SpicyTenderloin/believer/AI-context/open-items.md

# Open Items / TBDs

Information gaps still to confirm with the user. Resolved items (Telem_1 protocol/baud, GPS_1 protocol/port, GX12 role, PDB model, RC channel/switch map) have been moved into `docs/engineering/ICD.md`, `docs/operations/manual.md`, and `docs/operations/backups/Pixhawk Parameter Backup/parameter-change-log.md`.

- [ ] GPS: RTK correction source for the ZED-F9P (base station? NTRIP?) still undecided. `SENS_GPS_MASK`'s exact bit semantics were not separately verified against the PX4 documentation before NAV-05 was closed (both receivers achieving lock was accepted as sufficient) - worth a closer look if GPS blending behaviour ever looks off in practice
- [ ] I2C airspeed sensor (MS4525DO): pull-up resistor configuration not confirmed (port - Pixhawk 6X I2C, JST-GH 4-pin - and address 0x28 are confirmed in `docs/engineering/ICD.md` INT-07)
- [ ] `BAT_LOW_THR` on the physical FC: temporarily lowered to 12% for bench testing on 2026-08-19; Julian confirmed it should be reset to 20% but had not yet done so on the physical flight controller at the time of this update (the archived backup and docs already reflect the intended 20% value) - verify the live FC matches before the next flight
- [ ] `MAV_1_MODE` changed from 3 (OSD) to 0 (Normal) (2026-07-06); the `BATTERY_STATUS` 10Hz override in `/fs/microsd/etc/extras.txt` was tuned against OSD mode's 0.5Hz default and has not been re-verified under Normal mode
- [ ] CH12 (SH switch, mixed in the GX12 radio): reserved for a future buzzer or payload function, but which one - and its eventual `RC_MAP_*` parameter - is not yet decided
- [ ] Camera mounting subsystem (IMX335): companion computer model, exact belly mounting location, observation angle, and environmental operating range not yet defined - see `docs/engineering/requirements/underslung-camera-mount-requirements.md`
- [ ] Recurring airworthiness verification checks (propeller nuts, hatch/nacelle/bolt torque, antenna security) in `docs/engineering/build-checklist.md` have no dated inspection record - establish a way to log a dated verification pass (e.g. a per-flight log or a new `docs/engineering/test-reports/` entry) and backfill "Last verified" / "Evidence"
- [ ] Custom power distribution board (`docs/engineering/requirements/power-distribution-board-requirements.md`): firm max size/weight envelope, decoupling capacitor sizing (now that the ESC model is known - T-Motor AIR 40A - but detailed switching/ripple specs are not yet captured), current-sense range, ESC input connector type, and environmental operating range are all open - see that document's Section 5
- [ ] Launch dolly (`docs/engineering/requirements/launch-dolly-requirements.md`, wing-saddle concept): wing incidence relative to the fuselage datum (sets lift-off speed and tail-support height), final tail-support height and pad shape (estimated 142 mm above the rail top at the rear axle station), belly profile at the tail support, target AoA during the tail rise (sets lift-off speed: about 12.4 m/s at 5 deg, 16 m/s at 2 deg), rail spacing and front outrigger geometry to confirm in Fusion, propeller clearance to the trays and ramps (about 44 mm on the drawing's prop position, 75 mm wanted), separation-path clearance, and the exact bump/unevenness spec for the grass-runway requirement are open - see that document's Section 6
- [ ] Custom airframe (`docs/engineering/requirements/custom-airframe-requirements.md`): construction material/method, fabrication path, gimbal axis count, FPV mount angle, camera pod size/mass range, payload mass budget, and catapult launch system type/hard-point/load rating/release mechanism are all open - see that document's Section 5 (RF/EMI separation was researched 2026-08-20 and resolved to a qualitative "maximum practical separation" requirement, no numeric target exists in PX4/ArduPilot documentation)
- [ ] DBR4 antenna orthogonal mounting and RTV securing - relocation is complete, but the antennas are not yet mounted orthogonally or secured with silicone RTV; not a maiden-flight blocker - see `docs/engineering/build-checklist.md` RF-05
- [ ] Servo rail load test under oscilloscope, to confirm the new UBEC holds voltage under full control-surface load; not a maiden-flight blocker - see `docs/engineering/build-checklist.md` PWR-03
- [ ] Purchase history AUD conversion for the SparkFun ZED-F9P and Holybro PM06 invoices (`docs/governance/purchase-history/purchase-history.md`, 2026-03-09/10): both were paid in USD, but the exact daily/card-charged AUD amount could not be confirmed via web research (search tools returned only month-range data for March 2026, ~1.42-1.46 AUD/USD). Converted at an approximate 1.44 AUD/USD - Julian could confirm the precise figure from the actual card statement if needed for the funding report
- [ ] Whether to use the Weishäupl et al. 2024 wind-tunnel-measured drag polar (CD0/K/CL0/CLα) directly for Believer performance estimation, instead of or alongside the MotoCalc/generic-E374 approach - see `AI-context/project-notes.md` and `docs/engineering/build-checklist.md` PROP-05
- [ ] Full-Manual stick-to-surface scaling formal verification (CTL-08, reopened 2026-09-02): informal bench comparison suggested early saturation is Acro-specific and does not occur in Manual mode, but the formal logged test (propellers off, roll/pitch/yaw tested separately, stick%/PWM/deflection recorded at several points per axis) has not yet been run - Julian to perform
- [ ] Whether aileron differential or a non-zero `FW_RLL_TO_YAW_FF` (roll-to-yaw feedforward) is needed remains open, pending flight-test evidence of adverse yaw - see CTL-07 (deferred until CTL-06/CTL-08 complete; evidence to be gathered during CTL-02 test flights)
- [ ] Bench full-throttle testing intermittently triggers a false PX4 landing-detection auto-disarm (2 of 5 runs, 2026-09-02) - root-caused, not a power fault (see `docs/engineering/test-reports/2026-09-02-bench-thrust-test-review.md`). `COM_DISARM_LAND` reported set to -1 (auto-disarm on landing disabled) for bench testing on 2026-09-26, previously 2.0s - **confirmed -1 via a direct QGroundControl parameter export, 2026-10-02**. **Decision 2026-09-26 (Julian): keep -1 for the maiden flight.** The bench cutouts happened with the aircraft held still at high throttle, which resembles the pre-throw phase of the assisted hand launch, so leaving auto-disarm enabled may cut the motors in the handler's hands or on release. The pre-flight checklist now checks the value (`docs/operations/manual.md` step 23) and new landing steps require a manual disarm with CH5 (steps 51-53). Revisit after the maiden flight
- [ ] Custom Li-ion battery (6S4P, 24 NCR20700A cells, no BMS, fitted 2026-09-26; `docs/engineering/test-reports/2026-09-26-custom-li-ion-battery.md`): capacity test not completed (attempted 2026-09-26 but the run ended at 4.2 Ah discharged when the left motor failed; repeat after PROP-11 - the charger cannot exceed 4.15V per cell, so expect a result below the datasheet's 12.4 Ah rated); pack mass not recorded (the cells alone weigh up to 1.44 kg by datasheet; the aircraft all-up weight is recorded, 3.8 kg on 2026-09-26); numeric CG not recorded; cell purchase details (cost, funder, date) not in `docs/governance/purchase-history/purchase-history.md`; status of the Turnigy 8000mAh LiPo (spare or retired) not confirmed; cell authenticity not verified
- [ ] Custom Li-ion battery, cell group 2 measures 4.6 mOhm against 2.9 to 3.6 mOhm for the others (about 40% above their mean, roughly what one non-contributing cell in a 4-cell group would read) - check the weld or strip and re-measure at rest; log per-group voltages through the capacity test
- [ ] Custom Li-ion battery has no BMS, so nothing protects it from over-discharge and PX4 sees only total pack voltage: the in-flight voltage limit and how it is checked before flight are undecided. The cell datasheet's discharge end voltage is 2.5V per cell (15.0V on the pack); a conservative landing limit of about 3.3V per cell under load (about 19.8V) was suggested, not adopted
- [ ] PX4 battery estimation for the Li-ion pack: `BAT1_CAPACITY` is -1 (unset), `BAT1_V_CHARGED` 4.05V/cell is also PX4's recommended Li-ion value, `BAT1_V_EMPTY` 3.6V/cell is a LiPo-style default (PX4's Li-ion suggestions are 3.0V conservative no-load and 2.7V under load), and the low/critical/emergency thresholds are derived from that voltage-based estimate. A Li-ion pack discharges over a different voltage range, so the reported remaining charge may trigger earlier than the real charge warrants - likely conservative, but unverified. `BAT1_R_INTERNAL` (-1, real-time estimate) is a per-cell value in PX4; the charger-measured mean is about 3.5 mOhm per series group (PX4 documents about 5 mOhm per cell as typical). `COM_ARM_BAT_MIN` is also -1 (no arm-time minimum charge check) - deliberately deferred as part of PWR-04's closure (2026-10-02) until the capacity test completes
- [ ] **Proposed parameter changes (2026-09-26) - status from the parameters recorded in the 2026-09-26 flight logs; a parameter export is still to be provided.** Applied: `WEIGHT_BASE` and `WEIGHT_GROSS` = 3.8; `BAT1_V_EMPTY` = 3.2 (about 3.3 was proposed); `COM_DISARM_LAND` = -1. **Superseded, 2026-10-02:** `PWM_MAIN_MAX4`/`MAX6` and `WEIGHT_BASE`/`WEIGHT_GROSS` have since moved again following the U5 KV400 motor swap (PROP-11) - now 2000 and 4.0 respectively, confirmed via the 2026-10-02 ground-test log (`docs/engineering/test-reports/2026-10-02-u5-first-ground-test.md`, PROP-08) - so the "3.8"/"1800" figures below are historical, not current. **Applied, 2026-10-02 (PWR-04):** `COM_LOW_BAT_ACT` = 3, confirmed via a direct QGroundControl parameter export. **Not applied:** `BAT1_CAPACITY` still -1 (set it from the measured capacity once a capacity test completes, not from the datasheet, as cell authenticity is unverified). Leave unchanged: `BAT1_V_CHARGED` (4.05, which PX4's docs recommend for Li-ion - an earlier 4.10 proposal was withdrawn 2026-09-26), `BAT1_R_INTERNAL` (-1, PX4's adaptive real-time estimate - revisit only if logs from the new pack show the remaining-charge estimate dipping at throttle-up or failing to settle, in which case the charger-measured mean is about 0.0035 ohm per cell), the 20%/10%/5% thresholds, `FW_AIRSPD_STALL`/`MIN`/`TRIM`/`MAX` (their basis is the Weishaupl paper, which does not state the mass of its stall test, so they are conservative for a 3.8 kg aircraft until stall is measured in flight), and `FW_THR_TRIM`
- [ ] Propeller: `docs/engineering/ICD.md` now correctly lists the 12x6E as fitted (corrected 2026-10-12, Rev 2.13 - it had still shown the 11x7" Hobbyrama). `AI-context/project-notes.md`'s equivalent mentions are historical/decision-log entries, correctly left as-is per the append-only convention. **Ground clearance is still unchecked**: the 2026-07-05 BNEMAC review recorded 150mm motor-shaft-to-ground clearance with an 11" prop "barely clearing" - a 12" prop has a 152.4mm radius, more than that, on a belly-landing airframe. This is a real physical check, not a documentation issue, and remains unresolved
- [ ] Thrust-stand test details not recorded: the ESC used on the stand and whether the supply was a battery or a bench supply (`docs/engineering/test-reports/2026-09-15-mn3110-thrust-stand-characterisation.md` lists both as TBD)
- [ ] Left motor failed during a bench simulated flight on 2026-09-26 (`docs/engineering/test-reports/2026-09-26-bench-simulated-flight-motor-failure.md`): cause undetermined - the flight controller logs show no sustained overcurrent (about 6 s above 21 A per motor if the two shared equally) but a fault signature (current rising at a fixed command, a 102.9 A sample, then 2 to 6 times the expected current when driven). The drive should not be powered again until the left motor, the left ESC (the spike exceeds its 60 A 10 s rating), the right motor and ESC, the power distribution board, and the wiring are inspected. The left motor also melted its 3D-printed PETG mount (per Julian; PETG typically softens at roughly 70 to 80 degrees C), and the ESCs are enclosed in the wing with no airflow (timing setting unknown), so an ESC failure is as plausible as a motor fault and ESC cooling is open as well (Julian regards the melted PETG mount as a consequence of the failure, not a cause); the right-hand side appears fine. Replacement motor choice (like-for-like MN3110 KV700 or a different motor) is open - tracked as PROP-11
- [ ] Whether the T-Motor MN3510 KV700 can be run on this 6S pack with the 12x6" propeller: T-Motor's store page and datasheet list it for 3-4S only (the KV360 is the only MN3510 variant listed 3-6S, rated 15 A / 330 W), recommend low-pitch propellers (11x3.7, 12x4, 13x4.4 CF) and an AIR 20A 3-4S ESC, and state no maximum voltage. No user reports of 6S use were found. Julian to confirm with T-Motor before choosing it (PROP-11); the installed MN3110 KV700 is listed 3-6S
- [ ] Motor and ESC install dates: Julian gave the motor install date as roughly 2026-07-24 (2026-09-27), and the flight logs bracket it between 2026-07-10 and 2026-07-26. The ESC install date is not separately confirmed - the notes, ICD and build checklist give 2026-08-19, which was the date the change was reported
- [ ] The "2026-08-31 brief full-throttle test" (60 to 65 A total; PROP-02 and PROP-08 background, battery report): the SD card logs show 65.0 A on 2026-08-18 and 65.9 A on 2026-09-02 but nothing above 0.5 A on 2026-08-31. Julian to confirm which test was meant and correct the date if it was 2026-08-18
- [ ] Which motor (left or right) was on the RCbenchmark stand for the 2026-09-06 to 2026-09-15 tests: the 31.7 s above 21 A on the stand counts against that motor only (lifetime tally in the failure report)
- [ ] Thrust stand returned (Julian, 2026-09-27): the 180 s ceiling test with motor temperature (PROP-11) and any thrust measurement of a replacement or alternative motor (MN3110, U5 KV400, KDE3510XF-475) now needs a restrained in-aircraft test (logged pack current, spring scale for total thrust, thermocouple or IR temperature) or another stand. The stand data for the MN3110 with the 11x7" and 12x6" is in `docs/engineering/test-reports/2026-09-15-mn3110-thrust-stand-characterisation.md`. Update 2026-09-28: Julian has arranged to borrow the stand again to bench test the U5 KV400 with the 12x6". **Done, 2026-09-30**: two sweeps recorded, thrust 1.84 to 1.94 kgf at 14.0 to 14.7 A at full throttle, no cutout (actual full-throttle power was about 325 to 350 W, well under the roughly 500 W that had cut out the MN3110). The RPM channel was usable above about 1560 us, as with the MN3110. Not recorded: motor/ESC temperature (informal hand-touch check only - room temperature after full throttle), sustained duration at one throttle level (a fourth, extended slow-ramp run confirms the calibration with more data but is still not a fixed-throttle hold), exact propeller brand. ESC used was the right-hand MN3110's (not the suspect left ESC) - Julian plans to test that ESC directly next. Still wanted: a sustained run at the chosen ceiling for at least 180 s with temperature logged
- [ ] Weigh the planned payload (Raspberry Pi 4 with heatsink and fan, IMX335 USB camera, DJI O3 Air Unit, 5 V regulator, wiring, mounts) to replace the rough 190 g estimate; design mass is then 3.8 kg plus the payload plus about 200 g headroom (about 4.2 kg on the estimate). The payload is to be added after the maiden flight; the motor decision should account for the design mass, not only the 3.8 kg maiden mass (`AI-context/project-notes.md`, 2026-09-27)
- [ ] T-Motor U5 KV400 motors (with the AIR 40A ESCs) are installed in the aircraft in place of the MN3110s (PROP-11, closed 2026-09-30) and confirmed working in a ground test, 2026-10-02 (`docs/engineering/test-reports/2026-10-02-u5-first-ground-test.md`): full throttle 29.4 to 30.9A total, well under rating, no fault. `WEIGHT_BASE`/`WEIGHT_GROSS` updated to 4.0 and confirmed from that log (matches the calculated +190g estimate rounded to the nearest 0.1kg; whether Julian used that figure or weighed the installed pair is not confirmed). Still open: Julian decided not to formally pursue the instrumented temperature log or the electrical condition checks (insulation to the case, winding-resistance balance) beyond the stand testing already done; the right motor and its ESC were not stand tested; and there is no sustained in-aircraft or flight measurement yet
- [ ] Winding resistance and insulation testing needs proper equipment: a multimeter read 24 to 25 ohms phase-to-phase on both motors (2026-09-27), about 260x the 92 mOhm datasheet figure and not a valid measurement (see the failure report). A four-wire milliohm meter and an insulation resistance tester (megohmmeter, phase to case) are needed to actually check the motors. Julian has no access to either. Near-term alternatives: a phase-to-case check with the multimeter on its highest resistance range (catches a gross breakdown), and a no-load current comparison per motor and ESC (propeller off, motor secured, low fixed throttle steps, aircraft current sensor, inline blade fuse), or borrowing the instruments from a QUT electrical or mechatronics workshop
- [ ] Validate the powertrain performance model against a restrained in-aircraft test (thrust by scale, logged pack current, temperature) and later flight logs: it is calibrated on static stand data only and to about 33 A winding current (`docs/engineering/analysis/powertrain-performance-model.md`)
- [ ] Confirm the brand of the 12x6E stand propeller (marking on the hub or blade): the 2026-09-06 invoice lists a Gemfan nylon "APC" propeller, which may be a copy of the APC pattern, so APC's tables used in the powertrain model may not describe it exactly (`docs/engineering/analysis/powertrain-performance-model.md`)
- [ ] Maiden flight (2026-10-11): `airspeed_validated` was invalid for almost the entire flight (only 2.9% of samples physically plausible). **Not a hardware fault** - the raw differential-pressure sensor itself read physically sane airspeeds (13-24 m/s, no negative/zero/stuck readings) for the whole flight when checked directly; PX4's validator tripped once at t=49.0s (likely the `check_load_factor()` check, during the high-G pull-up recovering from the launch sag) and then never re-validated it because `ASPD_FS_T_START` was at PX4's -1 (disabled) default. Fixed by setting `ASPD_FS_T_START` = 2s (see `docs/operations/backups/Pixhawk Parameter Backup/parameter-change-log.md`) - **decided, not yet applied to the physical FC**, apply before the next flight. See `docs/engineering/test-reports/2026-10-11-maiden-flight.md`
- [ ] `FW_AIRSPD_STALL` (configured 11 m/s) vs. the maiden flight's measured stall speed (8.15-9.95 m/s across three trials, Phase G): decided not to update yet, per Julian - three trials at 1Hz sampling is thin data to retune a parameter that other logic (loiter radius, bank-angle margins) is already built around. Worth noting this isn't simply "more margin is safer" either way: the parameter also feeds the airspeed validator's `check_load_factor()` plausibility check, the same check implicated in the t=49s validator trip above - an inflated stall figure may make that check more trigger-happy, not less, since it believes less margin exists than actually does. Revisit once more flights give a larger sample
- [ ] Maiden flight (2026-10-11): Phase J (Return to Home, CH10) was not deliberately exercised - no `AUTO_RTL` transition appears anywhere in the flight log. Test on a future flight. See `docs/engineering/test-reports/2026-10-11-maiden-flight.md`
- [ ] Maiden flight (2026-10-11): the RFD900x GCS telemetry link dropped out 18 times over the 24.8-minute flight (about 10% of the flight), three exceeding the 10s data-link-loss timeout (39.8s, 27.9s, 17.0s) - investigated from the flight log and, now, the recovered GCS `.tlog` (`docs/engineering/test-reports/2026-10-11-maiden-flight.md`): not range, antenna aspect or bank angle, and RSSI at the aircraft stayed strong. The `.tlog` showed the 39.8s and 27.9s outages were uplink-only (downlink unaffected) while the 17.0s outage was symmetric (both directions down) - so probably not one single cause - but the root cause itself is still not identified, and the `.tlog` carried no `RADIO_STATUS` data to check the ground modem's own RSSI/noise. Still needed: an `ATI5` dump of the air-side RFD900x (only the ground modem is backed up), and a stationary bench test with the ELRS receiver on and off. This is why `NAV_DLL_ACT` was reverted to 0/Disabled (see `docs/operations/backups/Pixhawk Parameter Backup/parameter-change-log.md`); the underlying link reliability issue itself is still open
- [ ] Maiden flight (2026-10-11): a brief `failsafe_flags.fd_critical_failure` flag (2 samples, first at t=574.1s) and a one-off GPS spoofing warning (t=748.8s) were logged with no apparent consequence - neither root-caused. Revisit if either recurs. See `docs/engineering/test-reports/2026-10-11-maiden-flight.md`
- [ ] Maiden flight (2026-10-11): the hand-launch from a hill was marginal - needed all the available elevation to gain flying speed, "very touch and go." **Decision (Julian): switch to a launch dolly for future flights, not hand launches.** See `docs/engineering/requirements/launch-dolly-requirements.md` and `docs/engineering/test-reports/2026-10-11-maiden-flight.md`
- [ ] Maiden flight (2026-10-11): confirmed roll-authority asymmetry (right-roll achieved less than half the rate per unit stick vs. left-roll in Manual/Acro, worse at higher throttle per the pilot) - consistent with both propellers turning the same direction (not contra-rotating), since PX4 is confirmed not using any differential thrust on this airframe. **Decision (Julian): contra-rotating propellers are needed before the next flight.** See `docs/engineering/test-reports/2026-10-11-maiden-flight.md`
- [ ] Per-motor thrust balance cannot be verified in flight - no per-motor current or RPM instrumentation exists; both motors receive identical commands from PX4, but actual output could still differ (now more plausible given the right motor's bearing fault, below). A side-by-side thrust-stand comparison or in-airframe instrumentation would resolve this
- [ ] Right motor has a bad bearing, found during post-flight inspection (2026-10-11) - needs replacing/rectifying before the next flight. Unknown how long it had been degraded or whether it affected the maiden flight's thrust balance
- [ ] Maiden flight (2026-10-11): Stabilized mode felt "less punchy" on throttle to the pilot than Manual/Acro. Confirmed from the log that the throttle signal path itself is identical across all three modes (same linear stick-to-motor-command mapping) - the likely explanation is the attitude controller damping out thrust-coupling disturbance rather than anything throttle-specific, but this is inference, not a separately measured confirmation. See `docs/engineering/test-reports/2026-10-11-maiden-flight.md`
- [ ] The mission was replanned at the field on 2026-10-11 and `docs/operations/backups/Pixhawk Mission Backup/maiden-mission.plan` (and the test plan's Section 5 description - 32 items, 40m altitude, no landing item) are now confirmed stale: the real onboard mission (recovered and validated from the Pixhawk's `dataman` file, see `docs/engineering/test-reports/2026-10-11-maiden-flight.md`) has 28 items, 50m relative altitude, and an actual landing sequence (DO_LAND_START, Loiter-to-Alt, Land). Need a decision on regenerating `maiden-mission.plan` (and the geofence backup, same dataman method) from this validated data and propagating the correction through the test plan and parameter-change-log
- [ ] Maiden flight (2026-10-11): the PX4 EKF wind estimate (2.96 m/s from 066°T, in-flight vector average - see `docs/engineering/test-reports/2026-10-11-maiden-flight.md`) has no site ground-truth to check against. Compared it to Open-Meteo's historical reanalysis for the field's coordinates (1.30 m/s from 016°T at 09:00, gusting 5.20 m/s) - a real discrepancy in both speed and direction, only partly explained (grid point ~5.2km from the field, 10m reference height vs. flight altitude, hourly resolution). This is a regional model estimate, not a measurement, so it doesn't settle the question either way. Still worth a real ground-truth reading: bring a handheld anemometer to the next flight, or check whether BNEMAC/any club member logs site conditions
