SpicyTenderloin/believer/AI-context/project-notes.md

# Believer Project Notes

Facts established so far, sourced from `Believer Checklist.docx`, `Believer Project Proposal.docx`, `QUTAS Fixed Wing Drone Funding Application SIGNED.docx`, `Shopping List 27_02_26.xlsx`, and `believer_PX4_Parameter_Change_Log.xlsx`.

## Project Background
- **Believer Long Range Observation Fixed Wing Drone** - QUT Aerospace Society (QUTAS) project.
- Purpose: BVLOS observation platform for remote sensing applications; a specific mission has not yet been selected. Onboard object detection planned.
- Team: Julian Williams (UAS Systems Lead / Program Manager), Charlotte Kelly (Vice-President / President). Contact: qutaerospacesociety@qut.edu.au.
- External contacts established: QUT Chief Remote Pilot, Brisbane North Model Aero Club (BNEMAC), CSIRO.
- Funding: EER School club activity funding, $689.50 requested (50% of $1,379 total), matched by QUTAS account funds. Signed 2026-05-20/21.
- **Build history**: The airframe was built prior to 2020 (original builder unknown) with motors, servos, and ESCs installed. The project was inherited by Julian Williams and revived in December 2025. All avionics and the current flight controller (Pixhawk 6X / PX4) were installed as part of the revived project.

## Airframe
- Believer fixed-wing UAV: V-tail, twin motor (left/right), 2 ailerons.
- Centre of Gravity: 15mm aft of the centerline of the carbon rod front wing spar, ~25% MAC.
- Belly has two landing pads either side of the centreline; the airframe manufacturer's documentation designates the centreline location between them as the intended camera mount position (per Julian, 2026-07-06). See `docs/engineering/requirements/underslung-camera-mount-requirements.md` REQ-CAM-10.
- Manufacturer specs (en.makeflyeasy.com, retrieved 2026-07-06 - no PDF datasheet available for this airframe): wingspan 1960mm, fuselage length 1070mm, fuselage height 185mm, wing area 51dm², max take-off weight 5.5kg, payload capacity ~670g (manufacturer demonstrates compatibility with a Sony A7RM2 camera), load compartment 120x150x119mm, battery compartment 260x140x105mm (separate from load compartment). Recommended flight speed 20m/s, range ~90km under specified conditions. The manufacturer page did not mention landing gear/pad details or an explicit camera mount position in the text extracted; the "load compartment" has since been confirmed (Julian, 2026-07-06) to be the same bay as the landing-pad-flanked centreline location above.
- The 3mm belly recess depth for the camera mount (REQ-CAM-13) has been confirmed sufficient for the grass/dirt landing surface (Julian, 2026-07-06).

## Flight Controller - history
- **Original build** (per Jan 2026 proposal): ArduPlane on a Matek F405-Wing FC, u-blox NEO-7 GPS, RFD900 telemetry pair, RC control via QGroundControl joystick passthrough (no dedicated RC link at that time).
- **Current build**: upgraded to a **Holybro Pixhawk 6X running PX4** (confirmed by user 2026-06-21; firmware also indicated by the QGroundControl "Actuators Config" UI - PWM MAIN/AUX/UAVCAN tabs are PX4-specific - and by the filename `believer_PX4_Parameter_Change_Log.xlsx`). No PDF datasheet exists in `Component datasheets/` - Holybro documents the 6X entirely as a web-based site (docs.holybro.com), not a downloadable PDF (checked 2026-07-17, confirmed with the user).
- Servo rail is electrically isolated from the main Pixhawk power supply; requires an independent 5V feed from the power distribution board.
- `SENS_BOARD_ROT` = Yaw 180° (corrects FC orientation relative to airframe).

## Actuator / PWM Mapping (confirmed, cross-checked against QGC screenshot)
| Control Input | I/O PWM OUT | Min | Max | Disarmed | Trim | Reversed |
|---|---|---|---|---|---|---|
| V-Tail Left | MAIN 1 | 1100 | 1900 | 1500 | 1500 | Yes |
| V-Tail Right | MAIN 2 | 1100 | 1900 | 1500 | 1500 | No |
| Left Aileron | MAIN 3 | 1100 | 1900 | 1500 | 1500 | Yes |
| Left Motor | MAIN 4 | 1000 | 2000 | 1000 | 1000 | No |
| Right Aileron | MAIN 5 | 1100 | 1900 | 1500 | 1500 | No |
| Right Motor | MAIN 6 | 1000 | 2000 | 1000 | 1000 | No |

## Motors and Servos - confirmed 2026-07-02

- **Motors**: installed approximately 2026-07-24 (Julian, 2026-09-27; the 2026-08-19 date first recorded here was when the change was reported - see the 2026-09-27 section below): 2x T-Motor MN3110 KV700 (MAIN 4 = left, MAIN 6 = right), replacing the T-Motor U5 v2.0 KV400 units. Purchased 2026-07-06 (Julian personal funds, $169.87 AUD, T-MOTOR Official Store via Alibaba.com). Datasheet: `Component datasheets/tmotor-mn3110-kv700-motor-datasheet.pdf` (covers the KV470/700/780 family). The former U5 v2.0 KV400 motors have been removed; their load-test report remains at `Component datasheets/tmotor-u5-kv400-motor-test-report.pdf` for historical reference.
- **ESCs**: reported installed 2026-08-19 (the physical install date is not separately confirmed - see the 2026-09-27 section below): 2x T-Motor AIR 40A (one per motor), replacing the previously-fitted, unidentified-model ESCs. Sourced from existing QUTAS-owned component stock (2026-07-17, not purchased for this project) - 40A continuous / 60A (10s) peak, 2-6S, 26g, 68 x 25 x 8.7mm, no BEC, analog PWM/OneShot-style signal up to 621Hz (DShot support not confirmed). Calibrated so both motors start simultaneously on throttle-up, resolving the previously-observed motor start desynchronisation. Manual: `Component datasheets/tmotor-air-40a-esc-manual.pdf`.
- **Full-throttle current draw**: a brief (<20s) full-throttle bench test (2026-08-31, Julian) had the PDB reporting 60-65A total current draw - approximately 30-32.5A per motor assuming an even split. This exceeds the MN3110 KV700's own rated max continuous current (21A, a 180s rating) by roughly 45-55%, though it is comfortably within the AIR 40A ESC's 40A continuous rating and the battery's capability. A brief burst at this level is not itself a concern, but sustained full-throttle thermal behaviour has not been verified - added as an explicit acceptance criterion to PROP-02 (`docs/project/build-checklist.md`) rather than assuming the brief test is conclusive.
- **Propellers**: the existing 2x Hobbyrama 11x7" Electric Propeller (LP11X7E, purchased 2026-07-04) were carried over to the MN3110 install rather than fitting the 9x6" Gemfan standard/pusher pair purchased 2026-07-14 (which was sized via MotoCalc specifically for contra-rotation on the new motors, but is not installed). Both Hobbyrama props are the same handedness and both motors were confirmed 2026-08-19 to rotate clockwise (viewed from the body reference plane) - not contra-rotating. Confirmed by Julian this is not a problem and contra-rotation is not required for the maiden flight; the previously-open reverse-pitch propeller item is resolved on this basis (superseding the earlier "interim measure, to be reversed" framing from the 2026-07-05 BNEMAC follow-up).
- **Aileron servos**: Hitec HS-5125MG, one per wing (MAIN 3 = left, MAIN 5 = right). Digital, metal gear, 10mm slim wing profile, 24g, 4.8-6.0V, 3.0-3.5 kg.cm torque, 0.17-0.13 sec/60°. An official Hitec-hosted PDF datasheet exists (hiteccs.hitecrcd.com) but could not be downloaded (2026-07-17 - TLS handshake failure against that host); specs remain sourced from the Hitec RCD product page only.
- **V-tail servos**: Emax ES3054, one per V-tail surface (MAIN 1 = left, MAIN 2 = right). Digital, metal gear, 17g, 4.8-6.0V, 3.0-3.5 kg.cm torque, 0.15-0.13 sec/60°, 23T spline. No official PDF datasheet found (checked 2026-07-17) - specs from Emax product page only.

## Serial / Sensor Interfaces (updated with parameter log)
- **Telem_1** (`RC_PORT_CONFIG = TELEM1`): Radiomaster DBR4 dual-band (2.4GHz/900MHz) Gemini Xrossband ExpressLRS receiver. Baud `SER_TEL1_BAUD = 460800 8N1`. Paired transmitter: Radiomaster GX12 **Crush** (Gemini-X dual-band ExpressLRS), Iron Grey colorway - confirmed by user 2026-06-22, correcting the earlier (2026-06-21) note that it was not the Crush variant.
- **Telem_2** (`MAV_0_CONFIG = TELEM2`): RFD900(x) long-range telemetry radio. Baud `SER_TEL2_BAUD = 57600 8N1`. MAVLink rate `MAV_0_RATE = 3000 B/s`, flow control disabled. Pinout: Black=GND, Brown=Vcc(5V), Yellow=Rx→FC TX1, Red=Tx→FC RX1.
- **GPS_1** (`GPS_1_CONFIG = GPS 1`, `GPS_1_PROTOCOL = u-blox`): M8N GPS - **primary GPS at this stage**, connected to the Pixhawk's GPS 1 UART port. `GPS_1_GNSS = 0` (Default constellation mask - corrected 2026-08-28; previously documented as 21, which never matched the live exported parameters). `GPS_UBX_DYNMODEL = Airborne <4g`.
- **GPS_2** (`GPS_2_GNSS = 29`): SparkFun GPS-RTK-SMA Breakout - ZED-F9P, connected to the Pixhawk's GPS 2 UART port. External mount and antenna installed 2026-08-28 (`docs/project/build-checklist.md` NAV-03/NAV-04). RTK correction source still TBD; `GPS_2_CONFIG` remains disabled pending protocol/GNSS configuration and GPS lock confirmation (NAV-05). Decided 2026-08-28: GPS 1 (M8N) and GPS 2 (ZED-F9P) will be blended (weighted by reported accuracy, via `SENS_GPS_MASK`) rather than one being designated a fixed "primary" - PX4 doesn't have a simple primary-GPS toggle in this version. The ZED-F9P is expected to dominate the blend once enabled, more so with RTK corrections, while the M8N remains an automatic fallback.
- **I2C**: MS4525DO airspeed sensor - connected to the Pixhawk 6X I2C port (JST-GH 4-pin: VCC, SCL, SDA, GND). I2C address 0x28 (default). Driver enabled (`SENS_EN_MS4525DO`), external I2C probing enabled (`SENS_EXT_I2C_PRB = 1`).
- **Power**: `SENS_EN_INA228` enabled - power monitor reading on the Holybro PM03D power module (see Power below). `BAT1_N_CELLS` = 6S.
- **RC switches** (updated 2026-06-21 - see `docs/operations/Pixhawk Parameter Backup/parameter-change-log.md` for the remap history): `RC_MAP_ARM_SW` = Channel 5, `RC_MAP_KILL_SW` = Channel 7. GR1 (6-position flight-mode switch) on Channel 6. Full channel map and GR1→PX4 mode mapping documented in `docs/engineering/ICD.md` (INT-03) and `docs/operations/manual.md`.
- **Radio Master GX12**: RC transmitter (not a module/receiver) - Gemini-X dual-band (2.4GHz + 900MHz) ExpressLRS, pairs with the DBR4 receiver above. Configured in ELRS Hybrid switch mode with MAVLink enabled.
- **GX12 EdgeTX backup added** (2026-06-22, `docs/operations/GX12 Radio Backup/`): full SD card image, model named "Believer". Cross-checked `docs/operations/GX12 Radio Backup/MODELS/model00.yml` mixer data against the documented RC channel map - confirms CH5=SD(arm), CH6=GR1, CH7=SF(kill, inverted), CH8=SA(loiter), CH9=SB(flaperon, inverted), CH10=SC(return, inverted), CH11=SE(offboard, inverted). CH12 carries the SH toggle switch via the radio mixer, but a QGroundControl Flight Modes Config screenshot (`docs/assets/flight-modes-config.png`) and `docs/operations/Pixhawk Parameter Backup/believer-parameters.params` (full PX4 parameter backup, also added 2026-06-22) both confirm no `RC_MAP_*_SW` parameter currently reads channel 12 - consistent with the existing "future buzzer or payload" placeholder in `docs/operations/Pixhawk Parameter Backup/parameter-change-log.md`.

## Power - confirmed
- Power module fitted: **Holybro PM03D** (invoice 2026-05-11, purchased with Julian's personal funds, not club funds). Installed and providing battery voltage/current telemetry (INA228 - datasheet `Component datasheets/ina228-datasheet.pdf`) and 5V power to the servo rail.
- Servo rail (and all other BEC-derived outputs on the PM03D) confirmed limited to 3A by the manufacturer datasheet (`Component datasheets/holybro-pm03d-manual.pdf`) - independently corroborated by Peter Spink (TMAC) as insufficient for the servo load. A separate ZTW UBEC 10A was installed 2026-08-19 (Julian personal funds, $43.49 AUD, Amazon.com.au) to feed the servo rail; the PM03D no longer supplies it. Confirmed functional; a servo-load test under an oscilloscope is a separate, non-blocking follow-up (`docs/project/build-checklist.md` PWR-03).
- Two other power modules were purchased/shortlisted but are **not** the unit in use:
  - MATEKSYS PDB FCHUB-12S V2 (invoice confirmed, 2026-05-10, per the original funding application budget) - not used.
  - Holybro PM06 V2 (per shopping list) - not used because its power telemetry format is not accepted by the Pixhawk.

## Battery - confirmed
Fitted pack: **Turnigy Graphene Professional 8000mAh 6S 15C LiPo Pack** (~$93.23, per shopping list). The 2200mAh 6S 60C LiPo in the funding application budget was an earlier estimate and was not purchased. **Superseded 2026-09-26**: the flight battery is now a custom 6S4P Li-ion pack - see "Airframe Closures, Custom Li-ion Battery, and Thrust Stand Characterisation - 2026-09-26" below.

## Future / Planned Capability (not yet wired into FC)
- IMX335 5MP USB camera - for onboard decision-making / pilot video feed (companion computer phase). Specs (Waveshare IMX335 5MP USB Camera (B), the specific unit purchased): 5MP, 2592x1944, 175° FOV, f/2.0, 3.65mm EFL, <-36% distortion, fixed-focus, 25.00x24.00mm board, 23.50x19.50x36.94mm lens, USB 2.0, 5V +/-5%. Operating temperature conflicts between sources: user-supplied figure from the Waveshare wiki page reads 10°C to 60°C; an independent web search of the same product returned -10°C to 60°C. Not reconciled - the wiki page itself returned HTTP 403 to automated fetch. See `docs/engineering/requirements/underslung-camera-mount-requirements.md` Section 3a.
- Companion computer for autonomy - longer-term roadmap item.
- Secondary control link via ExpressLRS already implemented (DBR4/GX12) - this was the proposal's near-term roadmap item, now done.

## BNEMAC Review - 2026-07-05

Julian met with the Brisbane Northside Electric Model Aero Club (BNEMAC); feedback from Ross:
- Current T-Motor U5 v2.0 KV400 motors do not produce adequate thrust - recommended replacement with a higher-KV motor (Julian, 2026-09-27: at this visit the ESCs were not configured properly and one propeller was mounted backwards, so this finding is unreliable as evidence about the U5s - see the 2026-09-27 section on BNEMAC visit conditions). Propeller diameter is constrained to 11" by 150mm motor-shaft-to-ground clearance (no landing gear fitted) - an 11" prop barely clears. A folding propeller was confirmed not required.
- Ruddervator (V-tail) direction found to be inverted.
- Recommended calibrating the aileron and V-tail servos via PWM tuning to obtain maximum available travel.
- One motor observed starting before the other on throttle-up - cause not yet isolated (ESC configuration vs. PX4 PWM min/max range); may resolve once the motors/ESCs are replaced.
- Stabilize flight mode behaved differently than expected during ground testing.

All items above are tracked as tasks in `docs/project/build-checklist.md`.

## Telemetry Rate Tuning - 2026-07-05

Investigated slow-updating telemetry (battery current/capacity, in particular) on both the DBR4/ELRS link (TELEM1) and the RFD900x link (TELEM2):
- ELRS packet rate set to 100Hz Full on the GX12/DBR4 pair.
- `mavlink status`/`mavlink status streams` (via QGC MAVLink Console) identified the two MAVLink instances: MAV_0 (TELEM2/RFD900x, device `/dev/ttyS4`, mode Normal) and MAV_1 (TELEM1/DBR4, device `/dev/ttyS6`, mode OSD).
- MAV_0 was bandwidth-starved (`MAV_0_RATE` found live at 1200 B/s, throttling every message to ~39% of its configured rate) despite `docs/engineering/ICD.md` already documenting 3000 B/s - the live parameter had reverted or been changed without the docs being updated. Reset to 3000 B/s to match.
- MAV_1 was not bandwidth-starved (only ~12% of its 9600 B/s budget in use) but `BATTERY_STATUS` was hard-set to 0.5Hz by the OSD mode default; raised `MAV_1_RATE` to 19200 B/s for headroom and overrode `BATTERY_STATUS` specifically.
- Per-message rate overrides added via `mavlink stream -d <device> -s BATTERY_STATUS -r <hz>`: 5Hz on MAV_0 (`/dev/ttyS4`), 10Hz on MAV_1 (`/dev/ttyS6`).
- To persist across reboots, these commands must go in `/fs/microsd/etc/extras.txt` (not the SD card root - PX4 does not source a root-level `extras.txt`). This FC's NuttX shell (console) cannot create new files via `echo >`/`echo >>` redirection - `mkdir` and `mv` work, and appending to an already-existing file with `>>` works, but creating a new file this way does not. The file had to be created on a PC after physically removing the SD card. Watch for missing newlines between appended lines when using `>>` from the console - it does not insert a separator, so lines run together and break parsing at boot.
- `SER_TEL1_BAUD` (DBR4 UART) was left at 460800 - not changed.

## Post-BNEMAC Follow-up - 2026-07-05

- Ruddervator direction reversed and confirmed correct.
- Radio recalibration (see Telemetry Rate Tuning above) may have already increased effective motor RPM - whether the motors are actually thrust-inadequate is no longer settled; a basic thrust-to-weight ground test is planned before deciding on motor/ESC replacement.
- Motors have been temporarily reconfigured to spin the same direction, as an interim measure so that both currently-fitted propellers (same handedness) produce forward thrust. Previously, with the motors outward contra-rotating and both propellers the same handedness, one propeller was running against its designed pitch - plausibly a contributing factor to the original insufficient-thrust observation, independent of motor KV. This will need reversing back on one side once the reverse-pitch propeller is sourced and fitted.

## TMAC Review - Peter Spink - 2026-07-10

Julian met with Peter Spink at the Tingalpa Model Aero Club (TMAC) for a system review and RC tuning session. Full findings and actions in `docs/engineering/test-reports/2026-07-10-tmac-review-peter-spink.md`; summary of what changed:
- PM03D servo rail confirmed limited to 3A (see Power section above) - a separate 5V UBEC is planned.
- Peter introduced MotoCalc for motor/prop performance modelling. Used it to select 9x6" propellers (2 standard, 2 pusher) for the T-MOTOR MN3110 KV700 motors purchased 2026-07-06 - since ordered (2026-07-14, $19.07 AUD combined, Julian personal funds). Julian has reserved trust on Peter's airfoil modelling method, since it's unclear how the aerofoil was characterised. The 9x6" pair supersedes the 11x7" Hobbyrama props for the new motors; how the new motor/prop/ESC combination will actually perform is not yet known.
- CG confirmed out of balance - approximately 350g of ballast needed in the nose. This contradicts the earlier "CG location verified" note against the 2026-07-03 battery installation (`docs/project/build-checklist.md` "Battery installation" row updated to remove that claim).
- No yaw authority found in Stabilized mode.
- Motor start desynchronisation (motors not starting together) attributed to ESC calibration, correctable via QGroundControl - to be done alongside the new motor installation.
- Aileron differential (20mm up / 1.5mm down) and V-tail rudder mix adjusted live during the session; throttle expo removed (was 20%, now 0%). New trim values from this session are still to be provided by Julian - tracked in `context/open-items.md`.

## Propulsion Install, Servo UBEC, Flight Mode Restructure - 2026-08-19

Julian provided a batch of updates via a fresh FC parameter export (`parameters_19_08_2026.params`), a QGroundControl Actuators Config screenshot, and a UBEC invoice, cross-checked against the previous parameter backup by diff:

- **Prearm actuation**: `COM_PREARM_MODE` set to 2 (Always), allowing flight control surfaces to be actuated while disarmed (e.g. from the Actuators page).
- **Flight mode restructure (resolves CTL-01)**: Acro mode added to the GR1 group, replacing the redundant Hold position (Hold and CH8's Loiter override already commanded the same PX4 mode). New GR1 mapping: SW1 Manual, SW2 Acro, SW3 Stabilized, SW4 Altitude, SW5 Position, SW6 Mission. Hold remains reachable via CH8. Julian's reasoning: the direct, high-rate yaw/roll/pitch stick response the team originally expected from Stabilized mode (and found missing during the 2026-07-10 TMAC session) is properly Acro's behaviour, not Stabilized's - Acro was added to provide it, rather than treating the missing yaw authority as a Stabilized-mode bug. Since GR1 physically defaults to SW2 at startup, the default flight mode is now Acro rather than Stabilized - `docs/operations/manual.md` was updated accordingly (Pre-Flight Safety State target and the hand-launch procedure now specify SW3 for Stabilized).
- **MN3110/AIR 40A propulsion install (resolves PROP-01, PROP-03, PROP-04)**: motors and ESCs installed and confirmed working; ESCs calibrated so both motors start simultaneously. Motor PWM min/max set to 1000-2000us on both. A basic bench thrust test showed decent thrust but it's not yet clear whether it's sufficient - kept open as PROP-02, with throttle curve/mapping split out as a separate new task, PROP-06, per Julian's request to track them independently (a throttle curve remap may be needed).
- **Propeller rotation**: both motors confirmed spinning clockwise (viewed from the body reference plane) - the same handedness, not contra-rotating. Julian confirmed this is not a problem and contra-rotation is not required for the maiden flight, resolving the previously-open reverse-pitch propeller item without needing the 9x6" Gemfan pair purchased 2026-07-14 (not installed).
- **Servo rail UBEC (resolves PWR-01)**: ZTW UBEC 10A installed, replacing the PM03D as the servo rail supply. Confirmed functional. Julian requested a follow-up task (non-blocking) to verify servo rail voltage under an oscilloscope while the control surface servos are under load - added as PWR-03.
- **Control surface trim/mixing (resolves CTL-03)**: the previously-missing aileron trim values from the 2026-07-10 TMAC session were entered via the Actuators Config screenshot and confirmed against the parameter export - left aileron mixer trim -0.08, right aileron -0.03. The V-tail yaw mixing gain (`CA_SV_CS2_TRQ_Y`/`CA_SV_CS3_TRQ_Y`) was also raised from 0.50 to 0.85 as part of the same session's rudder mix finalisation.
- **Actuator PWM ranges**: V-tail L/R min raised to 1100us (from 800); left aileron min/max/disarmed set to 1200/1760/1520; right aileron min/disarmed set to 1230/1550 (max unchanged at 1900); both motors set to 1000/2000. All cross-checked against the QGroundControl Actuators Config screenshot.
- **DBR4 relocation (resolves RF-01)**: receiver moved to the rear of the aircraft, away from the main avionics bay. Split from antenna orthogonal mounting, which is not yet done - tracked separately as RF-05 (Urgent, does not block maiden flight; the receiver has plenty of range without it).
- **Clean-install procedure (CTL-05)**: closed per Julian's confirmation - addressed as an ongoing practice (parameter change log, CHANGELOG, and dated parameter/radio backups) rather than a discrete task.
- **BAT_LOW_THR discrepancy**: the supplied parameter export showed `BAT_LOW_THR` at 12% rather than the documented 20%. Julian confirmed this was a deliberate but temporary bench-testing change (to stop low-battery warnings while testing on a partially depleted pack) and asked for it to be corrected back to 20% both on the physical FC and in the archived backup. The backup saved to this repo has been corrected to 20%; the physical FC still needs the same correction applied - tracked in `context/open-items.md`.
- **Routine recalibration**: accelerometer, gyroscope (IMU2 only), barometer, and magnetometer offsets refreshed as part of this export (values in `docs/operations/Pixhawk Parameter Backup/parameter-change-log.md`).

## Airframe Aerodynamic Characterisation - Weishäupl et al. 2024 - 2026-08-31

Julian provided an academic paper - Weishäupl, McLay & Sóbester, "Experimental evaluation of the drag curves of small fixed wing UAVs," *The Aeronautical Journal* 128 (2024), pp. 655-684 - now archived at `docs/engineering/references/weishaupl-et-al-2024-drag-curves-small-fixed-wing-uavs.pdf`. The paper's "FliTePlat" test platform is explicitly built on the MakeFlyEasy airframe (their reference [12], the same manufacturer as the Believer), and its Table 1 geometry matches the Believer's manufacturer specs closely: wingspan 1.96m (exact), length 1.07m (exact), fuselage height 0.18m (close), MTOW 5.5kg (exact), manufacturer cruise speed 20m/s (exact). Reference area is quoted as 0.488m² vs the Believer's documented 51dm² (0.51m²) - close but not identical, a ~4% difference not fully reconciled. This is very likely the same commercial airframe, or an extremely close sibling model.

**The paper does not name the motor manufacturer, model, or KV rating anywhere** - propulsion is only described generically as "two wing-mounted electric motors." Propeller used in their testing: 12" diameter, 6" pitch, 2 blades - differs from the Believer's current 11x7 Hobbyrama prop, so not directly transferable for prop-specific modelling (the drag polar coefficients below are airframe-level and prop-independent, however).

**Wind-tunnel-measured drag polar (their most reliable "clean" reference, Table 2):**

| Coefficient | Value |
|---|---|
| CD0 (zero-lift drag) | 0.0503 |
| K (induced drag constant) | 0.0764 |
| CL0 (zero-AoA lift coefficient) | 0.2570 |
| CLα (lift curve slope) | 0.1122 /deg |

Derived performance (their Table 3, wind tunnel reference): L/Dmax = 8.07, max range 114km, max endurance 157min.

**Other extracted facts:**
- Measured 1g stall airspeed: 11 m/s, well above the Believer's previous `FW_AIRSPD_STALL` = 7 m/s (an untuned PX4 generic default) - `FW_AIRSPD_STALL` set to this value and `FW_AIRSPD_MIN` raised accordingly under CTL-10, `docs/project/build-checklist.md`.
- Max dive airspeed (VNE, flutter-limited): 37 m/s.
- Load factor limits: 0.2 to 3.8g, mostly wing-deformation limited rather than structural failure.
- Confirms the same operational profile as the Believer: no conventional undercarriage, hand-launch or trolley-launch departure, belly-landing recovery, V-tail with ailerons and ruddervators.

**Open strategic question**: this is a real, wind-tunnel-measured whole-airframe drag polar, which is a stronger basis for performance estimation than modelling the wing alone against the generic Eppler 374 stand-in currently used for PROP-05 (`docs/project/build-checklist.md`). Not yet decided whether to use these coefficients directly (e.g. via the Brequet range/endurance equations the paper itself uses) instead of, or alongside, the MotoCalc/E374 approach.

## Control Allocation and Control-Surface Configuration Review - 2026-08-31

Julian conducted a flight-control configuration review in a separate session and supplied a detailed summary brief for this repository to be updated from. This entry supersedes the *interpretation* of the 2026-07-10 TMAC and 2026-08-19 settings recorded above as still-current baseline decisions - those entries remain accurate historical records of what was done and why at the time, and are not rewritten.

**Core finding**: the PX4 Actuators page's Roll/Pitch/Yaw Torque fields (`CA_SV_CSx_TRQ_*`) are actuator-effectiveness coefficients used by the control allocator - normalized estimates of how effective an actuator is about a given axis, inserted into an allocation matrix and inverted to calculate actuator commands. They are **not** conventional transmitter mixer percentages and are not a direct command for a percentage of servo travel; increasing a coefficient can *reduce* the requested deflection for a given demanded moment, because PX4 is being told the actuator is more effective. This reframes several decisions made on 2026-08-19 under that mistaken assumption:

- The V-tail yaw-effectiveness values set to ±0.85 on 2026-08-19 were understood then as "raising the rudder mixing gain"/an "85% rudder mix." They are now understood to instead tell PX4 each V-tail surface is 1.7x as effective in yaw as in pitch (pitch coefficient stayed at 0.50) - a ratio with no aerodynamic derivation or flight-test evidence behind it. **Target: restore to the PX4 type-default ±0.50** (full baseline: Left Aileron Roll -0.50/Pitch 0/Yaw 0; Right Aileron Roll +0.50/Pitch 0/Yaw 0; Left V-Tail Roll 0/Pitch +0.50/Yaw +0.50; Right V-Tail Roll 0/Pitch +0.50/Yaw -0.50) - tracked as `docs/project/build-checklist.md` CTL-06. The aileron mixer trims (-0.08/-0.03) are unaffected and are to be retained through this reset - Julian has confirmed they are correctly established.
- **Endpoint-based aileron differential is no longer accepted as the project's validated baseline.** The asymmetric PWM ranges set 2026-08-19 (informed by the QGroundControl Actuators Config screenshot) may produce some asymmetric physical travel, but this was never a deliberate, reversible, quantified differential law - it conflated actuator safety endpoints (which legitimately vary per-servo due to installation differences) with aerodynamic mixing. The installed PX4 1.16.1 control-allocation interface exposes one linear coefficient per surface and no conventional aileron-differential parameter - a finding specific to this PX4 version, not a permanent limitation of all future releases. **Decision: no software aileron differential in the baseline configuration**; only reconsider if flight testing shows significant adverse yaw or another handling problem it would help. PWM endpoints are to be independently remeasured as genuine safe mechanical limits per servo (CTL-06) - the final values are presently TBD and must not be assumed symmetric.
- **No aileron-to-rudder mix is being added.** `FW_RLL_TO_YAW_FF` (roll-to-yaw feedforward, currently 0.0) remains 0.0 in the baseline; it is a controller feedforward term, not a percentage-mixer equivalent, and PX4 Stabilized mode already performs a coordinated turn on a non-zero roll stick. Additional feedforward will only be tuned upward, in small documented increments, if flight testing demonstrates meaningful adverse yaw - tracked as `docs/project/build-checklist.md` CTL-07 (deferred until CTL-06/CTL-08 complete).
- **The three `FW_MAN_*_SC` parameters remain unchanged at 1.0.** The observed bench behaviour (ailerons reaching max deflection at ~±50% stick, while the QGroundControl Radio page correctly reports the full ~-100%/+100% gimbal range) narrows away a gross RC-calibration error but does not confirm `FW_MAN_R_SC` is the cause - `FW_MAN_*_SC` only scale commands in full Manual mode, whereas Acro (rate) and Stabilized (attitude) modes can legitimately saturate a surface on a stationary bench well before full stick, since the aircraft can't respond to the commanded rate/attitude. A value near 0.5 for `FW_MAN_R_SC` is a provisional test hypothesis only, not an approved setting - it must be reproduced and confirmed in full Manual mode, after CTL-06 establishes a correct actuator baseline, before being written in as a new setting. Tracked as `docs/project/build-checklist.md` CTL-08.
- **V-tail bench saturation under full combined pitch+yaw is expected, not necessarily a mixing fault.** With the default matrix, ruddervator commands are roughly proportional to P+Y and P-Y; a surface already at its pitch limit will appear to stop as yaw is added while the other surface moves back toward neutral. Acceptance testing (CTL-06) should check correct direction, distinct response at moderate combined inputs, no binding, and safe endpoints - not that both surfaces keep moving independently at the extreme corner of the command envelope.

**Task dependency architecture established**: CTL-06 (actuator effectiveness + PWM endpoint baseline) → CTL-08 (Manual-mode scaling, depends on CTL-06) → CTL-02 (closed-loop gain tuning, depends on CTL-06 and CTL-08) and CTL-04 (transmitter rates, depends on CTL-08) → CTL-07 (evidence-based adverse-yaw feedforward, depends on CTL-06 and CTL-08, evidence gathered during CTL-02 flights). PWR-03 (servo rail load test) now also depends on CTL-06, since load test results against superseded endpoints wouldn't represent the final configuration. None of CTL-06/07/08 were promoted or demoted in priority by this review (CTL-06/08 remain Urgent, CTL-07 remains Non-critical) - this review did not make a governance decision to change task priority classification, only to correct their scope and dependencies.

**Files deliberately not yet updated**: `docs/engineering/ICD.md`, `docs/operations/Pixhawk Parameter Backup/parameter-change-log.md`, and the `.params` backup still describe the as-found state (±0.85, current endpoints, all three `FW_MAN_*_SC` at 1.0) and must not be replaced with target values until the physical configuration has actually been changed, tested, and re-exported from the live flight controller. `docs/operations/manual.md`'s Manual-mode pre-flight check wording is to be refined after CTL-08 concludes, not now. A new dated test report under `docs/engineering/test-reports/` will be created once the live work is carried out, to serve as the evidence CTL-06 and CTL-08 reference.

## CTL-08 Follow-up, Brief Closure, and Reopening - 2026-09-01/02

Julian reported a bench finding: the early control-surface saturation investigated under CTL-08 occurs specifically in Acro mode - in Manual mode, stick position and surface deflection "seem to agree better." This is consistent with the flight-control configuration review's hypothesis (above) that Acro's rate controller, unable to null a commanded rate against a stationary airframe, can saturate its output well before full stick (integral windup against a persistent, unclosing rate error), whereas Manual's direct, open-loop stick-to-actuator path has no such closed-loop artefact.

Julian initially confirmed this closed CTL-08 (2026-09-01): `FW_MAN_R_SC`, `FW_MAN_P_SC`, and `FW_MAN_Y_SC` all remain at the PX4 default 1.0, unchanged. This satisfied CTL-08's own documented closing condition ("if the apparent early saturation occurs only in Acro or Stabilized but not in Manual, conclude the bench observation was normal closed-loop controller behaviour and make no `FW_MAN_*_SC` adjustment on that basis") - accepted on the basis of this bench comparison rather than the fully itemised stick%/PWM/deflection sweep originally envisaged, a lighter evidence bar than the task's acceptance criteria first specified.

**Reopened 2026-09-02**, per Julian: on reflection, he wants the full formal test run rather than relying on the qualitative bench comparison - propellers off, PX4 explicitly in Manual mode, roll/pitch/yaw tested separately, stick%/PWM/deflection logged at several points (e.g. 25/50/75/100%) per axis. A quick comparison can't confirm the relationship is monotonic across the whole range, or that all three axes behave the same way (roll could look fine while pitch or yaw has a milder version of the same tendency, not obvious without measuring). Julian will run this test himself. `docs/operations/manual.md`'s pre-flight checklist (steps 22-23) update - requiring the Manual-mode proportionality check specifically, and noting Acro/Stabilized bench behaviour shouldn't be interpreted the same way - remains good general operating guidance regardless of CTL-08's status and was not reverted.

## CTL-06/CTL-10/NAV-05 Physical Configuration and GPS Instance Swap - 2026-09-02

Julian provided a fresh FC parameter export (`updated_params.params`, dropped in the repo root), replacing the archived backup. Cross-checked by diff against the previous export:

- **CTL-06 completed on the aircraft.** V-tail yaw effectiveness (`CA_SV_CS2_TRQ_Y`/`CA_SV_CS3_TRQ_Y`) restored from ±0.85 to the PX4 type-default ±0.50, resolving the finding from the 2026-08-31 flight-control configuration review. PWM min/max endpoints for MAIN 1, MAIN 2, MAIN 3, and MAIN 5 independently remeasured as actual safe mechanical limits (confirmed by Julian, not a provisional/interim reset) - superseding the previous asymmetric values that had conflated PWM endpoint selection with an attempt at aerodynamic aileron differential. Disarmed/trim PWM values reset to plain 1500 across all four surfaces now that endpoints aren't being used to fake differential. Aileron mixer trims rechecked post-recalibration and updated (`CA_SV_CS0_TRIM` -0.08→0.05, `CA_SV_CS1_TRIM` -0.03→-0.05) - per the review's own guidance that trims should be rechecked (not blindly preserved) after endpoint recalibration. No software aileron differential in the baseline, consistent with the review's decision.
- **CTL-10 completed.** Airspeed envelope updated per Weishäupl et al. 2024: `FW_AIRSPD_STALL` 7→11 m/s (paper's measured 1g stall speed), `FW_AIRSPD_MIN` 10→15 m/s, `FW_AIRSPD_TRIM` 15→20 m/s (matching both the manufacturer's recommended cruise and the paper's figure), `FW_AIRSPD_MAX` 20→28 m/s (close to the ~25 m/s this session recommended from VNE margin reasoning; 28 m/s is ~76% of the paper's measured VNE of 37 m/s, within the typical 65-80% margin convention). `FW_AIRSPD_MAX` was originally flagged as outside CTL-10's stated scope (a "separate, larger exercise") but was updated in the same session anyway - documented as such, not silently absorbed as if always in scope.
- **GPS driver instance/port swap - deliberate, confirmed by Julian, rationale now on record.** `GPS_1_CONFIG` changed from 201 to 202, and `GPS_2_CONFIG` from 0 (Disabled) to 201 - initially flagged as a likely mix-up (asked and confirmed intentional). The result: PX4 GPS driver **instance 1** now reads the **physical GPS2 UART port**, where the ZED-F9P is wired, making the RTK-capable receiver the primary-numbered instance; **instance 2** reads the **physical GPS1 UART port**, where the M8N is wired. Physical wiring is completely unchanged - only the logical instance numbering moved. `GPS_1_GNSS` also changed (0/Default → 31), now configuring the ZED-F9P's constellation mask (previously this parameter configured the M8N, when M8N was instance 1); `GPS_2_GNSS` (29) is unchanged in value but now applies to the M8N rather than the ZED-F9P. This decoupling of instance number from physical port is a genuine source of confusion for anyone reading the parameter names literally - `docs/engineering/ICD.md` INT-05/INT-06 now carries an explicit instance-vs-port cross-reference, and this should be kept in mind whenever discussing "GPS 1" vs "GPS 2" going forward: it now means logical instance, not physical port, and no longer maps to "M8N" vs "ZED-F9P" the way it used to. **Reason for the swap** (Julian): QGroundControl's primary GPS status indicator in the flight view reads the `GPS_RAW_INT` MAVLink message, which PX4 populates from GPS driver instance 1 - with the ZED-F9P on instance 2, QGC's main display would have shown the M8N's lesser fix status rather than the actual best-available GPS quality, under-reporting to the pilot. **NAV-05 closed 2026-09-02**: both receivers confirmed achieving a lock under the new configuration.

## CTL-04 Tri-Rate Implementation, CH9/CH11 Dual-Purpose Correction, and Radio Backup Update - 2026-09-02

Julian implemented CTL-04 (originally scoped as a simple dual-rate, aileron-only plan): 30% expo confirmed on all flight surfaces; tri-rate (100%/70%/50%) configured on both aileron and elevator channels, each on its own dedicated switch - aileron rate on CH9 (SB), elevator rate on CH11 (SE). This proceeded before CTL-08 (its original dependency) formally concluded - low risk given CTL-08's informal finding that `FW_MAN_R_SC` will likely stay at 1.0, but not yet formally confirmed, so flagged rather than silently treated as compliant with the original task ordering.

Julian described this verbally as removing Offboard from SE, which now serves as the elevator rate switch instead. That was documented at first as a straightforward CH9/CH11 reassignment (Offboard no longer reachable via any switch). Julian then supplied the actual new radio backup and asked for it to be verified before replacing the archived copy. Diffing `model00.yml` (new) against the previous archived version showed the verbal description was inaccurate: the `mixData` entries for CH9 (destCh 8, srcRaw SB, weight -100) and CH11 (destCh 10, srcRaw SE, weight -100) are byte-for-byte unchanged. What actually changed is a new, separate `expoData` table using SB0/SB1/SB2 and SE0/SE1/SE2 switch positions to select rate curves on the Ail/Ele stick inputs.

**Corrected understanding**: SB and SE are now dual-purpose, not reassigned - they still drive CH9 (Flaperon control/spare) and CH11 (Offboard) exactly as before, and separately also select the aileron/elevator rate curve locally in EdgeTX. This is a more concerning finding than the original "Offboard is gone" framing: `RC_MAP_OFFB_SW` is still live on channel 11, so flipping elevator rate in flight also moves CH11, which could unintentionally cross whatever threshold PX4 triggers Offboard on, engaging the offboard-loss failsafe since no companion computer is actually streaming setpoints. Similarly `RC_MAP_FLAPS` is still live on channel 9, though flaperons are inactive for the maiden flight so the practical risk is low. All manual.md/ICD.md/flight-modes.md/build-checklist.md documentation written under the initial verbal description was corrected before commit. Both channels' overlap tracked in `context/open-items.md` and `docs/project/build-checklist.md` CTL-04.

The radio backup also added a new Timer 0 ("Arm", starts on SD2), a new custom-function set (mode-announcement sounds per GR1 position, timer reset on SD0), and a substantially expanded telemetry sensor/screen list - none of this is core to CTL-04 and it is not documented further here.

The verified radio backup was moved into place, replacing the previous archived copy at `docs/operations/GX12 Radio Backup/`. Next stage of CTL-04, per Julian: review maximum deflection, rates, and expo with Ross Dennington (BNEMAC) before treating the values as final.

The switch diagrams (`docs/assets/gx12-front-switches.png`/`gx12-top-switches.png`) do not need re-annotating for a reassignment that didn't happen - CH9/CH11's core switch functions (Flaperon/Offboard) are unchanged - but would benefit from a supplementary annotation noting the new local rate-curve behaviour on SB/SE. Claude has no image-editing capability, so this needs to be done manually.

**Lesson**: verify configuration claims with safety implications (channel reassignment, failsafe interactions) against the source-of-truth artifact - here, the actual radio backup - rather than relying on a verbal description alone, even when the description is confident and detailed.

- **Routine recalibration**: barometer and gyroscope (instance 2/IMU2) offsets refreshed in the 2026-09-02 parameter export; accelerometer and magnetometer unchanged from the 2026-08-19 calibration run.

## SB/SE RC_MAP Cleanup and New Critical Blockers (AF-06, PROP-08) - 2026-09-02

Julian has begun clearing the SB/SE dual-purpose overlap flagged above: `RC_MAP_OFFB_SW` cleared on the physical FC since the last parameter export was taken, with `RC_MAP_FLAPS` still to be cleared. Not yet reflected in `docs/engineering/ICD.md`/`docs/operations/Pixhawk Parameter Backup/parameter-change-log.md` pending a fresh parameter export to verify both values directly, per the verification lesson above - Julian will provide one next time the plane is connected.

Two checklist changes:
- **AF-06 (control surface hinges) elevated from Non-critical to Critical/flight-clearance-blocking**, per Julian.
- **New PROP-08 added (Critical/ground-test-readiness-blocking)**: the 2026-08-31 brief full-throttle overcurrent finding (PROP-02 background - ~30-32.5A/motor against the MN3110 KV700's 21A continuous rating) needs an actual configuration fix, not just further measurement - PROP-02 covers testing/recording; PROP-08 is the corresponding action item (current limit, throttle ceiling, or propeller change) to bring sustained draw within the rated limit.

## Thrust Test Motor Cutout Investigation (Ross Dennington) - 2026-09-02

Julian and Ross Dennington (BNEMAC) ran a bench thrust-test session; the motor cut out unexplainedly at full throttle on two of the runs. Julian suspected the flight controller may have browned out, based on finding QGroundControl disconnected when checking why one of the runs had disarmed.

Investigated by pulling the SD card's `.ulg` logs directly (`E:\log\2026-09-02\`, six sessions, one idle) and analysing them with `pyulog` (installed for this purpose - `python -m pip install pyulog`). Five of the six sessions were genuine thrust-test runs (peak current 29.8-65.9A); the third-to-last and second-to-last of those (`07_37_15.ulg`, `07_46_13.ulg`) each ended in a motor cutout while the aircraft was still commanded above 0.85 (near-full) throttle - confirmed by Julian as both being full-throttle cutouts.

**Root cause identified, not power-related:** in both cases, `vehicle_land_detected.landed` flips true (`Landing detected`), and exactly 2.00s later - matching `COM_DISARM_LAND` = 2.0 precisely - `Disarmed by landing` fires and both motor PWM outputs drop to 1000us (PX4's idle/disarmed value). PX4's fixed-wing landing detector uses velocity/airspeed-based criteria (`LNDFW_VEL_XY_MAX`/`LNDFW_VEL_Z_MAX`/`LNDFW_AIRSPD_MAX`/`LNDFW_XYACC_MAX`/`LNDFW_ROT_MAX`, sustained 2s via `LNDFW_TRIG_TIME`) that a bench-restrained aircraft trivially satisfies regardless of throttle - it isn't moving. These are as-exported PX4 defaults, never reviewed for this airframe. It didn't trigger on every full-throttle run that day (2 of 5), suggesting a marginal signal (airspeed blip, vibration) tips the detector over threshold rather than throttle alone. Battery voltage and the 5V system rail were nominal throughout both cutout events, and the flight controller's boot-relative clock ran continuously across both - ruling out a brownout or reboot as the cause of either.

**Separately, one genuine reboot was found** in the gap between the day's 07:28:44 and 07:37:15 sessions (boot-relative clock resets between them) - but 07:28:44's own log ends with no anomaly (clean, deliberate throttle-down and RC-switch disarm, voltage/5V rail nominal throughout), so this reboot isn't correlated with a full-throttle event; likely a manual power-cycle or connector event while the aircraft was handled between runs. Cause not otherwise determinable, since no log spans the reboot itself. This is what most plausibly explains a "lost connection" observation, if it was noticed in the pause between test runs rather than during an active cutout.

Rather than a dedicated checklist task, Julian opted to flag this as a lighter open item: for future bench tests, raise or disable `COM_DISARM_LAND` for the duration of testing, then confirm it's restored to its flight-intended value before flight clearance - see `context/open-items.md`. Full findings: `docs/engineering/test-reports/2026-09-02-bench-thrust-test-review.md`.

**PWM-vs-current follow-up:** while the logs were open, also correlated `actuator_outputs` against `battery_status.current_a` directly to answer Julian's question of what PWM value corresponds to ~42A total current draw (~21A/motor - the MN3110 KV700's rated continuous current). Found consistently ~1800-1809us across the two sessions that reached that current level (`07_23_00.ulg`, `07_28_44.ulg`), matching Julian's own ~1800 estimate. Logged as a candidate PROP-08 throttle-ceiling starting point, not yet a confirmed value - it's from incidental brief-burst data, not a dedicated sustained-run test.

## RC_MAP Cleanup Confirmed and PROP-08 PWM Ceiling Applied - 2026-09-02

Julian provided a fresh parameter export (`params_update.params`, dropped in the repo root), verified by diffing against the previous archived export. Two changes, both confirmed rather than accepted verbally:

- **`RC_MAP_FLAPS` and `RC_MAP_OFFB_SW` both cleared to 0 (unassigned)** (previously 9 and 11) - resolves the SB/SE dual-purpose overlap flagged in the CTL-04 investigation above. PX4 no longer acts on CH9/CH11 for Flaperon control or Offboard mode at all; SB/SE's underlying `mixData` radio output is unchanged, only PX4's interpretation of those channels changed. Offboard is now genuinely unreachable via any switch (previously this was documented, then corrected to "still reachable" after the radio-backup diff, and is now correctly "not reachable" again via a different, verified mechanism). Updated `docs/engineering/ICD.md` (Rev 2.5), `docs/engineering/flight-modes.md` (Rev 1.7), `docs/operations/manual.md`, `docs/operations/Pixhawk Parameter Backup/parameter-change-log.md`, and closed the corresponding CTL-04 acceptance criterion.
- **`PWM_MAIN_MAX4`/`MAX6` (motor PWM ceiling) lowered from 2000 to 1800** - applying the PWM-vs-current data point from the same day's investigation as a throttle ceiling for PROP-08. Not yet confirmed via a dedicated sustained-run test (still blocked on the `COM_DISARM_LAND` bench-testing workaround), so PROP-08 moved to **For review** rather than Complete.

Other diffed changes were routine (accelerometer/barometer calibration drift, flight UUID counter, internal flight-time tracker) and not otherwise documented. The fresh export replaced the archived copy at `docs/operations/Pixhawk Parameter Backup/believer-parameters.params`.

## PROP-02/PROP-06 Closed, PROP-10 Split Out - 2026-09-02

Julian met with Ross Dennington (BNEMAC) during the day's bench thrust-test session. Ross reviewed throttle response and was satisfied with the throttle curve/mapping (no remapping applied) - **PROP-06 closed** on that basis. Ross also assessed static thrust qualitatively ("felt the thrust") and judged it acceptable - **PROP-02 closed** on that basis too, per Julian's explicit instruction to reduce its acceptance criteria.

Recorded precisely, per the CTL-08 lesson on evidence bars: PROP-02's original acceptance criteria (measured thrust-to-weight ratio, sustained-run current/temperature check) were **not** met - the task was closed on Ross's qualitative assessment alone, at Julian's explicit direction to reduce the bar. No thrust-to-weight figure exists. The sustained-run current/temperature check remains separately open under PROP-08. The dropped quantitative motor-rig measurement (e.g. a load-cell thrust stand) wasn't discarded - split out as a new task, **PROP-10** (Non-critical), so it stays tracked without blocking flight clearance.

Findings written up in `docs/engineering/test-reports/2026-09-02-bench-thrust-test-review.md`. Both tasks moved to Completed Work in `docs/project/build-checklist.md`.

**CTL-04 not closed**, despite Julian raising it as a candidate: the Ross meeting covered throttle mapping and thrust, not specifically "maximum deflection, rates, and expo" (CTL-04's own Ross-review acceptance criterion), and two other criteria remain open regardless - revalidation against `FW_MAN_R_SC` pending CTL-08's formal conclusion (CTL-08 is For review, not Complete), and the switch-diagram relabelling. Flagged to Julian rather than closed, consistent with the CTL-08 precedent of not silently accepting a lighter bar.

## Further Ross Dennington Review Notes - 2026-09-02

Additional notes from the same 2026-09-02 review with Ross Dennington (BNEMAC), covering the current configuration, mounting, control rates, and launch method:

- **CG/weight concern.** Julian showed Ross the current configuration and noted the CG is still well out of balance (AF-01, unresolved since the 2026-07-10 TMAC finding of ~350g nose ballast needed). Ross raised a concern about all-up weight: the airframe's manufacturer-rated MTOW is 5.5kg, and thrust margin is already less than ideal (PROP-02/PROP-10, closed on a qualitative assessment rather than a measured thrust-to-weight ratio). Flagged against AF-01: adding ~350g of dead-weight ballast to fix CG moves AUW in the wrong direction given that thrust concern - worth considering a mass-relocation approach (e.g. the battery, if repositionable) instead of ballast, before committing. Not decided; recorded as a consideration in AF-01's background, not a decision.
- **Motor mount wobble (AF-08).** Julian showed Ross the play in the motor mounting plates (already tracked as AF-08, not yet glued). Ross wasn't overly concerned, provided the mounts aren't at risk of pulling out - which they aren't - and noted that once loaded in flight (thrust pulling the airframe forward, rather than sitting static), the wobble should reduce significantly. Reassuring second opinion; doesn't change AF-08's scope or status, still to be glued as planned.
- **Tri-rates and expo (CTL-04).** Ross reviewed the tri-rate/expo configuration and was satisfied - closes that specific CTL-04 acceptance criterion. However, a new problem surfaced during the review: the tri-rate switch doesn't appear to work correctly in Acro mode - only two distinct rate levels were observed rather than three, more like dual-rate behaviour. Julian checked Manual mode and confirmed tri-rate works correctly there, which supports the bench-testing-artefact hypothesis (CTL-08's closed-loop Acro saturation) over a genuine configuration fault - the rate curve itself is fine. Not confirmed in real flight (Acro behaves differently once the aircraft can actually achieve a commanded rate), but no further bench investigation needed.
- **Launch mechanism.** Discussed options: a hill launch (using elevation to gain airspeed/lift before full climb) or a catapult were both raised as possibilities. For the maiden flight specifically, the plan remains an assisted hand launch, as already documented in `docs/operations/manual.md`. No document changes needed - the hand-launch plan is unchanged; the hill/catapult discussion is recorded here as provenance in case either becomes a live option for later flights.

## 2026-09-02 Reboot Closed, COM_DISARM_LAND Set to -1 - 2026-09-26

Julian judged the unexplained 2026-09-02 flight-controller reboot (see "Thrust Test Motor Cutout Investigation" above) to be a non-recurring one-off rather than a fault, and asked for it to be treated as closed. Recorded precisely, since the logs don't support the reading that the reboot *was* the landing disarm: the two are distinct events. The landing disarms (`07_37_15.ulg`, `07_46_13.ulg`) occurred with the flight controller's boot clock running continuously through them, while the reboot is a boot-clock reset in the gap between `07_28_44.ulg` and `07_37_15.ulg`, after a clean RC-switch disarm. The reboot's cause remains undetermined from the logs - it was closed on Julian's judgment that it isn't recurring, not because a cause was found. The open item was removed accordingly.

Julian also reports having set `COM_DISARM_LAND` to -1 (auto-disarm on landing disabled) for bench testing, previously 2.0s. Not yet verified - a fresh parameter export is to follow, per the practice of confirming parameter changes against an export rather than a verbal description. The requirement to restore the flight-intended value before flight clearance is unchanged and stays in `context/open-items.md`. Claude could not confirm the semantics of -1 locally (no PX4 parameter metadata found in the QGroundControl install or cache) - QGroundControl's parameter tooltip is the authority.

## Airframe Closures, Custom Li-ion Battery, and Thrust Stand Characterisation - 2026-09-26

Julian reported a batch of updates, recorded here with the evidence each closure actually rests on (per the CTL-08 lesson).

**Tasks closed (AF-01, AF-02, AF-06, AF-08), all per Julian:**
- **AF-08 (motor mounts):** the 3D-printed boards the motors are fixed to were adjusted so there is now no slop, and the motors are fixed to them with blue Loctite. The polyurethane glue the task originally scoped was therefore not needed - closed by a different method than scoped, against the "no play or looseness" acceptance criterion. Removal of the motor covers and wing was not separately confirmed.
- **AF-01 and AF-02 (CG and battery retention):** Julian built a custom Li-ion battery, a 6S4P pack of NCR20700A cells (24 cells), and tested it in the aircraft: it puts the CG in the right place, so no nose ballast was needed. This resolves the concern Ross Dennington raised on 2026-09-02 that ballast would add weight against an already-marginal thrust margin. The pack is retained by a single strap plus velcro on its underside. Evidence bar: Julian's in-aircraft test; no numeric CG measurement, pack mass, or all-up weight was recorded. The pack's **capacity test has not yet been done** (Julian's next step; the pack was being charged).
- **AF-06 (hinges):** all flight-surface hinges were reinforced with cloth tape. The task was scoped as *replacing* the foam-skin hinges with proper hinges, so this is a reinforcement, not the originally recommended fix - closed at Julian's direction on that basis, and the completed-work note says so.

**Battery change knock-ons** (recorded as open items, nothing changed yet): the PX4 battery estimation parameters (`BAT1_CAPACITY` -1, `BAT1_V_CHARGED` 4.05, `BAT1_V_EMPTY` 3.6) are LiPo-style defaults and the low/critical/emergency thresholds are derived from them; the all-up weight has changed and is unrecorded (needed for `WEIGHT_BASE`, CTL-09, and for the thrust-to-weight ratio); ICD, parameter log, project overview, and manual step 11 were updated for the new pack.

**Thrust stand characterisation.** Julian ran the MN3110 KV700 on an RCbenchmark Series 1520 thrust stand with APC 11x7" (2026-09-06 and 2026-09-10) and APC 12x6" (2026-09-15) propellers, and supplied four comparison graphs (moved to `docs/assets/mn3110-*.png`) and the raw CSV logs, which stay in his MATLAB/QUTAS folder outside the repo. Claude recomputed the numbers from the raw CSVs rather than relying on the plots alone. Julian's conclusions held up: limiting the ESC command to about 1700us keeps the 12x6" at about 19A per motor (inside the 21A rating) with about 1.7 kgf of static thrust per motor. Two cross-checks: the 11x7" reaches 21.3A per motor at 1780us on the stand, matching the flight-controller-log correlation from 2026-09-02 (about 42A total at 1800-1809us) to within about 25us; and 12x6" data above about 1720us is transient (the stand cut out near 500W), so the 21A crossing point for the 12x6" (roughly 1715-1730us) is a fit, not a measurement. The two propellers were tested at different supply voltages (12x6" higher), so the propeller comparison is indicative only. Full write-up: `docs/engineering/test-reports/2026-09-15-mn3110-thrust-stand-characterisation.md`. **Julian is sticking with the 12x6".** PROP-10 (quantitative thrust measurement) moved to For review - measurement done, but the thrust-to-weight ratio needs the all-up weight and a defined target; PROP-08 was updated with the revised ~1700us ceiling (applies only once `PWM_MAIN_MAX4`/`MAX6` is changed from 1800 and exported).

**Flagged for Julian, not decided:** a 12" propeller has a 152.4mm radius, but the 2026-07-05 BNEMAC review recorded 150mm motor-shaft-to-ground clearance with an 11" propeller "barely clearing" - ground clearance for the 12x6" needs checking on this belly-landing airframe. The stand tests used APC propellers while the docs list Hobbyrama LP11X7E as fitted; propeller documentation was left unchanged until the 12x6"'s purchase and installation are confirmed.

**Housekeeping found while updating:** the revision headers of `docs/engineering/ICD.md` (2.4) and `docs/engineering/flight-modes.md` (1.6) had not been bumped when Revs 2.5 and 1.7 were added to their history tables on 2026-09-02; corrected to the current revisions. `flight-modes.md`'s open-items section still listed the CG item and the (already closed) static-thrust/throttle-mapping item, and `parameter-change-log.md` still called NAV-05 GPS lock outstanding - all corrected. `context/project-overview.md`'s open-items summary was rewritten, since it had gone stale.

## Custom Li-ion Battery Details - 2026-09-26 (later)

Julian confirmed the custom battery has **no BMS**, and supplied per-series-group internal resistances read off his HOTA F6 Ultra charger (photo saved as `docs/assets/custom-li-ion-charger-cell-resistance.png`, matching his figures): 3.4, 4.6, 2.9, 3.2, 3.3, and 3.6 mOhm for groups 1 to 6, 21.0 mOhm total. The photo also shows the charger profile is "LiIon-6S (4.10V)", so the pack is deliberately charged to 4.10 V per cell rather than the cell's 4.20V standard - the capacity test will therefore read below the datasheet figure even for healthy cells. It showed 99% and 5.47 Ah charged at 51 minutes in; Claude did not treat that as a capacity figure since the starting state of charge is unknown.

Claude answered Julian's question on the cell's safe minimum voltage from the Panasonic NCR20700A datasheet (fetched from a distributor copy, now saved as `Component datasheets/panasonic-ncr20700a-cell-datasheet.pdf`): 2.5 V per cell is the discharge end voltage used on its curves, a floor rather than a target. The cell is rated 3100 mAh (3150 minimum, 3300 typical). A landing limit of about 3.3 V per cell under load was suggested as a judgement, not from the datasheet, and not adopted. Reseller listings quote a 30 A continuous rating, but the datasheet has no such table entry (its 30 A curve shows the cell heating to about 77 C against a 60 C discharge limit); at the roughly 10 A per cell this pack sees at the 1700 us throttle ceiling that is not a concern.

Analysis recorded in `docs/engineering/test-reports/2026-09-26-custom-li-ion-battery.md`: 21.0 mOhm gives about 0.8 V of sag at 38 A, so the pack should sit near 23.8 V loaded at the ceiling, close to the thrust stand's 24.0 V at 1700 us - the stand's ~19 A per motor should carry over to first order. Group 2 (4.6 mOhm) is about 40% above the mean of the others, roughly what one non-contributing cell in a four-cell parallel group would read (a poor weld is one possibility) - flagged for checking, not concluded. PX4's `BAT1_R_INTERNAL` is a per-cell figure (typical about 5 mOhm), so the measured mean of about 3.5 mOhm per series group is the comparable value; nothing was changed on the flight controller. The cells alone weigh up to 1.44 kg (24 x 60 g maximum), which bears directly on the all-up-weight concern Ross Dennington raised - the pack has not yet been weighed.

## All-Up Weight, Charger Limit, and Proposed Parameter Changes - 2026-09-26 (later)

Julian weighed the aircraft: **3.8 kg all-up** with the custom Li-ion battery, about 69% of the 5.5 kg manufacturer MTOW. With about 3.4 kgf of static thrust at the 1700us ceiling (thrust-stand report) that is a static thrust-to-weight ratio of about 0.89, against about 0.62 at MTOW - which largely answers the weight-versus-thrust concern Ross Dennington raised on 2026-09-02. Julian also noted his HOTA F6 Ultra charger tops out at 4.15 V per cell on its Li-ion profile, so the pack cannot be charged to the cell's 4.20V standard; Claude's earlier suggestion to charge to 4.20V for the capacity test was therefore moot.

Asked to recommend parameter changes, Claude checked the live export and PX4 documentation and recorded the result as **proposals only, none applied** (open-items.md):
- **`COM_LOW_BAT_ACT` is 0 (Warning).** The battery low/critical/emergency thresholds therefore only warn and take no automatic action, although the checklist and parameter log had described a configured battery failsafe. Corrected those documents (parameter log row, flight-modes Section 5 row at Rev 1.9, and a note on the failsafe Completed Work entry) and proposed option 3 (Return at critical, Land at emergency), which PX4 documents as recommended. This matters more for a Li-ion pack with no BMS.
- **`WEIGHT_BASE`/`WEIGHT_GROSS` (CTL-09):** confirmed against the PX4 docs that when both are above zero the minimum, stall, and trim airspeeds scale with the square root of the weight ratio, with no effect while they are equal. Proposed both = 3.8. Deliberately not proposed: setting `WEIGHT_BASE` to the paper's mass, because the Weishaupl paper does not state the mass at which its 11 m/s stall speed was measured (only a 5.5 kg maximum take-off mass), so the current airspeed limits are left as conservative until stall is measured in flight.
- **Battery estimation:** `BAT1_V_CHARGED` 4.10 (charging to 4.15V), `BAT1_V_EMPTY` about 3.3 as a provisional rest-equivalent floor, `BAT1_CAPACITY` set from the measured capacity after the capacity test, `BAT1_R_INTERNAL` left at -1.
- **`COM_DISARM_LAND`:** reopened as a decision rather than a simple restore-before-flight. The bench cutouts occurred with the aircraft held still at high throttle, which resembles the pre-throw phase of the assisted hand launch; Claude suggested keeping -1 for the maiden flight with a manual disarm after landing, as an untested judgement.
- `PWM_MAIN_MAX4`/`MAX6` -> about 1700 was already tracked under PROP-08.

`docs/engineering/ICD.md` battery charge target updated to 4.10 to 4.15 V per cell. PROP-10's thrust-to-weight criterion is now met (0.89); only a defined target ratio remains open, so it stays For review.

## COM_DISARM_LAND Decision, BAT1_V_CHARGED and BAT1_R_INTERNAL - 2026-09-26 (later)

**`COM_DISARM_LAND`: Julian decided to keep -1 for the maiden flight.** `docs/operations/manual.md` was updated: pre-flight step 16 now checks the value reads -1, and a new "Landing and shutdown" section (steps 40-42) requires a manual disarm with CH5 after landing, keeps everyone clear until disarm is confirmed, and points to the kill switch (CH7) if a propeller turns unexpectedly. Recorded as a decision to revisit after the maiden flight; the live value is still to be confirmed by a parameter export.

**`BAT1_V_CHARGED` proposal withdrawn.** Julian questioned Claude's proposal to raise it from 4.05 to 4.10, recalling that it had been set slightly low so the flight computer would not read voltage sag as real charge loss. Checked against the PX4 battery documentation: 4.05V is the PX4 default and is the docs' recommended value for Li-ion, nobody in this project changed it, and the docs' stated rationale is "slightly lower than the nominal maximum cell voltage, but not so low that the estimated capacity is still 100% after a few minutes of flight" - not sag. Sag is handled by load compensation using the battery's internal resistance, not by `BAT1_V_CHARGED`, though a lower value does leave some headroom before the estimate drops from 100%. The 4.10 proposal had no documented basis and was withdrawn; 4.05 stays.

**`BAT1_R_INTERNAL`: leave at -1.** PX4 estimates internal resistance in real time by default and uses it for current-based load compensation; a fixed value cannot follow the resistance rising as the pack discharges or cools, and the charger's figure was taken at low current near the end of charging rather than under flight load. If it needs fixing later, the value is per cell: about 0.0035 ohm from the charger-measured 21.0 mOhm total across 6 series groups (PX4 lists about 5 mOhm per cell as typical for LiPo). Claude could not check how the flight computer's live estimate behaved on the old LiPo pack because the SD card was no longer available; the check to make is the `internal_resistance_estimate` and `remaining` traces in the first log from the new pack (does the remaining-charge estimate dip at throttle-up, and does the resistance estimate settle).

`BAT1_V_EMPTY` remains a provisional proposal of about 3.3V; PX4's docs list 3.0V (conservative, no load) and 2.7V (under load) as generic Li-ion values, and 3.3 is deliberately higher given the pack has no BMS and cell group 2 is a resistance outlier.

## Bench Simulated Flight and Left Motor Failure - 2026-09-26 (later)

Julian ran a bench simulated flight on the custom Li-ion battery to test capacity and confirm the motors could sustain a flight-like load; the left motor burned out. Claude read the flight controller SD card (now the G: drive; the day's 25 logs are in `log/2026-09-26`) and stitched the relevant logs on the flight controller's boot clock: the last power-up (about 05:48 UTC) is one continuous boot, so `06_07_39` (543 s, main run), `06_16_46` (49 s, 4.3 s after the first ended) and `06_17_37` stitch directly. Julian expected the run to be split by a mid-run disarm because his dog came too close; the only throttle-to-idle interruption inside the main log is at about 226 to 234 s (still armed), and the log split is the disarm after the failure.

Julian's question was whether more than 21 A was supplied continuously. Answer from the data: no. Only total current is measured, so assuming an even split the motors saw a mean of 11.2 A each, a worst rolling 180 s RMS of 13.9 A (44% of the 21 A for 180 s budget), and only about 6 s above 21 A per motor, all at the 1800us command. The failure signature is an electrical fault instead: current rose from 42.7 to 46.4 A at a fixed 1800us with steady voltage, then one 102.9 A sample as the throttle was pulled back, and afterwards the drive draws 2 to 6 times the expected current when driven (idle current normal). Root cause is not determinable from the logs (no ESC or motor telemetry; total current only). Contributing factors considered: earlier overcurrent exposure (about 30 to 33 A per motor bursts on 2026-08-31 and 2026-09-02; about 40 s above 42 A total across today's logs) and static-bench heating in the 3D-printed mounts; neither is provable from the logs. Claude flagged that the 102.9 A exceeds the AIR 40A's 60 A 10 s rating, so the left ESC (and the right side and power distribution board) should be inspected before any new motor is fitted, so a replacement is not destroyed by the same fault.

The parameters recorded in the log headers also showed which of Claude's proposals had been applied: `WEIGHT_BASE`/`WEIGHT_GROSS` 3.8, `BAT1_V_EMPTY` 3.2 (proposed about 3.3), and `COM_DISARM_LAND` -1 were live; `PWM_MAIN_MAX4`/`MAX6` were still 1800 (the recommended ~1700 not applied) and `COM_LOW_BAT_ACT` still 0. Earlier logs that day (with `BAT1_V_EMPTY` 3.6) show the "Low battery"/"Critical battery" failsafe warnings firing early, consistent with the LiPo-style value flagged earlier. The capacity test was not completed (4.2 Ah discharged).

The choice of replacement motor (like-for-like MN3110 KV700 or a different motor) was deliberately left open at this point and is tracked as PROP-11. Full write-up: `docs/engineering/test-reports/2026-09-26-bench-simulated-flight-motor-failure.md`.

## Motor Failure: Mount Material and Cooling - 2026-09-26 (later)

Asked how the motors and ESCs are housed, Julian said the motors get airflow over them in flight (in theory) but the ESCs largely do not, the motors are mounted on 3D-printed PETG, and the failed left motor melted its PETG mount. Claude's reading: visibly melting PETG (which typically softens at roughly 70 to 80 degrees C) needs the mount to have been far hotter than a healthy motor at 21 A would make it, so a serious winding fault in the motor is more likely the source of the heat than the ESC, though the logs cannot say whether heat caused the fault or came from it. The second log (`06_16_46`) shows the failed drive was powered again about 30 s after the failure and drew 12 to 14 A at low-to-mid throttle for a few seconds, so some of the heating may have come after the failure. The PETG mount is also a thermal limit on any replacement motor, and the uncooled ESCs make ESC temperature a second open question; both were added to PROP-11 as acceptance criteria. A replacement-motor recommendation was not yet given.

## Motor Failure: ESC Enclosure, Re-Test and Right-Hand Side - 2026-09-26 (later)

Julian clarified that `06_16_46` was him checking the motors after the left one clearly smoked and failed, that the right-hand side seems fine, that the ESCs are enclosed in the wing with no airflow, and that he does not know the ESC timing setting. Effects on the analysis: Claude's earlier lean towards the motor (from the melted PETG mount) was weakened - with the AIR 40A (26 g, no heatsink, ratings that presumably assume multirotor-arm airflow) sealed in the wing, an ESC power-stage failure that forced current through the motor windings fits the smoke and melted mount as well as a winding short does, so the ESC is treated as a live candidate and the two are recorded as not separable from the logs. The re-test in `06_16_46` put abnormal current through the left ESC as well as the motor. The ESC timing can be set but not read back per the manual, so the practical fix is to set Intermediate explicitly at the next recalibration. Added to PROP-11 (ESC choice and cooling as part of the task) and to the ICD (Rev 2.8: motor and ESC characteristics, and replacement of a stale ESC paragraph that still described PROP-02/PROP-06 as open). Claude also suggested an inline fuse or breaker (bench only) or a current-limited supply for bench runs, since the pack has no BMS; not adopted or rejected yet.

## Replacement Motor Research (12x6 Propeller, 6S) - 2026-09-26 (later)

Julian asked what a better motor would be, sticking with the 12x6" propeller, with about 200 g of total mass headroom he would rather not use. Specifications below are from manufacturer datasheets and reseller listings found by web search on 2026-09-26; they have not been verified, and prices and availability were not checked.

| Motor | Mass (bare) | Max continuous (180 s) | Resistance | Cells listed | Notes |
|---|---|---|---|---|---|
| T-Motor MN3110 KV700 (installed) | 80 g | 21 A / 466 W | 92 mOhm | 3-6S | Datasheet in `Component datasheets/` |
| T-Motor MN3510 KV700 | 97 g (118 g with leads) | 25 A / 555 W | 50 mOhm | 3-4S | Same 10 mm stator height, 35 mm stator diameter; 4x M3 on a 25 mm circle; datasheet test data is 4S/3S only |
| T-Motor MN3510 KV630 | 97 g | 22 A / 495 W | 65 mOhm | 3-4S | Lower rating than the KV700 |
| T-Motor MN3508 KV580 | 82 g | about 310 W | 110 mOhm | 3-4S | Lower rating than the installed motor |
| KDE3510XF-475 | 120 g (175 g with leads) | 30 A / 665 W | 105 mOhm phase to phase | 4S to 6S LiHV (26.1 V) | About $135 US each; needs about 5 mph of airflow across the windings for its ratings; 200 C windings; recommends propellers up to 15.5"; mounts M4 on 25 mm or M3 on 32 mm circles |
| T-Motor AT3520 / SunnySky X3520 | about 220 g | large (X3520: 2000 W claimed) | - | up to 6S | Ruled out: about +280 g for two, above the 200 g headroom |

Reasoning recorded: at a fixed propeller the current is set mainly by the propeller, not the motor (the 12x6" needs about 19 A per motor for 1.7 kgf whichever motor turns it), so a different motor buys thermal and power margin, not lower current. Against the stand data (14.1 A at 1600us, 19.3 A at 1700us): the MN3110 sits at 67% / 92% of its 21 A rating; the MN3510 KV700 would sit at 56% / 77% of 25 A, and with about half the winding resistance (50 against 92 mOhm) would dissipate roughly half the copper heat at the same current (about 19 W against 34 W at 19.3 A, using the datasheet resistances, which may not be measured identically); the KDE at 47% / 64% of 30 A (all of these compare battery current with the rating and are superseded by the winding-current comparison in the 2026-09-27 section below, which puts the KDE's copper heat at the same thrust at about half the MN3110's), and it is designed for larger propellers. Keeping the MN3110 at a 1600us ceiling costs no mass and gives about 1.5 kgf per motor (about 3.0 kgf total, static thrust-to-weight about 0.79 at 3.8 kg) at 67% of its current rating (battery current; on winding current about 125% - see the 2026-09-27 section).

Caveats recorded: the MN3510 KV700 is listed for 3-4S while the aircraft runs 6S (the MN3110 KV700 is listed 3-6S), so its suitability should be confirmed with T-Motor before committing; changing motor type means replacing both motors as a matched pair and designing new mounts (the PETG mounts are being replaced anyway); the failure may have originated in the ESC, so a motor change alone is not a fix (Julian later stated the PETG mount was not the cause - see the next section). Julian has an RCbenchmark thrust stand and could characterise a candidate with the 12x6" exactly as was done for the MN3110 before committing. Sources: T-Motor MN3510 datasheet (`cdn.robotshop.com/media/T/Tmo/RB-Tmo-200/pdf/ligpower_mn3510_kv630_high_performance_uav_motor_f_datasheet.pdf`), KDE Direct (`kdedirect.com/products/kde3510xf-475`), T-Motor store AT3520 and MN3508 pages, SunnySky USA X3520 page. No recommendation was adopted; the choice is Julian's.

## PETG Not the Cause; MN3510 KV700 on 6S Unconfirmed - 2026-09-26 (later)

Julian stated the PETG mount was not the fault (the melting followed the failure) and that he needs to confirm the MN3510 KV700 can handle 6S before going with it. Claude withdrew its earlier suggestion that the mount might have caused the failure, and softened the mount criteria in PROP-11 and the failure report to a measurement (record mount temperature on the next bench run) instead of a required material change. On 6S, T-Motor's store page (`store.tmotor.com/product/mn3510-motor-navigator-type.html`) and datasheet list the MN3510 KV700 and KV630 for 3-4S only and the KV360 for 3-6S (rated 15 A / 330 W, too low for the 12x6"), recommend low-pitch propellers (KV700: 11x3.7, 12x4, 13x4.4 CF) and an AIR 20A 3-4S ESC, and give no maximum voltage; a web search found no reports of 6S use. The datasheet's test data for the KV700 is at 11.1 V and 14.8 V only. Claude's inference (not stated by T-Motor) is that the 3-4S listing reflects the power and current a KV700 reaches at full throttle on more cells with those propellers, not a winding insulation limit, but only T-Motor can confirm it. Julian is to ask T-Motor; the fallbacks are the KDE3510XF-475 (explicitly listed 4S to 6S LiHV, +40 g each) or keeping the MN3110 KV700 (listed 3-6S) on a lower ceiling. Added an open item and a conditional PROP-11 acceptance criterion.

## Motor Install Date, Lifetime Overcurrent Tally and Winding-Current Correction - 2026-09-27

**Install date.** Julian confirmed the MN3110 KV700 motors were installed at roughly 2026-07-24 and that the flight computer used to be on a multicopter (so the 2023-2024 SD card logs are not this aircraft). The notes' earlier 2026-08-19 date was when Julian reported a batch of changes with a parameter export. The logs bracket the true date: the last log with the previous motor configuration (motor PWM 1100-1900 us, peak 19.8 A total) is 2026-07-06; the 2026-07-10 logs still show it with the motors barely spun; the motor range changed to 1000-2000 us at 06:33-06:35 UTC on 2026-07-26 and the first high-current run was 06:46 UTC that day. The ESC install date is not separately confirmed (the notes and ICD say 2026-08-19, which is likely also a report date). Other 2026-08-19 parameter values were also in place earlier: the V-tail minimum of 1100 us already appears in the 2026-07-10 logs. The logs (`G:\log`, all 322 SD card logs) were dated from their date folders and scanned with pyulog.

**Lifetime tally.** Time above 21 A per motor (pack current above 42 A, equal split assumed) since installation: 64.8 s in the aircraft (2026-07-26 1.6 s, 2026-08-18 9.4 s, 2026-09-02 14.1 s, 2026-09-26 39.7 s) plus 31.7 s on the RCbenchmark stand (29.1 s on 2026-09-15 with the 12x6", 2.6 s on 2026-09-10 with the 11x7"; Julian: those runs used the motors installed in the aircraft) is about 96.5 s. Peaks were 65.9 A total (about 33 A per motor) in the aircraft on 2026-09-02 and 40.0 A on the stand. Full table and limits in the failure report (`docs/engineering/test-reports/2026-09-26-bench-simulated-flight-motor-failure.md`). Which motor was on the stand is not recorded.

**Date discrepancy to resolve.** The notes and build checklist describe a "2026-08-31 brief full-throttle test" with 60 to 65 A total. The logs show 65.0 A on 2026-08-18 and 65.9 A on 2026-09-02 and nothing above 0.5 A on 2026-08-31 (two short logs). Julian to confirm which test was meant. The older text was left unchanged pending that confirmation.

**Correction: winding current, not battery current.** The replacement-motor comparison above (and PROP-11) compared battery current with each motor's rating. The rating is a winding current at full throttle, where it equals battery current; at part throttle the ESC steps the voltage down and winding current is higher than battery current, so that comparison flatters every motor and understates the overload. The stand file has no torque data and its optical RPM column is zero (correction, 2026-09-28: the electrical-speed column is usable rotor speed above about 1520 us - see the 2026-09-28 stand RPM section - so the statement that it does not fit a 14-pole motor was wrong), so the winding current was estimated from the stand's battery power with an assumed rotor speed of about 7300 rpm at 1700 us (not measured; from typical APC static coefficients): solve R x I^2 + (rpm / KV) x I = 0.95 x P for the winding current I, then scale to other motors at the same torque (I = torque x KV / 9.549). Results with the 12x6" at about 1.7 kgf (1700 us):

| Motor | Est. winding current | Against its rating | Copper heat at the same thrust, vs MN3110 KV700 |
|---|---|---|---|
| MN3110 KV700 (installed) | about 33 A | about 156% of 21 A | 1.0x |
| MN3110 KV780 | about 36 A | about 140% of 26 A (rated at about 18.5 V) | 0.96x |
| MN3510 KV700 | about 33 A | about 131% of 25 A | 0.54x |
| SunnySky X2814 KV900 | about 42 A | about 84% of 50 A (a 30 s rating) | 0.60x |
| KDE3510XF-475 | about 22 A | about 74% of 30 A | 0.53x |

The installed MN3110 at 1600 us is estimated at about 27 A (about 127% of 21 A). Sensitivity: +/-10% on the rotor speed gives 31 to 35 A for the MN3110 at 1700 us; taking the datasheet resistance as phase-to-phase gives about 30 A. The comparison between motors (copper heat at the same thrust, which depends only on the published KV and resistance) is more reliable than the absolute percentages, and manufacturers' resistance conventions and rating bases differ (180 s, 30 s, unstated). The bench is static with no airflow, the harshest case; in flight the propeller unloads and the motor is cooled. Effect on the earlier reasoning: same-motor-at-a-lower-ceiling is weaker than stated (the installed motor may still be above its rating at 1600 us on the bench), the MN3510 KV700 is less attractive (same winding current as the MN3110, but half the heat), and the KDE is better placed than recorded (its lower KV needs far less winding current for the same thrust, which also relieves the enclosed ESC). The choice is still Julian's and open (PROP-11); the measurement that settles it is the 180 s stand run at the ceiling with motor temperature logged.

**Other candidates.** T-Motor makes no MN3110 KV900 (the datasheet lists KV470, KV700 and KV780, all 3-6S and 80 g). The KV780 has 71 mOhm and 26 A / 481 W, but 481 W / 26 A works out to 18.5 V against 466 W / 21 A (22.2 V) for the KV700, so its power rating is only about 3% higher, its copper heat at the same thrust is about the same, and the ESC sees about 11% more winding current. The ArduPilot Believer airframe page (`ardupilot.org/plane/docs/airframe-believer.html`, the kit's recommended-parts list) gives 2x SunnySky 2814 KV900, 2x Hobbywing 40A ESC, APC 1260 for 6S (APC 1170 for 4S) and a 16,000 mAh 6S or 20,000 mAh 4S battery, with no current or thrust data or rationale. Reseller listings for the SunnySky X2814 KV900 (unverified): 108 g, 50 A for 30 s, 680 W, 33.6 mOhm, maximum 3-4S - so the kit page and the maker's listing disagree on 6S. The KDE3510XF-475 weighs 120 g bare and 175 g with leads as supplied, against 80 g and 99 g for the MN3110: about +76 g each (+152 g for the pair) with the supplied leads, or about +80 g for the pair if the leads are trimmed (the earlier "+40 g each" was the bare motor).

## Thrust Stand Returned; Thrust Data for Candidate Motors - 2026-09-27

Julian has returned the RCbenchmark thrust stand and no longer has access to it. The CSV logs and graphs from 2026-09-06 to 2026-09-15 (MN3110 KV700 with APC 11x7" and 12x6") are the only stand data. Any further thrust, current or temperature characterisation (a replacement MN3110 at the chosen ceiling, a U5 KV400, KDE3510XF-475 or MN3510) needs another method: a restrained in-aircraft test using the flight controller's logged pack current, a spring or luggage scale for total thrust and a thermocouple or IR reading for motor and ESC temperature, or borrowing another stand.

Julian asked for data on the thrust these motors give with the 12x6" on 6S. None found: T-Motor's U5 KV400 load-test report (`Component datasheets/tmotor-u5-kv400-motor-test-report.pdf`, 22.2 V, full throttle, T-Motor CF propellers) covers 14x4.8 (2.03 kgf, 13.7 A, 304 W, 6950 rpm, 45 C), 15x5 (2.48 kgf, 17.2 A, 6500 rpm, 50 C) and 16x5.4 (2.85 kgf, 20 A, 6250 rpm, 59 C), surface temperature after 10 minutes at 100% throttle; Tyto Robotics' database lists U5 tests with a 15x5 and an 18x6.1 (titles only seen) and one KDE3510XF-475 test with a KDE 15.5x5.3; KDE publishes performance data sheets for its own propellers. APC's static data for its 12x6E (fetched through a summarising tool, `apcprop.com/files/PER3_12x6E.dat`) gives thrust, shaft power and torque against rotor speed: 7,000 rpm 1.37 kgf / 163 W / 0.22 Nm; 8,000 rpm 1.79 kgf / 242 W / 0.29 Nm; 9,000 rpm 2.28 kgf / 344 W / 0.37 Nm; 10,000 rpm 2.83 kgf / 472 W / 0.45 Nm.

That APC data does not match the stand: APC gives 1.7 kgf at about 7,800 rpm and about 225 W at the shaft, while the stand drew 463 W into the ESC for 1.7 kgf. Either the stand's propeller is not a 12x6E, or APC's static data is optimistic, or the losses were unusually large; power conservation on the measured 463 W argues for a high winding current, so the MN3110's estimated winding current at 1700 us is now given as about 26 to 33 A (previously 31 to 35 A). Open: which exact APC 12x6 model it is, and whether the stand's optical RPM sensor was fitted (the optical RPM column is zero in every file).

Estimate for the U5 KV400 with the 12x6" on 6S (unverified; listing specifications 156 g, 42.5 x 37.5 mm, 116 mOhm, 30 A / 850 W for 180 s, 3-8S): it is speed-limited at about 7,500 to 8,300 rpm under load, so about 1.6 to 1.9 kgf at full throttle with no throttle ceiling needed, at an estimated 13 to 22 A of winding current (43 to 72% of its rating), about +76 g per motor over the MN3110 (about +152 g for the pair) and a mount rework (it is 9 mm longer and larger in diameter than the MN3110; Julian, 2026-09-28: the mounts for the U5s are now fixed). The U5 motors are already owned, having been removed on the MN3110 install; their condition and age are unknown. No choice adopted.

## BNEMAC Visit Conditions and 0.8 Thrust-to-Weight Target - 2026-09-27

Julian stated that at the 2026-07-05 BNEMAC visit the ESCs were not configured properly (the motor start desynchronisation was attributed to ESC calibration on 2026-07-10) and one propeller was mounted backwards, so the finding that the U5 v2.0 KV400 motors gave inadequate thrust is unreliable as evidence about the U5s. The 2026-07-05 flight logs (peak 20.9 A total; about 19 A total at 1800 us with the 11x7") were made under those conditions and should not be read as the U5's real capability. Claude had cited them as evidence that the U5 is speed-limited on 6S; that argument is withdrawn, and there is now no aircraft evidence either way for the U5 with a correctly configured drive.

Julian also stated that a static thrust-to-weight of about 0.8 would be acceptable. This is a working target for PROP-10 (whose pass/fail number was never set), not yet adopted formally and PROP-10's status is unchanged. At 3.8 kg all-up, 0.8 is 3.04 kgf total or 1.52 kgf per motor; with U5 motors (+152 g, 3.95 kg) it is 3.16 kgf total or 1.58 kgf per motor. Estimates against it, all unverified: the MN3110 KV700 gives 1.50 kgf at 1600 us (0.79 at 3.8 kg) and about 1.7 kgf at 1700 us (0.89), so about 1620 us or more is needed, at an estimated 27 to 29 A of winding current (over its 21 A rating on the static bench); the U5 KV400 is estimated at 1.6 to 1.9 kgf at full throttle (marginal at the low end); the KDE3510XF-475 at about 1.5 kgf at an estimated 20 A of winding current (about 67% of its 30 A rating), about +80 g if its leads are trimmed.

## Planned Payload, Design Mass and Cruise Speed - 2026-09-27

Julian: the payload to be added after the maiden flight is a Raspberry Pi 4 (with heatsink and fan), the Waveshare IMX335 USB camera and a DJI O3 Air Unit, with about 200 g of headroom held on top of that (Julian, later 2026-09-27: the 200 g headroom is a comfort margin, not a hard requirement, which keeps the U5 KV400 motors, about +150 g for the pair, in play as a candidate). The aircraft stays at 3.8 kg for the maiden unless the motors or ESCs change. Claude's rough payload estimate from typical published masses (not weighed; to be replaced by measured masses): Pi 4B about 46 g, heatsink and fan about 20 g, IMX335 camera about 20 g, O3 Air Unit about 36 g plus antennas, a 5 V regulator for the Pi, wiring, connectors and mounts about 70 g, so about 190 g (plus or minus 40 g). Design mass is then about 3.8 + 0.19 + 0.2 = 4.2 kg, 76% of the 5.5 kg MTOW. For context, REQ-AF-02 (a requirement for the new airframe, not the Believer) caps ready-to-fly mass at 4 kg including battery and camera payload.

Static thrust-to-weight with the MN3110 KV700 and the 12x6" (stand thrust per motor 1.50 kgf at 1600 us, about 1.61 at 1650 us, 1.70 at 1700 us): at 3.8 kg 0.79, 0.85 and 0.89; at 4.2 kg 0.71, 0.77 and 0.81. The maiden at 3.8 kg therefore meets Julian's working target of about 0.8 at a 1600 us ceiling, while the eventual 4.2 kg needs about 1700 us (an estimated 32 A of winding current, about 150% of the rating on the static bench) or a different motor. Claude suggested taking the motor decision as part of the payload integration; not decided.

Cruise speed: the 20 m/s Julian recalled from the Weishaeupl et al. paper is the manufacturer's recommended cruise speed (Table 1), not a calculated optimum; the paper's polar (CD0 0.0503, K 0.0764, S 0.488 m2, L/D max 8.07) gives best range at about 12.7 m/s at 4 kg, and 20 m/s costs about 44% more drag (7.0 N against 4.9 N) and about 2.3 times the aerodynamic power. Julian wants efficiency with a safety margin and says climb rate is not important. APC's 12x6E data puts zero thrust at about 29 m/s at 9,000 rpm (Ct reaches zero at J of about 0.644), so at 20 m/s the propeller runs at about 7,500 rpm near its efficient region at roughly 100 to 150 W and 6 to 11 A per motor: cruise is easy on the motors and the stress is at launch and on static ground tests. An earlier statement that a 12x6" stops producing thrust at about 19 m/s was wrong (that was the geometric pitch speed). Correction, 2026-09-28: the statement that cruise is easy on the motors holds for the MN3110 (which reaches roughly 10,000 rpm in flight) but not without qualification for the U5 KV400, which is speed-limited to about 7,500 to 8,300 rpm under load. A rough interpolation between APC's static and zero-thrust points (the full advance-ratio table could not be retrieved; interpolated linearly and quadratically, so unverified) gives thrust per motor at 4.0 kg of about 0.6 to 1.5 kgf at 13 to 15 m/s (about 2.3 to 6 times the 0.25 to 0.26 kgf per motor needed) but only about 0.3 to 0.9 kgf at 20 m/s against 0.36 kgf needed (about 0.8 to 2.5 times). Level flight at 15 m/s or below is comfortable for the U5, while 20 m/s is marginal and depends on it reaching about 8,300 rpm. No flight has yet been made with any motor, so none of this is verified. Superseded the same day: the powertrain performance model (section below) puts the U5's total thrust at 3.1 times the drag at 20 m/s (1.8 times in the worst case), so 20 m/s is not marginal.

## Powertrain Performance Model - 2026-09-28 (later)

Julian asked whether a MotoCalc-equivalent dataset could be built from the drag polar, motor characteristics, battery and propeller. Claude built a steady-state model (propeller, motor, ESC, battery and airframe) documented in `docs/engineering/analysis/powertrain-performance-model.md`, with scripts, CSV results and a figure alongside. The propeller data are APC's PER3 tables for the 12x6 variants and 11x7 variants; APC's site blocks scripted downloads, so they were taken from the `JARC99/apc-prop-analyzer` GitHub mirror and are not stored in the repo. The model was calibrated on the RCbenchmark stand data for the MN3110 (12x6" and 11x7").

Findings, all estimates and unverified in flight (superseded by the next section, which recalibrates the model for the confirmed 12x6E propeller):
- **Stand propeller:** the stand data fit the standard APC 12x6 (sport) within about 2 to 4% and the 12x6SF within about 2%, while the 12x6E over-predicts thrust by about 14%, so the propeller on the stand is very probably not the thin-electric variant. This resolves the earlier mismatch with APC's 12x6E data (about 225 W at the shaft for 1.7 kgf against 463 W measured). Julian to confirm which model he uses.
- **MN3110 winding current:** at the stand points the model gives 25.0 A (119% of 21 A) at 1.5 kgf (1600 us) and 29.9 A (143%) at 1.7 kgf (1700 us), and the 21 A rating is reached at about 1.33 kgf (about 1535 us; static thrust-to-weight 0.70 at 3.8 kg). These refine and supersede the earlier estimates of about 27 A and 33 A.
- **U5 KV400:** static thrust about 1.90 kgf per motor at full throttle at 20 A (67% of its 30 A rating), thrust-to-weight 0.96 at 3.95 kg and 0.92 at 4.14 kg; in the worst case (pack at 22.2 V and effective KV 10% low) 1.51 kgf and 0.76 / 0.73. In flight its total thrust is 5.5 times the drag at 15 m/s and 3.1 times at 20 m/s (1.8 times at 20 m/s in the worst case). KDE3510XF-475: about 2.2 kgf at 30 A.
- **Cruise:** about 130 W from the pack at 15 m/s and 213 to 225 W at 20 m/s for all the motors (within 6% of each other), so motor choice does not change cruise efficiency materially; the earlier 280 to 300 W estimate at 20 m/s was too high. Best range is at 13.5 m/s (about 89 to 92 km on 215 Wh usable, an assumed capacity); 20 m/s costs about 65 to 70% more power and 19 to 22% of the range.
- **Limits:** calibrated on static data only and to about 33 A winding current; motor specifications for the U5, KDE, MN3510 and X2814 are listing values; thermal state and payload power are not modelled. No motor choice adopted.

## Stand RPM Channel - 2026-09-28 (later)

Julian said he doubts he can provide RPM from the next stand test. Checking the existing MN3110 stand files showed that the `Motor Electrical Speed (RPM)` column is in fact usable rotor speed above about 1520 us: it matches the speed implied by the measured thrust and APC's static thrust coefficient to within about 2% for the APC 11x7" and 6 to 9% for the 12x6", while below about 1500 us it reads spurious values of 12,000 to 17,000. The optical column is zero in every file. Claude had earlier stated, wrongly, that this column did not fit a 14-pole motor (that came from those spurious low-throttle values, which include the file maxima of about 23,000); the statement is corrected in the section it appeared in. Consequences: the U5 test should record the same channel again (same phase-wire sensing and pole setting), and without any RPM the speed can be inferred from thrust (thrust is proportional to the square of rotor speed) to within roughly 5 to 10%. Against the stand's rotor speed the powertrain model predicts speed 4% low (11x7") and 8% low (12x6") for the sport propellers (`docs/engineering/analysis/powertrain-performance-model.md`, section 4; superseded by the next section).

## Stand Propeller Confirmed as 12x6E; Model Recalibrated - 2026-09-28 (later)

Julian sent a photo of the stand propeller, marked "12X6E", and confirmed the stand tests used the APC 12x6E (thin electric). The earlier model runs had assumed the sport 12x6 because, at the measured electrical power, the thin-electric tables over-predicted thrust by about 14%; that reading was wrong. The discrepancy is a real propeller that takes more power than its published table.

The model was recalibrated with the stand's rotor-speed channel (valid above about 1520 us). At the measured speed the measured thrust is 0.99 times the table's static thrust, and the measured bus current is reproduced to 1.4% rms with the power coefficient scaled by 1.22 (1.14 to 1.32 across the assumed KV factor and extra resistance). This supersedes the earlier model findings. Corrected figures, all estimates and unverified in flight:
- **MN3110:** winding current 24.0 A (114% of 21 A) at 1.5 kgf (1600 us) and 28.6 A (136%) at 1.7 kgf (1700 us); the rating is reached at 1.35 kgf (about 1545 us; static thrust-to-weight 0.71 at 3.8 kg).
- **U5 KV400:** static thrust 1.80 kgf per motor at full throttle at 17.8 A (59% of its rating); thrust-to-weight 0.91 at 3.95 kg and 0.87 at 4.14 kg; total thrust 2.89 kgf at 10 m/s (thrust-to-weight 0.73), 2.36 kgf at 15 m/s (4.6 times the drag) and 1.75 kgf at 20 m/s (2.5 times). In the worst case (pack at 22.2 V and effective KV 10% low): 1.39 kgf static (0.70 and 0.67), 2.07 kgf at 10 m/s (0.53) and 0.97 kgf at 20 m/s (1.4 times). KDE3510XF-475: 2.12 kgf at 26.7 A.
- **Hand launch:** the earlier statement that the U5's worst case at 10 m/s is 0.62 is superseded: it is 0.53, against 0.73 in the base case and 0.62 with either the low pack voltage or the low KV alone. The 0.5 to 0.6 rule of thumb is cleared in every case except the stacked worst case at 10 m/s, and the static worst case (0.70) still clears it.
- **Cruise:** 159 to 165 W from the pack at 15 m/s and 266 to 286 W at 20 m/s with the stand's power factor applied at all airspeeds, or 131 to 134 W and 218 to 229 W with the published tables unscaled; the true value is probably between. The calibrated figure at 20 m/s is close to the earlier hand estimate of 280 to 300 W. Best range is at 13.0 to 13.5 m/s (72 to 74 km calibrated, 87 to 92 km unscaled, on the assumed 215 Wh) and the motors differ by less than 8%.

The write-up, figure, scripts and CSV results in `docs/engineering/analysis/` were regenerated, and the stand report now records the propeller as the 12x6E. No motor choice adopted.

Julian then filed the invoice for the 12x6 propellers (`docs/project/purchase-history/invoices/gemfan-apc-nylon-12x6-propellers-2026-09-06.pdf`): Alibaba notice B1020260906048362 of 2026-09-06 from Dong Mu High Quality Store, a 2-piece "Gemfan Apc Nylon Propeller" pack, 51.96 CNY including delivery and GST, $10.56 AUD as charged (Julian, personal funds). Gemfan sells APC-pattern propellers, so the stand propeller may be a copy of the APC 12x6E rather than a genuine APC part; the photo shows only the "12X6E" marking. That would fit the finding that it takes about 22% more power than APC's table and adds uncertainty to the in-flight predictions, which use APC's tables. The purchase history was updated (Julian's personal total is now $262.89 AUD).

## U5 KV400 Bench Test - 2026-09-30

Julian re-borrowed the thrust stand and ran the U5 KV400 with the 12x6E through two sweeps (report: `docs/engineering/test-reports/2026-09-30-u5-kv400-thrust-stand-characterisation.md`). Full-throttle static thrust was 1.84 to 1.94 kgf at 14.0 to 14.7 A (47 to 49% of the 30 A rating), well under the roughly 500 W level that had cut out the earlier MN3110 12x6E runs. The rotor-speed channel cross-checked against thrust to within about 1 to 4%, as it had for the MN3110.

Calibrating the powertrain model on this data (thrust factor 0.98, power factor 1.01, bus current within 2.8% rms - `docs/engineering/analysis/powertrain-model/calibrate_u5.py`) gives, at 24.0 V: static thrust-to-weight 0.95 at 3.95 kg (0.90 at the 4.14 kg design mass); total in-flight thrust 4.8 to 5.0 times the drag at 15 m/s and 2.6 to 2.7 times at 20 m/s; cruise power about 132 W at 15 m/s and 222 W at 20 m/s, at 14 to 19% of the rated current. This supersedes the earlier unmeasured U5 estimates in `docs/engineering/analysis/powertrain-performance-model.md` and the sensitivity figures quoted to Julian in conversation (for example the "worst case, 0.53 at 10 m/s" figure, which used an assumed 10%-low effective KV that the measured data does not support for this motor).

A notable finding: the power factor fitted for the U5 (1.01) differs sharply from the MN3110's own 12x6E run (1.22), even though both are nominally the same propeller model. This is most likely unit-to-unit variation in what appears to be a copied propeller (see the 2026-09-28 invoice section above), not a property of the 12x6E pattern; it could also be error in the assumed motor parameters for one or both motors, which cannot be separated from static data. Consequence: the U5's usable thrust in flight is capped by its speed limit, not its current rating - it never approaches 30 A even at full throttle - while the MN3110 is current-limited throughout. At every current level measured, the U5 gives more thrust than the MN3110 on the same propeller, consistent with its lower KV giving more torque per amp.

This was an initial sweep, not the sustained-duration, temperature-logged run PROP-11 asks for, and the U5 units' condition has not been checked. Figures added: `docs/assets/u5-thrust-vs-esc-signal.png`, `u5-current-vs-esc-signal.png`, `u5-vs-mn3110-thrust-vs-current.png`. The main powertrain-model figure and PROP-11's background were updated to use this calibration for the U5 while keeping the MN3110-derived calibration for the other, unmeasured candidates.

## U5 Sustained Run and Motor Decision - 2026-09-30 (later)

Julian ran the U5 KV400 with the 12x6E at full throttle for 483 s on the ESC removed from the failed left drive (the "suspect ESC"), to check that ESC's own condition. Full throttle was held for 393 s cumulative (up to 105 s per stretch), across four throttle-down/restart cycles for hand-touch temperature checks; current stayed flat at 15.8 to 16.9 A (mean 16.2 A, about 54% of the 30 A rating) with no fault, dropout, or cutout at any point, including through the restarts. Julian reports the motor was only slightly warm by hand at each check. Figure: `docs/assets/u5-esc-sustained-full-throttle.png`.

**Julian's decision:** satisfied the suspect ESC is not damaged, and will install the U5 KV400 motors together with the AIR 40A ESCs (including this one) in the aircraft, resolving PROP-11's motor and ESC choice. This is a decision on the evidence gathered so far, not a claim every PROP-11 acceptance criterion is met: temperature has only been checked by hand, not logged with an instrument (Julian still plans a thermal-camera run), the electrical condition checks (insulation, winding-resistance balance) have not been done, the right motor and its ESC have not been stand tested, and no in-aircraft or flight measurement exists yet. `docs/project/build-checklist.md` PROP-11 updated to In progress with the decision recorded and the satisfied/open parts of each acceptance criterion noted; `context/open-items.md` updated to reflect what remains.

## PROP-11 Closed on Julian's Judgement - 2026-09-30 (later)

Julian: "I think that is about as formal as I want to make it to be honest, I dont think there is any reason to suspect the u5 are damaged or are at risk of overheating. I am happy to close this one." PROP-11 is closed on this basis - the thrust-stand characterisation and the 483 s sustained full-throttle run on the suspect ESC, both 2026-09-30 - rather than on the task's originally-scoped instrumented temperature log and formal electrical condition checks (insulation to the case, winding-resistance balance), which Julian has decided not to pursue. `docs/project/build-checklist.md` updated: the dashboard row and the PROP-11 section removed, and a closed summary added under Completed Work (Propulsion). `context/open-items.md` and `context/project-overview.md` updated to match - the remaining open item is the physical installation of the U5 motors and AIR 40A ESCs in the aircraft, not further testing.

## PROP-08 Revisited After the Motor Swap - 2026-10-02

The U5 KV400 physical swap is done (per Julian). He proposed raising `PWM_MAIN_MAX4`/`MAX6` back to 2000us and closing PROP-08 on that basis, since the U5 has large current margin on the 12x6" propeller (2026-09-30 stand data: 15.8 to 16.9 A at full throttle, about 54 to 56% of its 30A rating) - unlike the MN3110, which this task's ceiling was originally there to protect. Claude flagged that this reasoning only holds once the U5s are actually installed (raising the ceiling while the MN3110s were still fitted would recreate the 2026-09-26 overcurrent failure) and asked about in-aircraft verification.

Julian confirmed the swap is physically done, that `PWM_MAIN_MAX4`/`MAX6` has not yet been set to 2000 (he will do so shortly, pending a parameter export to confirm), and that he plans only a quick bench spin-up check with the U5s installed, not a full sustained in-aircraft current/temperature run. `docs/project/build-checklist.md` PROP-08 updated to reflect this: status to In progress, the ceiling change recorded as planned but not yet applied, and the acceptance criteria text revised to say the sustained-current criterion rests on the 2026-09-30 stand test (on the stand's own ESC, not the aircraft's) plus the planned quick check, not a fresh sustained in-aircraft test - following the same pattern as PROP-11's closure, naming the evidence gap rather than hiding it. Not yet closed - awaiting the parameter export and the bench spin-up.

## PROP-08 Parameters Confirmed; Ground Test Clean - 2026-10-02 (later)

Julian pointed to the latest SD card log (`G:\log\2026-10-02`), describing it as a quick ground test of the two motors. Claude pulled it: one boot (~02:21 UTC) with two brief arms (no throttle) followed by a 41 s run with two throttle ramps to full stick. The log's embedded parameters confirm `PWM_MAIN_MAX4`/`MAX6` = 2000 and `WEIGHT_BASE`/`WEIGHT_GROSS` = 4.0 (both now applied, taking the log itself as the verifying artifact in place of a separate export - 4.0 matches the calculated +190g estimate rounded to the nearest 0.1 kg; whether Julian used that figure directly or weighed the installed pair is not confirmed). Full-throttle current was 29.4 to 30.9 A total (about 15.5 A per motor if shared equally), close to the thrust-stand figures and well under the U5's 30 A rating; `MAIN4`/`MAIN6` commands were identical throughout; the 5 V rail, power-rail valid flags, IMU vibration metrics, and PX4's `failure_detector_status` all read clean for the whole log. Report: `docs/engineering/test-reports/2026-10-02-u5-first-ground-test.md`, figure `docs/assets/u5-first-ground-test-2026-10-02.png`.

This is the quick spin-up check Julian had planned, so PROP-08's acceptance criteria are now met on the basis already agreed (the 2026-09-30 stand's sustained run plus this quick in-aircraft check, not a fresh sustained in-aircraft test). `docs/project/build-checklist.md` PROP-08 updated with the confirmed result; `context/open-items.md` updated to remove the now-resolved PWM and WEIGHT_BASE items and to flag the 2026-09-26 proposed-parameters snapshot as superseded on those two parameters. Not formally closed by Claude - as with PROP-11, that is Julian's call to make.

## Parameter Backup Refreshed; Secondary GPS Never Logged - 2026-10-02 (later)

Julian: the planned mass estimate (+190g) is good enough without weighing the installed pair ("the motors will be close to the weight on the tin"), and asked for the parameter backup to be updated from the SD card, and whether a lack of GPS data from "the M10" matches the logs.

**Parameter backup.** Regenerated `believer-parameters.params` from the embedded parameter set in the 2026-10-02 ground-test log (`02_23_32.ulg`) rather than a fresh QGroundControl export - the same 1214 parameters as the last export (2026-09-02), no additions or removals. Meaningful changes beyond routine sensor-bias drift: `PWM_MAIN_MAX4`/`MAX6` 1800 to 2000, `WEIGHT_BASE`/`WEIGHT_GROSS` -1 to 4.0 (jumping over the intermediate 3.8 value, since no export was taken at that point), `BAT1_V_EMPTY` 3.6 to 3.2, `COM_DISARM_LAND` 2 to -1 - the last two were decided on 2026-09-26 but never previously captured in the backup artifact. Updated `docs/operations/Pixhawk Parameter Backup/parameter-change-log.md` to match, adding rows for `WEIGHT_BASE`/`WEIGHT_GROSS` and `COM_DISARM_LAND` that had never been added, and correcting the stale `BAT1_N_CELLS` note that still described `BAT1_V_EMPTY` as an unreviewed LiPo default. Also noted: the magnetometer soft-iron calibration terms (scale and off-diagonal) differ enough from the 2026-09-02 export to suggest a recalibration happened since then - not confirmed with Julian, possibly prompted by the motor swap changing the magnetic environment near the compass.

**Secondary GPS.** Checked every flight log from the 2026-08-19 GPS install through 2026-10-02 (including every log from 2026-09-02 itself): GPS driver instance 1 (the ZED-F9P, device ID 11141181) has a good 3D fix with up to 29 satellites in every one. GPS driver instance 2 (the M8N, per `GPS_2_CONFIG` = 201/physical GPS1 port) has never logged a single `sensor_gps` sample in any of them. This directly contradicts NAV-05's 2026-09-02 closure note, "both receivers confirmed achieving a lock" - there is no log evidence that claim was ever true. Corrected the Completed Work bullets for NAV-05 and the M8N configuration in `docs/project/build-checklist.md`, and opened NAV-06 to diagnose the fault (wiring, power, baud, or a swap test to see whether the fault follows the port or the module). GPS parameter values themselves are unchanged between the 2026-09-02 and 2026-10-02 exports, so this looks like a wiring or hardware issue rather than a configuration regression - and, since it was never seen working in any log, possibly present from the original 2026-08-19 install rather than a new fault.

Julian referred to the affected receiver as "the M10"; the project's records are for a NEO-M8N, and this has not been reconciled - flagged as an open question in NAV-06 and `context/open-items.md` rather than assumed either way.

## Compass Recalibration Confirmed; M8N Parameter Review - 2026-10-02 (later)

Julian confirmed he recalibrated the compass and some other sensors between the 2026-09-02 and 2026-10-02 exports (exact date and full scope beyond the magnetometer not given) - this is the source of the magnetometer soft-iron shift noted above, not an unexplained drift as first flagged. `docs/operations/Pixhawk Parameter Backup/parameter-change-log.md`'s calibration section updated to state this as confirmed rather than inferred. He also confirmed the GPS in question is the M8N, not a different M10 module.

Julian then asked whether the M8N's parameters could be wrong. Checked every GPS parameter relevant to it against PX4's documentation: `GPS_2_CONFIG` (201, physical GPS1 port) and `GPS_2_PROTOCOL` (1, u-blox) match the documented 2026-09-02 port/protocol assignment and are unchanged; `SER_GPS1_BAUD` = 0 is auto-detect, the normal default, not a fixed/mismatched rate; `GPS_UBX_BAUD2` = 230400 (PX4's own default) only configures the ZED-F9P's second UART for RTCM relay and does not apply to the M8N at all - this was Claude's leading hypothesis before checking PX4's docs, and it does not hold up; `GPS_2_GNSS` = 29 against `GPS_1_GNSS` = 31 for the ZED-F9P reads as a deliberate, sensible reduction for the M8N's lower concurrent-GNSS capability rather than a mistake. All of these are unchanged since the 2026-09-02 export. Nothing found suggests a parameter-level misconfiguration; combined with the symptom being total silence rather than a degraded fix, this points toward a physical, wiring, or power problem rather than a software one. Recorded in NAV-06 (`docs/project/build-checklist.md`) with a recommended first diagnostic step: connect the M8N directly to a computer via u-blox u-center, bypassing the Pixhawk, to test the module and its wiring in isolation.

## GPS Timeline Corrected - Julian Was Right - 2026-10-02 (later)

Julian pushed back on the NAV-06 finding: "I swear it has worked in the past, I have definitely seen dual gps mavlink messages." Claude's first pass had only scanned logs from 2026-08-19 onward and wrongly implied the M8N might never have worked. A full scan of all 326 logs on the SD card (not just the 2026-08-19-onward window) found Julian was right, and the real picture is more specific and more useful than "it's never worked":

- **2026-06-02 to 2026-07-03:** both GPS instances logging. Instance 1 (device ID 11010053) is the M8N, getting real fixes up to 13 satellites. Instance 2 (device ID 11141181) is the ZED-F9P, present but fixless (0 satellites, no antenna yet).
- **2026-07-04:** `GPS_2_CONFIG` deliberately set to 0 (Disabled), per the project's own changelog from that date - "ZED-F9P port disabled until antenna and mount are installed." Not a fault; explains the apparent loss of the second stream from this date. The M8N continues alone as instance 1.
- **2026-08-19:** M8N (instance 1) still alive and logging (no fix in these particular logs, consistent with bench testing indoors).
- **2026-08-31 (not 2026-09-02 as the parameter backup's narrative has it - the earliest post-swap log found is timestamped 2026-08-31 09:40 UTC):** the GPS instance swap was made, following the ZED-F9P's mount and antenna installation (NAV-03/04, 2026-08-28). From this log onward the ZED-F9P (now instance 1) works perfectly, and the M8N (now instance 2) has never logged a single sample - not in this first log, not in any log since, through 2026-10-02.

So the fault is real, but it dates specifically to the instance-swap change (or physical work around the same session), not to the original install, and the M8N is confirmed to have worked correctly before that point - exactly matching what Julian remembered. `docs/project/build-checklist.md` NAV-06 and the two Completed Work GPS bullets rewritten with this corrected timeline; `context/open-items.md` updated to match. The parameter-level review from earlier today still stands (nothing found wrong in the current, post-swap configuration), so the leading hypotheses are a physical disturbance during that session, or a PX4 driver quirk specific to assigning this module to instance 2 rather than instance 1 - both still to be tested.

## GPS_2_GNSS Likely Cause Found - 2026-10-02 (later)

Julian reported the M8N's LED and buzzer are active - it has power and is running internally, which rules out a dead or unpowered module and points toward the data link to the Pixhawk (the UART wiring/connector) rather than the module itself.

Julian then asked for the M8N's parameters from when it last worked as GPS1, meaning to try reverting them while keeping it on the GPS2 slot. Comparing its values from 2026-07-03 (as `GPS_1_*`, confirmed working) against now (as `GPS_2_*`): `GPS_1_CONFIG` 201 then / `GPS_2_CONFIG` 201 now (same); `GPS_1_PROTOCOL` 1 then / `GPS_2_PROTOCOL` 1 now (same); `GPS_1_GNSS` **0** then / `GPS_2_GNSS` **29** now - the one difference. 29 is not a value ever tested against the M8N - it is exactly the ZED-F9P's own old `GPS_2_GNSS` value from before the 2026-08-31 swap, which appears to have carried over by slot position rather than being chosen for whichever module ended up there. The M8N ran with GNSS requests effectively off (0) for its entire confirmed-working history and has never been tested with an active constellation request. If 29 asks for a combination this module's firmware cannot satisfy, that would fit a module that still runs its own receiver and LED but never completes the handshake PX4 needs to start publishing `sensor_gps`.

Recorded as the leading, testable hypothesis in NAV-06 (`docs/project/build-checklist.md`) and the `GPS_2_GNSS` row in `parameter-change-log.md`: Julian is reverting `GPS_2_GNSS` to 0 while keeping the module on the GPS2 slot, as he prefers. Not yet confirmed either way.

## NAV-06 Confirmed Fixed - 2026-10-02 (later)

Julian set `GPS_2_GNSS` to 0 (deselecting every constellation checkbox in QGroundControl) and confirmed it fixed the M8N. Checked the next logs on the SD card (`G:\log\2026-10-02`, boot after 04:00 UTC): `04_02_14.ulg` still shows the old `GPS_2_GNSS` = 29 with only the ZED-F9P logging; from `04_09_00.ulg` onward `GPS_2_GNSS` = 0 and the M8N (instance 2, device ID 11010053) logs a solid 3D fix with up to 15 satellites - its best recorded fix count ever, better than the up-to-13 it achieved before the 2026-08-31 swap. NAV-06 closed in `docs/project/build-checklist.md` (moved to Completed Work with the full diagnosis); the matching open item removed from `context/open-items.md`.

While closing it out, found and fixed a pre-existing formatting bug in `docs/project/build-checklist.md`: an orphaned extra `</details>` tag just after NAV-06's own background section, left over from an earlier edit this session, with no matching `<details>` - removed along with the rest of the now-closed NAV-06 block.

Regenerated `believer-parameters.params` from the confirmed-fixed log (`04_09_42.ulg`) and updated `parameter-change-log.md`'s `GPS_2_GNSS` row and the calibration tables (routine accelerometer/gyroscope/barometer/magnetometer drift, `COM_FLIGHT_UUID` incremented - nothing else of note changed).

## Pre-Maiden Parameter Review - 2026-10-02

Julian asked for the latest logs to be checked (NAV-06 confirmation, above), the parameter backup refreshed, and then for all current parameters to be inspected and flagged for anything worth changing before the maiden flight. Reviewed all 1214 parameters from the refreshed backup (`04_09_42.ulg`) by safety-relevant category: battery/low-power failsafes, RC/data-link loss failsafes, geofence, EKF estimator requirements, arming checks, flight-termination circuit breakers, and airspeed envelope.

Two findings worth changing before the maiden, both now tracked as checklist tasks: `COM_LOW_BAT_ACT` = 0 (Warning only, no automatic action on low charge - PWR-04) and `GF_MAX_HOR_DIST` = 0.0 (no horizontal geofence boundary, vertical-only protection - NAV-07). `COM_ARM_BAT_MIN` = -1 (no arm-time minimum charge check) is a related new finding, folded into PWR-04 pending the still-incomplete capacity test.

One finding flagged for explicit confirmation rather than a clear recommendation: `NAV_DLL_ACT` = 0 (data-link-loss failsafe disabled). This aircraft's RC architecture is unusual - RC commands arrive via the Radiomaster DBR4 (ELRS) as MAVLink `RC_CHANNELS_OVERRIDE` on TELEM1, a separate link from GCS telemetry via the RFD900x on TELEM2 - so losing the GCS link would not necessarily mean losing RC control, unlike a conventional single-link setup. Plausibly fine, but not asserted as correct without Julian's confirmation it's intentional.

Several parameters that looked suspicious on inspection were checked against PX4's documentation and confirmed to be its own stock defaults, not project misconfigurations: `CBRK_FLIGHTTERM` = 121212, `CBRK_IO_SAFETY` = 22027, and `CBRK_USB_CHK` = 197848 (all documented "magic number" circuit-breaker values). Already-tracked items were reaffirmed rather than re-flagged as new: `BAT1_CAPACITY` = -1 (pending the capacity test), `FW_AIRSPD_STALL`/`MIN`/`TRIM`/`MAX` (conservative, pending in-flight stall verification), `COM_DISARM_LAND` = -1 (deliberate maiden-specific decision), and `BAT1_R_INTERNAL` = -1 (PX4's real-time estimate, fine as is).

## RC and Data-Link Loss Failsafe Decision - 2026-10-02

Following the pre-maiden parameter review (above), Julian decided: a loss of RC or a loss of the data link should both cause the aircraft to return to the home position and hold there (not land automatically).

Checked PX4's Return Mode documentation to confirm the existing configuration already does this for RC loss and would do the same for data-link loss once changed: `NAV_RCL_ACT` and `NAV_DLL_ACT` share the same action enum (0 Disabled, 1 Hold, 2 Return, 3 Land, ...; "Return" engages Return mode in both cases). `RTL_LAND_DELAY` = -1 makes Return mode loiter indefinitely at `RTL_DESCEND_ALT` rather than landing automatically after arrival - this is the "hold position" behaviour, and auto-land is deliberately not configured yet (`docs/project/project-roadmap.md`). `RTL_TYPE` = 1 prioritises a mission landing pattern or rally point over home, but falls back to home when neither is defined - confirmed against `docs/engineering/flight-modes.md` that neither is currently defined on this aircraft, so Return does resolve to the home position as intended.

`NAV_RCL_ACT` is already 2 (Return) - no change needed for RC loss. `NAV_DLL_ACT` is 0 (Disabled) - needs to change to 2 (Return) to match. Added as RF-06 in `docs/project/build-checklist.md` (Critical, flight clearance). Flagged in `docs/engineering/flight-modes.md` Section 5 as pending, not yet applied to the live parameter - will be confirmed via a parameter export once Julian makes the change, per this project's standing rule to verify configuration claims against exports rather than accept them as applied on description alone.

## Maiden Flight Test Plan - Initial Draft, 2026-10-02

Julian described the flight test campaign structure: every flight is an assisted hand launch; Flight 1 is airworthiness-only, launching and landing in Acro mode with a brief in-flight Manual-mode check at a safe altitude (no stall, Stabilized, Position Hold, or Return testing that flight); later flights cover stall speed/behaviour, climb performance and thrust sufficiency, glide performance, Acro, Stabilized, Position Hold, and Return to Home.

Drafted `docs/operations/maiden-flight-test-plan.md` (FTP-BELIEVER-001, Rev 0.1) to capture this. Flight 1's launch mode (Acro) differs from `docs/engineering/flight-modes.md` Section 3's general guidance that Stabilized is "Hand-launch mode" - rather than hardcode one or the other, reworded `docs/operations/manual.md`'s launch-mode steps (41, 46) to defer to "the launch mode specified in the current flight test plan," since the campaign deliberately uses different modes across flights.

Answered Julian's question on position-hold radius: `NAV_LOITER_RAD` = 80 m governs Hold/Position-Hold mode's loiter circle; `RTL_LOITER_RAD` = 80 m is the separate parameter for the loiter circle at the Return (home) destination - currently the same value but independently configurable. `NAV_MIN_LTR_ALT` = -1 is PX4's own default (disabled), confirmed via PX4's documentation, not a project misconfiguration.

Several open items flagged in the new plan's Section 6 (wind limits, abort criteria, safe altitudes per test, flight grouping/order, test site layout) - none of these existed anywhere in the project before this draft. Cross-referenced the plan from CTL-02 (`docs/project/build-checklist.md`), whose "initial test flights" language now points to this document's flight sequencing.

## Loiter Radius and Minimum Loiter Altitude - NAV-08, 2026-10-02

Julian asked whether `NAV_LOITER_RAD`/`RTL_LOITER_RAD` (both 80 m) should be tightened (proposed 50 m) and whether `NAV_MIN_LTR_ALT` is measured above ground or AMSL, proposing 40 m provisionally with a pre-flight site-survey step to confirm nothing in the flight test area exceeds it. He also confirmed the maiden flight test site: BNEMAC field, Fitzgibbon, approximately 300 m radius.

Checked `NAV_MIN_LTR_ALT`'s altitude reference against PX4's own source parameter description (`navigator_params.yaml`, both the current and a prior wording), not just the user-guide prose, which does not state the datum: "Altitude above Home used when Hold mode is entered without an altitude." So it is relative to the home/launch point's recorded altitude, not raw AMSL and not strictly terrain-following AGL - for a flat field like BNEMAC this is not expected to matter, but would on sloped terrain.

Checked 50 m for bank-angle and stall-margin safety before agreeing it was a reasonable tightening: PX4 flies the Hold/Return loiter at `FW_AIRSPD_TRIM` (20 m/s); a 50 m radius at that speed needs about 39 degrees of bank (R = V^2/(g*tan(bank))), comfortably under the configured `FW_R_LIM` ceiling of 50 degrees, and the resulting in-turn stall speed (load factor 1/cos(39 deg) = 1.29, so about 12.5 m/s) stays well under `FW_AIRSPD_MIN` (15 m/s). The current 80 m radius needs about 27 degrees for comparison. Both radii sit comfortably inside the BNEMAC field's 300 m radius either way - the tightening is for a smaller, easier-to-observe circle, not containment (that remains `GF_MAX_HOR_DIST`, NAV-07).

Added NAV-08 (`docs/project/build-checklist.md`) to track applying all three parameters plus the new site-survey checklist step. Updated `docs/engineering/flight-modes.md` (Rev 1.13-1.14) and `docs/operations/maiden-flight-test-plan.md` (Rev 0.2, also recording the confirmed test site) to flag the pending values. Not yet applied to the physical FC.

## Parameter Export Confirms RF-06/PWR-04/NAV-08; Maiden Mission Uploaded - 2026-10-02

Julian confirmed option 1 for NAV-07 (rely on a polygon geofence matching the BNEMAC field's actual boundary, leave `GF_MAX_HOR_DIST` at 0/disabled rather than set a numeric cylinder radius), provided a fresh QGroundControl parameter export (`param backup.params`, moved into `docs/operations/Pixhawk Parameter Backup/believer-parameters.params`), and uploaded a test mission with that polygon fence (`maiden mission.plan`, moved into the new `docs/operations/Pixhawk Mission Backup/`).

**Parameter export diff** (against the previous backup, full diff of all 1214 parameters, not just the expected ones): 11 changes. Routine calibration drift (`CAL_BARO0_OFF`, `CAL_GYRO2_X/Y/ZOFF`) and `COM_FLIGHT_UUID` increment as usual. Confirmed applied as expected: `COM_LOW_BAT_ACT` (0 to 3, PWR-04), `NAV_DLL_ACT` (0 to 2, RF-06), `NAV_LOITER_RAD`/`RTL_LOITER_RAD` (80 to 50, NAV-08), `NAV_MIN_LTR_ALT` (-1 to 40, NAV-08). One unplanned change: `RTL_TYPE` (1 to 0) - not something discussed, investigated rather than ignored.

**`RTL_TYPE` finding:** the uploaded mission has no landing pattern (no `DO_LAND_START`/`NAV_LAND` sequence) and no rally points. `MIS_TKO_LAND_REQ` = 2 (PX4's fixed-wing default) requires a mission to contain a landing pattern - but checked against a PX4 forum report of the identical symptom, this requirement is specifically enforced when `RTL_TYPE` might need to use that pattern (`RTL_TYPE` 1 and above). `RTL_TYPE` = 0 never relies on a mission landing pattern, which is the documented community fix for exactly this situation - "Mission rejected: landing pattern required" otherwise. Concluded this explains the otherwise-unplanned change rather than being a mistake; behaviourally it makes no difference for this mission/field, since with no rally points or landing pattern defined, `RTL_TYPE` = 1 would have fallen back to home anyway (per PX4's own documented fallback logic) - `RTL_TYPE` = 0 just reaches the same place more directly, and without needing the mission to carry a pattern that would never be used operationally (this project has no autoland capability configured). Not yet confirmed by an actual re-upload/acceptance test on this aircraft - flagged as an open item.

**Mission validity check:** read `maiden-mission.plan` directly (JSON) and verified programmatically - all 32 items (1 `NAV_TAKEOFF` + 31 `NAV_WAYPOINT`, all at 40 m relative altitude) and the home position fall inside the uploaded 10-vertex polygon. Confirmed via PX4's documented behaviour that engaging Mission mode while already airborne (the only way this mission will be flown, per the test plan) causes the takeoff item to be treated as a normal waypoint rather than an autonomous takeoff attempt. With no landing/RTL/loiter-unlimited item after the last waypoint, the mission ends by entering Hold (loiter) behaviour at that position - documented in `docs/engineering/flight-modes.md` Section 4.7.

Updated `docs/project/build-checklist.md` (closed PWR-04, RF-06, NAV-07, NAV-08, moved into Completed Work; added auto-tune to CTL-02's scope per Julian), `docs/engineering/flight-modes.md` (Rev 1.16, removed "pending" language, documented `RTL_TYPE` and the mission), `docs/operations/Pixhawk Parameter Backup/parameter-change-log.md` (new RC/data-link/loiter section, updated battery/geofence sections, refreshed calibration values), `docs/operations/manual.md` (`RTL_TYPE` check corrected to 0, geofence check reworded for the polygon, new battery-chemistry-parameter check per Julian - now 53 steps), and `docs/operations/maiden-flight-test-plan.md` (Rev 0.3 - restructured into a single-flight, ordered-phase profile per Julian's "as many tests as possible in one flight" instruction, added PID auto-tune and Mission mode phases, new Section 4 detailing the mission).

## MATLAB Analysis Files Copied Into the Repo - 2026-10-03

Julian asked for the MATLAB scripts, motor-testing CSVs, and resulting plots to be copied from his OneDrive MATLAB folder (`C:\Users\Metabox\OneDrive\University\MATLAB\QUTAS\Believer`) into the repo, under `docs/engineering/analysis/`. Copied the full tree verbatim (23 files, about 7 MB): `believer_performance_model.m` at the top level, and the `Motor Testing/` folder (its own two `.m` plotting scripts, four top-level comparison PNGs, and the `MN3110_11_7`/`MN3110_12_6` subfolders with their raw RCbenchmark CSV logs and PNGs). Verified byte-for-byte against the source afterward.

This resolves the "raw CSV logs and MATLAB scripts are outside the repo" caveat that `context/open-items.md` and `docs/engineering/test-reports/2026-09-15-mn3110-thrust-stand-characterisation.md` had carried since that test was first written up - updated both to point at the new in-repo location, leaving only the still-unrecorded ESC/supply-type detail open.

Noted but not resolved: four of the newly-copied top-level PNGs (`Current vs ESC Signal.png`, `Efficiency vs ESC Signal.png`, `Thrust vs Current.png`, `Thrust vs ESC Signal.png`) are byte-identical duplicates of images already in `docs/assets/` under `mn3110-*.png` names, copied in during an earlier session. Left both copies in place - `docs/assets/` is what the test report's prose actually references, while `docs/engineering/analysis/Motor Testing/` is now a complete, faithful mirror of Julian's working folder - but flagging the duplication so it isn't mistaken for drift later.

## Switch Diagrams Actually Fixed - 2026-10-10

Julian asked for the annotated GX12 radio diagrams to be updated. Every earlier note on this (CHANGELOG, project-notes, open-items, build-checklist CTL-04) said this needed to be done manually, since Claude was assumed to have no image-editing capability. That assumption turned out to be wrong in this environment - Python with Pillow (PIL) is available via the Bash tool here, so the diagrams were fixed directly rather than just flagged again.

Method: measured exact pixel bounds of each label box programmatically (box borders are clean black rectangles, detected via row/column darkness scans), matched the existing font (Arial/Arial Bold) and sizing by test-rendering a box's own unchanged text over itself and comparing, then redrew only the stale label boxes - white-filled interior, new centred text, border and photo untouched. Verified against a full-image render before overwriting the real files.

Fixed both images: `docs/assets/gx12-front-switches.png` (GR1 labels SW2-SW6 corrected to Acro/Stabilized/Altitude/Position/Mission, matching `docs/engineering/ICD.md`'s table - this was the staleness found 2026-10-03) and `docs/assets/gx12-top-switches.png` (SB/SE relabelled from Flaperon/Offboard to Aileron rate/Elevator rate, matching their actual PX4-relevant function since `RC_MAP_FLAPS`/`RC_MAP_OFFB_SW` were cleared 2026-09-02). Closed the matching CTL-04 acceptance criterion and removed the open item. Historical CHANGELOG/project-notes entries describing this as manual-only are left as-is (accurate at the time they were written); this entry records that the constraint no longer holds in this session's environment.

## Maiden Mission Confirmed Accepted by PX4 - 2026-10-10

Julian re-uploaded the maiden mission in QGroundControl and confirmed it was accepted with no "Mission rejected" message. This validates the 2026-10-02 `RTL_TYPE` fix (1 to 0) - the mission has no landing pattern, and the theory (based on PX4's documented behaviour and a matching community report, not yet tested on this aircraft at the time) was that `RTL_TYPE` = 0 avoids the mission-feasibility check that would otherwise require one. Confirmed correct. Updated `docs/operations/maiden-flight-test-plan.md` (Section 5 and the now-empty Section 7), `docs/operations/Pixhawk Parameter Backup/parameter-change-log.md`, and `context/open-items.md` accordingly.

## Maiden Flight Analysed From the SD Card Logs - 2026-10-11

Julian handed over the Pixhawk's SD card (G: drive) and asked for the maiden flight log to be reviewed, plus a fresh parameter backup - noting the data-link/GCS failsafe (`NAV_DLL_ACT`) had been changed to Disabled "to stop it RTL if the laptop dies."

**The flight actually happened 2026-10-11, not 2026-10-04 as planned** - one week later than the date in `docs/operations/maiden-flight-test-plan.md` Section 2. Confirmed via the flight log's own GPS UTC timestamp (23:02-23:27 on 2026-10-10 UTC = 09:02-09:27 on 2026-10-11 Brisbane local), not file-system time, which would only have given local-clock-at-copy-time rather than the FC's own clock. Two logs were on the card for the day: a 394.8s ground/RC-range check that never left the ground (ended in an RC-loss-failsafe RTL while still on the ground), and the 1487.0s (24m47s) maiden flight itself.

**Parameter backup:** no live QGroundControl/MAVLink connection to the flight controller was available (just the SD card), so the fresh backup was reconstructed directly from the maiden flight log instead of a live export - it embeds the complete parameter set at boot plus every parameter PX4 changed mid-flight, which together are equivalent to a live export taken right after landing. Diffed against the 2026-10-02 backup (all 1214 shared parameters, not just the expected ones, per the project's usual practice): 22 changes plus one newly-observed parameter (`MIS_DIST_1WP`, at the firmware default, absent from the 2026-10-02 export - looks like an export omission, not a deliberate change).

Of the 22: routine sensor-bias drift (accelerometer/gyro/barometer/magnetometer offsets, `EKF2_MAG_DECL`) and the `COM_FLIGHT_UUID` flight counter, as usual. Two real, deliberate-or-consequential changes: **`NAV_DLL_ACT`** (2 to 0 - see below) and **eight rate-controller gains** (`FW_PR_P/I/FF`, `FW_P_TC`, `FW_RR_P/I/FF`, `FW_R_TC`) written by a successful in-flight PID auto-tune (Phase D) at t=1324.2s - the flight log shows a first attempt aborted within a second of starting (t=669.6s, consistent with a flight-mode change aborting it) and a second attempt that completed in 14.9s.

**`NAV_DLL_ACT` finding:** the log confirms this was already 0 (Disabled) at the start of the flight, not 2 (Return) as set 2026-10-02 under RF-06 - so the reversal happened before this flight, not after it. The log explains why: the RFD900x GCS link dropped out at least 15 times over the flight, three of them longer than the 10s data-link-loss timeout (39.8s, 27.9s, 17.0s). With RF-06's setting still live, each of those three would very likely have triggered an unwanted automatic RTL despite the pilot holding full manual RC control throughout (RC is carried over a separate ELRS link, not the RFD900x) - exactly the scenario Julian described. No RC-link loss occurred in flight, so `NAV_RCL_ACT` (unchanged, still 2/Return) was never exercised.

**Other findings written up in `docs/engineering/test-reports/2026-10-11-maiden-flight.md`:** the airspeed sensor (MS4525DO) reported invalid data for almost the entire flight (97% of samples outside a physically plausible range) - this affects any TECS-dependent mode and means Phase E's (Cruise Efficiency Sweep) planned power-vs-airspeed analysis can't be done reliably from this log; Phase J (Return to Home, CH10) was not deliberately exercised in flight (no `AUTO_RTL` transition appears anywhere); Mission mode (Phase K) ran for 99.1s with no fault; and two minor, unexplained anomalies (a brief critical-failure flag at t=574.1s, a one-off GPS spoofing warning at t=748.8s) are noted but not root-caused.

Updated `docs/operations/Pixhawk Parameter Backup/parameter-change-log.md` (refresh method/date, `NAV_DLL_ACT`, new rate-controller-gains section, calibration values), `docs/engineering/flight-modes.md` (Rev 1.17), `docs/project/build-checklist.md` (RF-06 bullet), `docs/operations/manual.md` (step 28), `docs/operations/maiden-flight-test-plan.md` (Rev 0.7, actual flight date, `NAV_DLL_ACT` references, Section 7), and `context/open-items.md` (four new items from the flight).

## Auto-Tune Validation and Pilot Debrief Findings - 2026-10-11

Julian asked whether the auto-tune result from the maiden flight (previous entry) actually looks reasonable, not just different from the untuned defaults. Two independent checks, both in `docs/engineering/test-reports/2026-10-11-maiden-flight.md`: PX4's own system-identification diagnostic (`autotune_attitude_control_status.fitness`) converged cleanly for both roll and pitch (down to 0.24 and 0.39 from an initial ~10-16 - the never-tuned yaw phase shows obviously nonsensical negative gains by contrast, which is what a bad fit looks like); and a before/after comparison of actual rate-tracking performance in the flight itself showed roll/pitch tracking error improved 36%/55% after the new gains applied, with no control-surface saturation. Both point the same way: the tune is a genuine improvement, not just a change.

Julian then relayed pilot debrief notes (Ross Dennington, BNEMAC, flew the maiden flight - corrected the test report's attendee list, which had wrongly listed Julian as pilot; he handled/ran ground station) and asked for several to be checked against the log rather than taken on faith:

- **Launch was marginal** - hand-launched from a hill, using all the available elevation to gain flying speed. Julian decided future flights will use a launch dolly instead. Julian also provided the launch video (`Launch.m4v`, dropped in the repo root), now in `docs/assets/flight-footage/`.
- **Roll-right difficulty, suspected motor torque** - the pilot reported struggling to roll right, worse at higher throttle, and suspected both propellers turning the same direction (confirmed elsewhere in the project's records as not contra-rotating) was the cause, but flagged they might have the direction backwards. Checked directly: stick-to-roll-rate sensitivity in Manual/Acro showed right-roll achieving less than half the rate per unit stick versus left-roll, and the rate controller needed a persistent rightward correction just to hold wings level in Stabilized/Loiter at mid-to-high throttle. Confirmed from the control-allocation parameters (`CA_ROTOR0_PY`/`CA_ROTOR1_PY` = 0) that PX4 isn't using differential thrust at all here, and that both motors were commanded identically throughout (bit-for-bit, every sample) - so the asymmetry isn't a software artifact, and is consistent with the pilot's own account in the direction they actually described. Julian decided contra-rotating propellers are needed before the next flight.
- **Stabilized mode recommendation and three follow-up questions** - the pilot recommends taking off in Stabilized mode (flew noticeably nicer) and asked whether it uses differential thrust (no - confirmed above, true for every mode on this airframe), whether both motors produce equal thrust (not verifiable in flight - commands are identical but actual output isn't instrumented per motor; more relevant now given the bearing finding below), and whether the throttle command is feedforward/shaped differently in Stabilized (no - fitted the stick-to-motor-command relationship separately in Manual, Acro, and Stabilized and got the same linear mapping in all three; the "less punchy" feel is more likely the attitude loop damping out thrust-coupling disturbance that the pilot would otherwise feel directly, not a throttle-path difference).
- **Takeoff catch-22** - full throttle is needed to gain airspeed quickly enough to climb away, but that's also where the induced-torque effect is worst; reinforces the contra-rotating-propeller decision, no separate action.
- **NAV_DLL_ACT reinforcement** - Julian confirmed the GCS failsafe-disable decision (previous entry) was validated twice over: once by the flight's own repeated GCS dropouts, and separately by the GCS laptop actually dying before launch on the day, which is what prompted checking the setting in the first place.
- **Post-flight inspection findings, no log signature**: a PDB mount/connector needing rework, and a bad bearing found in the right motor - both new critical items (PWR-05, PROP-13) in `docs/project/build-checklist.md`, alongside the new PROP-12 (contra-rotating propellers).

Also reorganised `docs/assets/` into subfolders (`component-photos/`, `diagrams/`, `config-screenshots/`, `test-plots/`, `flight-footage/`) at Julian's request, moving all 28 existing files via `git mv` and updating every live reference across 9 files - checked every reference resolves before treating it as done, rather than repeating the earlier broken-screenshot-link mistake.

## Real Mission Recovered From the Pixhawk's Dataman File, Satellite Imagery Added - 2026-10-11

Asked for a plot of the Mission-mode segment (waypoints + actual flown path). Built it from `docs/operations/Pixhawk Mission Backup/maiden-mission.plan` first, which showed a roughly 25m average deviation between the flown track and the "planned" waypoints and a 10m altitude mismatch (mission file said 40m, the flight's own `position_setpoint_triplet` showed 50m commanded). Julian confirmed the mission was replanned at the field that day - the backup was simply stale, not a flight anomaly.

Rather than resign the plot to using known-wrong waypoints, pulled the real mission directly from the Pixhawk's own mission database on the SD card (`G:\dataman` - a separate file from the `log/` folder, PX4's persistent binary store for the active mission, not something exported through QGroundControl). Fetched PX4's own source (`dataman.h`/`dataman.cpp`, `navigation.h`) to get the exact on-disk struct layout rather than guess at it, and validated the resulting parse two independent ways before trusting it: the computed total file size matched the real file's size exactly (128,528 bytes - confirms every assumed struct size and the per-key item count, `CONFIG_NUM_MISSION_ITEMS_SUPPORTED` = 1000), and every parsed waypoint matched the flight's own live `navigator_mission_item` telemetry to sub-metre precision. The real mission has 28 items (not 32): a camera-mode setup command, Takeoff, 19 waypoints all at 50m relative altitude (not 40m), a landing-sequence marker with speed/camera commands, a Loiter-to-Alt descent point, and an actual Land item - the old backup's "no landing item" description no longer holds. Flagged as a new open item (regenerating `maiden-mission.plan` and the geofence backup from this validated method, and correcting the test plan's Section 5) rather than fixed outright, since that's a larger propagation Julian hasn't signed off on yet.

Also explained a point of confusion: the flown track's long diagonal transit leg across the middle of the pattern is expected PX4 behaviour, not a bug - Mission mode was engaged mid-flight while the aircraft was physically near the south end of the pattern, and PX4 resumed at waypoint 2 rather than restarting from Takeoff, so it had to fly across to reach it.

Separately, swapped the plot's basemap from free Esri tiles to Julian's own Nearmap export (15cm GSD, georeferenced JPEG + world file, downloaded via MapBrowser's Basic/Single Image export with "Include georeferenced file" checked) - sharp enough to see the actual mown pattern in the grass at BNEMAC. Verified the georeferencing by checking all mission/flight coordinates fall inside the image's computed extent before trusting it. Saved the source imagery into a new `docs/assets/site-imagery/` folder per Julian's request, for reuse on future test reports at the same field, rather than treating it as a one-off plot input.

## Airspeed "Fault" Was a Validator Config Issue, Not a Cut Line - 2026-10-11

Julian suspected a cut differential-pressure line explained the maiden flight's near-total airspeed-invalid readings, and asked whether the data supported it. Checked the raw sensor data directly rather than just the processed/validated topic, since a cut or blocked line should show up as near-zero, negative, or stuck raw readings - it didn't. Recomputing airspeed straight from the raw differential pressure gave physically sane values (13-24 m/s) for the entire flight. The sensor hardware was fine the whole time.

Traced the actual cause through PX4's own source (fetched `AirspeedValidator.cpp` and `airspeed_selector_params.yaml` rather than guess at the validation logic): the validator's `airspeed_sensor_measurement_valid` flag flips false exactly once, at t=49.0s, 16.4s after takeoff - right when body-frame vertical acceleration was swinging up to ~2.4g during the hard pull-up recovering from the launch sag, with airspeed only 15-17 m/s (not far above the 11 m/s stall speed). That's exactly the condition PX4's `check_load_factor()` check is built to catch. It never recovered for the rest of the ~1400s flight because `ASPD_FS_T_START` was at -1, PX4's own default value, documented as disabling in-flight re-enabling of the sensor entirely once it trips once.

Decided to set `ASPD_FS_T_START` to 2s so a future transient trip can clear itself rather than latching for the whole flight - recorded in `docs/operations/Pixhawk Parameter Backup/parameter-change-log.md` as decided but not yet applied to the physical FC. Corrected the earlier "faulty airspeed sensor" framing in `docs/engineering/test-reports/2026-10-11-maiden-flight.md`, `context/open-items.md`, and `docs/operations/maiden-flight-test-plan.md` - all three had called this a hardware fault needing physical inspection, which is no longer accurate. Also added PWR-06 (`docs/project/build-checklist.md`) as a new critical blocker for completing the battery capacity test and setting `BAT1_CAPACITY`, per Julian, and recorded the maiden flight's actual discharge (3.92 Ah via PX4's own coulomb counter) as sizing context for that test.

## Launch Dolly Concept Changed to Wing Saddle With Ramp Stops - 2026-11-05

The tail-rising single-cradle concept recorded as decided in the dolly SRD (rev 0.5, 2026-10-12) has been replaced by Julian's Fusion design, which developed from the wing-saddle concept model (`docs/engineering/analysis/launch-dolly-concept/`, 2026-11-03): the wing rests on two 3D-printed wedge trays inboard of the motors with a ramp stop at the front of each, and the rear fuselage rests on a centreline tail support. SRD Section 3c now describes this concept (rev 0.6). Julian kept the tail-rise idea from the earlier concept: as airspeed builds, the tail lifts off its support and the aircraft pitches nose-down about the leading edges at the ramps to a lower AoA before lifting over the lips. The concept model's earlier assumption (the tail held on the cradle, the aircraft pivoting nose-up about it to clear the lip) no longer applies. Front wheels are one each side on outriggers, each braced by the outrigger arm, a horizontal brace and a vertical strut, outboard of the prop discs; Julian rejected a centreline nose wheel. The complete layout is drawn on BLV-DOL-006 (`docs/engineering/analysis/launch-dolly-concept/dolly_v2_model.py`), with rail spacing and outrigger geometry still to confirm in Fusion. On the manufacturer drawing's propeller position the ramp lips are about 44 mm behind the prop discs, so prop clearance needs measuring on the aircraft.

Design choices made by Julian along the way: the trays are wedges at 5° to the rail with lightening cutouts under a TPU cover; the ramp face is 75° to the tray; the lip was raised to 30 mm after the release-angle discussion (the concept model had solved 22.5 mm for a 7.5° release); the rear section was moved forward so the rear axle sits 570 mm aft of the front cross member.

Tail-support height was estimated by overlaying the manufacturer side view at 1:1 on Julian's Fusion side view, calibrated from his measurement of 570.35 mm between the 40 mm circles at the rear axle and front cross member (570.0 mm in the side plane). A first pass the same day assumed 1.0 mm/px from the tube width and read about 16 mm low. The drawing is reliable for length (1070 mm dimensioned) and its fuselage depth is consistent with the published 260 x 140 x 105 mm battery bay; its front view is not to scale (the 185 mm height dimension disagrees with its own span), and the wing section drawn on the side view implies about -5° incidence, which was treated as a drawing artefact.

See [open-items.md](open-items.md) for what's still missing.
