SpicyTenderloin/believer/AI-context/startup-prompt.md

# Believer Project - AI Startup Prompt

You are being asked to assist with the **Believer** UAV project. This file is the single entry point for getting up to speed. Read it fully, then read each context file listed below before doing any work.

---

## What this project is

**Believer** is a long-range, fixed-wing UAV built by the QUT Aerospace Society (QUTAS) at Queensland University of Technology, developed as a BVLOS observation platform for remote sensing applications. A specific mission has not yet been selected. Onboard object detection is planned for a future companion computer phase.

The airframe is a V-tail, twin-motor fixed-wing running PX4 on a Holybro Pixhawk 6X flight controller. Full avionics, RC, and telemetry link details are in `docs/engineering/ICD.md`.

**Project lead:** Julian Williams (UAS Systems Lead / Program Manager)  
**Contact:** qutaerospacesociety@qut.edu.au  
**Funding:** QUT EER club activity funding + QUTAS account funds

---

## Read these files before doing any work

Read them in order - each one builds on the last.

1. **[`AI-context/project-overview.md`](project-overview.md)** - full project background, current build state (components, actuator mapping, key parameters), and the complete repo file-structure map. Start here to understand what exists and where.

2. **[`AI-context/project-notes.md`](project-notes.md)** - confirmed technical facts about the aircraft and avionics, plus the provenance and decision history behind them (what was confirmed, when, what alternatives were ruled out). This is the companion to `docs/engineering/ICD.md`.

3. **[`AI-context/directives.md`](directives.md)** - standing working conventions: how files are organized, what gets extracted vs. kept, when to commit/push, how to handle unknowns.

4. **[`AI-context/style-guide.md`](style-guide.md)** - how documents under `docs/` must be written. Read before creating or editing any `docs/` file.

5. **[`AI-context/open-items.md`](open-items.md)** - known information gaps (TBDs). Check before asserting facts that might still be unconfirmed.

6. **[`AI-context/authorities.md`](authorities.md)** - standing authorities granted to Claude. **At the start of each session, check these against `.claude/settings.local.json` and ask the user whether to sync any gaps before proceeding.**

7. **[`AI-context/CHANGELOG.md`](CHANGELOG.md)** - all notable changes, most recent first. Read to understand the current state and what has changed recently.

8. **[`AI-context/academic-integrity.md`](academic-integrity.md)** - QUT academic conduct and AI use policy. Relevant because AI tools are used openly on this project for documentation.

---

## Key engineering documents

| File | Purpose |
|---|---|
| [`docs/engineering/ICD.md`](../docs/engineering/ICD.md) | Interface control document - all avionics interfaces: serial ports, RC channel map, power, GPS, sensors |
| [`docs/operations/manual.md`](../docs/operations/manual.md) | Operating manual - flight modes, GR1 switch map, failsafe config, pre-flight checklist, PX4 flight-mode configuration detail |
| [`docs/engineering/analysis/powertrain-performance-model.md`](../docs/engineering/analysis/powertrain-performance-model.md) | Powertrain performance model - thrust, current and power of the twin-motor drive against airframe drag, calibrated on the stand data; scripts and results alongside |
| [`docs/engineering/build-checklist.md`](../docs/engineering/build-checklist.md) | Flight-readiness dashboard and work-package task tracking |
| [`docs/governance/timeline-and-roadmap.md`](../docs/governance/timeline-and-roadmap.md) | Milestone history and forward roadmap |
| [`docs/governance/purchase-history/purchase-history.md`](../docs/governance/purchase-history/purchase-history.md) | All component purchases - unit cost, total with shipping, who paid (University/Julian personal), installed status |
| [`README.md`](../README.md) | Public-facing project background, purpose, and team |
| `docs/operations/backups/Pixhawk Parameter Backup/parameter-change-log.md` | Narrative log of every PX4 parameter change and the reason behind it |
| `docs/operations/backups/Pixhawk Parameter Backup/believer-parameters.params` | Full PX4 parameter dump (raw backup) |
| `docs/operations/backups/GX12 Radio Backup/MODELS/model00.yml` | GX12 EdgeTX model config - mixer definitions for all RC channels |

---

All working conventions are in `AI-context/directives.md`. Document writing standards are in `AI-context/style-guide.md`. Read those files as part of the read-order above - the rules are not repeated here.
