SpicyTenderloin/believer/docs/engineering/flight-modes.md

# Believer Fixed-Wing UAV - Flight Modes

| | |
|---|---|
| **Document** | FM-BELIEVER-001 |
| **Revision** | 1.17 |
| **Date** | 2026-10-11 |
| **Status** | Draft |

## 1. Scope

This document describes the PX4 fixed-wing flight modes available on the Believer: how the aircraft behaves and responds to pilot input in each mode, and the flight controller parameters that configure that behaviour. It is a companion to [`docs/operations/manual.md`](../operations/manual.md) (which gives the pilot-facing quick reference and pre-flight procedure) and [`ICD.md`](ICD.md) (which defines the RC channel map and switch wiring). Parameter values quoted here are the values currently exported in `docs/operations/Pixhawk Parameter Backup/believer-parameters.params` (2026-08-19) unless stated otherwise.

## 2. Reference Documents

- PX4 User Guide - [Flight Modes (Fixed-Wing)](https://docs.px4.io/main/en/flight_modes_fw/)
- PX4 User Guide - [Flight Modes overview](https://docs.px4.io/main/en/flight_modes/)
- PX4 User Guide - [Flight Mode configuration (RC switches)](https://docs.px4.io/main/en/config/flight_mode.html)
- PX4 User Guide - [Safety/Failsafe configuration](https://docs.px4.io/main/en/config/safety.html)
- PX4 User Guide - [Parameter Reference](https://docs.px4.io/main/en/advanced_config/parameter_reference.html)
- `docs/engineering/ICD.md` - INT-03 (RC control link), INT-08 (RC transmitter link), RC channel map
- `docs/operations/manual.md` - GR1 switch group, pre-flight safety state
- `docs/operations/Pixhawk Parameter Backup/parameter-change-log.md` - narrative log of intentional parameter changes
- `context/open-items.md`, `docs/project/build-checklist.md` - open items affecting flight-mode behaviour

## 3. Flight Mode Selection

PX4 assigns a flight mode to each of up to six switch positions on a single RC channel via the parameters `COM_FLTMODE1` through `COM_FLTMODE6`, configured through QGroundControl's Flight Modes screen (see [PX4: Flight Mode Configuration](https://docs.px4.io/main/en/config/flight_mode.html)). On the Believer, that channel is CH6 (`RC_MAP_FLTMODE` = 6), carrying the GX12's six-position GR1 switch group.

| GR1 Position | `COM_FLTMODEx` | Raw value | PX4 Mode |
|---|---|---|---|
| SW1 | `COM_FLTMODE1` | 0 | Manual |
| SW2 | `COM_FLTMODE2` | 6 | Acro |
| SW3 | `COM_FLTMODE3` | 8 | Stabilized |
| SW4 | `COM_FLTMODE4` | 1 | Altitude |
| SW5 | `COM_FLTMODE5` | 2 | Position |
| SW6 | `COM_FLTMODE6` | 3 | Mission |

Remapped 2026-08-19: Acro was added at SW2 and Hold was dropped from the group (Hold and CH8's Loiter override are the same PX4 mode, so keeping Hold in the GR1 group as well was redundant), shifting Stabilized through Mission down one position each. This matches the switch mapping documented in `docs/operations/manual.md` Section 3.

Two further modes are reachable outside the GR1 group, each on its own dedicated switch (see `docs/engineering/ICD.md` RC channel map):

| Channel | Parameter | Mode | Behaviour |
|---|---|---|---|
| CH8 | `RC_MAP_LOITER_SW` = 8 | Hold | Latching; overrides whichever mode GR1 has selected |
| CH10 | `RC_MAP_RETURN_SW` = 10 | Return | Latching; overrides GR1 |

**Offboard is no longer reachable via any switch, as of 2026-09-02.** `RC_MAP_OFFB_SW` was cleared to 0 (unassigned), confirmed via a fresh parameter export - this resolves the SB/SE dual-purpose overlap previously flagged here (flipping elevator rate in flight could no longer trigger Offboard, since PX4 no longer acts on channel 11 for it at all). SE still drives CH11's `mixData` output unchanged in EdgeTX, and separately still selects the elevator tri-rate curve locally (`docs/project/build-checklist.md` CTL-04) - only PX4's interpretation of that channel changed, not the radio configuration itself. Not currently used operationally regardless - the companion computer that would drive Offboard is a future project phase. See Section 4.9.

## 4. Flight Modes

### 4.1 Manual

Stick input is sent directly to control allocation with no stabilisation or angle limiting - centring the sticks does not level the aircraft. This is the only PX4 mode that bypasses the flight management unit's normal command path (commands are sent via the safety coprocessor), making it a backup control path if the FMU experiences a firmware-level failure. On the Believer, throttle, aileron, and V-tail (elevator/rudder) surfaces all move directly with stick position - the aircraft will hold whatever attitude the pilot last commanded, including into a stall or a bank, until corrected.

| Parameter | Value | Purpose |
|---|---|---|
| `FW_MAN_P_SC` | 1.0 | Pitch stick-to-surface scale factor |
| `FW_MAN_R_SC` | 1.0 | Roll stick-to-surface scale factor |
| `FW_MAN_Y_SC` | 1.0 | Yaw stick-to-surface scale factor |

These three parameters scale stick-to-actuator commands **specifically in full Manual mode** - they have no effect in Acro or Stabilized, which command angular rate or attitude respectively rather than sending stick input directly to control allocation. None have been adjusted; all remain at the PX4 default of 1.0 pending `docs/project/build-checklist.md` CTL-08 (reopened 2026-09-02, formal Manual-mode test procedure still to be run).

**Bench behaviour in Acro or Stabilized is not evidence about these parameters.** Apparent early control-surface saturation was observed on the bench and initially suspected to be a `FW_MAN_*_SC` scaling fault. An informal bench comparison narrowed it to Acro mode specifically - consistent with the hypothesis that its rate controller integrates against a persistent, unclosing error on a stationary airframe that can never achieve the commanded rate (integral windup), driving a surface to its endpoint well before the stick reaches full travel - but this has not yet been confirmed via CTL-08's formal, logged Manual-mode test. A direct, proportional stick-to-surface relationship should only be expected in full Manual mode.

Used during ground functional checks (`docs/operations/manual.md` step 32-33) and as the emergency direct-control fallback. Not used for launch.

### 4.2 Acro

Stick input commands angular rate (roll/pitch rate, and yaw rate if enabled) rather than attitude - centring the sticks holds the current rotation rate (zero, if already stopped), but does not level the aircraft the way Stabilized does. Added to the GR1 group 2026-08-19 to give direct, high-rate stick response without an attitude limit - this is the behaviour the team originally expected from Stabilized mode (Section 4.3); Acro is PX4's mode for it.

| Parameter | Value | Purpose |
|---|---|---|
| `FW_ACRO_X_MAX` | 90 deg/s | Maximum commanded roll rate |
| `FW_ACRO_Y_MAX` | 90 deg/s | Maximum commanded pitch rate |
| `FW_ACRO_Z_MAX` | 45 deg/s | Maximum commanded yaw rate |
| `FW_ACRO_YAW_EN` | 0 (Disabled) | Yaw axis is not rate-controlled in Acro - yaw stick maps directly to the yaw actuator output, as in Manual |

Reachable via GR1 SW2. Values shown are PX4 generic fixed-wing defaults, not yet deliberately tuned for the Believer (CTL-02, `docs/project/build-checklist.md`).

### 4.3 Stabilized

Centring the roll/pitch sticks levels the aircraft's attitude and holds it there; altitude and heading are **not** held and will drift with throttle setting and wind. Roll and pitch are angle-controlled (bounded by `FW_MAN_R_MAX`/`FW_MAN_P_MAX`), so the aircraft cannot be looped or rolled inverted from the stick. Throttle is direct - at zero throttle the aircraft glides. Yaw stick adds manual yaw beyond the autopilot's own turn-coordination.

| Parameter | Value | Purpose |
|---|---|---|
| `FW_MAN_R_MAX` | 45 deg | Maximum commanded roll angle |
| `FW_MAN_P_MAX` | 30 deg | Maximum commanded pitch angle |
| `FW_MAN_YR_MAX` | 30 deg/s | Maximum manual yaw rate |
| `FW_PSP_OFF` | 0 deg | Pitch angle offset for level flight |

This is the mode used for hand-launch (`docs/operations/manual.md` Section on Assisted Hand Launch), reachable via GR1 SW3. On the V-tail airframe, pitch and yaw commands are both output through the V-tail servos (MAIN 1/2, `docs/engineering/ICD.md` INT-02a/INT-02b) via PX4's ruddervator mixing rather than separate elevator and rudder surfaces.

No yaw authority was observed in Stabilized mode during the 2026-07-10 TMAC session (CTL-01, `docs/project/build-checklist.md`). This has been resolved: the expected direct yaw-stick response is properly Acro mode's behaviour (Section 4.2), not Stabilized's, and Acro has been added to the GR1 group to provide it. The V-tail yaw mixing gain (`CA_SV_CS2_TRQ_Y`/`CA_SV_CS3_TRQ_Y`, `docs/engineering/ICD.md` Control Surface Mixing) was also raised from 0.50 to 0.85 as part of finalising the 2026-07-10 TMAC trim values. **Note (2026-08-31):** a subsequent control-allocation review found this ±0.85 pair was not a validated rudder-mix ratio, and the target is to restore it to the PX4 type-default ±0.50 - the live value remains ±0.85 as of this writing, pending `docs/project/build-checklist.md` CTL-06.

Turn coordination in this and the automatic modes below is governed in part by `FW_RLL_TO_YAW_FF` (roll-to-yaw feedforward gain, currently 0.0 - the PX4 default), which counteracts adverse yaw on roll entry. It remains at 0.0 in the baseline configuration; any change is deferred until flight testing demonstrates meaningful adverse yaw (`docs/project/build-checklist.md` CTL-07) - no non-zero value is currently planned or decided.

### 4.4 Altitude

As Stabilized, plus the autopilot actively holds altitude and airspeed when the sticks are centred - heading still drifts with wind, since there is no position source used for course correction. Pitch stick commands climb/descent rate; throttle stick at centre (50%) holds the current altitude at the trimmed cruise airspeed; roll stick commands bank angle with automatic turn coordination.

| Parameter | Value | Purpose |
|---|---|---|
| `FW_AIRSPD_TRIM` | 20 m/s | Cruise airspeed target |
| `FW_AIRSPD_MIN` | 15 m/s | Minimum controlled airspeed |
| `FW_AIRSPD_MAX` | 28 m/s | Maximum controlled airspeed |
| `FW_AIRSPD_STALL` | 11 m/s | Stall speed used by low-speed protection |
| `FW_T_CLMB_R_SP` | 3 m/s | Commanded climb rate at full pitch-up stick |
| `FW_T_SINK_R_SP` | 2 m/s | Commanded sink rate at full pitch-down stick |
| `FW_T_CLMB_MAX` / `FW_T_SINK_MAX` | 5 m/s | Climb/sink rate limits |
| `FW_MAN_R_MAX` | 45 deg | Maximum commanded roll angle (shared with Stabilized) |

Requires an altitude source (barometer, always available) but not GPS.

Updated 2026-09-02 (`docs/project/build-checklist.md` CTL-10), informed by Weishäupl et al. 2024's measured data for what is very likely the same commercial airframe: `FW_AIRSPD_STALL` set to the paper's measured 1g stall speed (11 m/s, up from the untuned PX4 generic default of 7 m/s); `FW_AIRSPD_MIN` raised to keep real margin above it; `FW_AIRSPD_TRIM` set to 20 m/s, matching both the manufacturer's recommended cruise speed and the paper's figure; `FW_AIRSPD_MAX` raised to 28 m/s, giving margin below the paper's measured VNE (37 m/s, flutter-limited) while comfortably exceeding the new trim speed.

### 4.5 Position

As Altitude, plus the autopilot also holds ground track against wind - releasing the sticks returns the aircraft to straight, level flight on its current course and altitude regardless of wind. Requires a valid global position estimate (GPS). Uses the same airspeed and climb/sink parameters as Altitude mode (Section 4.3).

Requires GPS 1 (M8N, `docs/engineering/ICD.md` INT-05) lock; GPS 2 (RTK) is not required for Position mode to function.

### 4.6 Hold

Automatic mode - RC stick input is ignored. The aircraft loiters in a circle around the GPS position and altitude at which Hold was engaged. Requires a global position estimate (GPS); if disarmed, the vehicle cannot arm without a position lock.

| Parameter | Value | Purpose |
|---|---|---|
| `NAV_LOITER_RAD` | 50 m | Loiter circle radius. Tightened from 80 m, NAV-08, 2026-10-02 - checked against bank-angle/stall-margin limits (see `docs/operations/Pixhawk Parameter Backup/parameter-change-log.md`) |
| `NAV_MIN_LTR_ALT` | 40 m (provisional) | Minimum loiter altitude, above the home position, not AMSL/AGL (confirmed against PX4's parameter description). Changed from -1 (disabled), NAV-08, 2026-10-02 - requires a pre-flight site survey confirming no obstacle in the flight test area exceeds this height (`docs/operations/manual.md` step 5) |

On the Believer, "Hold" and "Loiter" refer to the same mode - see `docs/operations/manual.md` Section 3 for the naming note. No longer in the GR1 group as of 2026-08-19 (freed for Acro, Section 4.2); reachable directly via CH8 (which overrides GR1). Used as an emergency safe-hold and as the RC-loss failsafe action for a lost data link (Section 6).

### 4.7 Mission

Automatic mode - executes a pre-uploaded flight plan waypoint-by-waypoint. Requires a global position estimate (GPS), the vehicle to be armed, and a valid mission to be uploaded; if no mission exists or the mission completes, the aircraft loiters (Hold behaviour) instead. A mission can be paused by switching to Hold or Position and resumed from the same waypoint.

| Parameter | Value | Purpose |
|---|---|---|
| `MIS_TKO_LAND_REQ` | 2 | Requires the mission to contain a landing pattern (PX4's fixed-wing default) - see [PX4: Mission Mode](https://docs.px4.io/main/en/flight_modes_fw/mission.html). The maiden mission (below) has no landing pattern; `RTL_TYPE` was changed to 0 (Section 4.8) specifically so this requirement isn't enforced against it |
| `NAV_LOITER_RAD` | 50 m | Loiter radius used at mission completion or a loiter waypoint (shared with Hold). Tightened from 80 m, NAV-08, 2026-10-02 |

Reachable via GR1 SW6. A maiden-flight test mission is uploaded (`docs/operations/Pixhawk Mission Backup/maiden-mission.plan`, added 2026-10-02): one takeoff item followed by 31 waypoints, all at 40 m relative altitude, forming a closed pattern entirely inside the uploaded polygon geofence (Section 6). If engaged while already airborne (the only way this mission will be flown - see `docs/operations/manual.md`), PX4 treats the takeoff item as a normal waypoint rather than attempting an autonomous takeoff. The mission has no landing item, RTL item, or loiter-unlimited item - on completing the last waypoint, the aircraft automatically enters Hold behaviour at that position and altitude (`NAV_LOITER_RAD`, above), and remains there until the pilot switches modes. Automatic takeoff and landing more generally are tracked as future capability work in `docs/project/project-roadmap.md`, consistent with `RTL_LAND_DELAY` below currently disabling auto-land.

### 4.8 Return

Automatic mode - pilot input is ignored. The aircraft climbs to a safe altitude, transits directly to the home position (no rally points are defined, and `RTL_TYPE` no longer considers a mission landing pattern - see below), and then either loiters or lands depending on configuration.

| Parameter | Value | Purpose |
|---|---|---|
| `RTL_RETURN_ALT` | 100 m | Altitude held during the return transit |
| `RTL_DESCEND_ALT` | 100 m | Altitude at which the aircraft transitions from transit to loiter/landing behaviour |
| `RTL_LOITER_RAD` | 50 m | Loiter radius at the return destination. Tightened from 80 m, NAV-08, 2026-10-02 |
| `RTL_LAND_DELAY` | -1 | Aircraft loiters indefinitely at the destination rather than landing automatically (auto-land is not yet configured - see `docs/project/project-roadmap.md`) |
| `RTL_TYPE` | 0 | Direct to home or the closest rally point, never a mission landing pattern - see [PX4: Return Mode](https://docs.px4.io/main/en/flight_modes_fw/return.html). Changed from 1 (Mission landing/rally point return), 2026-10-02, because the maiden mission has no landing pattern - `RTL_TYPE` = 1 would likely have caused PX4 to reject it ("landing pattern required"). Behaviourally equivalent to 1 for this mission/field (no rally points or landing pattern exist either way, so 1 would have fallen back to home anyway) |

`RTL_RETURN_ALT` and `RTL_DESCEND_ALT` are both set to 100m, comfortably inside the 120m AGL geofence ceiling (`GF_MAX_VER_DIST`, see `docs/operations/Pixhawk Parameter Backup/parameter-change-log.md`). Reachable via CH10 (overrides GR1), and is also the aircraft's configured RC-loss failsafe action (Section 6).

### 4.9 Offboard

Automatic mode - the aircraft obeys position, velocity, attitude, or actuator setpoints streamed continuously by an external system (e.g. a companion computer) via MAVLink or ROS 2, rather than any onboard autonomous logic. PX4 requires this setpoint stream to already be running as a "proof of life" before the vehicle can arm into or switch into Offboard; if the stream stops for longer than `COM_OF_LOSS_T`, the offboard-loss failsafe action is triggered.

| Parameter | Value | Purpose |
|---|---|---|
| `COM_OF_LOSS_T` | 1.0 s | Timeout before the offboard-loss failsafe triggers |
| `COM_OBL_RC_ACT` | 0 | Failsafe action taken on offboard loss - see [PX4: Offboard Mode](https://docs.px4.io/main/en/flight_modes/offboard.html) |

**No longer reachable via any switch, as of 2026-09-02** - `RC_MAP_OFFB_SW` was cleared to 0 (unassigned), confirmed via a fresh parameter export, resolving the dual-purpose overlap against the elevator rate switch previously flagged here (see Section 3). SE still drives CH11's `mixData` output unchanged in EdgeTX and separately still selects the elevator tri-rate curve locally (CTL-04) - only PX4's interpretation of the channel changed. Not currently used operationally regardless - the companion computer that would drive it is a future project phase (`docs/project/project-roadmap.md`) - a new switch assignment (via `RC_MAP_OFFB_SW`) can be made whenever that phase begins.

## 5. Failsafe Interactions

Two of the three failsafe conditions that can force the aircraft into a flight mode independently of the GR1/CH8/CH10 switches are configured to take automatic action; the third (data-link loss) is deliberately disabled:

| Failsafe | Parameter | Value | Action |
|---|---|---|---|
| RC (control) link loss | `NAV_RCL_ACT` | 2 | Return - unchanged, PWR-04/RF-06 |
| Data link (telemetry/GCS) loss | `NAV_DLL_ACT` | 0 | Disabled - briefly changed to 2 (Return) on 2026-10-02 (RF-06), then reverted to 0 on 2026-10-11 before the maiden flight. The maiden flight log shows why: the RFD900x GCS link dropped out at least 15 times over 24.8 minutes, three exceeding `COM_DL_LOSS_T`'s 10s timeout - with this at 2, each would have triggered an unwanted RTL despite the pilot having full manual RC control throughout. See `docs/operations/Pixhawk Parameter Backup/parameter-change-log.md` and `docs/engineering/test-reports/2026-10-11-maiden-flight.md` |
| Low battery | `COM_LOW_BAT_ACT` | 3 | Return at critical level (`BAT_CRIT_THR`), Land at emergency level (`BAT_EMERGEN_THR`) - changed from 0 (Warning only, PX4's default), PWR-04 |

See [PX4: Safety Configuration](https://docs.px4.io/main/en/config/safety.html) for the full failsafe action enum. Battery failsafe thresholds (`BAT_LOW_THR`, `BAT_CRIT_THR`) and geofence breach action (`GF_ACTION`) are documented in `docs/operations/Pixhawk Parameter Backup/parameter-change-log.md`.

## 6. Open Items

- None of the Acro rate limits (Section 4.2), airspeed, roll/pitch limit, or TECS climb/sink parameters in Sections 4.4-4.5 have been deliberately tuned for the Believer yet (CTL-02, `docs/project/build-checklist.md`) - values shown are the as-exported PX4 generic fixed-wing airframe defaults.
- PROP-08 (`docs/project/build-checklist.md`): the motor PWM ceiling (`PWM_MAIN_MAX4`/`MAX6`, currently 1800us at the last export, approximately 1700us recommended for the 12x6" propeller) limits full-stick throttle in every mode; sustained-current verification at the ceiling is still outstanding.

## 7. Revision History

| Rev | Date | Description |
|---|---|---|
| 1.0 | 2026-07-17 | Initial issue |
| 1.1 | 2026-08-19 | Added Acro mode (Section 4.2, new GR1 SW2); removed Hold from the GR1 group (still reachable via CH8) and renumbered subsequent GR1 positions/sections accordingly. Resolved the Stabilized-mode yaw open item (CTL-01) - the expected direct yaw response is Acro's behaviour, not Stabilized's; also recorded the V-tail yaw mixing gain increase (0.50 -> 0.85) from the finalised TMAC trim values |
| 1.2 | 2026-08-31 | Following a flight-control configuration review: clarified that `FW_MAN_*_SC` (Section 4.1) apply specifically to full Manual mode and warned against interpreting Acro/Stabilized bench saturation as evidence about them; documented `FW_RLL_TO_YAW_FF` (Section 4.3, currently 0.0, no non-zero value planned pending flight-test evidence); flagged the 2026-08-19 V-tail ±0.85 yaw mixing gain as targeted for restoration to the PX4 default ±0.50, live value unchanged pending CTL-06 |
| 1.3 | 2026-09-01 | CTL-08 closed - confirmed the early bench saturation was Acro-mode-specific (rate-controller integral windup against a stationary airframe), did not reproduce in Manual mode; `FW_MAN_*_SC` confirmed and retained at 1.0. Updated Section 4.1 accordingly |
| 1.4 | 2026-09-02 | CTL-10 closed - updated the Altitude-mode airspeed table (Section 4.4) with the new `FW_AIRSPD_STALL`/`MIN`/`TRIM`/`MAX` values, informed by Weishäupl et al. 2024's measured stall speed, cruise speed, and VNE for what is very likely the same commercial airframe |
| 1.5 | 2026-09-02 | CTL-08 reopened per Julian - the 2026-09-01 closure was based on an informal bench comparison, not the formal logged Manual-mode test its acceptance criteria call for; Julian is running that test himself. Reverted Section 4.1's "closed" framing accordingly |
| 1.6 | 2026-09-02 | CTL-04's tri-rate implementation added a dual-purpose local rate-curve selection to CH9/CH11's switches (SB/SE) - verified against the actual radio backup that the underlying channel routing is unchanged. Updated Section 3 and Section 4.9 to reflect Offboard remaining reachable via CH11 unchanged, with an unresolved overlap against the elevator rate switch flagged as an open item |
| 1.7 | 2026-09-02 | Verified against a fresh parameter export: `RC_MAP_OFFB_SW` cleared to 0 (unassigned), resolving the CH11/elevator-rate overlap flagged in Rev 1.6. Offboard is now genuinely not reachable via any switch. Updated Section 3 and Section 4.9 accordingly |
| 1.8 | 2026-09-26 | Updated Section 6 (Open Items): removed the resolved CG item (AF-01) and the stale static-thrust/throttle-mapping item (PROP-02/PROP-06, closed 2026-09-02), replaced with the motor PWM ceiling item (PROP-08). Corrected the document header, which had not been bumped for Rev 1.7 |
| 1.9 | 2026-09-26 | Section 5 (Failsafe Interactions): added the low-battery row - `COM_LOW_BAT_ACT` is 0 (Warning), so the battery thresholds take no automatic action, which the document previously did not show |
| 1.10 | 2026-10-02 | Section 5 (Failsafe Interactions): flagged the data-link-loss row as pending a change from 0 (Disabled) to 2 (Return), per Julian's decision that both RC and data-link loss should return the aircraft home and hold - tracked as RF-06, not yet applied to the live parameter |
| 1.11 | 2026-10-02 | Updated the Section 4.1 cross-reference to `docs/operations/manual.md`'s ground functional checks step numbers (21-22 to 26-27), following a pre-flight checklist expansion that added five new steps ahead of them |
| 1.12 | 2026-10-02 | Updated the Section 4.1 cross-reference again (26-27 to 29-30), following a further pre-flight checklist expansion (pilot briefing, callout agreement, and radio/QGroundControl volume check steps) |
| 1.13 | 2026-10-02 | Flagged `NAV_LOITER_RAD` (Sections 4.6, 4.7), `RTL_LOITER_RAD` (Section 4.8), and `NAV_MIN_LTR_ALT` (Section 4.6) as pending changes to 50 m, 50 m, and 40 m respectively - tracked as NAV-08, not yet applied. Clarified `NAV_MIN_LTR_ALT` is measured above the home position, confirmed against PX4's own parameter description |
| 1.14 | 2026-10-02 | Updated the Section 4.1 cross-reference again (29-30 to 31-32), following a further pre-flight checklist expansion (site-survey and loiter-parameter confirmation steps, NAV-08) |
| 1.15 | 2026-10-02 | Confirmed via a direct QGroundControl parameter export that RF-06, PWR-04, and NAV-08 are all applied - removed "pending" language from Sections 4.6-4.8 and 5, updated values (`NAV_DLL_ACT`=2, `COM_LOW_BAT_ACT`=3, `NAV_LOITER_RAD`/`RTL_LOITER_RAD`=50m, `NAV_MIN_LTR_ALT`=40m). Documented `RTL_TYPE`'s change from 1 to 0 (Section 4.8) and the maiden mission upload (Section 4.7, `docs/operations/Pixhawk Mission Backup/maiden-mission.plan`) - a 32-item waypoint pattern with no landing item, which is why `RTL_TYPE`=1 was replaced |
| 1.16 | 2026-10-02 | Updated the Section 4.1 cross-reference again (31-32 to 32-33), following a further pre-flight checklist expansion (battery-chemistry parameter check) |
| 1.17 | 2026-10-11 | Section 5: `NAV_DLL_ACT` reverted from 2 (Return) back to 0 (Disabled) before the maiden flight - updated per the maiden flight log's own evidence of repeated GCS link dropouts that would have caused unwanted RTLs under the 2026-10-02 setting. See `docs/engineering/test-reports/2026-10-11-maiden-flight.md` |
