SpicyTenderloin/believer/docs/engineering/analysis/launch-dolly-concept/out/BLV-DOL-006-concept-views.pdf

## ISOMETRIC - FRONT, STARBOARD, ABOVE

red dashed = 12 in propeller discs at the drawing's motor station (TBD)

## ISOMETRIC - REAR, STARBOARD, ABOVE

PLAN 1:15 | SIDE (FROM STARBOARD) 1:15 | FRONT 1:15

570 wheelbase

376 lip
256 tail pad
340 rails (TBD)

1113 front track

450

376

KEY DATA | VALUE
Layout | 4 wheels: rear wheels on the rails, front wheels on outriggers
Wheels | 196 mm; track 1113 front / 450 rear; wheelbase 570
Wing supports | 5.2 deg wedge trays at y = +/-170 (TBD), 30 mm lip
Tail support | Pad top 256 above ground, 6 deg, adjustable +/-20
Front outriggers | Arm + horizontal brace + vertical strut each side; wheel outboard of prop disc
Prop disc to dolly | 44 mm, at ramp S (req. >= 75; prop position TBD)
Overall L x W x H | 766 x 1158 x 376 mm

ITEMS

### 1 Wedge tray with ramp stop (PETG, TPU cover)

### 2 Tail support pad (TPU) on adjustable centre post

### 3 Front wheel (x2), outboard of the prop discs

### 4 Outrigger arm from the front tee (x2)

### 5 Horizontal brace, outrigger end to rail tee (x2)

### 6 Vertical strut, outrigger end to upright tee (x2)

### 7 Front cross member

### 8 Rear cross member (carries tail post)

### 9 Rear wheel (x2)

### 10 Diagonal strut, rail tee to tray

### 11 Rail (x2)

### 12 Front upright (x2)

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
QUT AEROSPACE SOCIETY - BELIEVER UAV | CONCEPT

LAUNCH DOLLY

## CONCEPT VIEWS - COMPLETE DOLLY

DWG No.

## BLV-DOL-006

SCALE AS SHOWN (A3) | SHEET 1 OF 1 | REV A 2026-11-05
UNITS mm | ANGLES deg | GENERATED: dolly_drawings.py | PROJECTION

Airframe dims marked ASSUMED are not yet measured - verify before cutting tube.

GENERATED: dolly_v2_sheet.py

Side frame from the Fusion model; values marked TBD and the prop discs are not yet measured.
