SpicyTenderloin/believer/docs/assets/livery/out/1-roundel-options.png

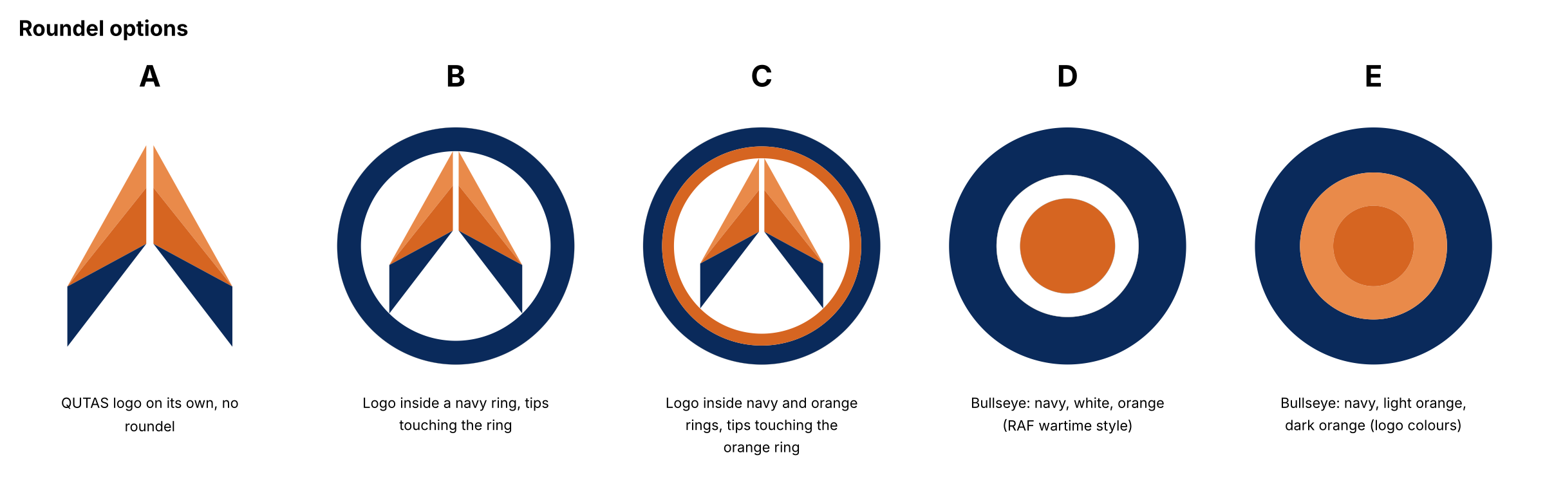
docs/assets/livery/out/1-roundel-options.png
