SpicyTenderloin/believer/docs/assets/livery/out/2-wingtip-options-mockup.png

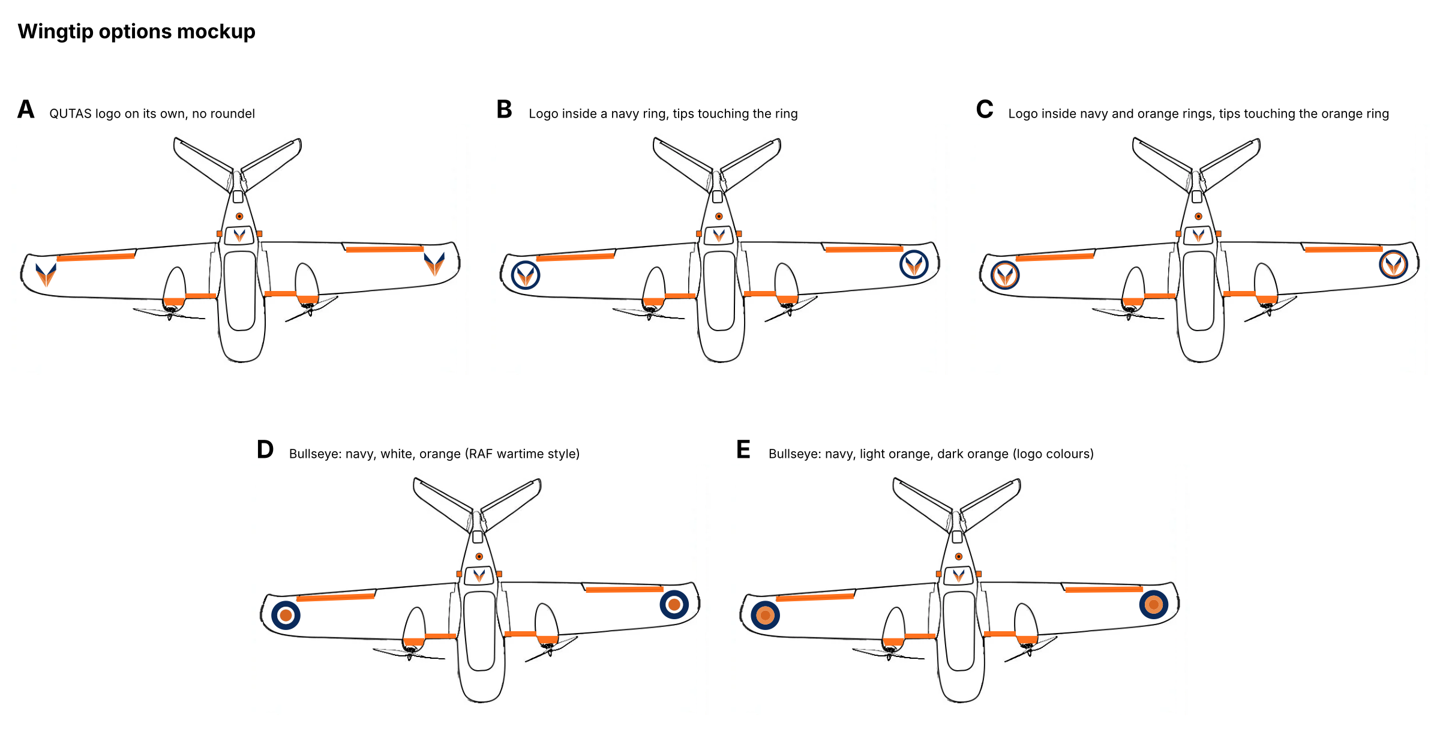
docs/assets/livery/out/2-wingtip-options-mockup.png
