SpicyTenderloin/believer/docs/assets/livery/out/3-identification-and-roundel-options.png

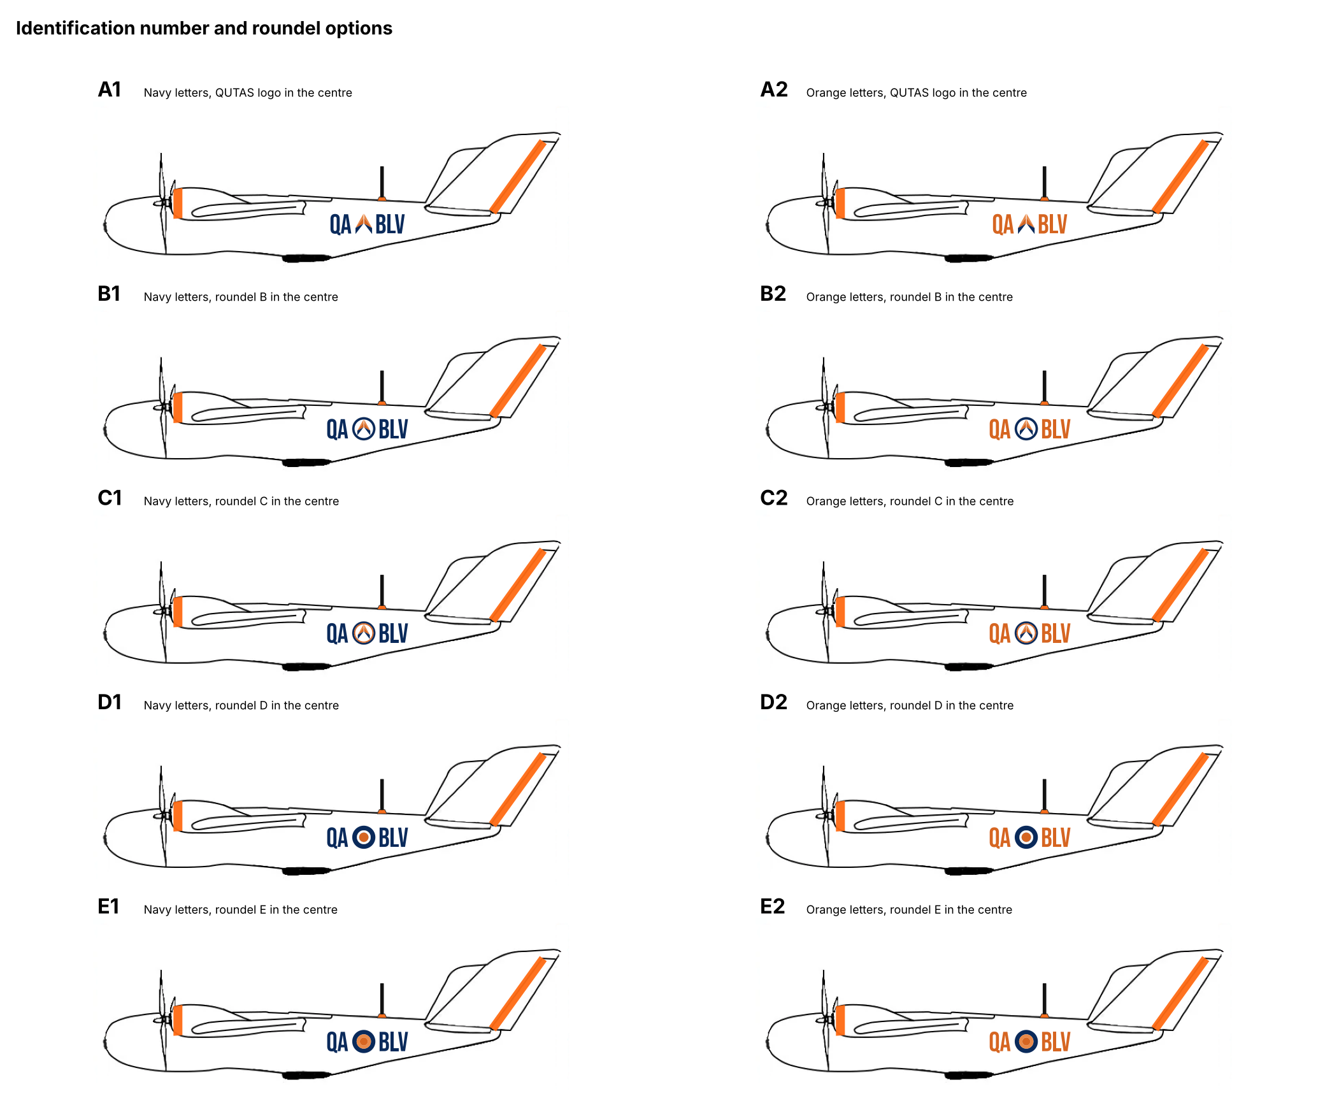
docs/assets/livery/out/3-identification-and-roundel-options.png
