SpicyTenderloin/believer/docs/assets/livery/out/three-view-clean.png

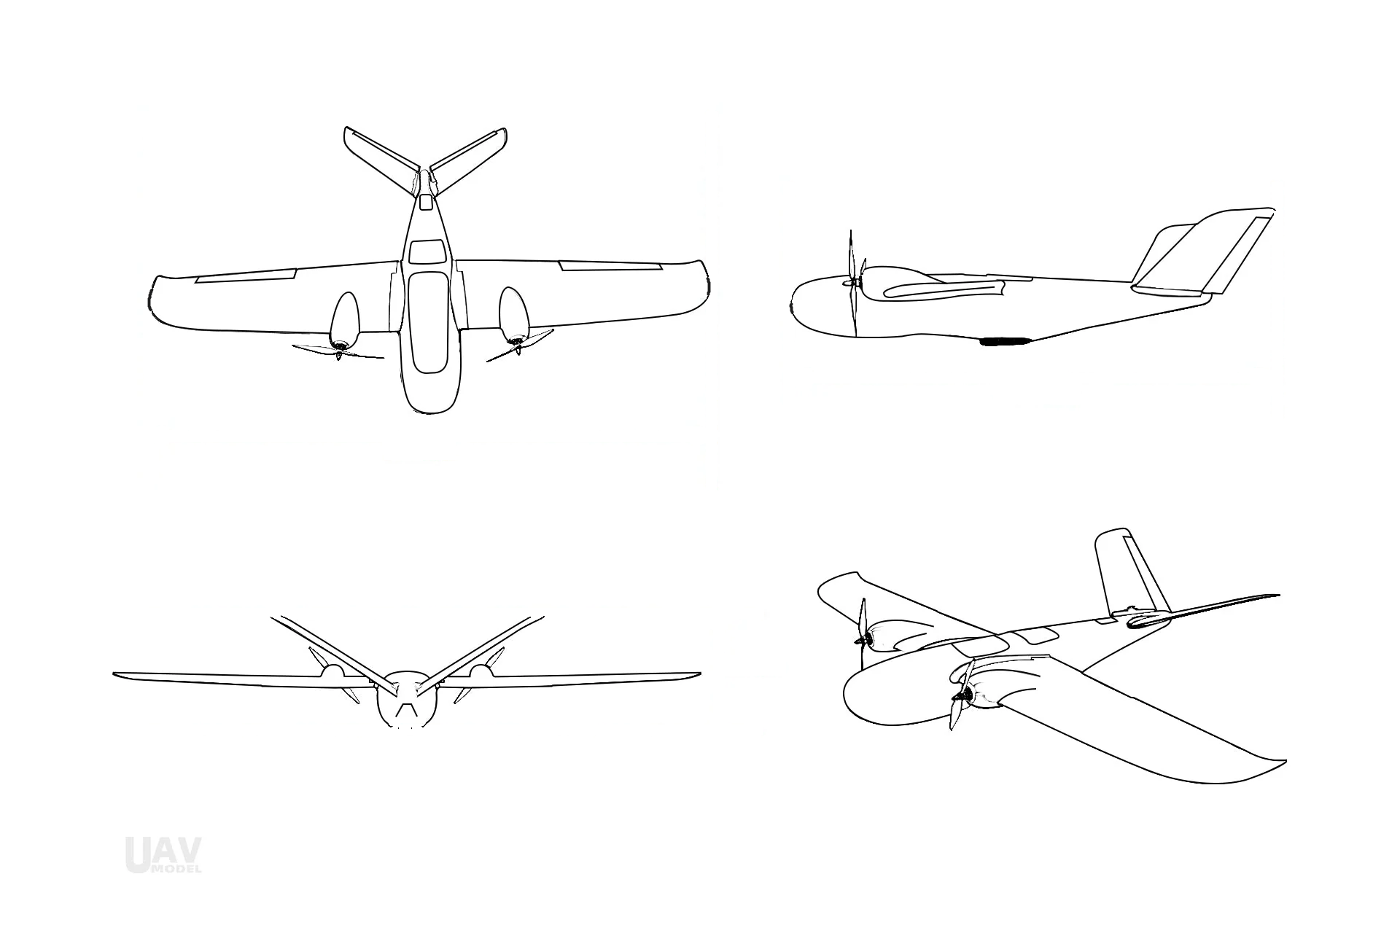
docs/assets/livery/out/three-view-clean.png
