SpicyTenderloin/believer/docs/engineering/analysis/launch-dolly-concept/rear-support-fit/dolly-side-view-input.png

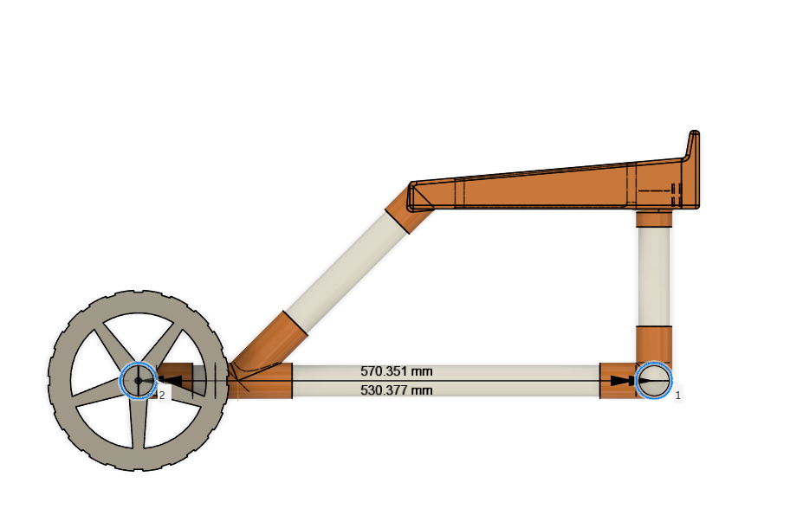
docs/engineering/analysis/launch-dolly-concept/rear-support-fit/dolly-side-view-input.png
