SpicyTenderloin/believer/docs/purchase-history.md

# Purchase History

Tracks components purchased for the Believer project. Invoiced items link to their source document under [`../supporting-documents/invoices/`](../supporting-documents/invoices/). USD amounts are converted to AUD at the exchange rate on the date of purchase (source: RBA / financial market rates).

**To date, $1,379.00 AUD of funding was allocated to this project, of which $981.08 AUD has been spent.**

(University-funded items only.)

| Date | Item | Vendor | Qty | Unit Cost | Total (incl. shipping) | Paid By | Installed | Order / Tracking # | Invoice | Notes |
|---|---|---|---|---|---|---|---|---|---|---|
| 2026-02-27 | Turnigy Graphene Professional 8000mAh 6S 15C LiPo Pack | HobbyKing.com | 1 | $145.57 AUD | $152.85 AUD (incl. 5% shipping est.) | University | Yes | | | |
| 2026-03-20 | Interface Cable - RP-SMA Male to RP-SMA Female (25cm, RG174) | Core Electronics | 1 | $6.85 AUD | $10.55 AUD (incl. $3.70 shipping) | University | Yes | Tax Invoice 1000669124 | [link](../supporting-documents/invoices/core-electronics-rpsma-cable-2026-03-20.pdf) | |
| 2026-05-10 | MATEKSYS PDB FCHUB-12S V2 (5V/12V output, 440A current sensor, 3-12S) | FPV Drone Store (Alibaba.com) | 1 | $24.99 USD | $42.98 AUD (USD $31.17 incl. $6.18 delivery; 1 USD = 1.379 AUD on 2026-05-10) | University | No | Notice B1020260510035468 | [link](../supporting-documents/invoices/alibaba-mateksys-pdb-fchub12s-2026-05-10.pdf) | Purchased per original funding application budget; not the unit installed - see PM03D |
| 2026-05-10 | Gemfan LIPO Strap (16x250/20x250/20x330/20x550mm woven metal buckle) | YUNYAO2008 FPV Store (Alibaba.com) | 1 | $5.51 USD | $13.90 AUD (USD $10.08 incl. $4.57 delivery; 1 USD = 1.379 AUD on 2026-05-10) | University | Yes | Notice B1020260510035438 | [link](../supporting-documents/invoices/alibaba-lipo-battery-straps-2026-05-10.pdf) | |
| 2026-05-11 | Holybro PM03D Power Module | ChipBoard Development Store (Alibaba.com) | 1 | 434.12 CNY | 477.53 CNY (incl. shipping) | Julian (personal) | Yes | Notice B1020260511035088 | [link](../supporting-documents/invoices/alibaba-pm03d-power-module-2026-05-11.pdf) | Provides battery telemetry and 5V servo rail power (ICD INT-01) |
| | Radiomaster GX12 Crush ExpressLRS Radio Controller (Iron Grey) | FPVFaster | 1 | $329.99 AUD | $346.49 AUD (incl. 5% shipping est.) | University | Yes | | | Ground-side transmitter |
| | Radiomaster DBR4 Dual Band ELRS Xross Gemini ExpressLRS Receiver | FPVFaster | 1 | $52.99 AUD | $55.64 AUD (incl. 5% shipping est.) | University | Yes | | | |
| | SparkFun GPS-RTK-SMA Breakout - ZED-F9P | SparkFun Electronics | 1 | $259.95 AUD | $272.95 AUD (incl. 5% shipping est.) | University | Yes | | | No RTK antenna installed yet - must be fitted before maiden flight |
| | PM06 V2 Power Module | Holybro | 1 | $20.99 AUD | $22.04 AUD (incl. 5% shipping est.) | University | No | | | Power telemetry format not accepted by Pixhawk; not the unit installed |
| | IMX335 5MP USB Camera | Core Electronics | 1 | $60.65 AUD | $63.68 AUD (incl. 5% shipping est.) | University | No | | | For future onboard decision-making / pilot video feed |
| 2026-07-04 | 11x7" Electric Propeller (LP11X7E) | Hobbyrama | 2 | $9.95 AUD | $19.90 AUD | Julian (personal) | Yes | Trans #117526 | [link](../supporting-documents/invoices/hobbyrama-propellers-2026-07-04.jpg) | Replaces prior 11x4.7" propellers (unbranded, not separately invoiced); both units are the same handedness - a reverse-pitch prop is still needed on one side for true contra-rotation |
| | **University total** | | | | **$981.08 AUD** | University | | | | Approved budget $1,379.00 AUD - **$397.92 AUD remaining**. Excludes PM03D (Julian personal funds). |

## Funding application budget (for reference)

Approved via the QUTAS EER club activity funding application (signed 2026-05-20/21): total project cost $1,379, EER funding $689.50 (50%), remainder from QUTAS account funds. Earlier budget line items below predate the shopping list and overlap with it (e.g. the MatekSys PDB was purchased per this budget but not used in the final build - the Holybro PM03D is fitted instead, bought separately with personal funds; the battery spec here also differs from the pack actually fitted):

| Item | Amount (AUD) | Justification |
|---|---|---|
| RadioMaster GX12 Dual-Band Gemini-X Radio Controller Transmitter | $350 | ELRS compatible transmitter, compatible with other common radio protocols |
| RadioMaster receiver (listed as "XR4", actually purchased as DBR4) | $50 | ELRS compatible, dual-band receiver, reusable on future drone projects |
| ZED-F9P Positioning Module | $220 | Highly accurate GPS module, multi-band GNSS reception |
| IMX335 5MP USB Camera | $64 | Camera module for local decision making |
| 2200mAh 6S 60C LiPo | $46 | High load and high discharge rate battery |
| Miscellaneous and Sundries | $300 | Fasteners, cabling, adhesives, paint, minor hardware, 3D printing |
| MatekSys Power Distribution Board | $45 | Power distribution between battery and modules |
| Battery Velcro Straps | $4 | High-strength battery straps |

The original project proposal (2026-01-25, see [`../supporting-documents/Believer Project Proposal.pdf`](../supporting-documents/Believer%20Project%20Proposal.pdf)) budgeted these same upgrades at **$1,030 total**, without the MatekSys PDB or Velcro straps - those two items were added later in the EER funding application above.
