SpicyTenderloin/believer/docs/purchase-history/purchase-history.md

# Purchase History

Tracks components purchased for the Believer project. Invoiced items link to their source document under [`invoices/`](invoices/). USD amounts are converted to AUD at the exchange rate on the date of purchase (source: RBA / financial market rates).

**To date, $1,379.00 AUD of funding was allocated to this project, of which $981.08 AUD has been spent.**

(University-funded items only.)

| Date | Item | Vendor | Qty | Unit Cost | Total (incl. shipping) | Paid By | Installed | Order / Tracking # | Invoice | Notes |
|---|---|---|---|---|---|---|---|---|---|---|
| 2026-02-27 | Turnigy Graphene Professional 8000mAh 6S 15C LiPo Pack | HobbyKing.com | 1 | $145.57 AUD | $152.85 AUD (incl. 5% shipping est.) | University | Yes | | | |
| 2026-03-20 | Interface Cable - RP-SMA Male to RP-SMA Female (25cm, RG174) | Core Electronics | 1 | $6.85 AUD | $10.55 AUD (incl. $3.70 shipping) | University | Yes | Tax Invoice 1000669124 | [link](invoices/core-electronics-rpsma-cable-2026-03-20.pdf) | |
| 2026-05-10 | MATEKSYS PDB FCHUB-12S V2 (5V/12V output, 440A current sensor, 3-12S) | FPV Drone Store (Alibaba.com) | 1 | $24.99 USD | $42.98 AUD (USD $31.17 incl. $6.18 delivery; 1 USD = 1.379 AUD on 2026-05-10) | University | No | Notice B1020260510035468 | [link](invoices/alibaba-mateksys-pdb-fchub12s-2026-05-10.pdf) | Purchased per original funding application budget; not the unit installed - see PM03D |
| 2026-05-10 | Gemfan LIPO Strap (16x250/20x250/20x330/20x550mm woven metal buckle) | YUNYAO2008 FPV Store (Alibaba.com) | 1 | $5.51 USD | $13.90 AUD (USD $10.08 incl. $4.57 delivery; 1 USD = 1.379 AUD on 2026-05-10) | University | Yes | Notice B1020260510035438 | [link](invoices/alibaba-lipo-battery-straps-2026-05-10.pdf) | |
| 2026-05-11 | Holybro PM03D Power Module | ChipBoard Development Store (Alibaba.com) | 1 | 434.12 CNY | 477.53 CNY (incl. shipping) | Julian (personal) | Yes | Notice B1020260511035088 | [link](invoices/alibaba-pm03d-power-module-2026-05-11.pdf) | Provides battery telemetry and 5V servo rail power (ICD INT-01) |
| | Radiomaster GX12 Crush ExpressLRS Radio Controller (Iron Grey) | FPVFaster | 1 | $329.99 AUD | $346.49 AUD (incl. 5% shipping est.) | University | Yes | | | Ground-side transmitter |
| | Radiomaster DBR4 Dual Band ELRS Xross Gemini ExpressLRS Receiver | FPVFaster | 1 | $52.99 AUD | $55.64 AUD (incl. 5% shipping est.) | University | Yes | | | |
| | SparkFun GPS-RTK-SMA Breakout - ZED-F9P | SparkFun Electronics | 1 | $259.95 AUD | $272.95 AUD (incl. 5% shipping est.) | University | Yes | | | No RTK antenna installed yet - must be fitted before maiden flight |
| | PM06 V2 Power Module | Holybro | 1 | $20.99 AUD | $22.04 AUD (incl. 5% shipping est.) | University | No | | | Power telemetry format not accepted by Pixhawk; not the unit installed |
| | IMX335 5MP USB Camera | Core Electronics | 1 | $60.65 AUD | $63.68 AUD (incl. 5% shipping est.) | University | No | | | For future onboard decision-making / pilot video feed |
| 2026-07-04 | 11x7" Electric Propeller (LP11X7E) | Hobbyrama | 2 | $9.95 AUD | $19.90 AUD | Julian (personal) | Yes | Trans #117526 | [link](invoices/hobbyrama-propellers-2026-07-04.jpg) | Replaces prior 11x4.7" propellers (unbranded, not separately invoiced); both units are the same handedness. Superseded by the 9x6" standard/pusher pair purchased 2026-07-14 for the new T-MOTOR MN3110 KV700 motors |
| 2026-07-06 | T-MOTOR MN3110 KV700 Brushless Motor | T-MOTOR Official Store (Alibaba.com) | 2 | 353.71 CNY | 787.16 CNY ($169.87 AUD) | Julian (personal) | No | Notice B1020260706059997 | [link](invoices/tmotor-mn3110-kv700-motors-2026-07-06.pdf) | Higher-KV replacement for the T-Motor U5 v2.0 KV400 motors; not yet fitted - pending the thrust-to-weight ground test |
| 2026-07-14 | 9x6" GEMFAN Propeller (standard/tractor rotation) | Shop1105187756 Store (Alibaba.com) | 1 | 35.30 CNY | 42.70 CNY ($9.23 AUD) | Julian (personal) | No | Notice B1020260714024962 | [link](invoices/gemfan-9x6-standard-propeller-2026-07-14.pdf) | For the T-MOTOR MN3110 KV700 motor upgrade, size selected via MotoCalc modelling with Peter Spink (TMAC), 2026-07-10. AUD figure prorated from the combined $19.07 AUD total for both propeller invoices |
| 2026-07-14 | 9x6" Gemfan APC Nylon Propeller (pusher/reverse rotation) | Shop1105166501 Store (Alibaba.com) | 1 | 37.65 CNY | 45.56 CNY ($9.84 AUD) | Julian (personal) | No | Notice B1020260714025041 | [link](invoices/gemfan-9x6-pusher-propeller-2026-07-14.pdf) | Reverse-pitch pair for correct contra-rotation with the new motors; resolves the previously open reverse-pitch propeller sourcing item. AUD figure prorated from the combined $19.07 AUD total for both propeller invoices |
| | **University total** | | | | **$981.08 AUD** | University | | | | Approved budget $1,379.00 AUD - **$397.92 AUD remaining**. |
| | **Julian (personal) total** | | | | **$208.84 AUD** | Julian (personal) | | | | Hobbyrama propellers + T-MOTOR motors + Gemfan propellers. Excludes the PM03D (477.53 CNY, not converted to AUD). |
| | **All parties total** | | | | **$1,189.92 AUD** | | | | | University + Julian (personal), AUD-denominated items only; excludes the PM03D CNY line above. |

## Funding application budget (for reference)

Approved via the QUTAS EER club activity funding application (signed 2026-05-20/21): total project cost $1,379, EER funding $689.50 (50%), remainder from QUTAS account funds. Earlier budget line items below predate the shopping list and overlap with it (e.g. the MatekSys PDB was purchased per this budget but not used in the final build - the Holybro PM03D is fitted instead, bought separately with personal funds; the battery spec here also differs from the pack actually fitted):

| Item | Amount (AUD) | Justification |
|---|---|---|
| RadioMaster GX12 Dual-Band Gemini-X Radio Controller Transmitter | $350 | ELRS compatible transmitter, compatible with other common radio protocols |
| RadioMaster receiver (listed as "XR4", actually purchased as DBR4) | $50 | ELRS compatible, dual-band receiver, reusable on future drone projects |
| ZED-F9P Positioning Module | $220 | Highly accurate GPS module, multi-band GNSS reception |
| IMX335 5MP USB Camera | $64 | Camera module for local decision making |
| 2200mAh 6S 60C LiPo | $46 | High load and high discharge rate battery |
| Miscellaneous and Sundries | $300 | Fasteners, cabling, adhesives, paint, minor hardware, 3D printing |
| MatekSys Power Distribution Board | $45 | Power distribution between battery and modules |
| Battery Velcro Straps | $4 | High-strength battery straps |

The original project proposal (2026-01-25, see [`../reference/Believer Project Proposal.pdf`](../reference/Believer%20Project%20Proposal.pdf)) budgeted these same upgrades at **$1,030 total**, without the MatekSys PDB or Velcro straps - those two items were added later in the EER funding application above.
