SpicyTenderloin/believer/docs/governance/purchase-history/purchase-history.md

# Purchase History

Tracks components purchased for the Believer project. Invoiced items link to their source document under [`invoices/`](invoices/). USD amounts are converted to AUD at the exchange rate on the date of purchase (source: RBA / financial market rates).

**To date, $1,379.00 AUD of funding was allocated to this project, of which ~$1,222.98 AUD has been spent.**

(University-funded items only.) Separately, Julian has personally spent **$262.89 AUD** on components not drawn against this allocation - see the Julian (personal) total row below.

| Date | Item | Vendor | Qty | Unit Cost | Total (incl. shipping) | Paid By | Installed | Order / Tracking # | Invoice | Notes |
|---|---|---|---|---|---|---|---|---|---|---|
| 2026-03-10 | Turnigy Graphene Professional 8000mAh 6S 15C LiPo Pack | HobbyKing.com | 1 | $105.35 AUD (incl. GST) | $129.67 AUD (incl. $24.32 shipping; GST $11.79 of the total) | University | Yes | Order #103088165 / Invoice #102718714 | [link](invoices/hobbyking-turnigy-graphene-8000mah-battery-2026-03-10.pdf) | |
| 2026-03-20 | Interface Cable - RP-SMA Male to RP-SMA Female (25cm, RG174) | Core Electronics | 1 | $6.85 AUD | $10.55 AUD (incl. $3.70 shipping) | University | Yes | Tax Invoice 1000669124 | [link](invoices/core-electronics-rpsma-cable-2026-03-20.pdf) | |
| 2026-05-10 | MATEKSYS PDB FCHUB-12S V2 (5V/12V output, 440A current sensor, 3-12S) | FPV Drone Store (Alibaba.com) | 1 | $24.99 USD | $42.98 AUD (USD $31.17 incl. $6.18 delivery; 1 USD = 1.379 AUD on 2026-05-10) | University | No | Notice B1020260510035468 | [link](invoices/alibaba-mateksys-pdb-fchub12s-2026-05-10.pdf) | Purchased per original funding application budget; not the unit installed - see PM03D |
| 2026-05-10 | Gemfan LIPO Strap (16x250/20x250/20x330/20x550mm woven metal buckle) | YUNYAO2008 FPV Store (Alibaba.com) | 1 | $5.51 USD | $13.90 AUD (USD $10.08 incl. $4.57 delivery; 1 USD = 1.379 AUD on 2026-05-10) | University | Yes | Notice B1020260510035438 | [link](invoices/alibaba-lipo-battery-straps-2026-05-10.pdf) | |
| 2026-05-11 | Holybro PM03D Power Module | ChipBoard Development Store (Alibaba.com) | 1 | 434.12 CNY | 477.53 CNY (incl. shipping) | Julian (personal) | Yes | Notice B1020260511035088 | [link](invoices/alibaba-pm03d-power-module-2026-05-11.pdf) | Provides battery telemetry and 5V servo rail power (ICD INT-01) |
| | Radiomaster GX12 Crush ExpressLRS Radio Controller (Iron Grey) | FPVFaster | 1 | $329.99 AUD | $346.49 AUD (incl. 5% shipping est.) | University | Yes | | | Ground-side transmitter |
| | Radiomaster DBR4 Dual Band ELRS Xross Gemini ExpressLRS Receiver | FPVFaster | 1 | $52.99 AUD | $55.64 AUD (incl. 5% shipping est.) | University | Yes | | | |
| 2026-03-09 | SparkFun GPS-RTK-SMA Breakout - ZED-F9P (Qwiic) | SparkFun Electronics | 1 | $259.95 USD | ~$467 AUD (USD $324.56 incl. $35.10 shipping + $29.51 tax; converted at ~1.44 AUD/USD, an approximate rate for early March 2026 - precise daily/card-charged rate not confirmed, see `AI-context/open-items.md`) | University | Yes | Order #000243169 / Invoice #000173233 | [link](invoices/sparkfun-zed-f9p-gps-rtk-2026-03-09.pdf) | No RTK antenna installed yet - must be fitted before maiden flight |
| 2026-03-10 | PM06 V2 Power Module (14S Version) | Holybro | 1 | $20.99 USD | ~$82 AUD (USD $57.20 incl. $36.21 shipping; converted at ~1.44 AUD/USD, an approximate rate for early March 2026 - precise daily/card-charged rate not confirmed, see `AI-context/open-items.md`) | University | No | Order #15996 | [link](invoices/holybro-pm06-v2-power-module-2026-03-10.pdf) | Power telemetry format not accepted by Pixhawk; not the unit installed |
| 2026-03-10 | IMX335 5MP USB Camera | Core Electronics | 1 | $60.65 AUD (incl. GST) | $74.01 AUD (incl. $12.14 shipping ex GST + $6.73 GST) | University | No | Order #1000666876 | [link](invoices/core-electronics-imx335-camera-2026-03-10.pdf) | For future onboard decision-making / pilot video feed |
| 2026-07-04 | 11x7" Electric Propeller (LP11X7E) | Hobbyrama | 2 | $9.95 AUD | $19.90 AUD | Julian (personal) | Yes | Trans #117526 | [link](invoices/hobbyrama-propellers-2026-07-04.jpg) | Replaces prior 11x4.7" propellers (unbranded, not separately invoiced); both units are the same handedness. Superseded by the 9x6" standard/pusher pair purchased 2026-07-14 for the new T-MOTOR MN3110 KV700 motors |
| 2026-07-06 | T-MOTOR MN3110 KV700 Brushless Motor | T-MOTOR Official Store (Alibaba.com) | 2 | 353.71 CNY | 787.16 CNY ($169.87 AUD) | Julian (personal) | No | Notice B1020260706059997 | [link](invoices/tmotor-mn3110-kv700-motors-2026-07-06.pdf) | Higher-KV replacement for the T-Motor U5 v2.0 KV400 motors; not yet fitted - pending the thrust-to-weight ground test |
| 2026-07-14 | 9x6" GEMFAN Propeller (standard/tractor rotation) | Shop1105187756 Store (Alibaba.com) | 1 | 35.30 CNY | 42.70 CNY ($9.23 AUD) | Julian (personal) | No | Notice B1020260714024962 | [link](invoices/gemfan-9x6-standard-propeller-2026-07-14.pdf) | For the T-MOTOR MN3110 KV700 motor upgrade, size selected via MotoCalc modelling with Peter Spink (TMAC), 2026-07-10. AUD figure prorated from the combined $19.07 AUD total for both propeller invoices |
| 2026-07-14 | 9x6" Gemfan APC Nylon Propeller (pusher/reverse rotation) | Shop1105166501 Store (Alibaba.com) | 1 | 37.65 CNY | 45.56 CNY ($9.84 AUD) | Julian (personal) | No | Notice B1020260714025041 | [link](invoices/gemfan-9x6-pusher-propeller-2026-07-14.pdf) | Reverse-pitch pair originally sized for contra-rotation with the new motors; not installed - the MN3110 install (approximately 2026-07-24) carried over the existing 11x7" Hobbyrama props instead, both same handedness, confirmed acceptable for the maiden flight |
| 2026-07-13 | ZTW UBEC 10A (adjustable 5.0/5.5/6.0V output, 10A peak / 6A continuous) | Amazon.com.au (Amazon Export Sales LLC) | 1 | $39.54 AUD (excl. GST) | $43.49 AUD (incl. 10% GST; no shipping charged) | Julian (personal) | Yes | Order no. 503-9096661-8019814 | [link](invoices/amazon-ztw-ubec-10a-2026-07-13.pdf) | Dedicated 5V servo rail UBEC, resolves PWR-01; installed 2026-08-19, replacing the PM03D as the servo rail supply (ICD INT-01) |
| 2026-09-06 | Gemfan Apc Nylon Propeller, 12x6 (2-piece pack; the invoice gives the listing title, which covers sizes 5x5 to 17x10) | Dong Mu High Quality Store (Alibaba.com) | 1 (pack of 2) | 36.20 CNY | 51.96 CNY ($10.56 AUD) | Julian (personal) | No | Notice B1020260906048362 | [link](invoices/gemfan-apc-nylon-12x6-propellers-2026-09-06.pdf) | Propellers used on the thrust stand (2026-09-15) and intended for the aircraft; not installed. The size selection is not printed on the invoice. Marked 12X6E. Total is 36.20 CNY for the pack plus 15.76 CNY delivery, both including GST; the AUD figure is as charged. |
| | **University total** | | | | **~$1,222.98 AUD** | University | | | | Approved budget $1,379.00 AUD - **~$156.02 AUD remaining**. Increased from a previous ~$981.08 AUD once the SparkFun, HobbyKing, Core Electronics, and Holybro PM06 invoices (2026-03-09/10) were located and their actual figures replaced earlier shopping-list estimates - see `AI-context/CHANGELOG.md` 2026-08-26. |
| | **Julian (personal) total** | | | | **$262.89 AUD** | Julian (personal) | | | | Hobbyrama propellers + T-MOTOR motors + Gemfan propellers (9x6" and 12x6) + ZTW UBEC. Excludes the PM03D (477.53 CNY, not converted to AUD). |
| | **All parties total** | | | | **~$1,485.87 AUD** | | | | | University + Julian (personal), AUD-denominated items only; excludes the PM03D CNY line above. |

## Funding application budget (for reference)

Approved via the QUTAS EER club activity funding application (signed 2026-05-20/21): total project cost $1,379, EER funding $689.50 (50%), remainder from QUTAS account funds. Earlier budget line items below predate the shopping list and overlap with it (e.g. the MatekSys PDB was purchased per this budget but not used in the final build - the Holybro PM03D is fitted instead, bought separately with personal funds; the battery spec here also differs from the pack actually fitted):

| Item | Amount (AUD) | Justification |
|---|---|---|
| RadioMaster GX12 Dual-Band Gemini-X Radio Controller Transmitter | $350 | ELRS compatible transmitter, compatible with other common radio protocols |
| RadioMaster receiver (listed as "XR4", actually purchased as DBR4) | $50 | ELRS compatible, dual-band receiver, reusable on future drone projects |
| ZED-F9P Positioning Module | $220 | Highly accurate GPS module, multi-band GNSS reception |
| IMX335 5MP USB Camera | $64 | Camera module for local decision making |
| 2200mAh 6S 60C LiPo | $46 | High load and high discharge rate battery |
| Miscellaneous and Sundries | $300 | Fasteners, cabling, adhesives, paint, minor hardware, 3D printing |
| MatekSys Power Distribution Board | $45 | Power distribution between battery and modules |
| Battery Velcro Straps | $4 | High-strength battery straps |

The original project proposal (2026-01-25, see [`../Believer Project Proposal.pdf`](../Believer%20Project%20Proposal.pdf)) budgeted these same upgrades at **$1,030 total**, without the MatekSys PDB or Velcro straps - those two items were added later in the EER funding application above.
