SpicyTenderloin/believer/docs/governance/purchase-history/invoices/hobbyrama-propellers-2026-07-04.jpg

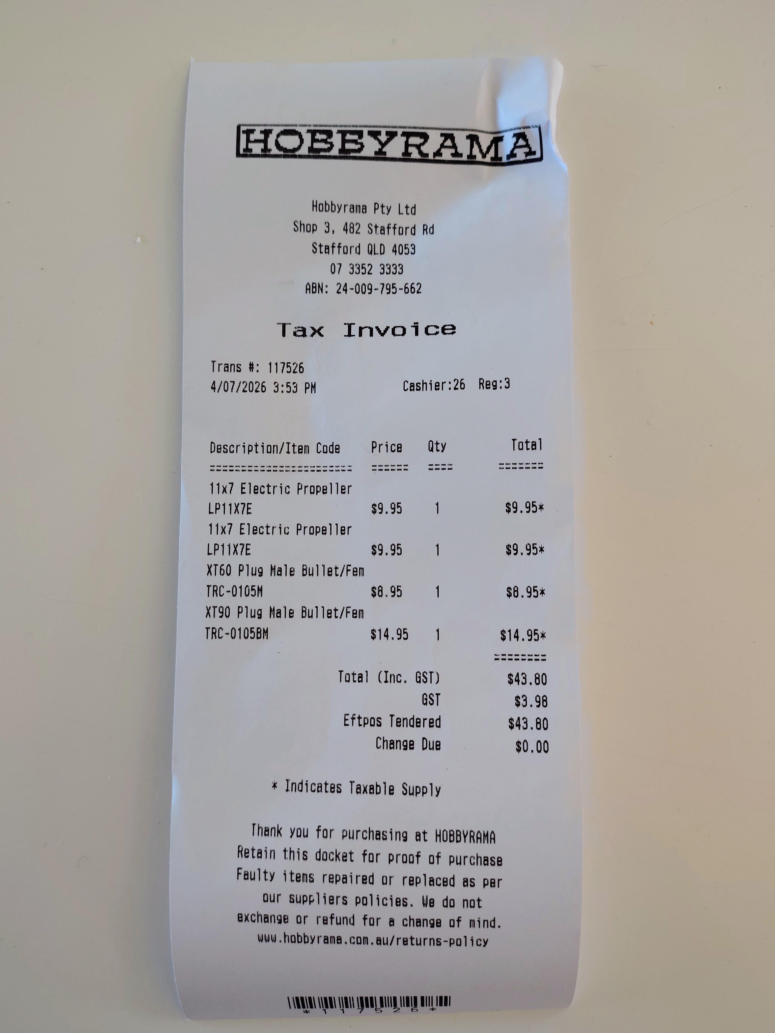
docs/governance/purchase-history/invoices/hobbyrama-propellers-2026-07-04.jpg
