SpicyTenderloin/believer/docs/engineering/analysis/launch-dolly-concept/out/believer-dolly-assembly.step

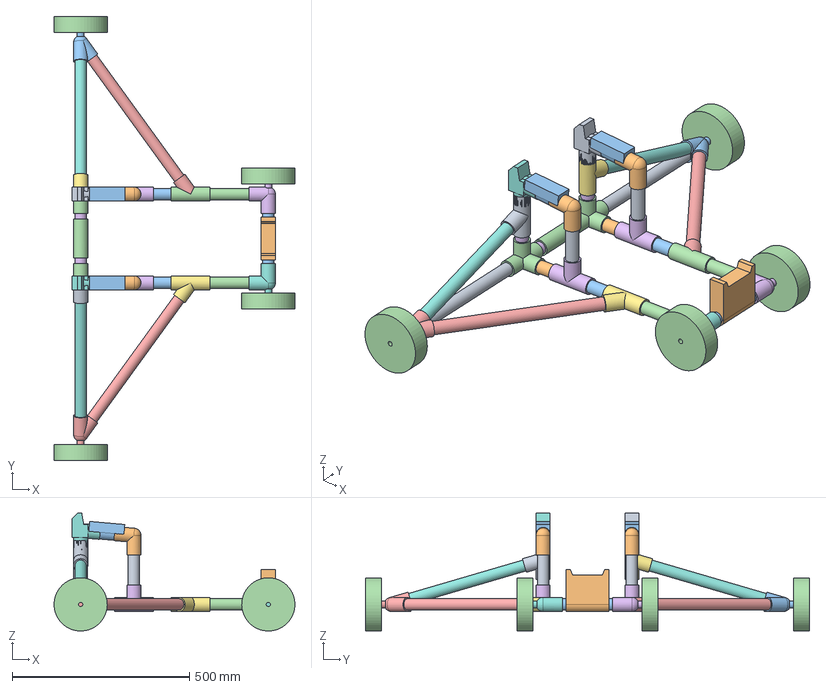
[picture p28: CAD file, 2026-11-05]
docs/engineering/analysis/launch-dolly-concept/out/believer-dolly-assembly.step
678.7 x 1250.8 x 332.3 mm
