SpicyTenderloin/believer/docs/engineering/analysis/launch-dolly-concept/out/printed-tail-cradle-v2-liner.stl

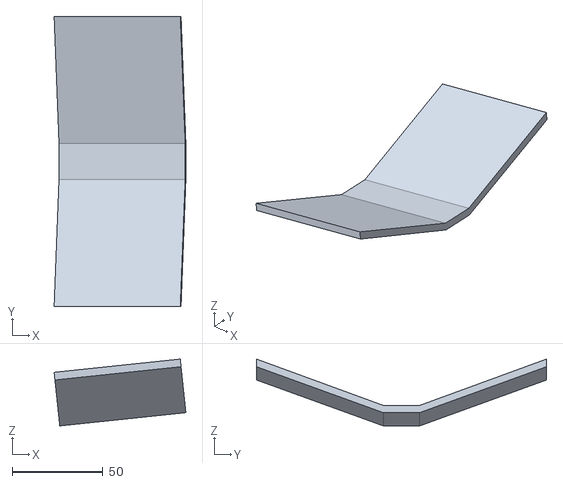
[picture p29: CAD file, 2026-11-09]
docs/engineering/analysis/launch-dolly-concept/out/printed-tail-cradle-v2-liner.stl
72.7 x 160.0 x 36.9
