SpicyTenderloin/believer/docs/engineering/analysis/launch-dolly-concept/out/printed-tail-cradle-v2.step

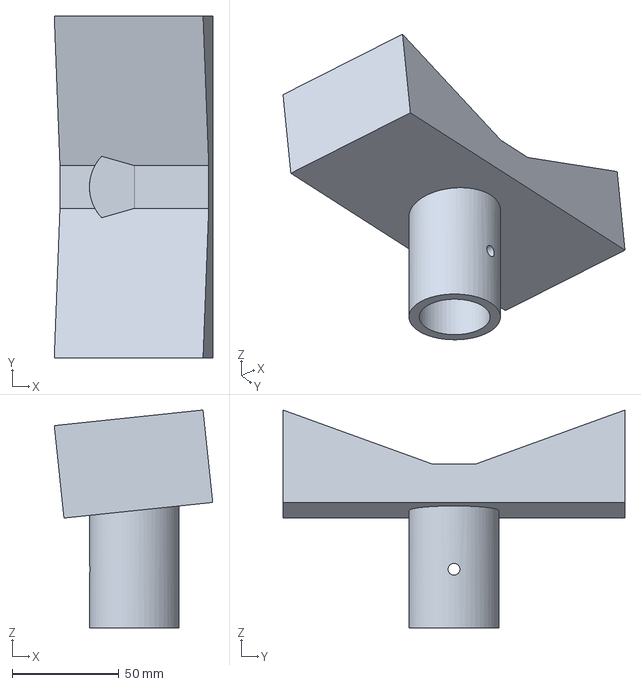
[picture p30: CAD file, 2026-11-09]
docs/engineering/analysis/launch-dolly-concept/out/printed-tail-cradle-v2.step
74.2 x 160.0 x 102.0 mm
