SpicyTenderloin/believer/docs/engineering/analysis/launch-dolly-concept/out/printed-pad_R.step

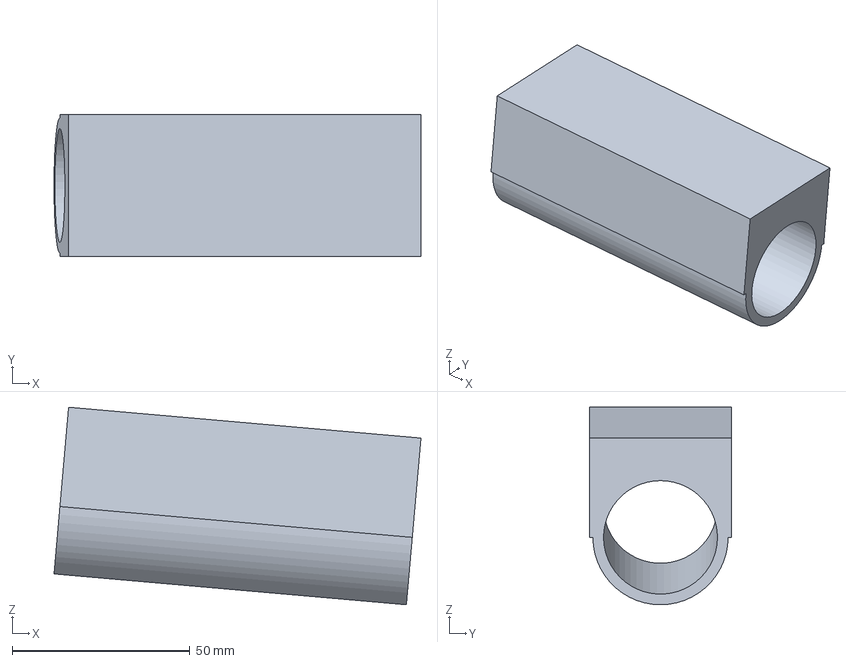
[picture p31: CAD file, 2026-11-05]
docs/engineering/analysis/launch-dolly-concept/out/printed-pad_R.step
103.1 x 40.0 x 55.5 mm
