SpicyTenderloin/believer/docs/engineering/analysis/launch-dolly-concept/out/printed-ramp_head_R.step

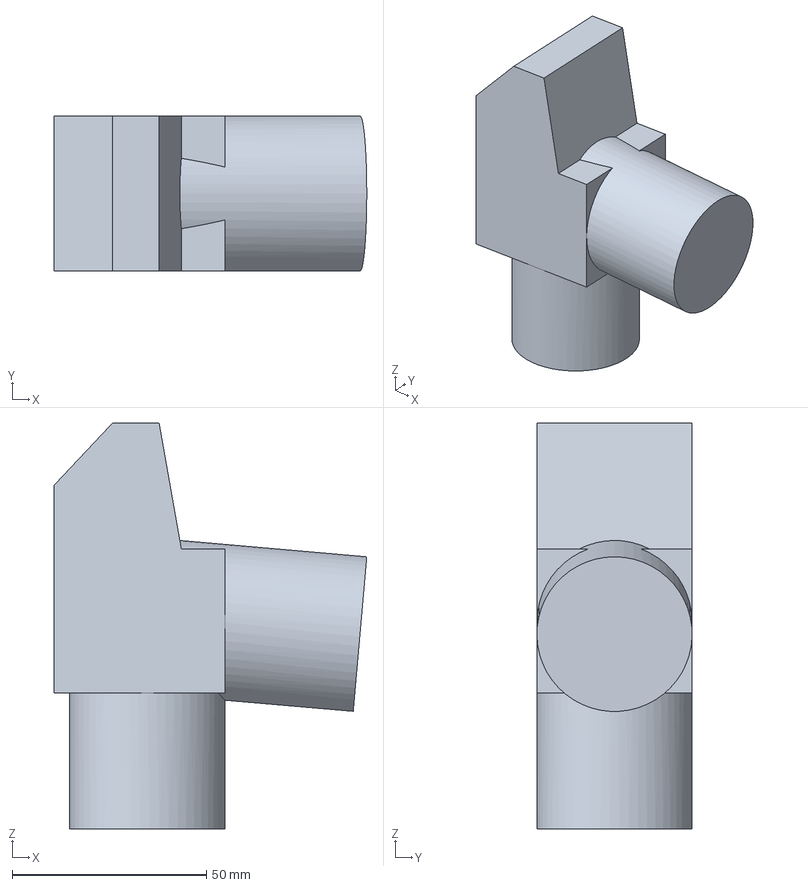
[picture p32: CAD file, 2026-11-05]
docs/engineering/analysis/launch-dolly-concept/out/printed-ramp_head_R.step
80.5 x 40.0 x 104.6 mm
