SpicyTenderloin/believer/docs/engineering/analysis/launch-dolly-concept/out/believer-envelope-at-rest.step

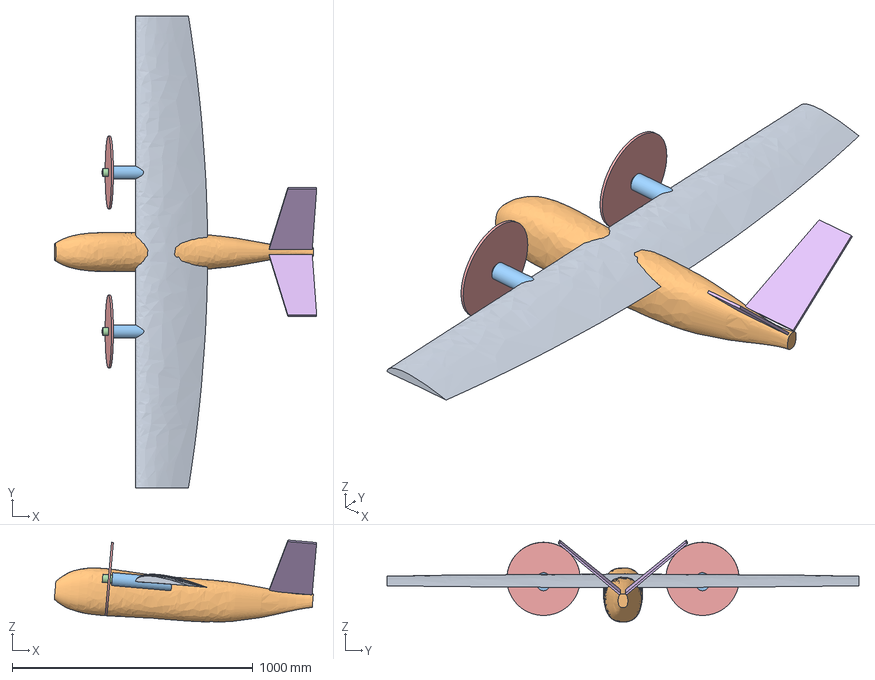
[picture p33: CAD file, 2026-11-05]
docs/engineering/analysis/launch-dolly-concept/out/believer-envelope-at-rest.step
1089.7 x 1960.0 x 340.2 mm
