SpicyTenderloin/believer/docs/engineering/analysis/launch-dolly-concept/out/printed-tail_cradle.step

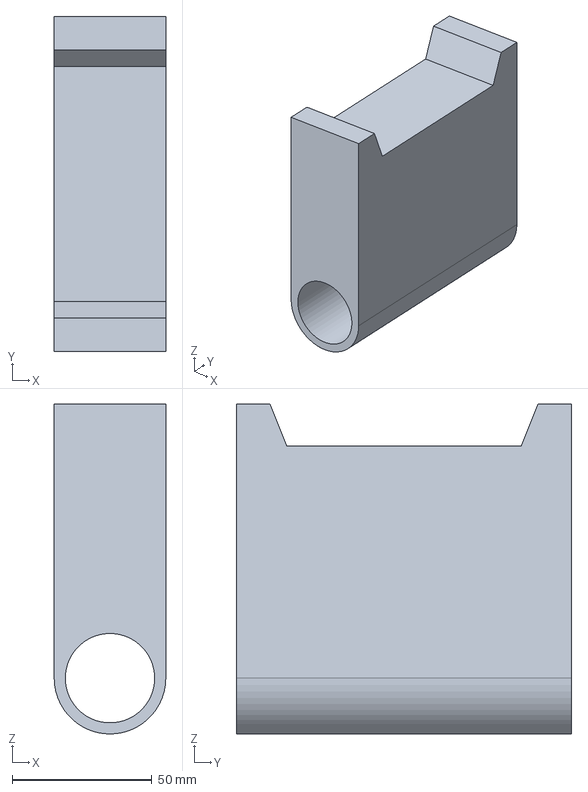
[picture p34: CAD file, 2026-11-05]
docs/engineering/analysis/launch-dolly-concept/out/printed-tail_cradle.step
40.0 x 120.0 x 118.2 mm
