SpicyTenderloin/believer/(list of files, cad)

Other CAD files:
docs/engineering/analysis/launch-dolly-concept/out/printed-pad_R.stl
docs/engineering/analysis/launch-dolly-concept/out/printed-ramp_head_R.stl
docs/engineering/analysis/launch-dolly-concept/out/printed-tail-cradle-v2.stl
docs/engineering/analysis/launch-dolly-concept/out/printed-tail_cradle.stl
