SpicyTenderloin/believer/docs/manual.md

# Believer Flight Manual

Operating manual for the Believer fixed-wing UAV. For wiring/pinout/parameter detail, see [ICD.md](ICD.md) and [../params/parameter-change-log.md](../params/parameter-change-log.md).

## 1. Aircraft Summary

V-tail, twin-motor (left/right) fixed wing, two independently-servoed ailerons. Holybro Pixhawk 6X flight controller running PX4. Centre of Gravity: 15mm aft of the front wing spar carbon rod centerline (~25% MAC).

## 2. RC Control - Channels & Switches

RC link: Radiomaster GX12 transmitter → DBR4 receiver (ExpressLRS, dual-band 2.4GHz/900MHz), Hybrid switch mode with MAVLink enabled.

| Channel | Function | Notes |
|---|---|---|
| CH1 | Roll | Stick |
| CH2 | Pitch | Stick |
| CH3 | Throttle | Stick |
| CH4 | Yaw | Stick |
| CH5 | Arm | Latching button; disarmed at startup |
| CH6 | GR1 flight-mode selector | Six positions; starts on SW2 |
| CH7 | Emergency kill | Inverted in EdgeTX |
| CH8 | Loiter / Hold | Latching button; overrides GR1-selected mode |
| CH9 | Flaperon control / spare | Inverted in EdgeTX; inactive for maiden flight |
| CH10 | Return | Inverted in EdgeTX |
| CH11 | Offboard | Inverted in EdgeTX |
| CH12 | Spare / future buzzer or payload | Currently unassigned |

For channels 7, 9, 10, 11: inversion is handled in EdgeTX already - do not add a duplicate reversal in PX4 unless QGroundControl shows the active/inactive direction is actually wrong.

GX12 front view with switch functions annotated

GX12 top view with switch functions annotated

## 3. Flight Modes (GR1 Switch Group)

GR1 is a six-button switch group on the GX12 (only one of SW1–SW6 active at a time), mapped to CH6 and used as the main PX4 flight-mode selector.

| GX12 Button | PX4 Mode | Behaviour | Use |
|---|---|---|---|
| SW1 | Manual | Sticks drive the control surfaces directly - no self-levelling | Direct-control backup; avoid for normal launch |
| SW2 | Stabilized | Centring the sticks levels the aircraft; altitude and heading drift freely | Startup/default and hand-launch mode |
| SW3 | Altitude | As Stabilized, plus altitude is held automatically; heading still drifts | Holds altitude; pilot still flies direction |
| SW4 | Position | As Altitude, plus GPS holds ground track against wind | GPS-assisted track/altitude holding |
| SW5 | Mission | Autonomous; flies a pre-uploaded waypoint mission | Future autonomous missions only |
| SW6 | Hold | Autonomous; circles the engagement point at the current altitude | Backup access to Loiter/Hold |

**Hold vs. Loiter:** these are the same PX4 mode - "Hold" is the formal PX4 name, "Loiter" is the older/common name still used in switch labelling. When engaged, the Believer flies a circle around the point where Hold was activated while holding altitude - it cannot stop and hover like a multirotor.

CH8 (Loiter/Hold) is a separate switch that overrides whatever mode GR1 has selected and commands Hold directly. CH10 (Return) similarly overrides GR1 and commands the aircraft to climb and fly back to the home position. CH11 (Offboard) overrides GR1 to hand control to a companion computer - not currently used, since that companion computer is a future project phase.

For full detail on each mode's behaviour and the PX4 parameters that configure it, see [`flight-modes.md`](flight-modes.md).

QGroundControl Flight Modes configuration

## 4. Pre-Flight Safety State

Intended safe startup condition, to be verified before every flight:

| Channel | State |
|---|---|
| CH5 (Arm) | Disarmed |
| CH6 (Flight mode) | SW2 selected: Stabilized |
| CH7 (Kill) | Inactive |
| CH8 (Loiter) | Inactive |
| CH9 (Flaperons) | Up / disabled |
| CH10 (Return) | Inactive |
| CH11 (Offboard) | Inactive |

## 5. Pre-Flight Checklist

### Site and conditions

1. Check the weather forecast. Confirm wind speed, gusts, and visibility are within acceptable limits for the planned flight.
2. Check NOTAMs and confirm the operating area and altitude are clear of airspace restrictions.

### Assembly and inspection

3. Remove airframe components from the carry box and inspect for damage incurred in transport.
4. Assemble the airframe, ensuring all connections are firmly engaged.
5. Reinspect the assembled airframe for damage.
6. Inspect the pitot tube. Confirm the tube is unobstructed (no insects, moisture, or transport tape covering the inlet) and the tubing to the airspeed sensor is securely connected.
7. Install the 900 MHz antennas to the external antenna ports; ensure they are correctly torqued and oriented to prevent damage.
8. Install the M8N GPS in its mount and torque to secure.
9. Connect the M8N GPS to the GPS 1 port on the Pixhawk flight computer.

### Power on and ground station

10. Power on the GX12 transmitter and confirm the throttle is at the minimum position and the kill switch is engaged.
11. Install the battery using the supplied straps and verify the centre of gravity is correct. Do not connect the battery to the power distribution board at this stage.
12. Connect the RFD900 ground station module to a laptop running QGroundControl.
13. Connect the battery to the power distribution board and establish a connection with QGroundControl.
14. Perform any flight computer calibration steps required.
15. Update `SENS_BARO_QNH` to the current ambient barometric pressure reading.
16. Confirm QGroundControl reports no warnings.
17. Confirm sufficient battery capacity remains for the planned flight.
18. Confirm the home position is set correctly in QGroundControl. This is the point the aircraft will return to on an RTL or failsafe event.
19. Confirm the geofence is loaded and active in QGroundControl, and that the breach action is set to Return.
20. Confirm RC link signal quality (RSSI) is good in QGroundControl before proceeding.

### Ground functional checks (propellers removed)

21. With propellers removed, arm the vehicle in Manual mode.
22. Confirm all flight control surfaces are correctly trimmed and respond appropriately to control inputs: verify correct direction of movement, full and unrestricted travel across the entire stick range, and that all travel limits are set correctly.
23. Switch to Stabilized mode and confirm all flight control surfaces respond appropriately to changes in aircraft attitude.
24. Confirm the motors rotate in the correct direction. Viewed from behind the aircraft looking forward, the left-hand motor must rotate anticlockwise and the right-hand motor must rotate clockwise (see [assets/motor-rotation-direction.png](assets/motor-rotation-direction.png)).
25. Confirm the aircraft can be switched into all flight modes via the GR1 selector (see [assets/gx12-front-switches.png](assets/gx12-front-switches.png) and [assets/gx12-top-switches.png](assets/gx12-top-switches.png)), and that each mode change is mirrored correctly in QGroundControl (see [assets/flight-modes-config.png](assets/flight-modes-config.png)).
26. Confirm QGroundControl reacts appropriately to changes in aircraft attitude.
27. Blow gently on the pitot tube inlet and confirm QGroundControl shows a non-zero airspeed reading. Release and confirm the reading returns to zero.
28. Disarm the vehicle before proceeding.

### Pre-launch

29. Install and torque the propellers.
30. Confirm propeller retention nuts are correctly torqued on both motors. The left-hand motor rotates clockwise when viewed from the front - its retention nut is reverse-threaded and must be inspected with particular care.
31. Confirm GPS has acquired a 3D fix with an appropriate number of satellites and HDOP before arming for flight.

### Assisted hand launch

Two people are required: a **pilot** operating the GX12 and a **handler** who holds and throws the aircraft. The handler must not approach the aircraft until the pilot signals ready.

32. Confirm the launch area and airspace overhead are clear of people, animals, obstructions, and other aircraft.
33. Pilot: select Stabilized mode (GR1 SW2) and confirm throttle is at minimum.
34. Handler: hold the aircraft at shoulder height with the nose pointing directly into wind. Grip the fuselage firmly at the centre of gravity. Keep all fingers and hands well clear of both propeller arcs.
35. Pilot: arm the aircraft (CH5) and advance throttle to approximately 75-100%.
36. Pilot: call "launch" (or pre-agreed signal).
37. Handler: throw the aircraft firmly forward and level into the wind, releasing cleanly. Step clear immediately after release.
38. Pilot: hold Stabilized mode and allow the aircraft to accelerate and establish a positive climb rate before commanding a steep climb. Do not pull hard back on the stick immediately after release.
39. Climb to a safe altitude and confirm wings-level flight before switching modes or adjusting course.

See also [build-checklist.md](build-checklist.md) for the build, retention, and configuration checklist.
