SpicyTenderloin/believer/docs/assets/livery/out/print/id-A1.pdf

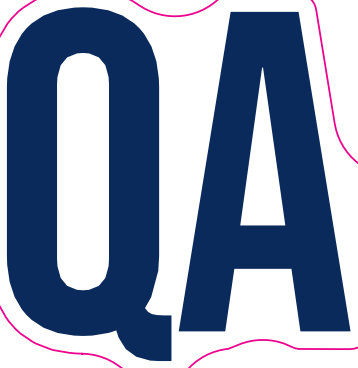
[picture p35: figure]
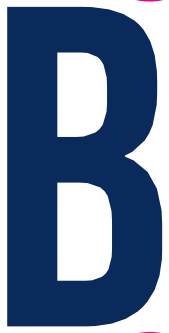
[picture p36: figure]
