SpicyTenderloin/believer/docs/assets/livery/out/print/id-A2.pdf

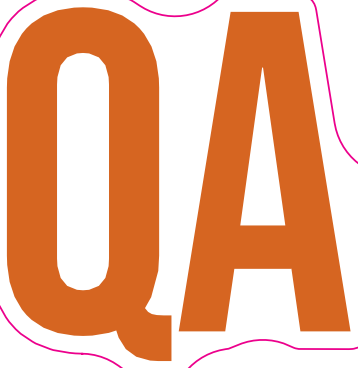
[picture p37: figure]
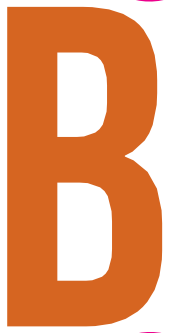
[picture p38: figure]
