SpicyTenderloin/believer/docs/assets/diagrams/makeflyeasy-believer-three-view.png

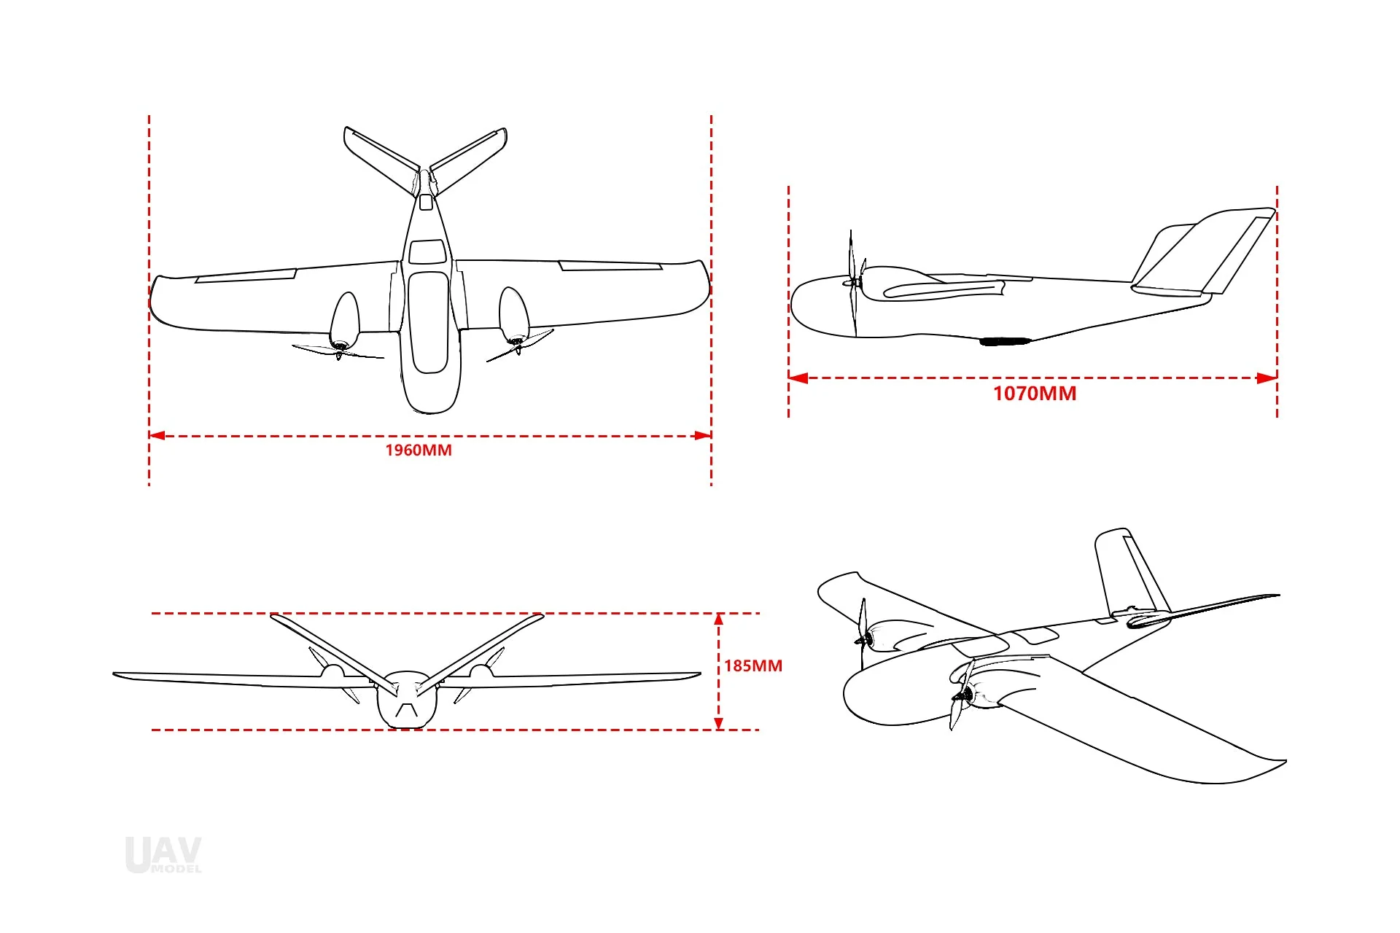
docs/assets/diagrams/makeflyeasy-believer-three-view.png
