SpicyTenderloin/believer/docs/operations/Pixhawk Flight Log Backup/README.md

# Pixhawk Flight Log Backup

Raw PX4 `.ulg` flight and bench-test logs, pulled from the Pixhawk's onboard SD card and kept here so the findings in `docs/engineering/test-reports/` remain reproducible without depending on the physical SD card.

Keep the original PX4 filename (e.g. `23_02_07.ulg`) - it is the log's own boot-session identifier and is referenced by that name throughout the test reports, `context/project-notes.md`, and `docs/operations/Pixhawk Parameter Backup/parameter-change-log.md`.

## Pending

- `23_02_07.ulg` - the 2026-10-11 maiden flight log (23:02-23:27 UTC / 09:02-09:27 Brisbane local). Not yet added - Julian to copy in from the SD card. See `docs/engineering/test-reports/2026-10-11-maiden-flight.md`.
