SpicyTenderloin/believer/Component datasheets/tmotor-u5-kv400-motor-test-report.pdf

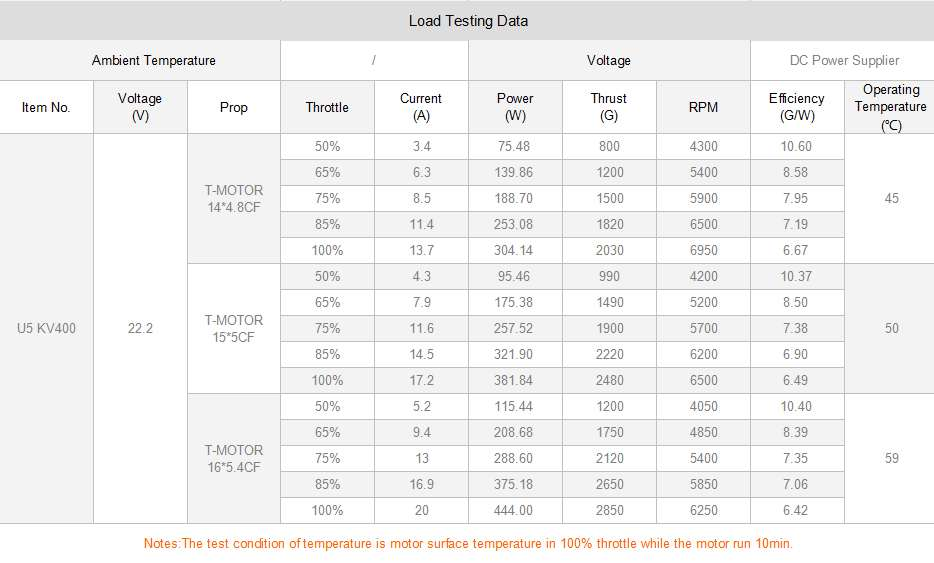
[picture p59: figure]
