SpicyTenderloin/believer/docs/engineering/analysis/Motor Testing/MN3110_11_7/1000_1708.csv

Time (s) | ESC signal (µs) | Servo 1 (µs) | Servo 2 (µs) | Servo 3 (µs) | Thrust (kgf) | Voltage (V) | Current (A) | Motor Electrical Speed (RPM) | Motor Optical Speed (RPM) | Electrical Power (W) | Overall Efficiency (kgf/W) | Thrust Load Cell (mV) | Burst Current Cutoff (A) | Pin State 1 | Pin State 2 | Pin State 3 | Pin State 4 | Debug 0 | Debug 1 | Debug 2 | Debug 3 | App message
0 | 1000 |  |  |  |  | 23.50853780335462 | -0.00770617907416225 | 0 | 0 | 0.18116100208436356 |  |  | 0 | 0 | 1 | 1 | 1 | 0 | 0 | 0 | 0
0 | 1000 |  |  |  |  | 23.508923573150966 | -0.007583770004295181 | 0 | 0 | 0.17828626942733017 |  |  | 0 | 0 | 1 | 1 | 1 | 0 | 0 | 0 | 0
0.031 | 1000 |  |  |  |  | 23.509157002153334 | -0.0022240721193034357 | 0 | 0 | 0.05228606063681637 |  |  | 0 | 0 | 1 | 1 | 1 | 0 | 0 | 0 | 0
0.072 | 1000 |  |  |  |  | 23.50914878668048 | -0.0052364203808051716 | 0 | 0 | 0.12310378584195483 |  |  | 0 | 0 | 1 | 1 | 1 | 0 | 0 | 0 | 0
0.102 | 1000 |  |  |  |  | 23.509832902837907 | -0.006729518844899942 | 0 | 0 | 0.1582098635600964 |  |  | 0 | 0 | 1 | 1 | 1 | 0 | 0 | 0 | 0
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
