SpicyTenderloin/believer/docs/engineering/analysis/Motor Testing/MN3110_11_7/1000_1740.csv

Time (s) | ESC signal (µs) | Servo 1 (µs) | Servo 2 (µs) | Servo 3 (µs) | Thrust (kgf) | Voltage (V) | Current (A) | Motor Electrical Speed (RPM) | Motor Optical Speed (RPM) | Electrical Power (W) | Overall Efficiency (kgf/W) | App message
0 | 1000 |  |  |  |  | 25.125295406394834 | 0.030373533612068362 | 0 | 0 | 0.7631440045392803
0 | 1000 |  |  |  | -0.0005653864927328101 | 25.125296454574915 | 0.03435812936179415 | 0 | 0 | 0.8632581858397129 | 0
0.09000499999997555 | 1000 |  |  |  |  | 25.125155576870405 | 0.039147655201711894 | 0 | 0 | 0.9835909274126913
0.053 | 1000 |  |  |  |  | 25.12431582222647 | 0.03874592207715887 | 0 | 0 | 0.9734647830899166
0.12300500000000465 | 1000 |  |  |  | -0.0004072323062654381 | 25.124980989199365 | 0.03824464009362804 | 0 | 0 | 0.9608958552911763 | 0
0.16600500000000465 | 1000 |  |  |  |  | 25.124946235236642 | 0.03981651631230586 | 0 | 0 | 1.0003878316211074
0.1949999999999709 | 1000 |  |  |  |  | 25.12506806312831 | 0.035592580643744876 | 0 | 0 | 0.8942660112164732
0.239 | 1000 |  |  |  |  | 25.124383220966358 | 0.03623527339523864 | 0 | 0 | 0.9103888948984623
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
