SpicyTenderloin/believer/docs/engineering/analysis/Motor Testing/MN3110_11_7/1000_1787.csv

Time (s) | ESC signal (µs) | Servo 1 (µs) | Servo 2 (µs) | Servo 3 (µs) | Thrust (kgf) | Voltage (V) | Current (A) | Motor Electrical Speed (RPM) | Motor Optical Speed (RPM) | Electrical Power (W) | Overall Efficiency (kgf/W) | Thrust Load Cell (mV) | Burst Current Cutoff (A) | Pin State 1 | Pin State 2 | Pin State 3 | Pin State 4 | Debug 0 | Debug 1 | Debug 2 | Debug 3 | App message
0 | 1000 |  |  |  |  | 24.634140356775113 | -0.005391595226858057 | 0 | 0 | 0.13281731356534016 |  |  | 0 | 0 | 1 | 1 | 1 | 0 | 0 | 0 | 0
0 | 1000 |  |  |  |  | 24.63378802364601 | -0.0031249820140738056 | 0 | 0 | 0.0769801445124005 |  |  | 0 | 0 | 1 | 1 | 1 | 0 | 0 | 0 | 0
0.034 | 1000 |  |  |  | -0.00039967479852891 | 24.63371290170745 | -0.0009034768747594839 | 0 | 0 | 0.022255989946157025 | 0 | 0.24802313389596198 | 0 | 0 | 1 | 1 | 1 | 0 | 0 | 0 | 0
0.067 | 1000 |  |  |  |  | 24.633241168298984 | -0.00046060086706991454 | 0 | 0 | 0.011346092240860826 |  |  | 0 | 0 | 1 | 1 | 1 | 0 | 0 | 0 | 0
0.096 | 1000 |  |  |  |  | 24.633461824946515 | 0.001315827762308115 | 0 | 0 | 0.03241339295102175 |  |  | 0 | 0 | 1 | 1 | 1 | 0 | 0 | 0 | 0
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
