SpicyTenderloin/believer/docs/engineering/analysis/Motor Testing/MN3110_12_6/Log_2026-09-15_175037.csv

Time (s) | ESC signal (µs) | Servo 1 (µs) | Servo 2 (µs) | Servo 3 (µs) | Thrust (kgf) | Voltage (V) | Current (A) | Motor Electrical Speed (RPM) | Motor Optical Speed (RPM) | Electrical Power (W) | Overall Efficiency (kgf/W) | Thrust Load Cell (mV) | Burst Current Cutoff (A) | Pin State 1 | Pin State 2 | Pin State 3 | Pin State 4 | Debug 0 | Debug 1 | Debug 2 | Debug 3 | App message
0 | 1000 |  |  |  |  | 25.15024813050111 | 0.014200571304848426 | 0 | 0 | 0.35714789191181184 |  |  | 0.011360253698282372 | 0 | 1 | 1 | 1 | 0 | 0 | 0 | 0
0 | 1000 |  |  |  |  | 25.15062749985652 | 0.01892510514371301 | 0 | 0 | 0.4759782698651445 |  |  | 0.01170918218708081 | 0 | 1 | 1 | 1 | 0 | 0 | 0 | 0
0.049005000000004656 | 1000 |  |  |  | 0.0021437234088434428 | 25.150038788757833 | 0.020559305096006078 | 0 | 0 | 0.5170673206344595 | 0 | 0.25794953509852137 | 0.01192434292161599 | 0 | 1 | 1 | 1 | 0 | 0 | 0 | 0
0.093 | 1000 |  |  |  |  | 25.149429878355395 | 0.01867816585239227 | 0 | 0 | 0.46974522236103167 |  |  | 0.011933030947194273 | 0 | 1 | 1 | 1 | 0 | 0 | 0 | 0
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
