SpicyTenderloin/believer/docs/engineering/analysis/Motor Testing/MN3110_12_6/Log_2026-09-15_175051.csv

Time (s) | ESC signal (µs) | Servo 1 (µs) | Servo 2 (µs) | Servo 3 (µs) | Thrust (kgf) | Voltage (V) | Current (A) | Motor Electrical Speed (RPM) | Motor Optical Speed (RPM) | Electrical Power (W) | Overall Efficiency (kgf/W) | Thrust Load Cell (mV) | Burst Current Cutoff (A) | Pin State 1 | Pin State 2 | Pin State 3 | Pin State 4 | Debug 0 | Debug 1 | Debug 2 | Debug 3 | App message
0 | 1000 |  |  |  |  | 25.148787083319963 | 0.00000790470392406789 | 0 | 0 | 0 |  |  | 0.010189016450097375 | 0 | 1 | 1 | 1 | 0 | 0 | 0 | 0
0.036 | 1000 |  |  |  |  | 25.149181812101673 | -0.0005425985387563664 | 0 | 0 | 0.013645909302164555 |  |  | 0 | 0 | 1 | 1 | 1 | 0 | 0 | 0 | 0
0 | 1000 |  |  |  | 0.001027424927438161 | 25.148951609093217 | 0.0003214238708878171 | 0 | 0 | 0 | 0 | 0.2590436171497935 | 0.010092003513820285 | 0 | 1 | 1 | 1 | 0 | 0 | 0 | 0
0.0709950000000099 | 1000 |  |  |  |  | 25.149257927959884 | 0.005703402940497031 | 0 | 0 | 0.14343635161764468 |  |  | 0.010173209601663478 | 0 | 1 | 1 | 1 | 0 | 0 | 0 | 0
0.1129950000000099 | 1000 |  |  |  |  | 25.149080842400167 | 0.0023936324245755363 | 0 | 0 | 0.06019765535264048 |  |  | 0 | 0 | 1 | 1 | 1 | 0 | 0 | 0 | 0
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
