SpicyTenderloin/believer/docs/assets/test-plots/launch-profile-first-20s-2026-10-11.png

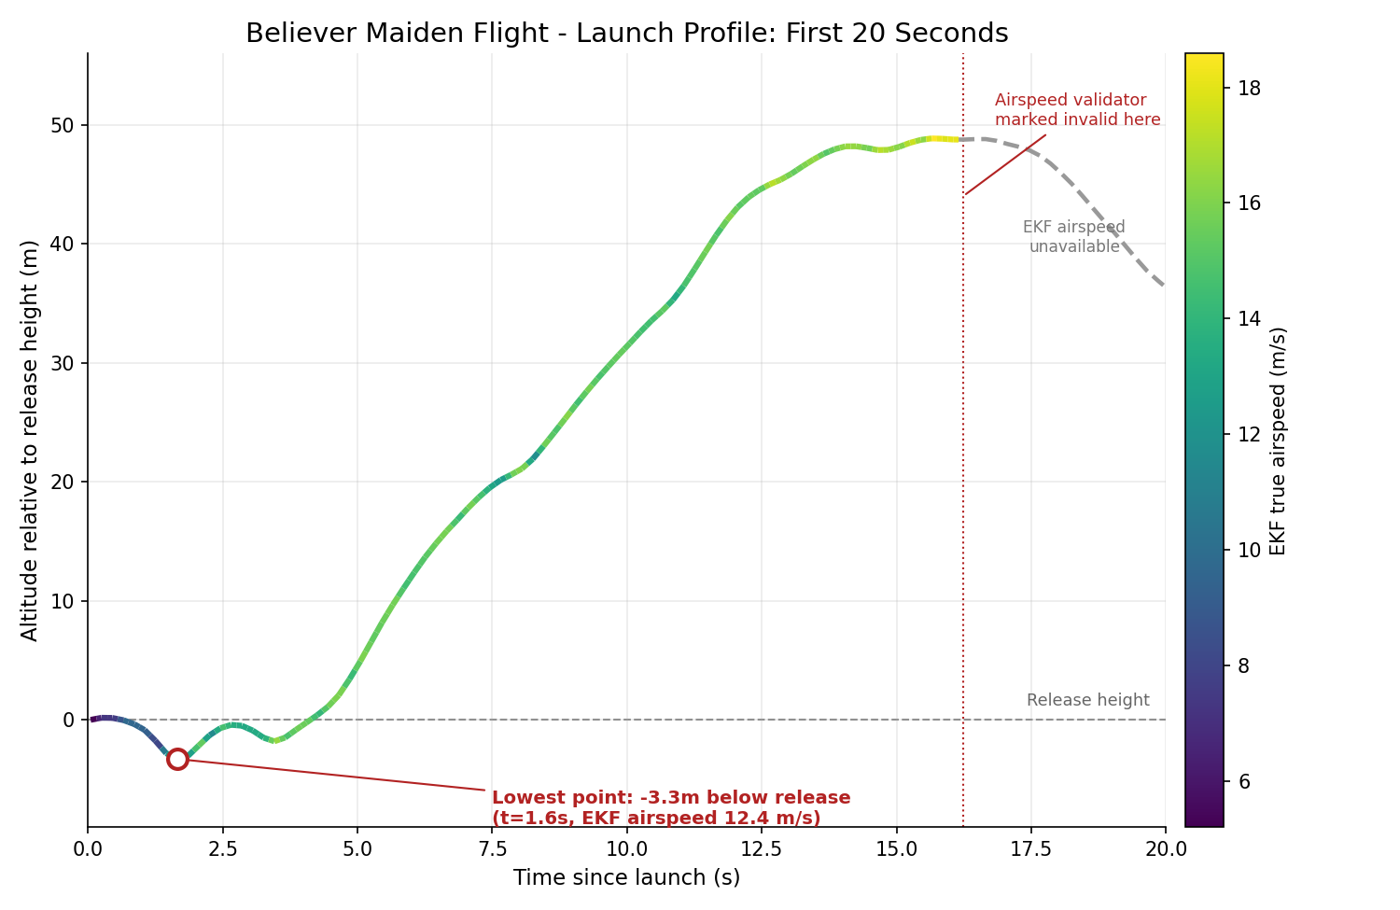
docs/assets/test-plots/launch-profile-first-20s-2026-10-11.png
