SpicyTenderloin/believer/docs/assets/test-plots/maiden-flight-speed-2d-vs-3d-2026-10-11.png

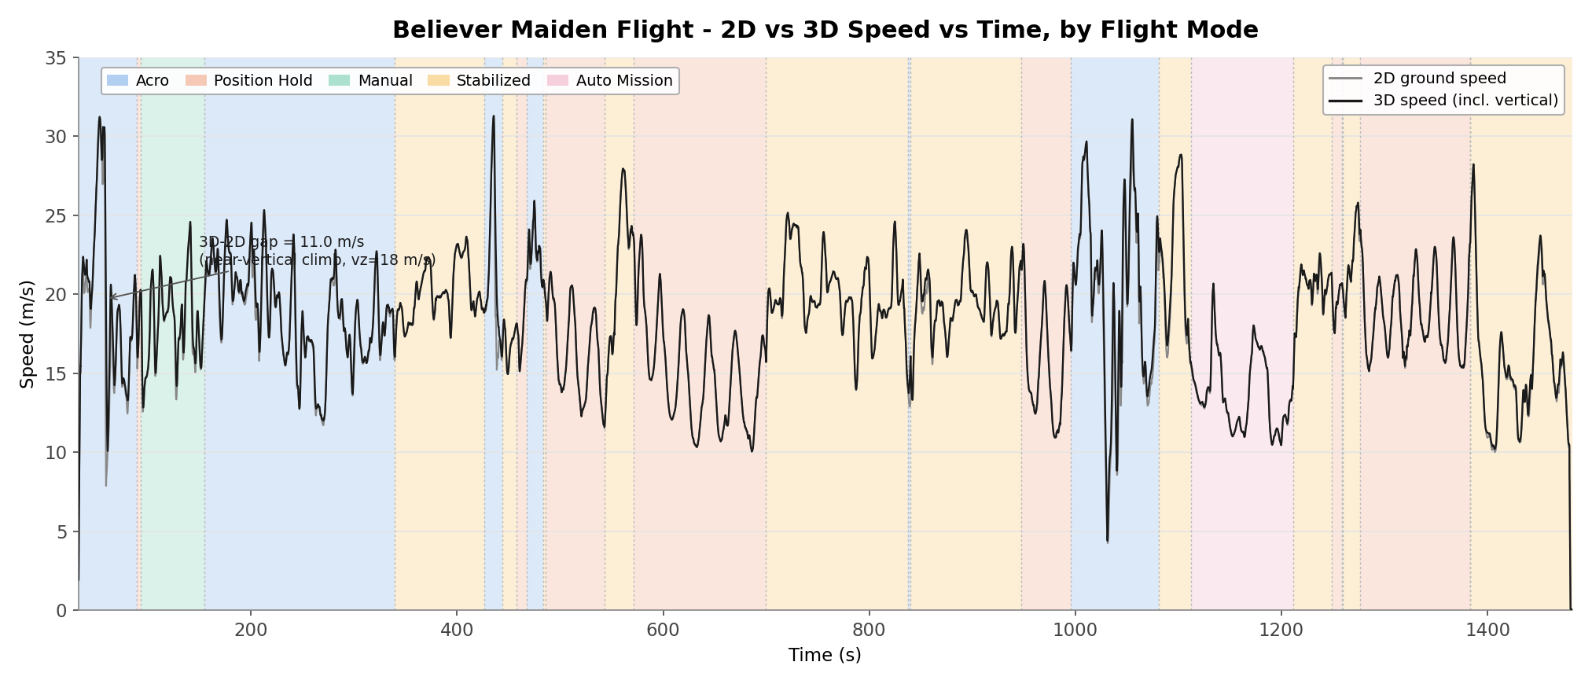
docs/assets/test-plots/maiden-flight-speed-2d-vs-3d-2026-10-11.png
