SpicyTenderloin/believer/docs/assets/test-plots/maiden-flight-speed-by-mode-2026-10-11.png

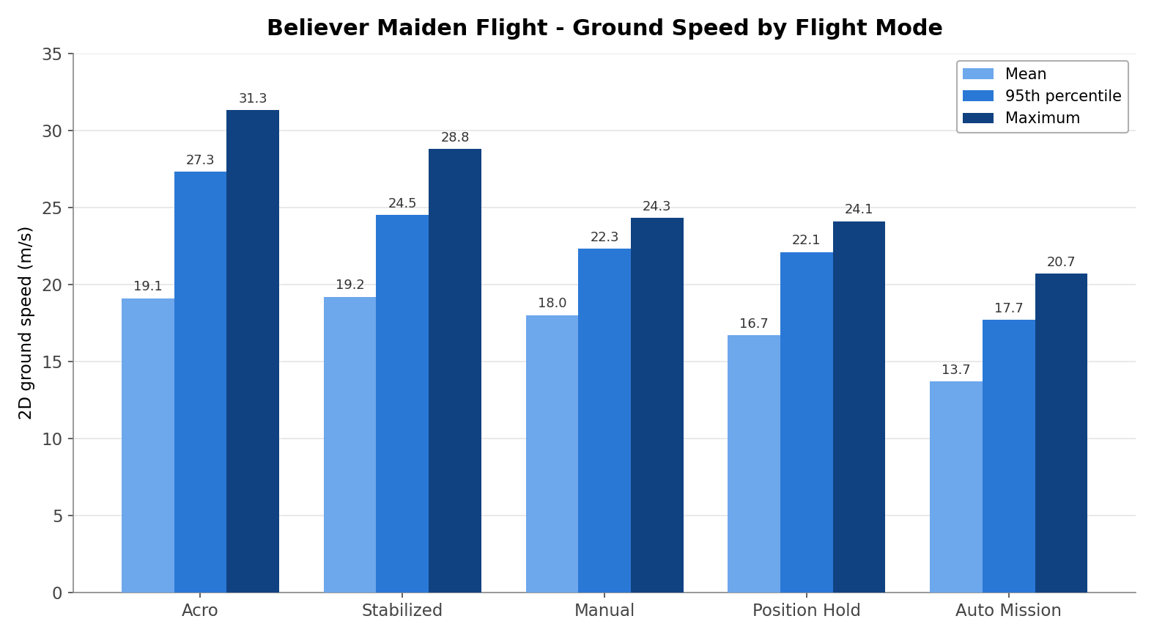
docs/assets/test-plots/maiden-flight-speed-by-mode-2026-10-11.png
