SpicyTenderloin/believer/docs/engineering/analysis/Motor Testing/MN3110_11_7/Current vs ESC Signal.png

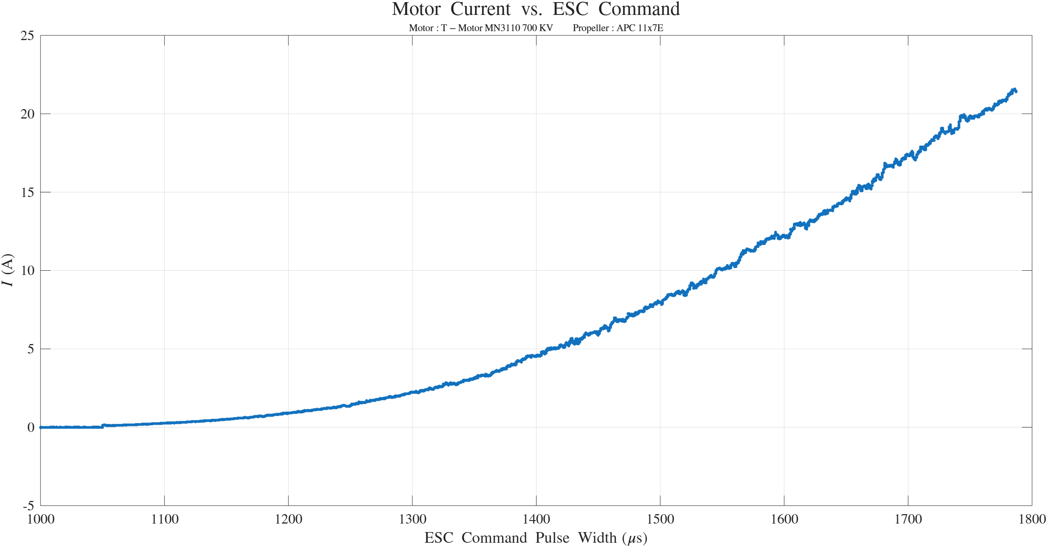
docs/engineering/analysis/Motor Testing/MN3110_11_7/Current vs ESC Signal.png
