SpicyTenderloin/believer/docs/engineering/analysis/Motor Testing/MN3110_11_7/Thrust vs ESC Signal.png

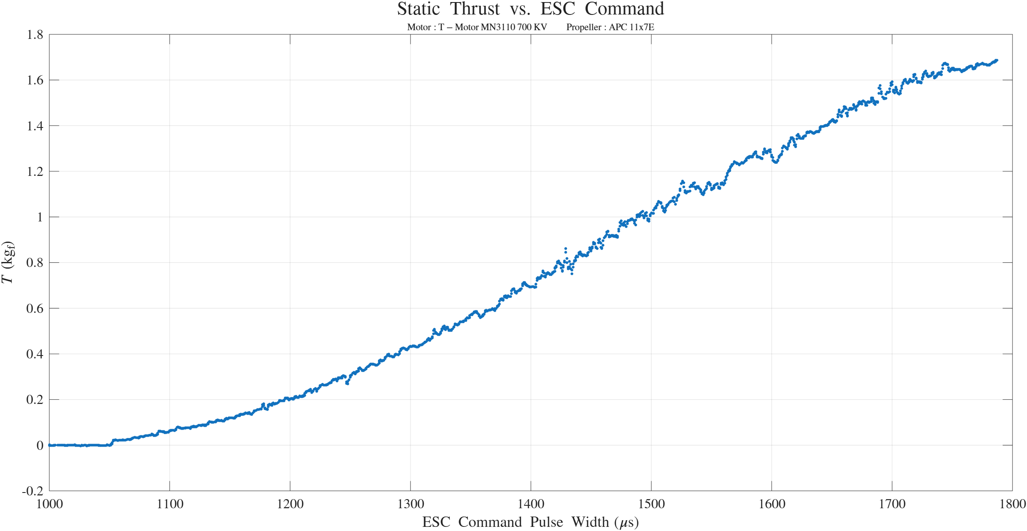
docs/engineering/analysis/Motor Testing/MN3110_11_7/Thrust vs ESC Signal.png
