SpicyTenderloin/believer/docs/engineering/analysis/Motor Testing/MN3110_12_6/Current vs ESC Signal.png

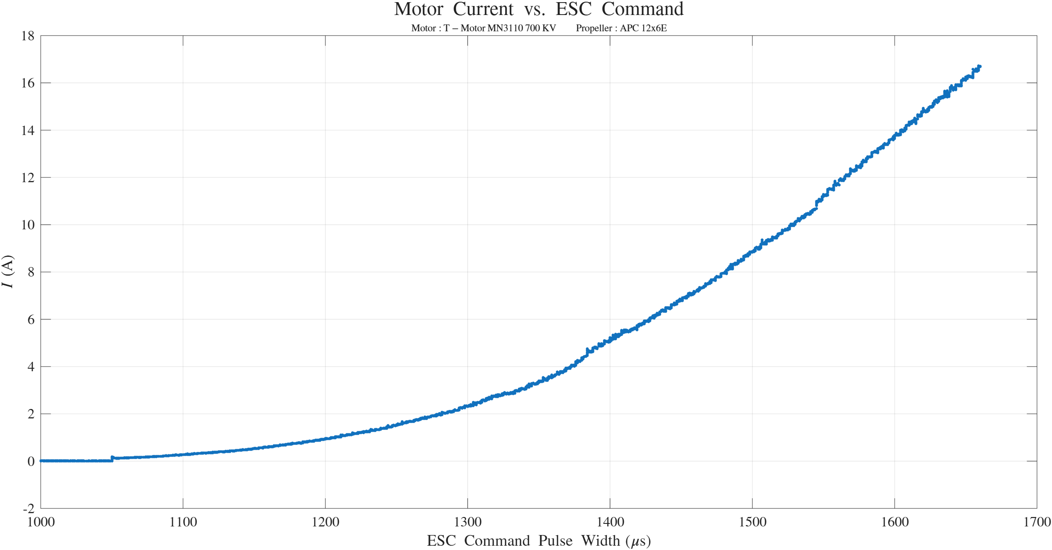
docs/engineering/analysis/Motor Testing/MN3110_12_6/Current vs ESC Signal.png
