SpicyTenderloin/believer/AI-context/CHANGELOG.md

# Changelog

All notable changes to the Believer project repo are logged here, most recent first.

## 2026-11-09
- `docs/engineering/requirements/launch-dolly-requirements.md` (rev 0.7): REQ-DOL-01 now also requires the dolly not to tip sideways. Julian wants stability stated as the requirement, with outrigger front wheels added only if the Fusion design proves to need them, so the Section 3c front-wheel row and rail spacing are left as they were for now. Section 3c's rear-wheel row is updated from Julian's latest Fusion side view: 580 mm axle to axle and wheels about 218 mm over the tread (scaled from the screenshot), with the tail post on the rear axle line and the cradle about 10 mm ahead of it, still about 600 mm aft of the wing LE. The tail-support belly heights above ground rise by 11 mm (257 to 268 mm at the cradle). `launch-dolly-conops.png` is rescaled to the same wheelbase and wheel size.
- Redrew `docs/assets/diagrams/launch-dolly-conops.png` to match the current Fusion dolly model: the tail support is now drawn as the V-cradle on its centreline post (top 6 deg, higher at the rear), both wheels are the five-spoke printed wheels, and the caption no longer refers to an outrigger wheel. Geometry is otherwise unchanged from the 2026-11-05 side-view fit (rear axle 570 mm aft of the front cross member, wheel about 196 mm). `rear-support-fit/conops_image.py` now uses Inter if installed, otherwise Segoe UI, otherwise DejaVu Sans.

## 2026-11-05
- Launch dolly, per Julian: designed the tail support from the rear view. New `docs/engineering/analysis/launch-dolly-concept/tail_cradle.py` generates sheet BLV-DOL-007 (section at the rear axle looking forward, cradle section and side, 1:3 and 1:2; also `docs/assets/diagrams/launch-dolly-BLV-DOL-007.png`) and the printable cradle (`out/printed-tail-cradle-v2.step/.stl`, TPU liner `-liner.stl`). A 160 mm wide V-cradle with 20 deg flanks and a 4 mm TPU liner, top inclined 6 deg to match the belly, on a 32 mm post with an M5 cross-bolt for +/-20 mm height adjustment, in a tee on the rear cross member; V apex 153 mm above the axle so the belly bottom sits 160 mm above it. The fuselage section at the station (assumed 130 x 65 mm, rounded) is TBD - the manufacturer drawing's top and front views are not to scale. SRD Section 3c configuration row updated.
- Launch dolly, per Julian: completed the concept with a front wheel each side on an outrigger braced by three members (outrigger arm from the front corner tee, horizontal brace back to the rail tee, vertical strut up to a tee on the front upright), outboard of the prop discs. New `docs/engineering/analysis/launch-dolly-concept/dolly_v2_model.py` (CadQuery model of Julian's Fusion side frames plus the outriggers; rail spacing 340 mm and outrigger geometry are TBD) and `dolly_v2_sheet.py`, which writes concept-view sheet BLV-DOL-006 (front and rear isometrics, plan, side and front views, key data) to `out/` and `docs/assets/diagrams/launch-dolly-BLV-DOL-006.png`. On the manufacturer drawing's propeller position the ramp lips sit about 44 mm behind the prop discs (75 mm wanted), flagged in the SRD and open items. Redrew `docs/assets/diagrams/launch-dolly-conops.png` for the tail-rise concept Julian intends: the tail lifts off its support as airspeed builds and the aircraft pitches nose-down about the leading edges to a lower AoA, then lifts over the ramp lips; attitude gauges show the AoA in each phase and the lift equation was removed. SRD Section 3c launch sequence, configuration table and Sections 5-6 updated to match (lift-off speed now depends on the AoA reached during the tail rise: about 12.4 m/s at 5 deg, 16 m/s at 2 deg); project notes and open items updated.
- `docs/engineering/requirements/launch-dolly-requirements.md` (rev 0.6): updated the concept of operations to Julian's wing-saddle dolly with ramp stops, replacing the tail-rising single-cradle concept that Section 3c recorded as decided. Section 3c now gives the configuration (two side frames with 5 deg wedge trays inboard of the motors, 30 mm ramp lips, centreline tail support at the rear axle station, rear wheels 570 mm aft of the front cross member), the tail-support height estimate (142 mm above the rail top at about 600 mm aft of the wing LE), and a launch sequence with the lift-off speed (12.4 m/s at a 5 deg resting angle, 4.0 kg) and the release angle over the lip (about 8 deg, against an estimated 11.5 deg stall), illustrated by a new six-panel concept-of-operations image, `docs/assets/diagrams/launch-dolly-conops.png` (set-up, ground roll, lift-off, release, separation, recovery; side view to scale, generated by `rear-support-fit/conops_image.py`). Section 2, Section 3b's separation-AoA note, REQ-DOL-10 and Sections 5 and 6 updated to match; the side-view fit image is copied to `docs/assets/diagrams/launch-dolly-side-fit.png`. Decision history added to `AI-context/project-notes.md` and the dolly line in `AI-context/open-items.md` rewritten for the new open items (wing incidence, final tail-support height, belly profile, front wheels, prop clearance, separation path).
- Added `docs/engineering/analysis/launch-dolly-concept/rear-support-fit/`, per Julian, to size the rear (tail) support on his Fusion dolly (revision with the rear section moved forward): the manufacturer side view is scaled 1:1 onto his side-view screenshot, calibrated from his Fusion measurement of 570.35 mm between the 40 mm circles at the rear axle and front cross (0.957 mm/px). The wing root rests on the 5.2 deg tray, LE 3 mm behind the ramp, 2 mm TPU. Assuming the wing underside is parallel to the drawing's fuselage datum, the belly at the rear axle station (about 600 mm aft of the wing LE) is about 142 mm above the rail top (160 mm above the rail and axle centreline, 257 mm above ground) and slopes up toward the tail at about 6 deg. Each 1 deg of wing-to-fuselage angle moves this by about 10 mm (TBD: measure on the aircraft), so the support should be height-adjustable. A first estimate earlier the same day assumed 1.0 mm/px from the tube size and read about 16 mm low. Outputs `rear-support-fit.png`, scripts `fit_side_view.py` and `render_fit.py`.
- Converted the MakeFlyEasy Believer three-view (`MFE_Believer_1960_*.webp`, dropped in the repo root by Julian) to PNG and filed it as `docs/assets/diagrams/makeflyeasy-believer-three-view.png`. It is a manufacturer line drawing with span, length and height dimensions; chords scaled from it give a wing area about 20% below the 51 dm2 specification, so it is not reliable for chord or height measurements. The original `.webp` in the repo root still needs deleting.
- Added `docs/assets/livery/` (vinyl sticker artwork), per Julian: `make_stickers.py` generates a vector QUTAS arrow icon (rebuilt from the supplied logo as six flat triangles in three colours), a wingtip sticker (icon over "QUTAS", 72 x 108 mm) and a fuselage-side marking "BLV <icon> 01" (45 mm cap height, 192 x 55 mm), as print-and-cut SVG and PDF with a CutContour layer, plus a to-scale mockup on the three-view. Lettering is Barlow Condensed Bold (SIL Open Font License, font and licence included alongside).
- `docs/assets/livery/`: added `livery_options.py` and two option boards in `out/`, per Julian, who rejected the "QUTAS" lettering on the wingtip sticker and the Barlow font for the side marking. `options-wingtip-roundels.png` shows five wingtip options at 130 mm (logo alone; logo in a navy roundel; logo in a navy and orange roundel; navy/white/orange bullseye; navy/light-orange/dark-orange bullseye). `options-side-codes.png` shows the warbird-style code "QA <icon> BLV" at 45 mm in six fonts (Anton, Bebas Neue, Black Ops One, Saira Stencil One, Stardos Stencil, Allerta Stencil; all SIL OFL, files and licences in `fonts/`), each in navy and orange. All options are mocked to scale on the three-view. No design chosen yet.
- `docs/assets/livery/`: added `mockup.py`, per Julian. It removes the dimension lines from the three-view (`out/three-view-clean.png`, with the outline redrawn where a dashed line overlapped it) and draws the as-built details from a photo of the aircraft: orange tape on the aileron and ruddervator hinges, nacelles and inboard motor-access strips, the QUTAS logo on the rear hatch, and the orange antenna mounts (positions approximate). Wingtip markings are now centred mid-chord on each wing and rotated to the local chord, with each wing fitted separately because the drawing's starboard wing sits about 20 px higher; side codes are centred on the fuselage between the side mount and the tail taper, following the fuselage centreline and auto-sized to fit. Outputs: `mockup-board-wingtips.png`, `mockup-board-side-codes.png` and two full mockups. Roundel options B and C now size the logo so its top tips and outer bottom corners touch the inner ring.
- `docs/assets/livery/mockup.py`: side code moved forward and levelled, centred on the fuselage side between the wing-root fairing and the V-tail root (it previously sat under the tail, angled along the boom, and overlapped the ruddervator root). Side-code board now uses Bebas Neue only, per Julian, in navy and orange, with each wingtip design (A-E) as the centre mark (roundels at 1.2x letter height). The wingtip close-up board now uses the same fitted placement and build details as the other mockups. Full mockups are now `mockup-B-bebas-navy.png` and `mockup-D-bebas-orange.png`; the earlier `mockup-B-anton-navy.png` and `mockup-D-anton-orange.png` are superseded and can be deleted.
- `docs/assets/livery/mockup.py`: replaced the option boards with three images, per Julian: `1-roundel-options.png` (roundels A-E with descriptions), `2-wingtip-options-mockup.png` (A-E on the wingtips with the tape, hatch logo and antenna mounts) and `3-identification-and-roundel-options.png` (QA <mark> BLV in Bebas Neue, options A1-E2, 1 = navy letters, 2 = orange letters). Removed the side antenna mount from the side view. Superseded and can be deleted: `out/options-wingtip-roundels.png`, `out/options-side-codes.png`, `out/mockup-board-wingtips.png`, `out/mockup-board-side-codes.png`, `out/mockup-B-anton-navy.png`, `out/mockup-D-anton-orange.png`, `out/mockup-B-bebas-navy.png`, `out/mockup-D-bebas-orange.png`.
- `docs/assets/livery/mockup.py`: nacelle and leading-edge tape now placed from the measured outline on each side (the starboard pieces had been mirrored from port and sat about 8 px high and narrow); removed the grey footnotes from the three option images, per Julian.
- `docs/assets/livery/`: added `print_stickers.py` and `out/print/`, per Julian: print-and-cut files for every option at 1:1 so the winner of the member vote can go straight to a sticker maker. Wingtip roundels `wingtip-A` to `wingtip-E` (130 mm; A is the 110 mm logo) and side identification `id-A1` to `id-E2` (Bebas Neue, 45 mm letters, 54 mm roundel), each as SVG and PDF with a magenta CutContour line 2.5 mm outside the artwork, quantity 2 of each; `proof-sheet-A3.pdf` shows them all at 100% with a 100 mm scale bar. `make_stickers.py` reduced to the shared icon, contour and file writers; the rejected first-round sticker designs, the Barlow font and the superseded option boards were moved to the Recycle Bin, along with the original three-view `.webp` from the repo root.

## 2026-11-04
- `docs/engineering/analysis/launch-dolly-concept/`: added a vertical outrigger strut each side (outrigger end to a new tee on the front upright at 200 mm), per Julian, to stop the outrigger flexing under wheel loads. The front upright is now two tubes either side of the tee. Prop-disc clearance is unchanged (ramp heads remain the closest part at 79/75 mm; the strut is 94 mm from the disc). Dolly mass estimate 3.3 kg, 4.45 m of tube. Also cut the generated drawing set back to sheet BLV-DOL-001 only (Rev B), per Julian; the generator still produces sheets 002-005 with `ALL_SHEETS=1`, and the Rev A copies of those sheets and `out/dolly-results.json` in the folder are now out of date.

## 2026-11-03
- Added `docs/engineering/analysis/launch-dolly-concept/` (README write-up, parametric CadQuery model `dolly_model.py`, checks `dolly_analysis.py`, drawing generator `dolly_drawings.py`, and generated outputs in `out/`: drawing set BLV-DOL-001 to BLV-DOL-005 as PDF and PNG, STEP assembly and aircraft envelope, STEP/STL printed parts, `dolly-results.json`), plus the five sheet PNGs as `docs/assets/diagrams/launch-dolly-BLV-DOL-00n.png`. Concept requested by Julian: 25-32 mm PVC frame with 3D-printed fittings, wing supported on cushioned saddles inboard of the motors, a ramped front stop the wing must lift over, and a rear cross member supporting the tail, all clear of the prop arc. Every dimension, cut length and clearance is generated from the model parameters.
- This concept differs from the tail-rising fuselage-cradle concept recorded as decided in `docs/engineering/requirements/launch-dolly-requirements.md` Section 3c; the SRD was left unchanged pending Julian's decision on which concept to carry. Findings from the model: with the tail resting on the cradle, elevator input cannot rotate the aircraft on the dolly, so lift-off speed is set by the resting wing angle (5.0 deg gives about 12.4 m/s at 4.0 kg using the Weishaupl et al. lift data); the front wheels need outriggers outboard of the prop discs, because the front axle must sit ahead of the wing to resist pitch-over from the ramp push; minimum prop-disc clearance to the dolly is 79 mm at rest and 75 mm at release. Airframe dimensions not recorded in the repo (motor spanwise station, prop plane position, chords, fuselage stations, tail contact station) are marked ASSUMED in the model and drawings and need measuring before build.

## 2026-10-19
- Added `docs/assets/test-plots/maiden-flight-current-histogram-by-mode-2026-10-11.png` to the maiden flight report's Battery and Power Consumption section, per Julian: small-multiples histograms of battery current draw by flight mode, matching the Speed section's existing per-mode histogram format (density-normalised, mean marked per panel, same per-mode colour coding as the existing current-vs-time plot). Regenerated from the maiden flight's own log (`docs/operations/backups/Pixhawk SD Card Backup/log/2026-10-10/23_02_07.ulg`, no generation script had been kept for either prior plot) - nearest-neighbour matched each `battery_status` sample to `vehicle_status.nav_state`, and the resulting per-mode means (Acro 11.44 A, Stabilized 10.32 A, Position Hold 6.89 A, Manual 10.70 A, Auto Mission 4.99 A) reproduce the existing per-mode table's figures closely enough to confirm the log and mode mapping are correct.

## 2026-10-18
- Comprehensive editorial revision of `docs/engineering/test-reports/2026-10-11-maiden-flight.md`, per an external editorial review Julian pasted in: tightened prose throughout and shortened the Summary to ~230 words; merged three sets of overlapping sections (airspeed validator + GPS cross-check into "Airspeed System Assessment"; GCS dropout timeline + cause investigation into "Telemetry Link Reliability"; roll-authority asymmetry + Stabilized-mode throttle/thrust + takeoff-torque into "Lateral Control and Propulsion Effects"); replaced "What This Does and Does Not Show" with a shorter, synthesised "Conclusions and Limitations"; and reorganised "Outstanding" into a prioritised action register (required before the next flight vs. investigation, not blocking). Added hedging distinguishing observation from interpretation in the airspeed, roll-authority and telemetry-failsafe findings specifically, per the review's request - e.g. softened the GCS laptop failsafe reasoning from "a settled decision" to a documented decision that still trades away an automatic response to genuine telemetry loss, and reversed the Outstanding item that said no airspeed hardware inspection was needed to instead recommend a brief physical/bench check. Converted all four MP4 video embeds from markdown-image to link syntax.
- Fixed several internal inconsistencies the same review caught, each checked against the log before fixing rather than just reworded: (1) a sentence on the two uplink-only GCS outages said "the ground-to-aircraft direction [was] unaffected" - backwards, since ground-to-aircraft is the uplink that failed; corrected to "aircraft-to-GCS downlink unaffected". (2) The first auto-tune attempt's "aborted less than a second later" claim - checked against the raw `fw_autotune_attitude_control` log messages: the abort is logged at the same timestamp as the start (effectively instant), and the previously-cited 671.6s is when the state machine returned to idle, ~2s later - reworded to distinguish the two events. (3) The glide-slope table's "touchdown at t=1473.8s" is actually where the analysis window was cut (altitude still ~4-5m AGL there, confirmed against `vehicle_local_position`) - real touchdown is ~t=1478.7s, with `Landing detected` following 3.8s later, consistent with PX4's landing-detector settling behaviour rather than a second landing event. (4) Noted the stall-break timestamps (t=106-145s) fall inside the flight-mode timeline's Phase-A-labelled window though the content is Phase G - `nav_state` alone can't disambiguate. (5) Confirmed `COM_DLL_EXCEPT`=0 (no mode exceptions) in the log's own parameter set before restating that all three long dropouts would have triggered RTL. (6) Flagged that `FW_AIRSPD_STALL` is defined in calibrated airspeed while the Launch section's figure is true airspeed - checked the gap is under 0.3 m/s at this speed/altitude, not enough to change the stated conclusion. (7) Softened "independently verified" for the battery energy cross-check, since both methods derive from the same current sensor. (8) Split the PID auto-tune section's self-contradictory sentence (new gains "in effect for everything after t=1330.2s... including the Mission-mode segment, which ran earlier") into two separate, consistent statements.
- Julian independently revised the report's Speed section on GitHub while the above rewrite was in progress, causing a real merge conflict on push (git flagged it, not auto-resolved) - merged by hand, blending both versions' wording, and kept Julian's addition clarifying the 18.1 m/s in-flight vs. 17.7 m/s full-recording mean ground speed figures. His edit also introduced an absolute GitHub URL for one image link, inconsistent with every other image in the report (relative paths); changed back to a relative path per his follow-up request. Added both the relative-path and the image-vs-video-link conventions to `AI-context/style-guide.md`'s Format conventions, since they'd only existed as unwritten/inconsistently-followed practice until this session surfaced them.
- Added `docs/assets/test-plots/maiden-flight-current-vs-time-2026-10-11.png` (battery current vs. time, shaded by flight mode with a legend, per the `dataviz` skill's categorical colour convention) and used it to replace `docs/engineering/test-reports/2026-10-11-maiden-flight.md`'s Battery section with a fuller "Battery and Power Consumption" section, per Julian: total energy (3.90 Ah discharged / ~91.4 Wh, cross-validated two independent ways), mean/peak power and current, and a per-flight-mode breakdown table (Auto Mission and Position Hold draw roughly half the current of the pilot-flown modes). Closed with a pointer to PWR-06 (`docs/engineering/build-checklist.md`) as the existing open item for determining the pack's exact capacity and setting `BAT1_CAPACITY`, rather than adding a duplicate.
- Expanded the same report's Speed section, per Julian: added a per-flight-mode ground-speed table (mean/p95/max) with a grouped bar chart (`docs/assets/test-plots/maiden-flight-speed-by-mode-2026-10-11.png`, ordinal blue ramp for the three statistics), and a new "3D speed" discussion with its own time-series plot (`docs/assets/test-plots/maiden-flight-speed-2d-vs-3d-2026-10-11.png`, 2D vs 3D overlaid, shaded by flight mode). The aggregate 2D/3D difference is small everywhere (<=0.45 m/s on the mean), but the single biggest gap in the flight is 11.0 m/s at t=59.2s - a near-vertical climb inside the same post-launch Acro window already covered in Climb and Altitude Performance, surfaced here because 2D groundspeed alone understates total speed during steep climbs/dives.
- Revised the Speed section again, per Julian: dropped the 3D speed discussion entirely (only one moment in the whole flight showed a meaningful 2D/3D gap, not enough to justify its own section) and replaced the grouped bar chart with small-multiples histograms (`docs/assets/test-plots/maiden-flight-speed-histogram-by-mode-2026-10-11.png`, one panel per flight mode, density-normalised so differing segment durations don't distort the shapes, mean marked per panel) - shows each mode's actual speed distribution rather than just three summary statistics. Removed the two now-unreferenced plots (`maiden-flight-speed-by-mode-2026-10-11.png`, `maiden-flight-speed-2d-vs-3d-2026-10-11.png`).

## 2026-10-16
- Filed the maiden flight's recovered QGroundControl `.tlog` (Julian found it already saved, in the repo root) into a new `docs/operations/backups/GCS Telemetry Log Backup/` folder (with a README, following the existing backup-folder convention) and added it to `AI-context/directives.md`'s file-organisation list. Parsed it with `pymavlink` to extend the maiden flight test report's GCS-dropout investigation with the one thing the aircraft's own log couldn't show: whether the aircraft-to-ground direction survived the three long outages. It didn't fail the same way each time - the 39.8s and 27.9s outages were uplink-only (downlink continuous throughout, checked across four independent message types), while the 17.0s outage was symmetric (both directions down together, for longer than the aircraft's own reported window) - updated `docs/engineering/test-reports/2026-10-11-maiden-flight.md`'s "Investigation of the dropouts' cause" and `AI-context/open-items.md` accordingly. Also checked for `RADIO_STATUS` (the ground modem's own RSSI/noise, the other half of what was hoped for from this file) under both the default and `ardupilotmega` MAVLink dialects - genuinely absent from the byte stream, not just undecoded, so that specific question remains open.
- Redesigned `docs/assets/test-plots/mission-mode-planned-vs-actual-2026-10-11.png`'s styling, regenerated from the maiden flight's own log (`docs/operations/backups/Pixhawk SD Card Backup/log/2026-10-10/23_02_07.ulg`) and the georeferenced aerial image/world file, since no generation script for this plot had been kept in the repo from when it was first created. Three fixes: replaced the wind-vector glyph with a chevron/dart arrowhead sized to sit fully inside the photo (the previous version straddled the image edge and was too small/narrow to read), oriented to point downwind - the conventional flow-direction arrow - while the label text still reports the meteorological "from" bearing; gave the planned-mission dashed line and waypoint markers a white halo for contrast against the green field, matching the flown track's existing treatment, and switched the planned-mission colour from blue to orange so it no longer competes with the flown track's new colour encoding; recoloured the flown track by altitude AGL (sequential blue ramp, `dataviz` skill) with a colorbar legend added on the right. Also rebuilt the on-image legend as a measured 3-row x 2-column grid after the first pass let the wind row render outside its bordered box and hid the "Mission-mode engaged" marker behind the legend panel, and corrected an early draft's wind-arrow rotation that put the glyph's blunt end where the sharp tip should read.
- Tightened the same plot's legend box (smaller row height/padding/font - the first pass left too much space between entries) and the bottom crop margin that was sized around it. Added a new standalone plot, `docs/assets/test-plots/mission-mode-altitude-vs-time-2026-10-11.png` - altitude AGL vs. time over the same Mission-mode window (t=1112-1211s), with the planned 50m AGL altitude marked and the same engaged/exited markers as the map plot for cross-reference. Linked it into `docs/engineering/test-reports/2026-10-11-maiden-flight.md`'s Mission mode section with a short paragraph on the transit-then-settle shape it shows, and caught the map plot's own description there going stale against its new colours (said "flown track (green)... real mission (blue)" - now coloured by altitude AGL and orange respectively) while in there. Added dashed vertical lines/labels to the altitude plot marking when each mission item was accepted, per Julian.
- Fixed two misleading statements in `docs/engineering/test-reports/2026-10-11-maiden-flight.md`'s summary and body, both per Julian's catch: (1) the `NAV_DLL_ACT` paragraph read as if the parameter had reverted to 0 unexpectedly, when the parameter-change-log already records it as a deliberate pre-flight change by Julian on 2026-10-11 specifically to prevent an RTL if the GCS laptop died - reworded to state the intent up front instead of only in the later GCS-dropouts section; (2) several "GPS used instead of airspeed" sentences blurred `airspeed_validated` (PX4's validated topic, actually invalid) with the raw differential-pressure sensor (confirmed healthy and used directly in the Stall speed, Glide slope, and cross-check sections) - reworded to name the validated topic specifically and stop overstating GPS as a blanket airspeed substitute, including correcting the Phase E line, which had claimed GPS substituted for a power-vs-airspeed analysis that the report's own "What This Does and Does Not Show" section says was never produced.
- Fixed a real bug in the altitude plot's waypoint-acceptance lines, caught by Julian against the shape of the altitude trace: `navigator_mission_item`'s timestamp for `sequence_current` becoming N marks when N *becomes the active target*, not when it was reached, so labelling lines with that row's own timestamp placed e.g. "2" at the start of the transit/descent instead of its end. Fixed by labelling each waypoint with the *next* row's timestamp (when it actually left that target, i.e. was accepted) - WP2 now lands where the descent actually flattens out, matching the map plot's own account of the transit happening before WP2 is reached. Updated the test report's description of the leg timing to match (the long leg is WP9->WP10, not WP10->WP11 as first written).

## 2026-10-15
- Compared the maiden flight's EKF wind estimate against Open-Meteo's historical reanalysis archive, per Julian (no site anemometer reading exists). Queried at the flight's own recorded home position, 2026-10-11 09:00 local: 1.30 m/s from 016°T, gusting 5.20 m/s - a real discrepancy against the EKF's 2.96 m/s from 066°T, not a confirmation. Partly explained (reanalysis grid point ~5.2km from the field; 10m reference height vs. the aircraft's flight altitude; the gust figure sits much closer to the EKF average than the base wind speed does, consistent with genuinely gusty conditions) but the direction gap stays open. Checked for finer-than-hourly resolution (a 15-minute parameter, a named higher-res model) - neither returned data for this historical date, so hourly is the practical floor. Documented in `docs/engineering/test-reports/2026-10-11-maiden-flight.md` and updated the matching `AI-context/open-items.md` item to record this as a regional-model comparison, not ground truth, with a real anemometer reading still the open ask.
- Fixed two problems with the wind-vector annotation on `docs/assets/test-plots/mission-mode-planned-vs-actual-2026-10-11.png`, per Julian's catch: the arrow was straddling the white title margin rather than sitting fully inside the photo (moved it down, clear of the boundary), and the new legend row sat outside the existing legend's bordered box rather than inside it (measured the border's exact position/colour and redrew it to encompass the new row, rather than leaving a separate unbordered strip below).
- Reworked the wind-vector annotation on `docs/assets/test-plots/mission-mode-planned-vs-actual-2026-10-11.png`, per Julian - shrank it to a small direction icon so it doesn't clutter the aerial imagery, and moved the speed/direction text into a new row extending the plot's existing legend instead of a floating label on the photo. Caught and fixed a mistake of my own along the way: `git checkout` restores to HEAD, and the previous commit had already landed the first (cluttered) version there, so the first restore attempt silently brought that back rather than the true pre-annotation original - had to restore from the specific earlier commit (`f026255`) that actually predates any wind annotation instead.
- Added the PX4 EKF's in-flight-averaged wind estimate (2.96 m/s from 066°T) as an arrow annotation on `docs/assets/test-plots/mission-mode-planned-vs-actual-2026-10-11.png`, per Julian. Checked his hypothesis that the estimate gets more accurate as the flight progresses against the EKF's own variance fields first - it doesn't hold up cleanly: variance doesn't converge much over the flight, and the per-sample direction estimate swings over 100° across different portions of it, so there's no strong basis for trusting the end of the flight over any other window. Used a proper vector average (component-wise, not an average of angles) instead. Also corrected the averaging window on Julian's catch: the raw wind estimate is exactly zero during the pre-launch ground-holding period (the estimator isn't meaningfully running while stationary, not biased noise) - excluded ground time before takeoff-detected and after landing-detected, though in this case it barely moved the number (2.90 to 2.96 m/s). Added a cross-reference note to `docs/engineering/test-reports/2026-10-11-maiden-flight.md`'s Mission mode section, and a new `AI-context/open-items.md` item for cross-checking this estimate against an independent ground wind measurement, which doesn't exist in the repo yet.
- Added a GPS-speed-vs-airspeed cross-check to `docs/engineering/test-reports/2026-10-11-maiden-flight.md` (new section, after "Airspeed validator latched invalid"), per Julian: GPS speed (3D groundspeed magnitude from `vehicle_gps_position`) runs systematically above the raw-sensor indicated airspeed, mean +4.53 m/s (std 2.81) - confirmed as wind, not a fault, by cross-checking against PX4's own independent wind estimate (`airspeed_wind`, actively updating throughout the flight, mean 3.88 m/s, same ballpark). The heading trace also showed the aircraft spent most of the flight in sustained circular flight (consistent with the known `NAV_LOITER_RAD` = 50m loiter configuration), which is favourable for the EKF's wind observability. Confirmed precisely, from the log's own `commander` messages, that the near-zero stretch at the start of the plot is the handler holding the aircraft before the throw: armed at t=0.11s, `Takeoff detected` at t=32.73s (matching the existing Launch section's t=32.6s). Added the supporting static plot (`docs/assets/test-plots/maiden-flight-gps-vs-airspeed-2026-10-11.png`) and a self-contained, fully offline interactive version of the same chart (`.html`, Plotly, zoom/hover, embedded data and library - no external hosting) alongside it. An earlier attempt published this as an externally-hosted claude.ai artifact; Julian flagged that hosting location as inappropriate for this repo (not the use of HTML itself), so it was deleted and rebuilt as a local, git-tracked file instead. Caught and fixed a real bug along the way: `log.start_timestamp` isn't guaranteed to be at or before every topic's first sample (the GPS topic's first sample here predated it by ~0.1ms), and subtracting it from a `uint64` timestamp array that starts earlier wraps around silently - broke `np.interp`'s monotonicity assumption and produced a nonsense first-pass result (-13 m/s mean difference instead of the correct +4.53 m/s). Fixed by using the true minimum timestamp across the topics actually in use, with a monotonicity assertion as a guard.

## 2026-10-13
- Investigated the maiden flight's GCS link dropouts from the flight log (and the other 2026 logs on the SD card) and added an "Investigation of the dropouts' cause" section to `docs/engineering/test-reports/2026-10-11-maiden-flight.md`, per Julian. Corrected the dropout count from 15 to 18 (about 148 s lost, roughly 10% of the flight) and put the long-outage table in time order. Found no link to range (max 316 m), antenna aspect, bank angle, altitude or noise, RSSI at the aircraft strong throughout, and the GCS kept transmitting during outages (lost-message counter jumps on regain). The radio-status fields for remote RSSI, errors and TX buffer carry no information (the TX buffer reads 0 in every log since 2026-06-02). Corrected the report's claim that the three `RADIO_STATUS timeout` messages are symptoms of the dropouts: each falls shortly after an outage, not during one. Cause not identified; updated `AI-context/open-items.md` with the data still needed (QGroundControl `.tlog`, air-side RFD900x `ATI5` dump, stationary ELRS on/off bench test).
- Renamed `docs/operations/backups/Pixhawk Flight Log Backup/` to `Pixhawk SD Card Backup/` and filled it with a copy of the Pixhawk's microSD card (Julian's call to back up the whole card, not just flight logs): 149 multirotor logs from 2023-2024 (the board's previous life in a hexarotor), the ArduPilot `APM/` folder, `param_import_fail.txt` and `param_import_fail.bson` were deleted from the card first, so the backup holds only the 195 fixed-wing logs from 2026-05-14 onward (including the maiden flight, `log/2026-10-10/23_02_07.ulg`, and `sess100/`/`sess101/`, recorded without a clock time), `etc/extras.txt`, `dataman`, `parameters_backup.bson` and `uavcan.db/`. Rewrote the folder's README to describe each item (the old "Pending" note about the maiden flight log is resolved) and updated the references in `README.md`, `AI-context/directives.md` and `AI-context/project-overview.md`. Findings from inspecting the card, checked against the PX4 v1.16.1 source: the earliest possible fixed-wing flash date is 2025-09-08 (the release commit date, matching the logs' firmware hash), the latest is 2026-05-14 (first fixed-wing log), and the card holds nothing between 2024-09-19 and 2026-05-14 (flight counter 148 in the last hexarotor log, 149 in the first fixed-wing log); `dataman` holds two identical 38-record mission registers, active count 28, with a stale tail from an earlier longer mission past index 27.
- Closed PROP-08 (limit current draw to within motor rated continuous current), per Julian: it dates from the MN3110 KV700 overcurrent finding and is moot now the T-Motor U5 KV400 is back in the aircraft (about 15.5A per motor at full throttle against a 30A rating). Removed its dashboard row and task section from `docs/engineering/build-checklist.md` and added a closed summary under Completed Work; removed it from the Critical list in `docs/governance/timeline-and-roadmap.md` and `AI-context/project-overview.md`, from Section 9 of `docs/operations/manual.md`, and removed the stale 12x6" 1700us PWM-ceiling item from `AI-context/open-items.md`.

## 2026-10-12
- Completed the repo-wide restructure with Julian (phases 2-4, following the content-merge phase below). File/folder moves: `Component datasheets/` -> `docs/engineering/component-datasheets/`; the maiden flight test plan -> `docs/engineering/test-plans/2026-10-11-maiden-flight-test-plan.md` (dated, matching the test-reports convention); all five hardware backup folders (GX12 Radio, Pixhawk Parameter, Pixhawk Mission, Pixhawk Flight Log, GCS RFD900 Modem) -> `docs/operations/backups/`; `docs/project/governance/` and `docs/project/purchase-history/` -> `docs/governance/` (direct); `docs/project/` eliminated as a category entirely, per Julian's point that "engineering" vs "project" wasn't an intuitive distinction by name alone. `build-checklist.md` ended up in `docs/engineering/` rather than `docs/governance/` - Julian's call, overriding my initial placement, since it's fundamentally about engineering/configuration completeness. Renamed `context/` to `AI-context/` across the whole repo (including CLAUDE.md, AGENTS.md, and every cross-reference), per Julian. Updated every live cross-reference repo-wide via a series of scripted sweeps plus manual fixes for relative-link forms and a few tree/table structural misplacements the sweeps couldn't catch; historical CHANGELOG/project-notes entries left untouched throughout, per the append-only convention. Verified with an automated pass: zero broken markdown links, zero mixed line-endings, no unintended em-dashes across the whole repo. Also fixed two pre-existing stale references unrelated to this restructure, caught during verification: ICD.md's INT-02 propeller-rotation claim and a leftover `docs/project/reference/` path from an even earlier rename. Rewrote the top-level map documents to match (README's "Repository contents", `context/directives.md`'s file-organisation list, `context/startup-prompt.md`'s key-documents table, `context/project-overview.md`'s repo-structure tree and current-open-items summary, the last of which was badly stale and still pre-dated the maiden flight).
- Started a repo-wide restructure with Julian (content-merge phase 1 of several): merged `docs/project/project-overview.md` into `README.md` (adding the QUTAS educational-purpose paragraph and Charlotte Kelly's role, deleting the separate file); merged `docs/project/project-roadmap.md` and `docs/project/project-timeline.md` into a new `docs/governance/timeline-and-roadmap.md`, refreshing the latter's badly stale "Current Status"/Phase 1 content along the way (it still described the pre-maiden-flight state); merged `docs/engineering/flight-modes.md` into `docs/operations/manual.md` as new Sections 4-6 and 9, since the two covered overlapping ground. Updated every live cross-reference to the three removed files across the repo (historical CHANGELOG/project-notes entries left untouched, per the append-only convention). Next phases: move `Component datasheets/`, the backup folders, and the maiden flight test plan; promote `docs/project/governance/` to top-level `docs/governance/`; then a final sweep updating the top-level map documents (README's repository-contents section, `context/directives.md`'s file-organisation list, `context/startup-prompt.md`, `context/project-overview.md`'s repo map).
- Added a standing rule to `context/directives.md` on when to attribute a change to Julian by name - warranted for identity/role facts and genuine engineering judgement calls (the purpose of `context/CHANGELOG.md`, `context/project-notes.md`, and `parameter-change-log.md`), not warranted for routine wording edits, reverts, or direct instruction-following. Prompted by Julian flagging "per Julian" on a trivial wording revert in the previous entry - fixed that entry to match. Builds on the existing no-attribution-in-`docs/` rule and the misattribution-risk concern already in `CONTRIBUTING.md`.
- Reworded `docs/project/build-checklist.md`'s "Current Flight-Readiness Status" banner: added a note that the aircraft has flown once (2026-10-11, no crash or structural incident), since the surrounding text otherwise still read as if the maiden flight hadn't happened yet. Kept the "NOT CLEARED FOR FLIGHT" banner text itself unchanged - it reads fine as a generic, ongoing status rather than something specific to a first flight. Also reworded PWR-03 and RF-05's background notes, which similarly said "does not block the maiden flight" as a forward-looking prediction - both now note the maiden flight is itself evidence the aircraft worked fine without them addressed.
- Removed the PDB mount/connector issue from `docs/engineering/test-reports/2026-10-11-maiden-flight.md` as a maiden-flight finding, per Julian - it was already known beforehand, not something post-flight inspection revealed (unlike the right motor bearing, which genuinely was). Updated `docs/project/build-checklist.md` PWR-05 with the real root cause, previously "not yet investigated": an XT90 connector (PDB, battery side, or both) was soldered without the opposite-gendered mating connector plugged in, letting the soldering heat soften and deform the housing plastic - fix is to resolder with the mating connector in place throughout. Removed the now-redundant `context/open-items.md` entry for the same issue, since PWR-05 is the single tracked copy with the correct detail.
- Added a new `context/open-items.md` item recording the decision not to update `FW_AIRSPD_STALL` (11 m/s) to the maiden flight's measured 8.15-9.95 m/s yet, per Julian - three stall trials at 1Hz sampling is thin data to retune a parameter other logic is built around. Noted the reasoning isn't simply "more margin is safer": the parameter also feeds the airspeed validator's `check_load_factor()` check implicated in the maiden flight's validator trip, so an inflated stall figure could make nuisance trips more likely, not less.
- Corrected `docs/engineering/ICD.md` (Rev 2.13), which still described the failed-and-replaced MN3110 KV700 as the fitted motor throughout - INT-02d/f, the Connected Devices table, and the full motor spec block, missed when the MN3110 failed (2026-09-26) and was replaced by the reinstalled T-Motor U5 KV400 (PROP-11, 2026-09-30). Updated to the U5's actual specs (KV400, 30A rating, 12x6E propeller - was still showing the 11x7" Hobbyrama), and the PWM Max endpoints (1800 was the MN3110-era ceiling; live value, confirmed from the maiden flight's own embedded parameters, is 2000). Also corrected an actively wrong claim: the propeller-rotation row said contra-rotation was "confirmed not required," when the maiden flight found the opposite (roll-authority asymmetry, contra-rotating propellers now a decided Critical fix, PROP-12). Updated the matching `context/open-items.md` propeller entry to reflect the doc fix, while leaving the still-unresolved ground-clearance question (12" prop radius vs. the 150mm reference clearance) open.
- Further updated `docs/engineering/requirements/launch-dolly-requirements.md` (Rev 0.5), walking through the launch-dolly design with Julian: decided the retention/release concept (new Section 3c) - a tail-rising dolly like a sailplane/motorglider trolley, with a single cradle positioned 30mm forward of the CG (about 15mm forward of the front wing spar) that the fuselage rests in and pitches freely about, plus a separate tail support, rather than a rigid fixed-angle cradle. Added a lift-curve-derived (Weishäupl et al. 2024) ~5-6° target separation AoA, and distinguished it from the dolly's static resting angle (which doesn't need to be precise, since the tail-rise reaches the real flying AoA dynamically). Added the previously-unflagged gap that Believer's wing incidence relative to the fuselage reference line isn't documented anywhere, needed to translate that AoA target into an actual physical rigging reference.
- Updated `docs/engineering/requirements/launch-dolly-requirements.md` (Rev 0.4) with real flight data, answering Julian's question on target dolly release/rotation speed: replaced Section 3b's stale, pre-flight PX4 airspeed parameters (from 2026-08-20, before CTL-10's update) with the current configured values and the maiden flight's own measured stall speed (8.15-9.95 m/s IAS across three deliberate stall breaks, at the aircraft's actual 4.0kg flying weight - a real measured floor, lower than the configured `FW_AIRSPD_STALL` of 11 m/s). Added the current-weight wing loading (7.8 kg/m²) alongside the existing MTOW figure. Narrowed Section 6's release-speed open item to a target range (roughly 11-13 m/s, a standard margin above the measured stall range) pending the dolly's actual release angle of attack, which is still undecided and drives the final number.
- Created `docs/operations/Pixhawk Flight Log Backup/` (with a README noting what goes there and the naming convention), per Julian - no flight or bench-test `.ulg` log has ever been backed up in the repo, unlike the parameter and radio backups; every finding in the test reports traces back to a log that only ever existed on the physical SD card. Added `context/directives.md`'s file-organisation entry for the new folder. Pending: the maiden flight's `23_02_07.ulg`, which Julian will copy in once he has the SD card.
- Reviewed every mention of Julian by name across the repo with Julian, case by case, following up on the attribution-risk concern raised for `CONTRIBUTING.md`. Left the large majority alone - team/contact listings, purchase-history funder records, test-report accounts of who was physically present, the narrative parameter-change log, and revision-history tables are all legitimate uses. Trimmed 38 cases of pure decision/provenance narration ("per Julian", "Julian decided/confirmed/advised...") out of `docs/project/build-checklist.md` (32), `docs/operations/maiden-flight-test-plan.md` (4), and `docs/engineering/ICD.md`'s main body (2, leaving its revision-history table's 3 mentions alone) - these are meant to be clean current-state docs per the style guide, and naming the one person who's done all the work so far added nothing a future contributor's own name wouldn't eventually need replacing anyway.
- Added guidance to `CONTRIBUTING.md`'s "Link an AI agent" step, per Julian: tell the agent who you are, since most of the repo's existing history attributes changes to Julian Williams by name, and an agent not told otherwise may copy that pattern and misattribute a new contributor's own changes to him.
- Relaxed the CHANGELOG logging rule in `context/directives.md`, per Julian - today's entries had been tracking wording-only tweaks one-by-one, down to single-word changes, which added noise without value. Entries should now scale to the change's substance, grouping a run of pure wording edits into one brief entry rather than logging each separately. Consolidated this date's own entries below to match.
- Iteratively reviewed and reworded `CONTRIBUTING.md`'s "Before you start" section and `README.md`'s opening section with Julian: added an AI-in-the-loop lead-in and an optional-but-encouraged step for linking an AI agent to `context/startup-prompt.md` after cloning; settled on `startup-prompt.md` as an AI-agent-only entry point with the README as the human-facing equivalent (fleshed out to match - airframe summary, project lead/contact); aligned the two files' repo-description sentence to the same wording; dropped the explicit no-em-dash callout from this public-facing file (the rule itself stays in `context/style-guide.md`).
- Replaced "shark spotting, threatened ecosystem monitoring, and agricultural observation" with "remote sensing applications" (plus an explicit "a specific mission has not yet been selected" note) everywhere it was stated as the project's purpose, per Julian - a mission hasn't actually been chosen, and the specific wording overstated it. Updated `context/startup-prompt.md` (also restructured "What this project is" to lead with purpose rather than a hardware spec dump, and dropped RC/telemetry part numbers already covered in `docs/engineering/ICD.md`), `docs/project/project-overview.md`, `context/project-overview.md`, `context/project-notes.md`, `docs/project/project-timeline.md`, `README.md`, and `docs/engineering/requirements/underslung-camera-mount-requirements.md`. In `docs/engineering/requirements/custom-airframe-requirements.md` Section 3c (operating-altitude research), kept the three named mission types since real reference data is tied to them, but reframed as candidate/illustrative examples rather than the project's confirmed mission set. Left the historical mentions in this changelog's own 2026-08-26 entries untouched, per the append-only convention.
- Added `CONTRIBUTING.md` (root), adapted from a draft Julian had ChatGPT write. The fork/clone/branch/PR mechanics were already solid and are kept as-is; added a "Before you start" section pointing contributors at `context/startup-prompt.md`, `context/style-guide.md` (including the repo-wide no-em-dash rule), and `context/directives.md` (the CHANGELOG-every-change rule), plus a safety-critical-changes note tied to `docs/project/build-checklist.md`'s priority system and a pointer to `context/academic-integrity.md` for QUT student contributors. Filled in the real repository URL (the draft had a placeholder). Linked from `README.md`. No LICENSE file exists in the repo - flagged to Julian since a fork-and-PR workflow usually implies one, but not added unilaterally since that's a licensing decision, not a documentation one.
- Moved `GCS_RFD900_params.ini` (the ground-side RFD900x modem's own AT-command parameter backup - air data rate, frequency range, net ID, encryption, serial speed) from the repo root, where Julian had dropped it, into a new `docs/operations/GCS RFD900 Modem Backup/` folder, matching the existing Pixhawk Parameter/Mission Backup and GX12 Radio Backup folders. Cross-referenced it from `docs/engineering/ICD.md` INT-04 (Rev 2.12) - `SERIAL_SPEED` = 57 there matches the FC-side `SER_TEL2_BAUD` = 57600 already documented, a useful consistency check.

## 2026-10-11
- Added stall-speed and landing-glide-slope findings to `docs/engineering/test-reports/2026-10-11-maiden-flight.md`, per Julian's request. Found three repeated, clean stall breaks in the flight's one Manual-mode window (8-10 m/s indicated airspeed, from the raw differential-pressure sensor since the EKF airspeed was invalid by this point) by looking for abrupt nose-down pitch events with the stick held neutral. Measured the final landing's glide slope from a genuine power-off segment (confirmed via raw PWM, not just the throttle stick): 6.6:1 ground-track ratio / 8.6° descent angle as flown into a ~3.5 m/s headwind, ~8:1 estimated still-air. Initially mischaracterised the roll angle at each stall break by only checking the window-wide min/max (up to 45-54°) rather than the roll at the actual break moment - Julian caught this; corrected to the time-resolved picture (two of three breaks near wings-level at the break itself, one in a gradually-deepening bank more consistent with a turning entry than a wing drop).
- Investigated Julian's hypothesis that a cut differential-pressure line explained the maiden flight's near-total "airspeed invalid" readings - **ruled it out**. The raw differential-pressure sensor data was physically sane for the entire flight (recomputing airspeed from it directly gives 13-24 m/s throughout, no negative/zero/stuck readings - the signature a cut or blocked line would produce). Traced the real cause using PX4's own source (`AirspeedValidator.cpp`, `airspeed_selector_params.yaml`): the validator tripped once at t=49.0s, 16.4s after takeoff, likely its `check_load_factor()` check during the high-G pull-up recovering from the launch sag, and never recovered because `ASPD_FS_T_START` was at PX4's own -1 (disabled) default, which is documented as disabling in-flight re-enabling entirely. Decided to change it to 2s so a future trip can clear itself rather than latching for the whole flight - not yet applied to the physical FC. Corrected `docs/engineering/test-reports/2026-10-11-maiden-flight.md`, `context/open-items.md`, and `docs/operations/maiden-flight-test-plan.md`, which had all called this a sensor/hardware fault.
- Added PWR-06 (complete the battery capacity test and set `BAT1_CAPACITY`) to `docs/project/build-checklist.md` as a new critical flight-readiness blocker, per Julian - ties into the same flight's finding that PX4's reported battery percentage is pure linear voltage interpolation with no capacity set, likely optimistic through the middle of a Li-ion discharge. Also recorded the maiden flight's actual discharge (3.92 Ah, from PX4's own coulomb counter, cross-checked by manually integrating the logged current to within 0.5%) as context for sizing the test.
- Built a Mission-mode planned-vs-flown plot and discovered the mission was replanned at the field the day of the flight - the repo's `maiden-mission.plan` backup (and the test plan's Section 5) describe the old mission. Recovered the real, actually-uploaded mission (28 items, 50m relative altitude, a genuine landing sequence - not the backed-up 32 items/40m/no-landing-item) directly from the Pixhawk's `dataman` file on the SD card, by fetching PX4's own source for the binary format and validating the parse against the flight's live telemetry (file size matched exactly; every waypoint matched to sub-metre precision). Added the finding to `docs/engineering/test-reports/2026-10-11-maiden-flight.md` and flagged regenerating the mission/geofence backups as a new open item - not done yet, pending Julian's go-ahead.
- Replaced the plot's basemap with Julian's own Nearmap export (15cm GSD georeferenced imagery of BNEMAC) instead of free Esri tiles, fixed overlapping waypoint labels (nearest-neighbour label repulsion instead of simple radial offset), trimmed the plot to waypoints 1-20, and moved the legend below the plot so it no longer crops the flight path. Saved the Nearmap source imagery into a new `docs/assets/site-imagery/` folder for reuse on future test reports at the same field.
- Reorganised `docs/assets/` from a flat 28-file folder into subfolders (`component-photos/`, `diagrams/`, `config-screenshots/`, `test-plots/`, `flight-footage/`) via `git mv`, and updated every live markdown reference across 9 files (`docs/operations/manual.md`, `docs/operations/maiden-flight-test-plan.md`, `docs/engineering/ICD.md`, `docs/engineering/analysis/powertrain-performance-model.md`, and five test reports) to the new paths - verified every reference resolves before committing. Added Julian's launch video (`Launch.m4v`, dropped in the repo root) as `docs/assets/flight-footage/maiden-flight-launch-2026-10-11.m4v`, embedded in the maiden-flight test report.
- Investigated whether the auto-tune result (previous entry) is actually good, not just different from the defaults: PX4's own convergence diagnostics (`autotune_attitude_control_status.fitness`) show a clean fit for both roll and pitch (converging to 0.24 and 0.39 from an initial ~10-16), and a before/after comparison in the real flight shows roll/pitch rate tracking error improved 36%/55% with no actuator saturation. Added this validation to `docs/engineering/test-reports/2026-10-11-maiden-flight.md`.
- Added pilot debrief findings to the maiden flight test report, per Julian (relaying pilot Ross Dennington's account - corrected the report's attendee list, Ross flew and Julian handled/ran ground station, not the reverse): the hill launch was marginal and needs a launch dolly in future (decision made); the aircraft struggled to roll right, verified against the log (stick-to-roll-rate sensitivity in Manual/Acro showed less than half the authority turning right vs. left) and consistent with both propellers turning the same direction - contra-rotating propellers are needed before the next flight (decision made); confirmed from the control-allocation parameters that no mode on this airframe uses differential thrust, that both motors always received identical commands (actual thrust balance still unverified - no per-motor instrumentation), and that Stabilized mode's throttle path is identical to Manual/Acro (the "less punchy" feel is likely the attitude loop damping thrust-coupling, not a throttle-signal difference); the GCS-RTL failsafe disable was reinforced by an account of the GCS laptop actually dying before launch on the day. Also recorded two post-flight-inspection findings with no log signature: a PDB mount/connector needing rework, and a bad bearing found in the right motor.
- Added three new critical-blocker items to `docs/project/build-checklist.md` from the above: PROP-12 (contra-rotating propellers), PROP-13 (right motor bearing), and PWR-05 (PDB mount/connector) - all Not started, all added to the Current Flight-Readiness Status table.
- Analysed the maiden flight from the Pixhawk's SD card (G: drive, no live FC connection available) and wrote up `docs/engineering/test-reports/2026-10-11-maiden-flight.md`. Confirmed via the log's own GPS UTC timestamp that the flight actually happened 2026-10-11 (one week later than planned), not 2026-10-04 - updated `docs/operations/maiden-flight-test-plan.md` (Rev 0.7, Section 2) accordingly. Key findings: the GCS (RFD900x) telemetry link dropped out at least 15 times over the 24.8-minute flight, three exceeding the 10s data-link-loss timeout; the airspeed sensor reported invalid data for almost the entire flight; the in-flight PID auto-tune succeeded on its second attempt (first was aborted by a mode change); Mission mode (Phase K) flew without incident; Phase J (Return to Home) was not deliberately exercised.
- Took a fresh parameter backup reconstructed from the maiden flight log (initial parameters plus every mid-flight change applied in order - equivalent to a live export, since no laptop/GCS connection to the FC was available). Diffed against the 2026-10-02 backup (all 1214 shared parameters): confirmed `NAV_DLL_ACT` was already reverted to 0 (Disabled) before this flight, undoing RF-06's 2026-10-02 change to 2 (Return) - the flight log explains why, showing three GCS dropouts long enough that an RTL would very likely have fired mid-flight under the old setting despite full manual RC control throughout. Also found eight rate-controller gains (`FW_PR_P/I/FF`, `FW_P_TC`, `FW_RR_P/I/FF`, `FW_R_TC`) written by the successful in-flight auto-tune, plus routine calibration drift and one newly-observed parameter (`MIS_DIST_1WP`, at the firmware default). Updated `docs/operations/Pixhawk Parameter Backup/parameter-change-log.md` (new rate-controller-gains section, `NAV_DLL_ACT` row, calibration values, refresh-method note), `docs/engineering/flight-modes.md` (Rev 1.17), `docs/project/build-checklist.md` (RF-06 bullet), and `docs/operations/manual.md` (step 28).
- Added four new open items from the maiden flight findings to `context/open-items.md`: the airspeed sensor fault, Phase J not tested, the root cause of the GCS link dropouts, and two unexplained minor log anomalies (a brief critical-failure flag, a one-off GPS spoofing warning).

## 2026-10-10
- Julian confirmed the maiden mission uploaded successfully with no "Mission rejected" message, validating the 2026-10-02 RTL_TYPE fix. Updated docs/operations/maiden-flight-test-plan.md (Section 5, and Section 7 is now empty), docs/operations/Pixhawk Parameter Backup/parameter-change-log.md, and context/open-items.md accordingly.
- Removed the auto-tune-abort open item from docs/operations/maiden-flight-test-plan.md Section 7, per Julian - flight-mode change aborting auto-tune is already documented in Phase D itself (per PX4's procedure), so no RC AUX switch gap actually exists here.
- Julian confirmed the SA/SD channel-value logic directly: Loiter active at SA = 100%, Armed at SD = 100%, Disarmed at SD = -100% - consistent with the existing confirmed table. SC (Return) is now the only remaining unconfirmed switch. Updated docs/engineering/ICD.md (Rev 2.11).
- Fixed both annotated GX12 radio diagrams directly, using Python/Pillow via the Bash tool (available in this environment, contrary to every earlier note here saying this needed to be done manually): `docs/assets/gx12-front-switches.png`'s GR1 mode labels (SW2-SW6, corrected to Acro/Stabilized/Altitude/Position/Mission) and `docs/assets/gx12-top-switches.png`'s SB/SE labels (Flaperon/Offboard to Aileron rate/Elevator rate). Closed the matching `docs/project/build-checklist.md` CTL-04 acceptance criterion and removed the open item tracking this.
- Julian confirmed the SB/SE tri-rate switch directions directly on the physical radio: down = 100%, middle = 70%, up = 50% for both aileron (SB) and elevator (SE) rate - matching the 2026-10-03 extrapolation exactly. Updated `docs/engineering/ICD.md` (Rev 2.10) to show these as confirmed; SA (Loiter) and SC (Return) remain unconfirmed extrapolations.
- Added the actual QGroundControl Plan-view screenshot of the maiden mission to `docs/assets/maiden-mission-plan.png` (Julian pasted it directly into chat after the placeholder link in `docs/operations/maiden-flight-test-plan.md` turned out broken - the file had never actually been added). Removed the two matching open items (test plan Section 7 and `context/open-items.md`) now that the image exists and the link resolves.

## 2026-10-03
- Found the actual physical direction for the Arm (SD) and Kill (SF) switches in the EdgeTX radio backup's own `switchWarning` pre-flight safe-position check and sound/timer trigger conditions (`docs/operations/GX12 Radio Backup/MODELS/model00.yml`): SD up = Disarmed (EdgeTX's configured safe/startup state), SD down = Armed (plays the "armed" sound, starts the flight timer); SF down = Kill inactive (safe/startup state), SF up = Kill engaged. Extrapolated the same up/down pattern to SA (Loiter), SC (Return), and the SB/SE tri-rate switches, flagged as probable rather than confirmed since they have no `switchWarning` entry of their own. Added a new "Switch Physical Direction and PWM Behaviour" subsection to `docs/engineering/ICD.md` (Rev 2.9) documenting all of this, including PX4's actual `RC_*_TH` = 0.75 threshold logic sourced from `rc_update.cpp`.
- Answered Julian's questions on RC channel PWM behaviour, sourced from the parameter export, `docs/engineering/ICD.md`, the actual EdgeTX radio backup (`docs/operations/GX12 Radio Backup/MODELS/model00.yml`), and PX4's source (`getRCSwitchOnOffPosition` in `rc_update.cpp`): all PX4 switch functions (Arm/CH5, Kill/CH7, Loiter/CH8, Return/CH10) use the same `RC_*_TH` = 0.75 default threshold, engaging when the channel's normalized value exceeds +0.5 (about 1750us on this project's calibration) - practically ON near 2000us, OFF near 1000us, for all four. Confirmed the tri-rate switches from the actual radio backup's `expoData` table: SB (CH9, aileron/roll) and SE (CH11, elevator) each carry 100/70/50% weight at positions 2/1/0 - PX4 never sees these channels (`RC_MAP_FLAPS`/`RC_MAP_OFFB_SW` both cleared), it's purely an EdgeTX-side rate selection. Flagged that the exact physical up/down direction for switch position 0 vs 2 isn't something to assert from the files alone - recommended Julian verify on the actual radio. While checking the switch diagrams, found `gx12-front-switches.png` has a second, previously untracked staleness beyond the already-known SB/SE Flaperon/Offboard labels - its GR1 mode labels (SW1-6) still show the pre-2026-08-19 mapping, not the current one in `docs/engineering/ICD.md`. Updated the existing open item to cover both.
- Copied Julian's MATLAB analysis files into the repo per his request: `believer_performance_model.m` and the full `Motor Testing/` folder (plotting scripts, raw RCbenchmark CSV logs, and result PNGs for the MN3110 11x7" and 12x6" runs) from his OneDrive MATLAB/QUTAS/Believer folder into `docs/engineering/analysis/` (23 files, verified byte-for-byte). Updated `context/open-items.md` and `docs/engineering/test-reports/2026-09-15-mn3110-thrust-stand-characterisation.md`, which had both noted the raw data lived outside the repo. Noted four of the copied PNGs duplicate images already in `docs/assets/` from an earlier session - left both in place, since they serve different purposes (referenced assets vs. a complete source-folder mirror).
- Julian confirmed the maiden flight date: Sunday 4 October 2026, 7:30am - added to `docs/operations/maiden-flight-test-plan.md` Section 2. Also agreed with Julian's suggestion to move the PID auto-tune phase much earlier - from after Position Hold to immediately after Climb (new Phase D) - so the remaining phases (Cruise Efficiency Sweep, Position Hold, Return, Mission) fly with tuned gains instead of mostly on PX4's untuned generic defaults; relettered the shifted phases (E-I) and fixed all cross-references. Bumped to Rev 0.6.
- Added a Cruise Efficiency Sweep phase to `docs/operations/maiden-flight-test-plan.md` per Julian, between the Climb and Glide phases: fly level at a series of fixed airspeeds, recording airspeed/throttle/battery current and voltage, to measure actual power-required-versus-airspeed data against the powertrain model's calculated best-range prediction (13.0-13.5 m/s, `docs/engineering/analysis/powertrain-performance-model.md`). Noted that points below `FW_AIRSPD_MIN` (15 m/s) - including the model's predicted optimum - must be flown in Manual mode, since Altitude/Stabilized won't command below that floor. Relettered the later phases (old D-J to new E-K) and fixed all internal cross-references. Added, per Julian, a QGroundControl Plan-view screenshot placeholder in Section 5 (Mission Mode Detail) - the image itself doesn't exist yet, flagged as an open item since Claude can't produce it.

## 2026-10-02
- Julian decided wind limits, abort criteria, and each phase's safe altitude will be set on the day at the field, taking BNEMAC's on-site advice, rather than fixed numbers in `docs/operations/maiden-flight-test-plan.md` (Rev 0.5) - replaced the three TBD placeholders with that note. Also removed a stale open item from `context/open-items.md` (whether test points would be split across multiple flights - already resolved when the plan moved to a single-flight profile, Rev 0.3) that should have been cleared earlier.
- Answered Julian's question on attitude limits: `FW_MAN_R_MAX`/`FW_MAN_P_MAX` (45/30 degrees) bound Stabilized mode, `FW_R_LIM`/`FW_P_LIM_MAX`/`FW_P_LIM_MIN` (50/30/-30 degrees) bound the autopilot in Altitude/Position/Mission/Return/Hold, and Acro has no attitude limit at all (only rate limits, `FW_ACRO_X/Y/Z_MAX`) - all still PX4's untuned generic defaults. Identified and added three gaps to `docs/operations/maiden-flight-test-plan.md` (Rev 0.4) per Julian: an attitude-limit observation note in Phases A/B/G/I feeding CTL-02; an explicit adverse-yaw observation applying across every phase, feeding CTL-07 (previously stated only in `docs/project/build-checklist.md`, not the test plan itself); and a new Section 4 (Post-Flight) covering disarm confirmation, a battery voltage/cell check given the no-BMS Li-ion pack, flight log review, and recording completed vs remaining phases.
- Julian confirmed option 1 for NAV-07 (rely on a polygon geofence matching the BNEMAC field, leave `GF_MAX_HOR_DIST` disabled), provided a fresh QGroundControl parameter export, and uploaded a maiden-flight test mission with that polygon fence. Moved both into the repo: `docs/operations/Pixhawk Parameter Backup/believer-parameters.params` (refreshed) and the new `docs/operations/Pixhawk Mission Backup/maiden-mission.plan`.
- Diffed the new parameter export against the previous backup (all 1214 parameters, not just the expected ones): confirmed RF-06, PWR-04, and NAV-08 are all applied as planned, plus routine calibration drift. Found one unplanned change, `RTL_TYPE` (1 to 0), and traced it to the uploaded mission having no landing pattern - `RTL_TYPE` = 1 would likely cause PX4 to reject the mission ("landing pattern required"), and changing to 0 is the documented fix, confirmed against a matching PX4 community report. Verified programmatically that all 32 mission waypoints and the home position fall inside the polygon fence, and confirmed via PX4's documentation how the mission will behave: the takeoff item is treated as a normal waypoint since it'll only be engaged mid-flight, and the aircraft enters Hold at the last waypoint on completion (no landing item exists). Flagged the mission's actual acceptance by PX4 as unconfirmed pending a real re-upload test.
- Closed PWR-04, RF-06, NAV-07, and NAV-08 in `docs/project/build-checklist.md` (moved to Completed Work) now that all are confirmed applied/resolved. Updated `docs/engineering/flight-modes.md` (Rev 1.16) and `docs/operations/Pixhawk Parameter Backup/parameter-change-log.md` to match the confirmed live values and document the `RTL_TYPE` reasoning.
- Added PID auto-tune to CTL-02's scope per Julian, and restructured `docs/operations/maiden-flight-test-plan.md` (Rev 0.3) from discrete flights into a single-flight, ordered-phase profile per his "as many tests as possible in one flight, no need to land between" instruction - added an auto-tune phase and a Mission-mode phase, plus a new section detailing the uploaded mission.
- Added two more pre-flight checklist steps in `docs/operations/manual.md` (now 53 steps): corrected the `RTL_TYPE` check to 0 (was 1) and reworded the geofence check for the polygon fence; added a new check confirming the battery parameters (`BAT1_V_EMPTY`/`BAT1_V_CHARGED`/`BAT1_N_CELLS`) match whatever battery chemistry is actually installed, per Julian - flagging the risk that a future LiPo swap could silently leave Li-ion-tuned parameters in place and cause PX4 to overestimate remaining charge. Updated the renumbered cross-references in `docs/engineering/flight-modes.md`, `context/open-items.md`, and `docs/operations/Pixhawk Parameter Backup/parameter-change-log.md`.
- Julian confirmed the maiden flight test site (BNEMAC field, Fitzgibbon, approximately 300 m radius) and proposed tightening `NAV_LOITER_RAD`/`RTL_LOITER_RAD` from 80 m to 50 m and setting `NAV_MIN_LTR_ALT` from -1 (disabled) to 40 m provisional. Confirmed 50 m is a safe tightening (about 39 degrees of bank at `FW_AIRSPD_TRIM`, within `FW_R_LIM` = 50 degrees, in-turn stall speed about 12.5 m/s against `FW_AIRSPD_MIN` = 15 m/s) and confirmed `NAV_MIN_LTR_ALT` is measured above the home position, not AMSL or AGL, against PX4's own source parameter description. Added NAV-08 (`docs/project/build-checklist.md`), two new pre-flight checklist steps (site-survey for obstacle height, parameter confirmation - `docs/operations/manual.md`, now 52 steps), updated `docs/engineering/flight-modes.md` (Rev 1.13-1.14) and `docs/operations/maiden-flight-test-plan.md` (Rev 0.2, also resolving the test-site open item), and updated `context/open-items.md`/`context/project-notes.md` accordingly. None of the three parameters are applied to the physical FC yet.
- Added `docs/operations/maiden-flight-test-plan.md` (FTP-BELIEVER-001, Rev 0.1), drafting the flight test campaign Julian described: every flight is a hand launch; Flight 1 is airworthiness-only (Acro launch/land, brief Manual-mode check at altitude); later flights cover stall speed/behaviour, climb/thrust sufficiency, glide, Acro, Stabilized, Position Hold, and Return to Home. Answered Julian's loiter-radius question (`NAV_LOITER_RAD` = 80 m for Position Hold, `RTL_LOITER_RAD` = 80 m separately for Return, `NAV_MIN_LTR_ALT` = -1 confirmed as PX4's own default). Reworded `docs/operations/manual.md`'s launch-mode steps (41, 46) to defer to the mode specified in the current test plan, since Flight 1's Acro launch differs from `docs/engineering/flight-modes.md`'s general Stabilized-for-hand-launch guidance. Cross-referenced the plan from CTL-02 (`docs/project/build-checklist.md`). Flagged five new open items in `context/open-items.md` (wind limits, abort criteria, safe altitudes, flight grouping, test site layout) that the plan surfaced but doesn't yet answer.
- Added three more pre-flight checklist items in `docs/operations/manual.md` per Julian (42 to 50 steps total today): the pilot must be briefed on every switch and gimbal function relevant to the flight modes planned for the current flight (step 3, referencing the maiden flight test plan); the pilot and handler agree flight mode and arm/disarm status will be called out verbally from both the radio side and QGroundControl (step 4); and the GX12's and QGroundControl's audio volumes are both turned up and audible (step 19). Also added explicit callouts to the mode-select, arm, and disarm action steps themselves (41, 43, 48) so the step 4 agreement is actually exercised, not just stated. Updated the renumbered cross-references in `docs/engineering/flight-modes.md` (Rev 1.12), `context/open-items.md`, and `docs/operations/Pixhawk Parameter Backup/parameter-change-log.md` (the last of these had drifted stale since an earlier renumbering today and was corrected here).
- Tightened the geofence check (step 24) in `docs/operations/manual.md` per Julian. It previously only confirmed the geofence was active and the breach action was Return; now confirms the specific values - `GF_ACTION` = 3, `GF_MAX_VER_DIST` = 120 m, and `GF_MAX_HOR_DIST` set to a site-appropriate radius rather than its current 0 (disabled). Current breach behaviour is vertical-only (120 m ceiling triggers Return) since `GF_MAX_HOR_DIST` = 0 is still open (NAV-07) - confirmed `GF_ACTION` = 3 is RTL and `GF_SOURCE` = 0 is the fused global position estimate (PX4 defaults) against PX4's documentation.
- Expanded the pre-flight checklist in `docs/operations/manual.md` (42 to 47 steps) per Julian. Added three physical checks that the Recurring Airworthiness Verification table (`docs/project/build-checklist.md`) already called for "before every flight" but the checklist never asked: motor/ESC inspection-bay cover retention, nacelle fairing retention, and DBR4 antenna orientation/security (distinct from the RFD900x's own 900MHz antenna step). Added two parameter-confirmation steps stating the intended target values directly, matching the existing `COM_DISARM_LAND` check's style: `COM_LOW_BAT_ACT` = 3 (PWR-04's target, not yet applied) and `NAV_RCL_ACT`/`NAV_DLL_ACT`/`RTL_TYPE`/`RTL_LAND_DELAY` = 2/2/1/-1 (RF-06's target for the data-link side, not yet applied). Updated the renumbered cross-references in `docs/engineering/flight-modes.md` (Rev 1.11) and `context/open-items.md`.
- Deleted `docs/assets/motor-rotation-direction.png` per Julian - the diagram depicted the old contra-rotating assumption (LHS counterclockwise, RHS clockwise) and was already unreferenced following the pre-flight checklist cleanup above. Removed the matching `context/open-items.md` entry.
- Reviewed the pre-flight checklist in `docs/operations/manual.md` with Julian. Confirmed the motors and propellers are not contra-rotating (both spin the same direction - already correctly stated in `docs/engineering/ICD.md` and `context/project-notes.md`, but the checklist still described the old contra-rotating assumption) and simplified the two affected steps accordingly: the motor-rotation-direction check (dropped the per-side clockwise/anticlockwise claim and the now-stale `assets/motor-rotation-direction.png` diagram link) and the propeller retention nut check (dropped the LHS-reverse-thread claim). Matched the Recurring Airworthiness Verification table in `docs/project/build-checklist.md`. Separately simplified the Manual-mode control-surface check, dropping its overlong CTL-08 justification sentence per Julian - unrelated to the rotation correction. Flagged the now-unused, factually stale diagram asset in `context/open-items.md` for Julian to delete or replace manually.
- Julian decided RC loss and data-link loss should both return the aircraft home and hold position (not land automatically), resolving the `NAV_DLL_ACT` confirmation flagged in the parameter review above. Verified against PX4's Return Mode documentation that `NAV_RCL_ACT` = 2 (Return) with `RTL_LAND_DELAY` = -1 already does this for RC loss, and that `RTL_TYPE` = 1 resolves to the home position since no rally points or mission landing pattern are defined - so only `NAV_DLL_ACT` (0 to 2) needs to change. Added RF-06 to `docs/project/build-checklist.md`, flagged the pending change in `docs/engineering/flight-modes.md` (Rev 1.10), and updated `context/open-items.md`/`context/project-notes.md` accordingly. Not yet applied to the physical FC.
- Reviewed all 1214 parameters in the refreshed backup by safety-relevant category for a pre-maiden flight review Julian requested. Added PWR-04 (`COM_LOW_BAT_ACT` 0 to 3, PX4's recommended setting, plus `COM_ARM_BAT_MIN`) and NAV-07 (`GF_MAX_HOR_DIST` 0.0, currently no horizontal geofence boundary) to `docs/project/build-checklist.md`. Confirmed `CBRK_FLIGHTTERM`/`CBRK_IO_SAFETY`/`CBRK_USB_CHK`'s unusual-looking values are PX4's own documented stock defaults, not misconfigurations. Flagged `NAV_DLL_ACT` = 0 for Julian's explicit confirmation given the aircraft's dual-link RC architecture, rather than recommending a change outright. Updated `context/open-items.md` and `context/project-notes.md` accordingly.

- Julian confirmed the U5 KV400 physical swap is done and proposed raising `PWM_MAIN_MAX4`/`MAX6` back to 2000 to close PROP-08. Flagged that this only holds once the U5s are installed (not the MN3110s), and confirmed the parameter has not yet been set (pending an export) and that only a quick bench spin-up check is planned, not a full sustained in-aircraft run. Updated PROP-08 (`docs/project/build-checklist.md`, status to In progress, ceiling change recorded as planned, acceptance criteria revised to name the evidence it will rest on) and `context/open-items.md`/`context/project-notes.md` accordingly. Not yet closed.
- Calculated the mass change for the MN3110-to-U5 swap from both motors' official specifications (T-Motor datasheet/store page): +152g for the pair excluding cables, +192g including the supplied 600mm leads. Recorded a recommended +190g (0.19kg) estimate for `WEIGHT_BASE`/`WEIGHT_GROSS` in `context/open-items.md`, pending Julian weighing the actual installed pair for an exact figure.
- Pulled the latest SD card log (first ground test with the U5 KV400 motors installed, `G:\log\2026-10-02`): `PWM_MAIN_MAX4`/`MAX6` = 2000 and `WEIGHT_BASE`/`WEIGHT_GROSS` = 4.0 confirmed from the log's embedded parameters; full-throttle current 29.4 to 30.9A total (about 15.5A/motor equal split), well under the U5's 30A rating and consistent with the thrust-stand data; both motor commands identical throughout; 5V rail, power-rail flags, IMU vibration and PX4's failure detector all clean. Added `docs/engineering/test-reports/2026-10-02-u5-first-ground-test.md` and its figure. Updated PROP-08 (`docs/project/build-checklist.md`) with the confirmed result and `context/open-items.md`/`context/project-notes.md` accordingly - this is the quick spin-up check Julian had planned, so PROP-08's agreed acceptance criteria are now met, though not formally closed (Julian's call, as with PROP-11).
- Julian accepted the calculated +190g mass estimate without an independent weighing of the installed U5 pair ("the motors will be close to the weight on the tin"). Regenerated `docs/operations/Pixhawk Parameter Backup/believer-parameters.params` from the 2026-10-02 ground-test log (no additions/removals against the 2026-09-02 export) and updated `parameter-change-log.md` to match, adding rows for `WEIGHT_BASE`/`WEIGHT_GROSS` and `COM_DISARM_LAND` that had never been captured there, correcting a stale `BAT1_N_CELLS` note, rewriting the `PWM_MAIN_MAX4`/`MAX6` history, and refreshing the calibration tables (noting the magnetometer soft-iron terms suggest an unconfirmed recalibration since 2026-09-02).
- Checked Julian's report of no GPS data from "the M10" against the logs: GPS driver instance 2 (the M8N, per the project's records) has never logged a single `sensor_gps` sample in any flight log from the 2026-08-19 install through 2026-10-02, including 2026-09-02, the date NAV-05 was closed on "both receivers confirmed achieving a lock" - a claim with no log support. Corrected the NAV-05 closure note and the M8N configuration bullet in `docs/project/build-checklist.md`'s Completed Work, opened NAV-06 to diagnose it, and flagged the unreconciled "M10"/M8N naming. Updated `context/open-items.md` and `context/project-notes.md`.
- Julian confirmed he recalibrated the compass and other sensors (explaining the magnetometer shift noted above) and confirmed the GPS in question is the M8N, not a different module. Reviewed every M8N-relevant parameter against PX4's documentation for NAV-06: port/protocol assignment, baud, and GNSS mask all look consistent with the documented intentional setup and unchanged since 2026-09-02 - ruled out `GPS_UBX_BAUD2` (Claude's leading hypothesis) as it only applies to the ZED-F9P's second UART, not the M8N. Updated the calibration note in `parameter-change-log.md` and NAV-06's scope/background (`docs/project/build-checklist.md`) with a recommended first diagnostic step (direct module check via u-center, bypassing the Pixhawk) and `context/open-items.md`/`context/project-notes.md` accordingly.
- Julian pushed back on the GPS finding ("I swear it has worked in the past, I have definitely seen dual gps mavlink messages"). A full scan of all 326 logs on the SD card (the earlier pass had only checked from 2026-08-19 onward) confirmed he was right: the M8N worked correctly as instance 1 from 2026-06-02 through 2026-08-19 (the ZED-F9P's own 2026-07-04 to 2026-08-31 gap was a separate, deliberate disable pending its antenna/mount, not a fault). From the first log after the 2026-08-31 instance swap onward (not 2026-09-02 as the parameter backup had it), the M8N has never logged a sample as instance 2, with no intermediate working period found. This pins the fault to the swap or physical work around that session, not the original install. Rewrote NAV-06 and the two Completed Work GPS bullets in `docs/project/build-checklist.md`, the GPS section and two parameter rows in `parameter-change-log.md`, `context/open-items.md`, and added a correction entry to `context/project-notes.md`.
- Julian reported the M8N's LED and buzzer are active (powered, running), pointing toward the UART link rather than a dead module. He then asked for the M8N's parameters from when it worked as GPS1, meaning to try reverting them on the GPS2 slot. Comparing 2026-07-03 (working, as `GPS_1_*`) against now (as `GPS_2_*`) found `GPS_CONFIG` and `GPS_PROTOCOL` identical, but `GPS_GNSS` was 0 then against 29 now - and 29 turns out to be the ZED-F9P's own old value, carried over by slot position in the 2026-08-31 swap rather than chosen for the M8N, which has never been tested with an active GNSS request. Recorded as the leading, testable hypothesis in NAV-06, the `GPS_2_GNSS` row in `parameter-change-log.md`, `context/open-items.md` and `context/project-notes.md`. Julian is testing `GPS_2_GNSS` = 0.
- **NAV-06 confirmed fixed.** Julian set `GPS_2_GNSS` to 0 and confirmed it fixed the M8N; checked the next SD card logs directly and confirmed the M8N (instance 2) now logs a 3D fix with up to 15 satellites, its best ever recorded. Closed NAV-06 in `docs/project/build-checklist.md` (moved to Completed Work with the full diagnosis), removed the matching item from `context/open-items.md`, and fixed an orphaned `</details>` tag left over from an earlier edit in the same section. Regenerated `believer-parameters.params` from the fixed log and updated `parameter-change-log.md`'s `GPS_2_GNSS` row and calibration tables.
- Julian reports the M8N's own LED and buzzer are active, so it has power and is running internally. Updated NAV-06 (`docs/project/build-checklist.md`) with this: rules out a dead/unpowered module, points toward the UART data path (TX wire or connector) rather than the module, and sharpened the recommended diagnostic steps accordingly (confirm the LED's blink pattern against a 3D-fix indication, then check TX-wire continuity if u-center shows the module streaming cleanly on its own).

## 2026-09-30

- Julian closed PROP-11 on his own judgement ("I am happy to close this one"), rather than pursuing the instrumented temperature log or formal electrical condition checks originally scoped. Removed the PROP-11 dashboard row and section from `docs/project/build-checklist.md` and added a closed summary under Completed Work; updated `context/open-items.md` (remaining work is installing the U5 motors and AIR 40A ESCs in the aircraft, not further testing) and `context/project-overview.md`'s blocker list.

- Julian ran the U5 KV400 at full throttle for 483 s on the ESC removed from the failed left drive (the suspect ESC), with the throttle briefly cut four times for hand-touch temperature checks: 393 s cumulative at full throttle, current flat at 15.8 to 16.9 A, no fault, motor only slightly warm by hand each time. **Julian's decision: install the U5 KV400 motors with the AIR 40A ESCs in the aircraft**, resolving PROP-11's motor and ESC choice. Added the figure `docs/assets/u5-esc-sustained-full-throttle.png` and a section to the test report; updated PROP-11 (`docs/project/build-checklist.md`, status to In progress, decision and per-criterion progress recorded), `context/project-notes.md` and `context/open-items.md`. Still open: instrumented temperature logging, the electrical condition checks, the right motor/ESC untested, and any in-aircraft or flight measurement.

- Added the extended U5 stand run (`Log_2026-09-30_112954`, 641 s slow ramp) to the test report: confirms the earlier calibration with about 490 full-throttle samples (thrust factor 0.98, power factor 1.01 essentially unchanged), no anomalies. Recorded that all U5 testing so far used the right-hand MN3110's ESC, not the suspect left one, and that Julian reports the units are in good condition and were indistinguishable from room temperature to the touch after full throttle (informal, not logged). Recorded Julian's plan to test the suspect ESC directly next and to run a temperature-logged sustained test once a thermal camera is available. Updated `context/open-items.md` and the test report's Outstanding section.

- Julian bench tested the U5 KV400 with the 12x6E on the re-borrowed thrust stand (`docs/engineering/test-reports/2026-09-30-u5-kv400-thrust-stand-characterisation.md`): full-throttle static thrust 1.84 to 1.94 kgf at 14.0 to 14.7 A (47 to 49% of the 30 A rating), no cutout. Calibrated the powertrain model on this data (thrust factor 0.98, power factor 1.01, `docs/engineering/analysis/powertrain-model/calibrate_u5.py`): static thrust-to-weight 0.95 at 3.95 kg, total in-flight thrust 4.8 to 5.0 times the drag at 15 m/s and 2.6 to 2.7 times at 20 m/s, cruise power about 132 W at 15 m/s and 222 W at 20 m/s. Superseded the earlier unmeasured U5 estimates and the "0.53 worst case at 10 m/s" figure given in conversation. Found the power factor differs sharply from the MN3110's own 12x6E run (1.01 against 1.22), most likely unit-to-unit propeller variation; the U5's usable thrust is capped by its speed limit, not current, and it beats the MN3110 in thrust per amp on the same propeller at every point measured. Added figures `docs/assets/u5-thrust-vs-esc-signal.png`, `u5-current-vs-esc-signal.png`, `u5-vs-mn3110-thrust-vs-current.png`; extended `powertrain_model.py` with a per-motor propeller-scale override and regenerated the main figure and results using it. Updated `context/project-notes.md`, `context/open-items.md` and PROP-11 (`docs/project/build-checklist.md`). Not yet done: a sustained 180 s run with temperature, and the U5 condition check.

## 2026-09-28

- Filed the invoice for the 12x6 propellers (Alibaba notice B1020260906048362, 2026-09-06, 51.96 CNY, $10.56 AUD as charged, Julian personal funds) as `docs/project/purchase-history/invoices/gemfan-apc-nylon-12x6-propellers-2026-09-06.pdf` (moved from the repo root), added it to `docs/project/purchase-history/purchase-history.md` and updated Julian's personal total ($252.33 to $262.89 AUD) and the all-parties total (~$1,475.31 to ~$1,485.87 AUD). The invoice describes a Gemfan nylon "APC" propeller, so the stand propeller may be a copy of the APC 12x6E pattern; recorded in `context/project-notes.md`, the model write-up's limitations, the stand report, and a new open item to confirm the brand.
- Julian confirmed from a photo that the stand propeller is the APC 12x6E, so the powertrain model was recalibrated on the 12x6E tables using the stand's rotor-speed channel (thrust factor 0.99, power factor 1.22, bus current within 1.4% rms). Regenerated `docs/engineering/analysis/powertrain-performance-model.md`, its figure, scripts (new `calibrate_12x6e.py`) and CSV results, and recorded the corrected figures in a new section of `context/project-notes.md`; earlier model findings and the 4%/8% rotor-speed statement are marked superseded. The stand report now records the propeller as the 12x6E, the PROP-11 model pointer has the corrected numbers, and the open item asking which 12x6 was used is removed. Corrected results: MN3110 reaches its 21 A rating at 1.35 kgf (about 1545 us, thrust-to-weight 0.71); U5 1.80 kgf static (0.91), 2.5 times the drag at 20 m/s (1.4 times worst case) and, at 10 m/s, thrust-to-weight 0.73 (0.53 worst case, superseding the earlier 0.62); cruise 159 to 165 W at 15 m/s and 266 to 286 W at 20 m/s calibrated. Estimates, unverified; no motor choice adopted.
- Corrected an earlier statement that the stand's RPM data were unusable: the `Motor Electrical Speed (RPM)` column is usable rotor speed above about 1520 us (within about 2% of the speed implied by thrust for the 11x7", 6 to 9% for the 12x6") and spurious below about 1500 us; the optical column is zero. Recorded in `context/project-notes.md` (new section, and the earlier wrong statement annotated), `context/open-items.md` (data wanted from the U5 stand test), and `docs/engineering/analysis/powertrain-performance-model.md` (section 4 rotor-speed cross-check; new script `calibrate_rpm.py`). The model predicts stand rotor speed 4% low (11x7") and 8% low (12x6") for the sport propellers.
- Julian has arranged to borrow the thrust stand again to bench test the U5 KV400 with the 12x6". Recorded in `context/open-items.md` with the data needed to recalibrate the powertrain model and extrapolate to flight speeds (steady throttle steps, thrust, voltage, current, RPM, exact propeller, ESC, temperature) and the warning that the U5 at full throttle is near the roughly 500 W level where the earlier runs cut out.
- Julian has fixed the motor mounts for the U5 KV400 motors. Recorded in `context/project-notes.md` and removed the mount check from the U5 evaluation item in `context/open-items.md`; the remaining checks are weighing a U5, its condition, and the restrained test.
- Added a powertrain performance model (`docs/engineering/analysis/powertrain-performance-model.md`, scripts in `docs/engineering/analysis/powertrain-model/`, results as CSV, figure `docs/assets/powertrain-model-2026-09-28.png`), built at Julian's request from APC's PER3 tables, the wind-tunnel drag polar, motor listings and datasheets, and the pack, and calibrated on the stand data. Recorded the findings in `context/project-notes.md`, added a row to `context/startup-prompt.md`, a pointer in PROP-11 (`docs/project/build-checklist.md`), and an open item to validate the model in the aircraft.
- Corrections from the model, in `context/project-notes.md` and `context/open-items.md`: the earlier interpolation that put the U5 at only 0.8 to 2.5 times the drag at 20 m/s is superseded (3.1 times base, 1.8 times worst case); the stand propeller behaves like the sport or slow-flyer 12x6, not the 12x6E, resolving the mismatch with APC's 12x6E data; the MN3110 winding-current estimates are refined to 25.0 A (119%) at 1600 us and 29.9 A (143%) at 1700 us; and the level-flight power at 20 m/s is about 213 to 225 W, not 280 to 300 W. Estimates, unverified; no motor choice adopted.
- `context/project-notes.md`, `context/open-items.md`: corrected the earlier statement that cruise is easy on the motors. It holds for the MN3110 but the U5 KV400, speed-limited to about 7,500 to 8,300 rpm, is comfortable at 15 m/s or below (about 2.3 to 6 times the drag) and only marginal at 20 m/s (about 0.8 to 2.5 times) by a rough interpolation of APC's data (the full table could not be retrieved). Unverified; no flight has been made with any motor.
- `context/open-items.md`: recorded that Julian has no milliohm meter or insulation tester, and the near-term alternatives (phase-to-case check with the multimeter, no-load current comparison per motor and ESC with an inline fuse, or borrowing instruments from a QUT workshop).

## 2026-09-27

- Julian confirmed the MN3110 KV700 motors were installed at roughly 2026-07-24 and that the flight computer used to be on a multicopter. Scanned all 322 SD card logs: the logs bracket the install between 2026-07-10 and 2026-07-26 (motor PWM range changed to 1000-2000 us at 06:33-06:35 UTC on 2026-07-26). Corrected the motor install date from 2026-08-19 (the date the change was reported) in `context/project-notes.md`, `docs/project/build-checklist.md` (Propulsion heading) and `docs/project/purchase-history/purchase-history.md`, and noted the first-seen date of the 1000-2000 us motor range in `docs/operations/Pixhawk Parameter Backup/parameter-change-log.md`. The ESC install date is not separately confirmed and was left as reported.
- `docs/engineering/test-reports/2026-09-26-bench-simulated-flight-motor-failure.md`: added "Time Above Rated Current Since the Motors Were Installed" - about 64.8 s above 21 A per motor in the aircraft (07-26 1.6 s, 08-18 9.4 s, 09-02 14.1 s, 09-26 39.7 s) plus 31.7 s on the thrust stand (Julian: the stand used the aircraft's motors), about 96.5 s in total, with method and limits. Corrected the date of the earlier 60-66 A bursts from 2026-08-31 to 2026-08-18 and 2026-09-02 (the logs show no high current on 2026-08-31; the older 2026-08-31 wording elsewhere is left pending confirmation - open item).
- `context/project-notes.md`, `docs/project/build-checklist.md` PROP-11: recorded a correction to the replacement-motor research. The earlier comparison used battery current against each motor's rating, which understates winding current at part throttle. On an estimated winding-current basis the installed MN3110 is well over its rating even at 1600 us on the static bench, the MN3510 KV700 about 130%, and the KDE3510XF-475 about 75% with about half the copper heat; the earlier note that the KDE's advantage was "not lower copper loss" was wrong and is superseded. Also recorded that no MN3110 KV900 exists (the KV780 gives no advantage), the ArduPilot Believer page's SunnySky 2814 KV900 parts list against the maker's 3-4S listing, and the KDE mass with leads as supplied (about +150 g for the pair, about +80 g trimmed). The estimates are unverified; no choice adopted.
- `context/open-items.md`: added the ESC install date, the 2026-08-31 test date discrepancy, and the stand motor identity.
- Corrected the thrust-stand dates in the tally (`docs/engineering/test-reports/2026-09-26-bench-simulated-flight-motor-failure.md`, `context/project-notes.md`, `context/open-items.md`): the 11x7" runs were 2026-09-06 and 2026-09-10 (per `docs/engineering/test-reports/2026-09-15-mn3110-thrust-stand-characterisation.md`); only the 12x6" runs were 2026-09-15. All 13 CSV files in the stand folder were included; the total (31.7 s) is unchanged.
- Added `docs/assets/motor-current-histogram-since-install.png` (time in each 1 A bin of per-motor current since installation, aircraft and thrust stand stacked, with the 21 A rating marked) and linked it from the failure report's tally section, at Julian's request.
- Regenerated the histogram at Julian's request with a linear Y axis and samples below 1 A (idle) excluded; the log-scale version had made the tail above 21 A look larger than it is. Time at or above 1 A is about 2,130 s (1,344 s aircraft, 787 s stand), so the 96.5 s above 21 A is about 4.5% of it. The tallies are unchanged.
- Julian returned the thrust stand and no longer has access to it. Recorded in `context/project-notes.md` and `context/open-items.md`, with the alternatives (restrained in-aircraft test with a spring scale, logged pack current and a temperature probe, or another stand). Also recorded the search for thrust data on the U5 KV400 and KDE3510XF-475 with the 12x6" on 6S (none found; T-Motor's U5 data is for 14x4.8, 15x5 and 16x5.4), APC's static 12x6E data and its mismatch with the stand (which widens the MN3110 winding-current estimate at 1700 us to about 26 to 33 A), and an unverified U5 KV400 estimate (about 1.6 to 1.9 kgf at full throttle, about 13 to 22 A winding, +152 g for the pair). No choice adopted.
- Julian stated that the ESCs were not configured properly and one propeller was mounted backwards at the 2026-07-05 BNEMAC visit, so the U5 "inadequate thrust" finding is unreliable, and that a static thrust-to-weight of about 0.8 would be acceptable. Recorded in `context/project-notes.md` (new section; the BNEMAC finding annotated) and `docs/project/build-checklist.md` PROP-10 (working target, not adopted as the pass/fail number, status unchanged). Withdrew the argument that the U5 is speed-limited on 6S, which rested on the 2026-07-05 logs. No motor choice adopted.
- Julian gave the planned payload (Raspberry Pi 4 with heatsink and fan, IMX335 USB camera, DJI O3 Air Unit, added after the maiden flight, with about 200 g headroom on top; 3.8 kg for the maiden unless the motors or ESCs change). Recorded in `context/project-notes.md` (new section: rough 190 g payload estimate, about 4.2 kg design mass, static thrust-to-weight of the MN3110 with the 12x6" at 3.8 kg and 4.2 kg, and the cruise-speed correction: 20 m/s is the manufacturer's recommended cruise, not a computed optimum in the Weishaeupl paper; best range is about 12.7 m/s at 4 kg) and `context/open-items.md` (weigh the payload). Corrected an earlier statement that the 12x6" stops producing thrust at about 19 m/s.
- Julian said the 200 g headroom is a comfort margin, not a hard requirement. Recorded in `context/project-notes.md` and added an open item for evaluating the U5 KV400 motors (weigh, check mounts and condition, then a restrained in-aircraft test). No motor choice adopted.
- Julian tested phase-to-phase winding resistance on both motors with a multimeter: 24 to 25 ohms on the failed left motor, about 24 ohms on the right. Recorded in the failure report's Outstanding section and a new open item that this is not a valid measurement (about 260x the 92 mOhm datasheet figure; an ordinary multimeter cannot resolve milliohm-level winding resistance) - it rules out a dead short or an open winding on either motor but not winding health, balance or a partial short. A four-wire milliohm meter and an insulation resistance tester are needed.

## 2026-09-26 (continued x13)

- Julian stated the PETG mount was not the cause of the motor failure and that he needs to confirm the MN3510 KV700 can handle 6S. Withdrew the suggestion that the mount might have caused the failure: `context/project-notes.md` (corrected sentence in the motor research section, plus a new dated section), `docs/engineering/test-reports/2026-09-26-bench-simulated-flight-motor-failure.md` and `docs/project/build-checklist.md` PROP-11 (the mount requirement is now a temperature measurement on the next bench run, not a required material change), `context/open-items.md`.
- Recorded what T-Motor publishes about 6S: the MN3510 KV700 is listed 3-4S only with low-pitch recommended propellers and no stated maximum voltage; no user reports of 6S use were found. Added an open item and a conditional PROP-11 acceptance criterion (written T-Motor confirmation if the MN3510 KV700 is chosen).

## 2026-09-26 (continued x12)

- `context/project-notes.md`, `docs/project/build-checklist.md` PROP-11: recorded the replacement-motor research Julian asked for (sticking with the 12x6" and 6S, with about 200 g of mass headroom): a specification comparison of the installed MN3110 KV700 against the T-Motor MN3510 KV700/KV630, MN3508 KV580, KDE3510XF-475, and the heavy 3520-class motors (ruled out on mass), with the reasoning that current is set by the propeller so a different motor buys margin, not lower current, and the caveats (MN3510 KV700 listed 3-4S, matched-pair replacement, failure possibly in the ESC or mount). Specifications are from listings, not verified. No choice adopted.

## 2026-09-26 (continued x11)

Julian confirmed `06_16_46` was him checking the motors after the left one smoked, that the right-hand side seems fine, that the ESCs are enclosed in the wing with no airflow, and that the ESC timing is unknown.

- `docs/engineering/test-reports/2026-09-26-bench-simulated-flight-motor-failure.md`: recorded the above; **revised the earlier lean towards the motor** - the enclosed, uncooled ESC is now a live candidate, with the checks that would separate the two mechanisms; updated outstanding items (explicit ESC timing, check the right-hand side, ESC cooling or rating, bench fuse suggestion).
- `docs/project/build-checklist.md` PROP-11: ESC choice and cooling added to the scope and acceptance criteria.
- `docs/engineering/ICD.md` (Rev 2.7 -> 2.8, header updated): recorded the PETG motor mounts, motor airflow in flight, the ESCs' lack of cooling, the unrecorded ESC timing, and the left motor failure. **Corrected a stale paragraph** in the ESC section that still described static thrust and throttle mapping as unverified (PROP-02/PROP-06 were closed 2026-09-02).
- `context/open-items.md`, `context/project-notes.md`: updated.

## 2026-09-26 (continued x10)

- Julian reported that the motors get airflow in flight but the ESCs largely do not, that the motors are mounted on 3D-printed PETG, and that the failed left motor melted its PETG mount. Recorded in `docs/engineering/test-reports/2026-09-26-bench-simulated-flight-motor-failure.md` (summary, a new "melted mount points at the motor" evidence bullet noting the failed drive was powered again in `06_16_46`, and updated outstanding items, including replacing the PETG mounts with a heat-resistant material or thermal break), `docs/project/build-checklist.md` PROP-11 (scope and two new acceptance criteria: mount material rated for worst-case temperature, and ESC temperature within limits), `context/open-items.md`, and `context/project-notes.md`.

## 2026-09-26 (continued x9)

- `docs/engineering/test-reports/2026-09-26-bench-simulated-flight-motor-failure.md`: while answering whether airflow in flight would cool the motors, read the AIR 40A ESC manual and added that its documented over-load protection (output cut when the load suddenly rises very high, resuming only at neutral throttle) fits the current collapse after the 102.9 A sample, and that ESC timing (default Intermediate; High raises motor temperature) is a setting whose value is not recorded. Added an outstanding item to record the motor/ESC housing (closed or vented), ESC timing and 3D-printed mount material, inspect the mounts for heat deformation, and measure motor and ESC temperature on the next bench run.

## 2026-09-26 (continued x8)

- `docs/engineering/test-reports/2026-09-26-bench-simulated-flight-motor-failure.md`: added a margin bullet to "What the Evidence Supports" after Julian asked whether he had pulled too much from the motor. Full stick at the 1800 us ceiling put each motor at its rated maximum (about 21.2 A, 457 W) and briefly above it (up to about 23.8 A, 113%) for about 6 s; the rating is for 180 s, so that alone does not explain the failure, but the 1800 us ceiling itself left no margin (it was set on 2026-09-02 for the 11x7" propellers to sit at about 21 A per motor, and the 12x6" would draw roughly 26 A per motor at 1800 us on a full pack). The earlier summary in this report had stressed the totals without stating that margin plainly.

## 2026-09-26 (continued x7)

- `docs/engineering/test-reports/2026-09-26-bench-simulated-flight-motor-failure.md`: after Julian asked for exactly what happened, checked further signals from the same log and added them: flight mode was Acro throughout (motor command is the throttle stick directly), the stick was held at 100% for about 5 s then pulled back by Julian at 516.6 s (the 102.9 A sample was logged after that chop began), vibration metrics showed no growth, the 5 V rail and processor were unaffected, and no failsafes fired. Added a "What the Evidence Supports" section separating what is supported, consistent, unsupported and unknown. **Corrected an assumption in the report's location line** (it had said the aircraft was restrained, which was not known; the propeller model is also not recorded).

## 2026-09-26 (continued x6)

Julian reported the left motor burning out during a bench simulated flight and asked for the logs to be stitched and analysed for overcurrent.

- Added `docs/engineering/test-reports/2026-09-26-bench-simulated-flight-motor-failure.md` and two figures (`docs/assets/bench-simulated-flight-2026-09-26.png`, `bench-simulated-flight-2026-09-26-fault-zoom.png`): stitched current, pack voltage and motor command; findings that there was no sustained overcurrent (about 6 s above 21 A per motor if shared equally) but a fault signature at the end, and abnormal current drawn since.
- `docs/project/build-checklist.md`: added **PROP-11** (Critical: replace the failed left motor and verify the drive; replacement choice left open) and a dashboard row; noted under PROP-08 that the ~1700us ceiling was still not applied; updated the custom battery entry (capacity test not completed).
- `context/open-items.md`: added the motor-failure item and rewrote the proposed-parameter-changes item to show what the 2026-09-26 log headers confirm as applied (`WEIGHT_BASE`/`WEIGHT_GROSS` 3.8, `BAT1_V_EMPTY` 3.2, `COM_DISARM_LAND` -1) and not applied (`PWM_MAIN_MAX4`/`MAX6` 1800, `COM_LOW_BAT_ACT` 0, `BAT1_CAPACITY` -1); updated the battery capacity-test item.
- `context/project-overview.md`, `context/project-notes.md`: blockers summary and dated provenance entry.

## 2026-09-26 (continued x5)

- `docs/operations/manual.md`: per Julian's decision to keep `COM_DISARM_LAND` at -1 for the maiden flight, extended pre-flight step 16 to check the value and added a "Landing and shutdown" section (steps 40-42: manual disarm with CH5 after landing, keep clear until disarm is confirmed, kill switch if a propeller turns, disconnect the battery). Appended without renumbering the existing steps, so cross-references are unaffected.
- `context/open-items.md`: recorded the `COM_DISARM_LAND` decision. Withdrew the `BAT1_V_CHARGED` 4.05 -> 4.10 proposal (4.05 is the PX4 default and its recommended Li-ion value); recorded `BAT1_R_INTERNAL` to stay at -1 with the condition for revisiting it; noted PX4's generic Li-ion `BAT1_V_EMPTY` values against the provisional 3.3.
- `docs/operations/Pixhawk Parameter Backup/parameter-change-log.md`: corrected the `BAT1_N_CELLS` note, which had listed `BAT1_V_CHARGED` among LiPo-style defaults although 4.05V is PX4's recommended Li-ion value.
- `context/project-notes.md`: dated provenance entry for the decision and the two parameter questions.

## 2026-09-26 (continued x4)

Julian reported the aircraft's all-up weight (3.8 kg) and that his charger tops out at 4.15 V per cell, and asked for parameter recommendations. Claude checked the live parameter export and PX4 documentation; **no parameters were changed** - the proposals are recorded only.

- `context/open-items.md`: added the proposed parameter changes (none applied), a low-battery failsafe item (`COM_LOW_BAT_ACT` is 0, warning only), reworded the `COM_DISARM_LAND` item as an open decision given the hand-launch procedure, and updated the battery items for the 3.8 kg weight and the 4.15 V charger limit.
- `docs/project/build-checklist.md`: PROP-10 thrust-to-weight criterion met (about 0.89 at 3.8 kg; only the target ratio is open); CTL-09 role of `WEIGHT_BASE`/`WEIGHT_GROSS` confirmed against PX4 docs with values proposed; AF-01 entry updated; added a caveat to the failsafe Completed Work entry that the battery thresholds only warn. **Corrected a documentation inaccuracy**: the checklist and parameter log had described a configured battery failsafe when `COM_LOW_BAT_ACT` is 0.
- `docs/engineering/flight-modes.md` (Rev 1.8 -> 1.9, header updated): Section 5 now shows the low-battery row (warning only). `docs/operations/Pixhawk Parameter Backup/parameter-change-log.md`: added a `COM_LOW_BAT_ACT` row and clarified the battery thresholds only warn.
- `docs/engineering/ICD.md`: battery charge target now 4.10 to 4.15 V per cell. `docs/engineering/test-reports/2026-09-15-mn3110-thrust-stand-characterisation.md` and `2026-09-26-custom-li-ion-battery.md`: recorded the 3.8 kg all-up weight, the thrust-to-weight ratio, and the charger limit. `context/project-overview.md`, `context/project-notes.md`: updated.

## 2026-09-26 (continued x3)

Julian confirmed the custom Li-ion battery has no BMS and supplied per-group internal resistances (charger photo).

- Added `docs/engineering/test-reports/2026-09-26-custom-li-ion-battery.md` (pack configuration, cell datasheet reference, internal resistance, findings, limitations) and moved the charger photo to `docs/assets/custom-li-ion-charger-cell-resistance.png`.
- Added `Component datasheets/panasonic-ncr20700a-cell-datasheet.pdf` (Panasonic NCR20700A cell datasheet, obtained from a distributor-hosted copy); the cells are installed in the aircraft, per the datasheet-folder convention.
- `docs/engineering/ICD.md` (Rev 2.6 -> 2.7, header updated): battery rows now record no BMS, the 4.10 V per cell charge target, and the 21.0 mOhm measured internal resistance. `docs/project/build-checklist.md`: battery Completed Work entry updated. `context/project-overview.md`: battery row and open-items summary updated.
- `context/open-items.md`: replaced the battery items with four (unrecorded pack details; cell group 2 resistance outlier; no BMS and undecided in-flight voltage limit; PX4 battery parameters, now noting the 4.10 V charge target and that `BAT1_R_INTERNAL` is per cell). `context/project-notes.md`: dated provenance entry.

## 2026-09-26 (continued x2)

- `docs/engineering/test-reports/2026-09-15-mn3110-thrust-stand-characterisation.md`: replaced the imprecise supply-voltage row (it quoted a resting voltage as a loaded one) with a per-run table of resting and loaded voltages, quantified the voltage difference between the 11x7" and 12x6" runs (about 0.3 to 0.7V higher loaded voltage for the 12x6", which by a first-order estimate explains roughly 3 to 6% of the 9 to 12% current gap, not the whole of it), and marked the supply source (battery or bench supply) as TBD. `context/open-items.md`: added the supply source to the unrecorded stand details.

## 2026-09-26 (continued)

Julian reported closures, a new flight battery, and thrust-stand results. Verified the stand data against the raw CSV logs (not just the plots) before writing it up.

- `docs/project/build-checklist.md`: closed **AF-01** (CG - fixed by the custom 6S4P Li-ion battery, no ballast; no numeric CG/mass recorded), **AF-02** (battery retention - strap plus underside velcro), **AF-06** (hinges - reinforced with cloth tape, *not* replaced as scoped) and **AF-08** (motor mounts - adjusted 3D-printed boards plus blue Loctite, no polyurethane glue needed), all per Julian; each moved to Completed Work with the actual method recorded. Removed them from the dashboard (Critical blockers now PROP-08, CTL-04, CTL-08). Added a battery-retention row to Recurring Airworthiness Verification (per AF-02's own criterion) and a Completed Work entry for the custom Li-ion battery (capacity test pending). Updated PROP-08 (revised ~1700us ceiling for the 12x6", pending export; `COM_DISARM_LAND` = -1 noted), moved PROP-10 to **For review** (thrust measured; thrust-to-weight ratio needs all-up weight and a target), and added notes to PROP-05 and CTL-09.
- Added `docs/engineering/test-reports/2026-09-15-mn3110-thrust-stand-characterisation.md` (MN3110 KV700 on an RCbenchmark 1520 stand, APC 11x7" and 12x6"), and moved the four comparison graphs from the repo root to `docs/assets/mn3110-thrust-vs-esc-signal.png`, `mn3110-current-vs-esc-signal.png`, `mn3110-thrust-vs-current.png`, and `mn3110-efficiency-vs-esc-signal.png`. Raw CSV logs remain in Julian's MATLAB folder, outside the repo.
- `docs/engineering/ICD.md` (Rev 2.5 -> 2.6): battery row updated for the custom Li-ion pack, capacity TBD. **Corrected the document header**, which still read Revision 2.4 / 2026-09-02 (not bumped when Rev 2.5 was added).
- `docs/engineering/flight-modes.md` (Rev 1.7 -> 1.8): Section 6 open items updated (removed the resolved CG item and the stale PROP-02/PROP-06 item, added PROP-08). **Corrected the document header**, which still read Revision 1.6.
- `docs/operations/manual.md`: pre-flight step 11 now reflects the retention strap and underside velcro.
- `docs/operations/Pixhawk Parameter Backup/parameter-change-log.md`: `BAT1_N_CELLS` note updated for the Li-ion pack, noting the battery-estimation parameters are still LiPo-style defaults; corrected a stale line calling NAV-05 GPS lock outstanding (closed 2026-09-02).
- `context/project-overview.md`: battery row updated and the open-items summary rewritten (it still listed static thrust and throttle mapping as blockers).
- `context/project-notes.md`, `context/open-items.md`: recorded the closures with the evidence each rests on, and added open items for the battery (capacity test, mass, all-up weight, cell datasheet, purchase record, Turnigy status), the LiPo-style PX4 battery parameters, the 12x6" propeller (purchase/installation, and **ground clearance - a 12" prop has a 152.4mm radius against the 150mm shaft-to-ground clearance recorded at the 2026-07-05 BNEMAC review**), the ~1700us PWM ceiling pending export, and unrecorded stand details.

## 2026-09-26

- `context/open-items.md`: removed the unexplained 2026-09-02 flight-controller reboot item, closed per Julian as a non-recurring one-off. Cause remains undetermined from the logs - recorded as closed on Julian's judgment, not as "the reboot was the landing disarm", since the boot clock shows they were separate events. Updated the `COM_DISARM_LAND` item: Julian reports it set to -1 for bench testing (previously 2.0s), pending a parameter export to verify; the restore-before-flight-clearance requirement is unchanged.
- `docs/engineering/test-reports/2026-09-02-bench-thrust-test-review.md`: updated the Outstanding section to match.
- `context/project-notes.md`: added a dated provenance entry for the closure and the `COM_DISARM_LAND` change.

## 2026-09-02 (continued x16)

Consolidated `docs/engineering/test-reports/2026-09-02-thrust-test-motor-cutout-investigation.md` and `2026-09-02-ross-dennington-review.md` into a single `2026-09-02-bench-thrust-test-review.md`, per Julian - both covered the same session. Updated the live references in `context/project-notes.md` and `context/open-items.md`; earlier changelog entries above are left referencing the filenames that were current at the time, per this log's own history-is-not-rewritten convention.

## 2026-09-02 (continued x15)

Renamed `docs/engineering/test-reports/2026-09-02-ross-dennington-throttle-thrust-review.md` to `2026-09-02-ross-dennington-review.md` and expanded it to cover the full 2026-09-02 review, not just throttle/thrust - added findings for the CG/weight concern (AF-01), motor-mount wobble opinion (AF-08), tri-rates/expo and the Acro finding (CTL-04), and the launch-mechanism discussion. Updated the two references to the old filename in `context/CHANGELOG.md` and `context/project-notes.md`.

## 2026-09-02 (continued x14)

- `docs/project/build-checklist.md` CTL-04, `context/project-notes.md`: closed the Acro tri-rate finding - Julian confirmed tri-rate works correctly in Manual mode, supporting the CTL-08 closed-loop-saturation bench artefact explanation over a configuration fault. Not confirmed in real flight, but no further bench investigation needed.

## 2026-09-02 (continued x13)

Further notes from the same day's Ross Dennington (BNEMAC) review:

- `docs/project/build-checklist.md` AF-01: recorded Ross's concern that adding ~350g of nose ballast to fix CG works against the airframe's already-marginal thrust relative to its 5.5kg MTOW - flagged as a consideration (mass relocation vs. ballast), not decided.
- `docs/project/build-checklist.md` AF-08: recorded Ross's opinion that the motor-mount wobble isn't concerning given no pull-out risk, and should reduce once loaded in flight - reassuring, doesn't change the task's scope or status.
- `docs/project/build-checklist.md` CTL-04: closed the "review with Ross" acceptance criterion (rates/expo reviewed, satisfied) - CTL-04 remains open regardless (FW_MAN_R_SC pending CTL-08, switch diagrams). Added a new finding: the tri-rate switch doesn't appear to work correctly in Acro mode (behaves like dual-rate) - not yet root-caused, possibly related to CTL-08's Acro-saturation finding; Julian to investigate.
- `context/project-notes.md`: recorded the launch-mechanism discussion (hill launch and catapult raised as options; hand launch confirmed for the maiden flight, unchanged from existing docs) as provenance only, no document changes needed.

## 2026-09-02 (continued x12)

- Added `docs/engineering/test-reports/2026-09-02-ross-dennington-review.md` (renamed from `...-throttle-thrust-review.md` and expanded, see below) documenting Ross Dennington's (BNEMAC) review of throttle mapping and static thrust during the day's bench session.
- `docs/project/build-checklist.md`: **PROP-06 closed** (throttle mapping reviewed by Ross, no remapping needed). **PROP-02 closed** on Ross's qualitative thrust assessment, per Julian's explicit instruction to reduce the original acceptance criteria (measured thrust-to-weight ratio, sustained-run current/temperature check) - recorded precisely which evidence it was actually closed on. Added **PROP-10** (Non-critical) to track the deferred quantitative motor-rig thrust measurement separately, so it isn't lost. Both PROP-02/PROP-06 moved to Completed Work; readiness table and dependency annotations updated.
- **CTL-04 not closed**, despite being raised as a candidate: the Ross meeting covered throttle mapping and thrust, not CTL-04's own "max deflection, rates, and expo" review criterion, and two other criteria (FW_MAN_R_SC revalidation pending CTL-08, switch-diagram relabelling) remain open. Flagged to Julian rather than silently closed.
- `context/project-notes.md`, `context/open-items.md`: recorded the closures and the CTL-04 flag; removed the now-resolved PROP-02/PROP-06 open item.

## 2026-09-02 (continued x11)

Verified a fresh parameter export (`params_update.params`, dropped in the repo root by Julian) against the previous archived export before documenting anything as done.

- `RC_MAP_FLAPS`/`RC_MAP_OFFB_SW` both confirmed cleared to 0 (unassigned) - resolves the SB/SE dual-purpose overlap. Updated `docs/engineering/ICD.md` (Rev 2.4 -> 2.5), `docs/engineering/flight-modes.md` (Rev 1.6 -> 1.7), `docs/operations/manual.md`, `docs/operations/Pixhawk Parameter Backup/parameter-change-log.md`; closed the corresponding CTL-04 acceptance criterion and removed the resolved open item.
- `PWM_MAIN_MAX4`/`MAX6` confirmed lowered from 2000 to 1800 (PROP-08's throttle ceiling, per the earlier PWM-vs-current finding). Updated ICD.md's actuator table and PROP-08's scope; moved PROP-08 to **For review** - applied, but not yet confirmed via a dedicated sustained-run test.
- Replaced the archived parameter export at `docs/operations/Pixhawk Parameter Backup/believer-parameters.params` with the fresh one; removed the root-dropped copy.
- `context/project-notes.md`, `context/open-items.md`: recorded the verification and updated the switch-diagram open item to reflect SB/SE's function relabelling (Flaperon/Offboard -> aileron/elevator rate switch).

## 2026-09-02 (continued x10)

- `docs/project/build-checklist.md` PROP-08, `context/project-notes.md`: logged a PWM-vs-current data point from the day's thrust-test logs - ~42A total current draw (~21A/motor, the MN3110 KV700's rated continuous current) occurs at approximately 1800-1809us PWM on both motor channels, per correlating `actuator_outputs` against `battery_status.current_a`. Flagged as a candidate throttle-ceiling starting point for PROP-08, not yet confirmed via a dedicated sustained-run test.

## 2026-09-02 (continued x9)

- `docs/project/build-checklist.md`: removed PROP-09, per Julian - simplified to a lighter open item rather than a dedicated checklist task. Updated PROP-02's background note accordingly.
- `context/open-items.md`, `context/project-notes.md`, `docs/engineering/test-reports/2026-09-02-thrust-test-motor-cutout-investigation.md`: replaced the PROP-09 references with the flag: for future bench tests, raise or disable `COM_DISARM_LAND` for the duration of testing, then confirm it's restored to its flight-intended value before flight clearance.

## 2026-09-02 (continued x8)

Investigated two unexplained full-throttle motor cutouts from that day's bench thrust-test session with Ross Dennington, by pulling and analysing the flight controller's `.ulg` logs directly (`pyulog`). Root-caused to PX4's fixed-wing landing detector falsely declaring "landed" on the stationary bench and auto-disarming via `COM_DISARM_LAND` (2.0s) - not a brownout, reboot, or power/ESC fault; both cutout events showed nominal battery/5V-rail voltage and a continuous boot clock throughout. A separate, unrelated flight-controller reboot was also found (cause undetermined) in a gap between two earlier sessions that day, with no anomaly in the preceding session's own data.

- Added `docs/engineering/test-reports/2026-09-02-thrust-test-motor-cutout-investigation.md` with the full findings.
- `docs/project/build-checklist.md`: added background to PROP-02 noting the interference; added **PROP-09** (Urgent/ground-test-readiness) to resolve the false auto-disarm before further sustained full-throttle bench testing, with a safeguard to restore flight-intended parameters afterward.
- `context/project-notes.md`, `context/open-items.md`: recorded the investigation and flagged the standalone reboot as unexplained, to watch for recurrence.

## 2026-09-02 (continued x7)

- `docs/project/build-checklist.md`: CTL-08 elevated from Urgent to Critical/flight-clearance-blocking, per Julian - resolves the transitive-blocking gap flagged against CTL-04's dependency on it. Added to the Current Flight-Readiness Status table.

## 2026-09-02 (continued x6)

- `docs/project/build-checklist.md`: added a **For review** status (work done, pending formal confirmation against acceptance criteria before Complete) to the Status definitions, alongside Not started/In progress/Complete. Set CTL-08 to For review, per Julian - the informal bench finding stands, formal logged-table confirmation is the only thing outstanding.

## 2026-09-02 (continued x5)

- `docs/project/build-checklist.md`: CTL-04 (tri-rate switch-selectable deflection) elevated from Non-critical to Critical/flight-clearance-blocking, per Julian; added to the Current Flight-Readiness Status table. Flagged that CTL-04 still formally depends on CTL-08, which remains Priority: URGENT - not yet reconciled, surfaced for Julian's call rather than silently bumping CTL-08 too.

## 2026-09-02 (continued x4)

- `docs/project/build-checklist.md`: AF-06 (control surface hinges) elevated from Non-critical to Critical/flight-clearance-blocking, per Julian; added to the Current Flight-Readiness Status table with an acceptance criterion. Added **PROP-08** (Critical/ground-test-readiness-blocking): configure the propulsion system so sustained current draw stays within the MN3110 KV700's 21A continuous rating, following the 2026-08-31 overcurrent finding (~30-32.5A/motor at full throttle, logged under PROP-02) - PROP-02 measures/records, PROP-08 is the action item to actually fix it.
- `context/project-notes.md`, `context/open-items.md`: recorded that Julian has begun clearing the SB/SE dual-purpose overlap (CTL-04) by unmapping `RC_MAP_OFFB_SW`/`RC_MAP_FLAPS` from CH9/CH11 in PX4 - `RC_MAP_OFFB_SW` reportedly cleared already, `RC_MAP_FLAPS` still pending. Not yet reflected in ICD.md/parameter-change-log.md - a fresh parameter export is needed to verify both values before documenting them as done, per the CH9/CH11 verification lesson logged above.

## 2026-09-02 (continued x3)

Verified Julian's radio backup upload against the previous archived copy before replacing it, per his instruction. Diffing `model00.yml` showed CH9/CH11's `mixData` routing is byte-for-byte unchanged from before - the "(continued x2)" entry below, written from Julian's verbal description alone, incorrectly documented this as CH9/CH11 being reassigned. Corrected across all affected docs before committing (nothing below had been pushed yet):

- `docs/operations/manual.md`, `docs/engineering/ICD.md`, `docs/engineering/flight-modes.md`, `docs/project/build-checklist.md`, `context/project-notes.md`, `context/open-items.md`: replaced the "CH9/CH11 reassigned, Offboard no longer reachable" framing with the verified "dual-purpose switch" framing - SB/SE still drive CH9 (Flaperon)/CH11 (Offboard) exactly as before via unchanged `mixData`, and separately now also select the aileron/elevator rate curve locally via a new EdgeTX `expoData` feature. Flagged the resulting overlap as an active, unresolved concern: `RC_MAP_OFFB_SW` is still live on channel 11, so changing elevator rate in flight also moves CH11, risking an unintended offboard-loss failsafe trigger.
- Moved the verified radio backup into place: `docs/operations/GX12 Radio Backup/` replaced wholesale with the new upload.
- `docs/project/build-checklist.md` CTL-04: added acceptance criterion to review maximum deflection, rates, and expo with Ross Dennington (BNEMAC) before the values are treated as final, per Julian.
- Noted but not otherwise documented: the new backup also added an Arm timer, mode-announcement custom functions, and an expanded telemetry sensor/screen list - not core to CTL-04.
- Switch diagrams (`docs/assets/gx12-front-switches.png`/`gx12-top-switches.png`) reassessed: still accurate for CH9/CH11's actual (unchanged) channel functions, so no re-annotation needed for a reassignment that didn't happen - though a supplementary annotation noting the new SB/SE local rate-curve behaviour would help; still pending, Claude has no image-editing capability.

## 2026-09-02 (continued x2)

CTL-04 progressed by Julian: 30% expo confirmed on all flight surfaces; tri-rate (100/70/50%) configured on aileron (CH9/SB) and elevator (CH11/SE) channels, each locally switch-selected - superseding the originally-scoped simple aileron-only dual-rate plan.

- `docs/operations/manual.md`, `docs/engineering/ICD.md`, `docs/engineering/flight-modes.md`: updated RC channel tables/text to note SB/CH9 and SE/CH11 now also drive the aileron/elevator rate curves locally, alongside their existing (unchanged) Flaperon/Offboard channel outputs. ICD.md bumped to Rev 2.4, flight-modes.md to Rev 1.6. (Corrected - see "(continued x3)" above; an initial pass mischaracterized this as a channel reassignment.)
- `docs/project/build-checklist.md`: rewrote CTL-04 to match the actual implementation (tri-rate on two channels, each locally switch-selected) rather than the original simpler plan; flagged that this proceeded before CTL-08 (its dependency) formally concluded. Status set to In progress pending resolution of the SB/SE dual-purpose overlap.
- `context/project-notes.md`, `context/open-items.md`: recorded the implementation and the dual-purpose overlap needing resolution.

## 2026-09-02 (continued)

- `docs/project/build-checklist.md`: closed NAV-05 - Julian confirmed both GPS receivers achieve a lock under the new instance configuration; moved to Completed Work. Recorded the rationale for the GPS instance swap (QGroundControl's primary GPS status display reads driver instance 1 via `GPS_RAW_INT`; putting the RTK-capable ZED-F9P there ensures the GUI reflects the better receiver rather than under-reporting the M8N's lesser fix) in `docs/engineering/ICD.md` INT-05 (Rev 2.2 -> 2.3) and `context/project-notes.md`.
- **Reopened CTL-08** per Julian - the 2026-09-01 closure relied on a qualitative bench comparison ("seem to agree better"), not the formal logged test (propellers off, roll/pitch/yaw tested separately, stick%/PWM/deflection recorded at several points per axis) its acceptance criteria actually call for; Julian is running that test himself. Reverted the task back into Section D (was briefly in Completed Work), restored its dependency annotations on CTL-02/CTL-04/CTL-07, and reverted `docs/engineering/flight-modes.md` (Rev 1.4 -> 1.5) and `context/project-notes.md`'s "closed" framing accordingly - `docs/operations/manual.md`'s pre-flight checklist update (Manual-mode-specific proportionality check) was left as-is since it's good general guidance independent of CTL-08's status.
- `context/open-items.md`: re-added the CTL-08 formal-test item; narrowed the GPS item to what's still open (RTK correction source, `SENS_GPS_MASK` bit-semantics verification).

## 2026-09-02

Replaced `docs/operations/Pixhawk Parameter Backup/believer-parameters.params` with a fresh FC export (dropped in the repo root as `updated_params.params`), cross-checked by diff against the previous backup. Two changes were flagged and confirmed with Julian before documenting as intentional (see below); everything else matched decisions already made in this conversation.

- **CTL-06 closed** (`docs/project/build-checklist.md`): V-tail yaw effectiveness restored ±0.85→±0.50 (PX4 type default); PWM min/max endpoints for MAIN 1/2/3/5 confirmed independently remeasured as actual safe mechanical limits (not a provisional reset) - superseding the previous endpoint-based approximation of aileron differential; disarmed/trim PWM reset to plain 1500; aileron mixer trims rechecked and updated (0.05/-0.05, superseding the 2026-07-10 TMAC values). No software aileron differential in the baseline. Moved to Completed Work; updated CTL-02/CTL-07/PWR-03's dependency annotations accordingly.
- **CTL-10 closed**: airspeed envelope updated per Weishäupl et al. 2024 - `FW_AIRSPD_STALL` 7→11 m/s, `FW_AIRSPD_MIN` 10→15 m/s, `FW_AIRSPD_TRIM` 15→20 m/s, `FW_AIRSPD_MAX` 20→28 m/s (the last was outside CTL-10's originally stated scope but was updated anyway - documented as such). Removed from the Critical flight-readiness dashboard table and moved to Completed Work.
- **GPS driver instance/port swap - confirmed intentional by Julian** after being flagged as a likely mix-up: `GPS_1_CONFIG`/`GPS_2_CONFIG` changed such that PX4 GPS driver instance 1 now reads the physical GPS2 UART port (ZED-F9P), and instance 2 reads the physical GPS1 UART port (M8N) - physical wiring unchanged, only logical instance numbering swapped, deliberately making the RTK-capable receiver the primary-numbered instance. `docs/engineering/ICD.md` INT-05/INT-06 rewritten with an explicit instance-vs-port cross-reference to prevent future confusion, since "GPS 1"/"GPS 2" no longer maps to "M8N"/"ZED-F9P" the way it used to. `GPS_1_GNSS` (now 31) configures the ZED-F9P's constellation under the new numbering; `GPS_2_GNSS` (29, unchanged value) now applies to the M8N. GPS lock not yet reconfirmed under this configuration - `docs/project/build-checklist.md` NAV-05 updated accordingly, left In progress (not closed).
- `docs/engineering/ICD.md` (Rev 2.1 -> 2.2): rewrote INT-05/INT-06 for the GPS swap; updated the INT-02a-f actuator PWM table and Control Surface Mixing table with CTL-06's physically remeasured/rechecked values; corrected `GPS_UBX_DYNMODEL`'s placement (it's a global u-blox driver setting, not instance-2-specific).
- `docs/engineering/flight-modes.md` (Rev 1.3 -> 1.4): updated the Altitude-mode airspeed table (Section 4.4) with CTL-10's new values.
- `docs/operations/Pixhawk Parameter Backup/parameter-change-log.md`: updated GPS, Actuator Outputs, Control Surface Mixing, and calibration sections to match; export date updated to 2026-09-02.
- `docs/project/build-checklist.md`: also fixed a now-stale Completed Work bullet ("GPS 1 (M8N) configuration and validation") that referenced parameters now describing the ZED-F9P, not the M8N, after the instance renumbering.
- `context/project-notes.md`: added a new dated section recording all of the above, including the GPS instance/port decoupling explained in full since it's a genuine, easy-to-misread source of future confusion.
- `context/open-items.md`: removed items resolved by this update (actuator effectiveness reset, PWM endpoint remeasurement, fresh parameter export, `FW_AIRSPD_MAX` reconsideration); narrowed the GPS item to what's still actually open (RTK correction source, GPS lock reconfirmation, `SENS_GPS_MASK` bit semantics).

## 2026-09-01 (continued x3)

- `docs/project/build-checklist.md`: closed CTL-08 (full-Manual stick-to-surface scaling) per Julian - the Acro-vs-Manual bench comparison satisfies the task's own documented closing condition (early saturation confined to Acro/Stabilized, normal closed-loop behaviour, no `FW_MAN_*_SC` adjustment needed). `FW_MAN_R_SC`/`FW_MAN_P_SC`/`FW_MAN_Y_SC` confirmed and retained at 1.0. Moved from Section D into Completed Work; updated CTL-02/CTL-04/CTL-07's dependency annotations to reflect CTL-08 is complete (CTL-06 remains open, so those tasks stay blocked).
- `docs/operations/manual.md`: updated pre-flight checklist steps 22-23 per the review's planned follow-up now that CTL-08 is closed - the control-surface proportionality check is now specified as Manual-mode only, with an explicit note not to interpret Acro/Stabilized bench behaviour the same way; Stabilized-mode check reworded to expect direction-correctness rather than full independent travel, noting safe V-tail saturation under large combined pitch+yaw is not a fault.
- `docs/engineering/flight-modes.md` (Rev 1.2 -> 1.3): updated Section 4.1 to record CTL-08's closure and the confirmed 1.0 values, explaining the integral-windup mechanism behind the Acro-mode bench artefact.
- `context/project-notes.md`, `context/open-items.md`: recorded the closure; removed the resolved open item.

## 2026-09-01 (continued x2)

- `docs/project/build-checklist.md`: added an informal finding to CTL-08 - the early control-surface saturation has been narrowed to Acro mode specifically; Manual mode "agrees better" (Julian). Consistent with the review's hypothesis that Acro's rate controller saturates on a stationary bench with no real rate to null against. Not yet the formal recorded Manual-mode test the task's acceptance criteria require, so status/dependencies unchanged.
- `context/project-notes.md`, `context/open-items.md`: recorded the same finding.

## 2026-09-01 (continued)

- `docs/project/build-checklist.md`: closed AF-03 (motor/ESC inspection-bay cover bolts - rounded bolts replaced) per Julian - moved from Section A into Completed Work.

## 2026-09-01

Repository updated from a flight-control configuration review Julian conducted in a separate session (summary brief supplied 2026-09-01, review dated 2026-08-31). Core finding: the PX4 Actuators page's Roll/Pitch/Yaw Torque fields are actuator-effectiveness coefficients for the control allocator, not transmitter mixer percentages - this reframes several 2026-08-19 decisions made under the earlier (incorrect) assumption. Per the review's explicit guidance, only documents describing current decisions/dependencies/open items were updated now; `docs/engineering/ICD.md`, the parameter-change-log, and the `.params` backup still correctly describe the as-found state and are deliberately left untouched until the physical configuration is actually changed and verified on the aircraft.

- `docs/project/build-checklist.md`: rewrote CTL-06 (was "Configure aileron differential across full travel range", now "Restore and verify control-surface actuator configuration" - restore V-tail yaw effectiveness from ±0.85 to the PX4 default ±0.50, retain established aileron trims, independently remeasure safe PWM endpoints per servo rather than using them to approximate differential; status In progress). Rewrote CTL-07 (was a fixed "10% aileron-to-rudder mixing" requirement, now "Evaluate adverse yaw and roll-to-yaw feedforward" - no fixed mix, `FW_RLL_TO_YAW_FF` stays 0.0 pending flight-test evidence of adverse yaw; depends on CTL-06/CTL-08, deferred). Rewrote CTL-08 (was "Investigate control surface deflection reaching limits...", now "Verify and correct full-Manual stick-to-surface scaling" - narrows the observation to full Manual mode specifically, since Acro/Stabilized can legitimately saturate a surface on a stationary bench before full stick; depends on CTL-06, status In progress). Added CTL-06/CTL-08 dependencies to CTL-02 (gain tuning must not compensate for an unresolved actuator baseline) and CTL-04 (transmitter rates must be revalidated after CTL-08's final `FW_MAN_R_SC`). Added a CTL-06 dependency to PWR-03 (servo load test must use final, not superseded, endpoints). Corrected the "Control surface deflection limits and expo" Completed Work entry, which had overstated radio calibration and aileron differential/V-tail rudder mix as finalised - narrowed to only the facts that remain confirmed (expo, aileron trim). No task priorities were changed (CTL-06/08 remain Urgent, CTL-07 remains Non-critical) and none were added to the Critical flight-readiness dashboard - the review did not make a governance decision to reclassify them.
- `context/project-notes.md`: corrected an ordering error from an earlier session (the "Airframe Aerodynamic Characterisation - Weishäupl et al. 2024" section, dated 2026-08-31, had been inserted before the chronologically earlier "Propulsion Install..." section, dated 2026-08-19 - moved to its correct chronological position). Added a new "Control Allocation and Control-Surface Configuration Review - 2026-08-31" section recording the actuator-effectiveness reframing, the decisions to reset V-tail yaw effectiveness, defer aileron differential and roll-to-yaw feedforward pending flight evidence, and the CTL-06/07/08/02/04/PWR-03 dependency architecture this establishes. The earlier 2026-07-10 TMAC and 2026-08-19 entries were preserved unchanged as historical fact, not rewritten.
- `context/open-items.md`: added items for the still-unapplied CTL-06 actuator reset, unmeasured final PWM endpoints, the not-yet-reproduced-in-Manual-mode saturation observation, the undetermined final `FW_MAN_*_SC` values, the pending fresh parameter export once CTL-06/08 are physically complete, and the deferred aileron-differential/`FW_RLL_TO_YAW_FF` decision pending flight evidence.
- `docs/engineering/flight-modes.md` (Rev 1.1 -> 1.2): clarified `FW_MAN_*_SC` apply specifically to full Manual mode and warned against reading Acro/Stabilized bench saturation as evidence about them (Section 4.1); documented `FW_RLL_TO_YAW_FF`'s current 0.0 baseline and purpose without presenting a future value as decided; flagged the V-tail ±0.85 yaw mixing gain as targeted for restoration to ±0.50, noting the live value is unchanged pending CTL-06 (Section 4.3).

## 2026-08-31 (continued)

- Added `docs/engineering/references/` and moved in Weishäupl, McLay & Sóbester, "Experimental evaluation of the drag curves of small fixed wing UAVs" (*The Aeronautical Journal*, 2024), dropped in the repo root by Julian. The paper's "FliTePlat" test platform is explicitly built on the MakeFlyEasy airframe (same manufacturer as the Believer) and its geometry/performance table matches the Believer's manufacturer specs closely (wingspan, length, MTOW, and cruise speed all exact or near-exact matches) - very likely the same commercial airframe or an extremely close sibling. The paper does not name the motor manufacturer/model/KV anywhere. Extracted its wind-tunnel-measured drag polar (CD0=0.0503, K=0.0764, CL0=0.2570, CLα=0.1122/deg) and other facts (measured 1g stall speed 11 m/s, VNE 37 m/s, load factor limits 0.2-3.8g) into `context/project-notes.md`.
- `docs/project/build-checklist.md`: added CTL-10 (Critical) - set `FW_AIRSPD_STALL` to 11 m/s per the paper's measured value, and raise `FW_AIRSPD_MIN` (currently 10 m/s, below the newly-informed stall speed - a genuine safety gap in automatic flight modes, not just a documentation issue) to a value with real margin above stall. Cross-referenced the paper's drag polar into PROP-05's scope as a stronger alternative/supplement to the generic Eppler 374 MotoCalc approach.
- `context/open-items.md`: added the `FW_AIRSPD_MAX`/broader TECS reconsideration (lower priority, tracked separately from the CTL-10 safety fix) and whether to adopt the paper's drag polar more broadly for performance estimation.

## 2026-08-31

- `docs/project/build-checklist.md`: added a sustained full-throttle current/temperature monitoring acceptance criterion to PROP-02, per a finding from Julian's brief (<20s) full-throttle bench test (2026-08-31) - the PDB reported 60-65A total current draw (~30-32.5A per motor), roughly 45-55% above the MN3110 KV700's rated 21A continuous current, though well within the AIR 40A ESC and battery's capability. Not a concern for a brief burst, but sustained-duration thermal safety is unverified - PROP-02 should not be considered conclusive on this point until a longer run is tested.
- `context/project-notes.md`: recorded the current-draw finding.

## 2026-08-28 (continued x4)

- `docs/project/build-checklist.md`: added PROP-07 (measure the wing's real airfoil for accurate MotoCalc characterisation - LE/TE height, chord, upper/lower surface height and chord-line height at the thickest point) per Julian, non-critical - supersedes the generic Eppler 374 stand-in currently used for PROP-05 once done. Reference screenshot of MotoCalc's measurement dialog is pending being added to `docs/assets/` - Claude cannot extract images pasted directly in chat, so the file needs to be dropped into the repo the same way other attachments have been.

## 2026-08-28 (continued x3)

- `docs/engineering/ICD.md` (Rev 2.0 -> 2.1) and `context/project-notes.md`: corrected `GPS_1_GNSS` from the documented 21 to the actual live value, 0 (Default) - caught while reviewing GPS parameter recommendations with Julian; the M8N has a confirmed working GPS lock at 0, so the documentation was stale rather than the live configuration being wrong.

## 2026-08-28 (continued x2)

- Researched PX4's dual-GPS handling per Julian's question about making the ZED-F9P the "primary" GPS - this PX4 version (1.16.1rc) has no simple primary-GPS toggle; instead `SENS_GPS_MASK` (currently 7 in the exported parameters) either blends both receivers by reported accuracy or locks onto one exclusively. Julian chose blending (recommended) - the ZED-F9P is expected to dominate the blend once enabled, especially with RTK corrections, while the M8N remains an automatic fallback if it drops out.
- `docs/engineering/ICD.md` (Rev 1.9 -> 2.0): updated INT-06 - recorded the ZED-F9P mount/antenna installation, removed the stale "antenna not fitted, maiden flight blocker" note, and documented the GPS blending decision pending NAV-05 confirming `SENS_GPS_MASK`'s exact bit semantics for this firmware version.
- `docs/project/build-checklist.md`: added the `SENS_GPS_MASK` blending confirmation to NAV-05's scope.
- `context/project-notes.md`, `context/open-items.md`: recorded the blending decision and the open item to verify `SENS_GPS_MASK`'s bit semantics before relying on it.

## 2026-08-28 (continued)

- `docs/project/build-checklist.md`: restructured per Julian - completed tasks (PROP-01/03/04, PWR-01, CTL-01/03/05, NAV-03/04, RF-01/03/04) removed from their active work-package sections now that they're migrated into Completed Work, rather than existing in both places; "Depends on" references to now-completed tasks annotated "(complete - see Completed Work)" for traceability. Detailed provenance for the removed entries remains in `context/project-notes.md` and this changelog, consistent with how `docs/engineering/ICD.md` and `context/project-notes.md` already divide current-state vs. provenance content.
- `docs/project/build-checklist.md`: added new tasks per Julian - AF-08 (secure motor mounting plates with polyurethane/tack glue, Critical, must be complete before maiden flight - added to the Current Flight-Readiness Status table); CTL-06 (configure aileron differential across the full travel range, not just PWM endpoints - corrects the earlier Completed Work claim that differential was fully adjusted, which only covered the endpoints); CTL-07 (10% aileron-to-rudder mixing); CTL-08 (investigate control surfaces reaching max deflection before full radio stick travel, possibly a radio calibration issue); CTL-09 (update `WEIGHT_BASE` PX4 parameter - exact role/target value not yet confirmed against PX4 documentation, flagged for verification). Added detail to CTL-04 (dual/tri-rate switch): low-rate position is 50% aileron rate, elevator/rudder unchanged. Updated PROP-05's scope to use a generic Eppler 374 (E374) aerofoil in the MotoCalc model, per Julian's guidance (recorded as "EPLA 374" - understood as Eppler 374, flagged for confirmation if a different aerofoil was meant).
- Verified `docs/operations/manual.md`'s pre-flight checklist already includes a step (15) to update `SENS_BARO_QNH` to the current ambient barometric pressure reading - no change needed, per Julian's request to confirm this step exists.

## 2026-08-28

- `docs/project/build-checklist.md`: closed NAV-03 (external mount for ZED-F9P) and NAV-04 (GPS 2 antenna installation), both completed 2026-08-28 per Julian - moved into Completed Work. Also caught CTL-05 (clean-install procedure), which had been marked Complete since 2026-08-19 but was never added to the Completed Work summary - added it now. RTK capability remains unavailable pending NAV-05 (protocol/GNSS configuration and GPS lock confirmation), which is unaffected by this update.
- `context/project-notes.md`, `context/project-overview.md`: updated the ZED-F9P GPS_2 status to reflect the mount and antenna are now installed, replacing the stale "no antenna installed - must be fixed before maiden flight" note; RTK correction source and GPS_2_CONFIG re-enablement remain open under NAV-05.

## 2026-08-26 (continued x5)

- `docs/engineering/requirements/custom-airframe-requirements.md` (Rev 1.2 -> 1.3): ran the design cruise speed trade study, per Julian's request. Added Section 3e, benchmarking against comparable mission-class survey/mapping UAS - Quantum Systems Trinity F90+ (5.0kg/2.394m, 17 m/s optimal cruise, 12 m/s in-cruise wind tolerance - closest match to this project's mass/wingspan targets), WingtraOne (16 m/s operational cruise), and senseFly eBee X - rather than the Believer, per the Rev 1.2 methodology correction. Cross-checked against a motion-blur/GSD calculation using the IMX335 as an illustrative sensor stand-in (actual payload camera still unselected), confirming 16 m/s is not motion-blur-limited at the 60-100m operating altitude band for any reasonable daylight shutter speed. Resolved REQ-AF-73 to a provisional 16 m/s design cruise speed and REQ-AF-75 to a provisional 25 m/s top speed target; both flagged for final validation once the payload camera is chosen and site-specific wind data is gathered.

## 2026-08-26 (continued x4)

- Moved and renamed four invoices dropped in the repo root into `docs/project/purchase-history/invoices/`: SparkFun ZED-F9P (Order #000243169, 2026-03-09), HobbyKing Turnigy Graphene 8000mAh battery (Order #103088165, 2026-03-10), Core Electronics IMX335 camera (Order #1000666876, 2026-03-10), and Holybro PM06 V2 power module (Order #15996, 2026-03-10).
- `docs/project/purchase-history/purchase-history.md`: replaced four previous shopping-list estimates with confirmed invoice figures now that the actual invoices were located - Turnigy battery ($152.85 est. -> $129.67 confirmed AUD), SparkFun ZED-F9P ($272.95 est. -> ~$467 AUD, converted from a USD invoice), Core Electronics IMX335 camera ($63.68 est. -> $74.01 confirmed AUD), and Holybro PM06 ($22.04 est. -> ~$82 AUD, converted from a USD invoice). The two USD invoices (SparkFun, PM06) were converted using an approximate 1.44 AUD/USD rate for early March 2026 - web research could not confirm the precise daily or card-charged rate, flagged in `context/open-items.md`. Net effect: University total revised from ~$981.08 AUD to ~$1,222.98 AUD, remaining approved-budget margin down from ~$397.92 AUD to ~$156.02 AUD. All-parties total updated to ~$1,475.31 AUD.
- `context/open-items.md`: added the AUD conversion precision item for the two USD invoices.

## 2026-08-26 (continued x3)

- `docs/engineering/requirements/custom-airframe-requirements.md` (Rev 1.1 -> 1.2): corrected methodology per Julian - requirements shall be derived primarily from mission need, not the current Believer airframe's specifications. REQ-AF-73/75 no longer use the Believer's 15/20 m/s figures as targets; both now call for a mission-based trade study (endurance, area-coverage rate, sensor motion-blur tolerance, regional wind conditions) that hasn't been run yet, with the Believer's figures demoted to non-authoritative context in Section 3d. Added a design-philosophy statement to Section 2, and the specific missing mission inputs to Section 5. Audited the rest of the document against this principle - other requirements were found to already be either genuinely mission/user-derived (mass, wingspan, mission time, landing gear, payload) or, for CG (REQ-AF-43/44), not mission-derivable at all and already properly caveated as provisional reference data pending real analysis - no further changes needed there.

## 2026-08-26 (continued x2)

- `docs/engineering/requirements/custom-airframe-requirements.md` (Rev 1.0 -> 1.1): split airspeed into two distinct requirements per Julian - REQ-AF-73 is now a single-point design cruise speed (15 m/s, the current Believer's actual as-flown trim) to optimise the wing/propulsion system's efficiency around, rather than a range; new REQ-AF-75 sets a top-speed target (20 m/s), referenced against the current airframe's `FW_AIRSPD_MAX` and the original manufacturer's recommended cruise speed - both landing independently on the same figure. Added Section 3d recording this airspeed reference data.

## 2026-08-26 (continued)

- `docs/engineering/requirements/custom-airframe-requirements.md` (Rev 0.9 -> 1.0): added Section 3c researching operating altitude, per Julian's request - confirmed CASA's 120m AGL standard operating ceiling (CASR Part 101) via casa.gov.au, and researched mission-informed typical altitude: the Westpac Little Ripper/SharkSpotter shark-spotting program flies at ~60m AGL; published UAV remote-sensing studies found the clearest vegetation/soil spectral separation at 60m AGL (degrading by 80-100m) while LAI/NDVI correlation peaks at 80-100m AGL; precision-agriculture row-crop surveys typically fly 80-120m AGL. Added REQ-AF-74 (typical mission operating altitude, 60-100m AGL) and strengthened REQ-AF-72's regulatory citation; resolved the mission-specific-altitude open item on this basis.

## 2026-08-26

- `docs/engineering/requirements/custom-airframe-requirements.md` (Rev 0.8 -> 0.9): added REQ-AF-72 (max operating altitude, 120m AGL, referenced against the project's existing `GF_MAX_VER_DIST` geofence ceiling) and REQ-AF-73 (cruise airspeed target, 15-20 m/s, referenced against the current Believer's `FW_AIRSPD_TRIM` and the original manufacturer's recommended cruise speed) per Julian. Flagged mission-specific operating altitude (e.g. shark spotting likely needs a lower observation altitude than the 120m regulatory ceiling) and the full stall/max airspeed envelope as open items pending the new wing's aerodynamic design.

## 2026-08-20 (continued x8)

- `docs/engineering/requirements/custom-airframe-requirements.md` (Rev 0.7 -> 0.8): corrected REQ-AF-43/44 per Julian - the 25-30% MAC CG target and ±5% MAC adjustment travel assumed a conventional tailed configuration and don't transfer to a flying wing, which has no tail moment arm and typically needs a much narrower CG band plus finer adjustment resolution. Both requirements now derive the CG range and adjustment travel from a stability analysis matched to whichever tail configuration is chosen, keeping the conventional-tail figures only as a provisional reference point.

## 2026-08-20 (continued x7)

- `docs/engineering/requirements/custom-airframe-requirements.md` (Rev 0.6 -> 0.7): added REQ-AF-43 (CG target, 25-30% MAC - a provisional figure carried over from the current Believer's known-stable operating point, to be validated via a stability/tail-volume analysis once the new wing/tail are designed) and REQ-AF-44 (battery slide adjustment travel, at least ±5% MAC), per Julian - intended to avoid repeating the current airframe's need for ~350g of supplementary ballast.

## 2026-08-20 (continued x6)

- `docs/engineering/requirements/custom-airframe-requirements.md` (Rev 0.5 -> 0.6): added REQ-AF-62 per Julian - the gimbal camera pod mount shall incorporate impact protection against hard-landing/belly-strike damage, given it's expected to be the airframe's highest-value single component.

## 2026-08-20 (continued x5)

- `docs/engineering/requirements/custom-airframe-requirements.md` (Rev 0.4 -> 0.5): added REQ-AF-27 per Julian - the flight controller shall be mounted on vibration-damping isolation to attenuate motor/propulsion vibration and protect IMU sensor data quality. This had been flagged as a suggested addition in earlier review but not yet incorporated.

## 2026-08-20 (continued x4)

- `docs/engineering/requirements/custom-airframe-requirements.md` (Rev 0.3 -> 0.4): corrected REQ-AF-52 per Julian - hand-launch is not a requirement for this airframe; the catapult launch interface now sits alongside grass-runway takeoff (REQ-AF-50) only.

## 2026-08-20 (continued x3)

- `docs/engineering/requirements/custom-airframe-requirements.md` (Rev 0.2 -> 0.3): renamed Section 4.6 to "Launch, Landing Gear and Ground Operations" and added REQ-AF-52, a desirable structural interface for a catapult launch system, per Julian - additional departure method alongside grass-runway takeoff and hand-launch; catapult system type, hard-point location, load rating, and release mechanism are all open.
- `context/open-items.md`: added the catapult launch interface open items to the custom airframe entry.

## 2026-08-20 (continued x2)

- `docs/engineering/requirements/custom-airframe-requirements.md`: corrected the launch dolly relationship per Julian - the new airframe's landing gear (REQ-AF-50) **will** make the launch dolly obsolete once built, not a neutral "separate future decision" as Rev 0.2 had it.
- `docs/engineering/requirements/launch-dolly-requirements.md` (Rev 0.2 -> 0.3): added a note (Section 1) that this is an interim solution for the current Believer airframe, expected to be made obsolete by the new custom airframe's landing gear once built.
- `docs/project/project-roadmap.md`: updated the launch dolly roadmap entry to note it's an interim measure expected to be superseded by the custom airframe.

## 2026-08-20 (continued)

- `docs/engineering/requirements/custom-airframe-requirements.md` (Rev 0.1 -> 0.2): resolved Julian's review feedback on the initial draft - softened the connector-standard requirement (REQ-AF-24) to note it's primarily an avionics-subsystem concern; added a signal-loom organisation/traceability requirement (REQ-AF-26); researched RF/EMI separation against PX4 and ArduPilot's official documentation (Section 3b) - found neither specifies a fixed numeric minimum, only qualitative "maximum practical separation" guidance, with magnetic interference falling off as the cube of distance as the physical basis; added a quantified antenna-to-antenna separation requirement (REQ-AF-22, ~12cm/one wavelength at 2.4GHz, a general RF design principle rather than a PX4/ArduPilot figure); set an explicit 30-minute minimum mission-time target (REQ-AF-71); noted the camera pod's size/mass range needs further investigation (REQ-AF-60); added Section 4.9 with firm transport (standard passenger car) and assembly-time (<5 minutes, no tools) requirements; reworded the propeller clearance requirement around no ground/airframe strike and no grass-cutting risk (REQ-AF-32); clarified the launch dolly continues supporting the current Believer airframe independently, not superseded by the new airframe; confirmed tail configuration is intentionally left open to the team.
- `context/open-items.md`: updated the custom airframe open item - RF/EMI separation is resolved (qualitative requirement, no numeric target exists), narrowed the remaining list to construction method, fabrication path, gimbal axis count, FPV mount angle, camera pod size/mass range, and payload mass budget.

## 2026-08-20

- Added `docs/engineering/requirements/custom-airframe-requirements.md` (SRD-BELIEVER-AIRFRAME-001, Rev 0.1): initial requirements for a new custom-designed airframe to replace the commercial MakeFlyEasy Believer airframe. Covers accessibility/modularity (tool-less hatches, non-glued components, modular mounting points), quick-release wings with connectorised wing-root electrical interfaces, centralised flight controller placement, RF/EMI separation between emitting components and the FC/GPS, contra-rotating propulsion, reuse of currently-owned avionics/propulsion where practical, adjustable battery mounting for CG trim, endurance-focused performance, mass/wingspan targets (<=4kg, <=3m), grass-runway landing gear, and an underslung gimbal camera pod plus forward FPV mount - based on requirements supplied by Julian, plus additional suggested requirements (wiring/connector standardisation, propeller-to-landing-gear clearance, positive battery retention, endurance/payload mass targets, transport/assembly-time consideration). Flagged a significant cross-document implication in Section 5: the existing launch dolly (`launch-dolly-requirements.md`) was motivated by the current airframe's lack of landing gear, which this new airframe's own landing gear may partially or fully supersede.
- `docs/project/project-roadmap.md`: added the custom airframe as a new roadmap item, cross-referencing its requirements document.
- `context/open-items.md`: added the custom airframe's open items (RF/EMI separation research, GPS occlusion angle, tail configuration, construction method, fabrication path, gimbal/FPV specifics, endurance/payload targets, landing-gear/launch-dolly overlap).

## 2026-08-19 (continued x2)

- `docs/project/build-checklist.md`: closed RF-03 (radio flight-mode audio cues) and RF-04 (radio timer widget), both configured on the GX12 - moved into Completed Work.

## 2026-08-19 (continued)

- `docs/project/build-checklist.md`: added silicone RTV securing of the DBR4 antenna bases/connectors to RF-05's scope (renamed "Mount and secure DBR4 antennas orthogonally"), per Julian - standard practice for damping vibration and preventing fatigue at RF antenna connectors/solder joints on RC airframes.
- `context/open-items.md`: updated the RF-05 open item to mention RTV securing alongside orthogonal mounting.

## 2026-08-19

- Replaced `docs/operations/Pixhawk Parameter Backup/believer-parameters.params` with the current FC export (was `parameters_19_08_2026.params`, dropped in the repo root by Julian). Notable confirmed-intentional changes: `COM_PREARM_MODE` 0 -> 2 (Always, allows actuating control surfaces while disarmed); `COM_FLTMODE2-6` remapped to add Acro at SW2 and drop Hold from the GR1 group (Manual/Acro/Stabilized/Altitude/Position/Mission); `PWM_MAIN_MIN1/2` 800 -> 1100 (V-tail); `PWM_MAIN_MIN3`/`MAX3`/`DIS3` -> 1200/1760/1520 (left aileron); `PWM_MAIN_MIN5`/`DIS5` -> 1230/1550 (right aileron); `PWM_MAIN_MIN4/6`/`MAX4/6` -> 1000/2000 (both motors); `CA_SV_CS0_TRIM`/`CS1_TRIM` -> -0.08/-0.03 (aileron mixer trim, finalised TMAC values); `CA_SV_CS2_TRQ_Y`/`CS3_TRQ_Y` 0.50 -> 0.85 (V-tail yaw mixing gain). `BAT_LOW_THR` was found at 12% in the supplied export (temporarily lowered for bench testing per Julian) and corrected back to 20% in the saved backup - the physical FC still needs the same correction, tracked in `context/open-items.md`. Refreshed accelerometer/gyroscope(IMU2)/barometer/magnetometer calibration values.
- `docs/operations/Pixhawk Parameter Backup/parameter-change-log.md`: updated to match - added a Safety/Arming section (`COM_PREARM_MODE`), a Control Surface Mixing section (`CA_SV_CS0-3`), updated Actuator Outputs PWM values, noted the `BAT_LOW_THR` bench-testing/reset, and refreshed the calibration values section (export date 2026-07-06 -> 2026-08-19).
- `docs/engineering/ICD.md` (Rev 1.8 -> 1.9): recorded the MN3110 KV700/AIR 40A propulsion install (replacing the U5 KV400 motors and previously-fitted ESCs), the dedicated ZTW UBEC 10A servo rail supply (replacing the PM03D for that role), the DBR4 relocation to the rear of the aircraft, and the finalised control surface mixing values. Updated the INT-02a-f actuator table against the new parameters and the QGroundControl Actuators Config screenshot; added a Control Surface Mixing subsection; updated the GR1 flight-mode mapping table (Acro added, Hold removed, still reachable via CH8).
- `docs/assets/actuator-output-config.png`: replaced with the current QGroundControl Actuators Config screenshot (dropped in the repo root as `Actuators_config.png`), reflecting the updated PWM ranges and mixing values.
- `docs/engineering/flight-modes.md` (Rev 1.0 -> 1.1): added a new Section 4.2 (Acro mode); removed Hold from the GR1 flight-mode selection table and renumbered subsequent mode sections; resolved the Stabilized-mode yaw open item (CTL-01) - reframed as a mode-expectation mismatch (Acro, not Stabilized, is the direct-response mode) rather than a Stabilized-mode defect, and recorded the V-tail yaw mixing gain increase.
- `docs/operations/manual.md`: updated the GR1 switch table (Acro added at SW2, Hold removed) and added a callout that the GR1 default startup position (SW2) is now Acro, not Stabilized - pilots must deliberately select SW3 for Stabilized before hand-launch. Updated the Pre-Flight Safety State target (SW2 -> SW3 for Stabilized) and the assisted hand-launch procedure (step 33: GR1 SW2 -> SW3).
- `docs/project/build-checklist.md`: closed out PROP-01 (MN3110/AIR 40A install), PROP-03 (motor start sync), PROP-04 (motor PWM min/max), PWR-01 (servo UBEC), CTL-01 (Stabilized yaw), CTL-03 (TMAC trim values), and CTL-05 (clean-install procedure, per Julian's confirmation it's addressed by ongoing repo practice). Added PROP-06 (throttle curve/mapping verification, split out from thrust verification per Julian's request) and PWR-03 (servo rail oscilloscope load test, non-blocking). Split RF-01 into a relocation-only task (closed) and new RF-05 (DBR4 antenna orthogonal mounting, Urgent, non-blocking - the receiver has plenty of range without it). Updated the Current Flight-Readiness Status table and the Completed Work section accordingly.
- `docs/project/purchase-history/purchase-history.md`: added the ZTW UBEC 10A (Amazon.com.au, $43.49 AUD incl. GST, Julian personal funds, 2026-07-13 order date, installed 2026-08-19); moved the invoice (dropped in the repo root as `ZTW UBEC 10A.pdf`) to `invoices/amazon-ztw-ubec-10a-2026-07-13.pdf`; updated the Julian (personal) total ($208.84 -> $252.33 AUD) and all-parties total ($1,189.92 -> $1,233.41 AUD); added a top-of-file line noting Julian's personal spend, per his request; updated the 9x6" Gemfan propeller notes to reflect they were not installed (superseded by carrying the existing Hobbyrama props over to the new motors).
- `context/project-notes.md`: updated the Motors/ESCs/Propellers and Power sections to reflect the installed state; added a new dated section narrating the full 2026-08-19 update (prearm mode, flight mode restructure and its rationale, propulsion install, propeller rotation decision, servo UBEC, control surface trim/mixing, actuator PWM ranges, DBR4 relocation, CTL-05 closure, and the BAT_LOW_THR discrepancy).
- `context/open-items.md`: removed resolved items (ESC model, motor replacement, TMAC trim values); added the physical-FC `BAT_LOW_THR` correction still pending, static thrust/throttle mapping verification, DBR4 antenna orthogonal mounting, and the servo rail oscilloscope load test.
- `context/project-overview.md`: updated the installed components table (PM03D now battery-telemetry only, added ZTW UBEC 10A, T-MOTOR MN3110 KV700 and T-Motor AIR 40A confirmed as installed); updated the Key Parameters list (GR1 mode list, added `COM_PREARM_MODE`); rewrote the Current Open Items summary to drop resolved items and reflect the current Critical blockers (CG, battery retention, thrust verification, throttle mapping).

## 2026-07-17 (continued x7)
- `context/project-notes.md`: recorded that no PDF datasheet exists for the Pixhawk 6X (Holybro documents it as a web-based site only), confirmed with the user.
- `docs/engineering/requirements/launch-dolly-requirements.md` (Rev 0.1 -> 0.2): resolved the driving motivation per user confirmation - the dolly reduces the aircraft's exposure to hand-launch failure-mode damage (mistimed release, stumble, wrong attitude/speed) by letting it accelerate to flying speed and rotate under its own power, similar to a wheeled departure; hand-launch remains available as a fallback rather than being mandatorily replaced. Resolved the target surface as standard grass runways with some tolerated unevenness (REQ-DOL-13, new REQ-DOL-14, REQ-DOL-20).
- `context/open-items.md`: narrowed the launch dolly item to what's still actually open (cradle geometry, target speed/attitude, retention mechanism, and the still-unquantified bump spec).

## 2026-07-17 (continued x6)
- Added `docs/engineering/requirements/launch-dolly-requirements.md` (SRD-BELIEVER-DOLLY-001, Rev 0.1): requirements for a releasable ground-roll launch cart, expanding on the former AF-05 task. Very little was previously established beyond the task existing, so most of the document is reference data (airframe dimensions, no-landing-gear/belly-landing constraint, current hand-launch procedure, airspeed parameters as a rough release-speed proxy) plus a substantial open-items list (cradle geometry, target release speed/attitude, retention mechanism, launch surface type, and whether the dolly replaces or supplements hand-launch).
- `docs/project/build-checklist.md`: marked RF-02 (RFD900x antenna installation) complete per user confirmation - moved from the F. RC/Telemetry/RF section into Completed Work, and added "RFD900x antenna security" to the Recurring Airworthiness Verification table now that there's something to verify. Removed AF-05 (Launch dolly) - moved to the future capability roadmap instead of active build tracking, now that it has its own requirements document (task IDs are not reused/renumbered when an item moves out).
- `docs/project/project-roadmap.md`: added the custom power distribution board and launch dolly, cross-referencing their new requirements documents.
- `context/open-items.md`: added the launch dolly's open items.

## 2026-07-17 (continued x5)
- Sourced and added datasheets to `Component datasheets/`: `ina228-datasheet.pdf` (moved/renamed from a copy the user placed in the repo root - official TI datasheet, SLYS021A), `tmotor-air-40a-esc-manual.pdf` (official T-Motor AIR series manual, confirms the acquired ESC's spec table), `tmotor-mn3110-kv700-motor-datasheet.pdf` (official T-Motor/LigPower datasheet covering the KV470/700/780 family), `tmotor-u5-kv400-motor-test-report.pdf` (manufacturer load-test report - no full datasheet exists for the U5 v2.0). All downloaded and content-verified before saving (each PDF was actually read, not just linked). Attempted the Hitec HS-5125MG's official datasheet (hiteccs.hitecrcd.com) but hit a TLS handshake failure against that host - not resolved; Emax ES3054 and the Holybro Pixhawk 6X still have no official downloadable PDF (checked fresh - the 6X's documentation is web-based only, no consolidated PDF).
- `context/directives.md`: broadened the `Component datasheets/` policy - now also covers components already acquired with an active install task in `docs/project/build-checklist.md` (not just currently-installed ones), since the AIR 40A ESC and MN3110 KV700 datasheets are for parts still pending PROP-01.
- `context/project-notes.md`: updated Motors/ESCs/Power sections with datasheet cross-references and corrected stale "no PDF" claims for the U5, MN3110, and INA228 entries.
- `docs/engineering/ICD.md` (Rev 1.7 -> 1.8): cross-referenced the four new datasheets from INT-01 and the Motors/ESC spec tables.

## 2026-07-17 (continued x4)
- `docs/engineering/ICD.md` (Rev 1.6 -> 1.7): recorded two T-Motor AIR 40A ESCs acquired to pair with the MN3110 KV700 motor upgrade (40A continuous / 60A 10s peak, 2-6S, 26g, no BEC) - not yet installed. Added a spec table for the incoming ESC, distinct from the currently-fitted (unidentified-model) ESC photos which remain accurate for the as-built state until PROP-01 swaps them.
- `context/open-items.md`: narrowed the ESC-model open item - the currently-fitted ESC is still unidentified, but the replacement is now known and confirmed compatible (40A vs the motor's 21A max draw); updated the PDB open items now that the ESC model is known.
- `context/project-notes.md`: recorded the T-Motor AIR 40A ESC acquisition and specs.
- `docs/project/build-checklist.md`: updated PROP-01's scope and background to install the acquired ESCs alongside the new motors, rather than "confirm compatibility of the installed ESCs" (folded into the same task rather than a new one, consistent with the checklist's one-work-package-per-undertaking convention - PWR-01 intentionally left unchanged, per user instruction, since the PDB is a separate future-development task).
- `docs/engineering/requirements/power-distribution-board-requirements.md` (Rev 0.2 -> 0.3): recorded the T-Motor AIR 40A ESC as reference data; resolved the spare-XT60-port-purpose open item per user confirmation (two ports committed to the motors, two held as spare capacity for undefined future battery-voltage loads) and reworked the input-sizing and current-sense requirements accordingly instead of assuming worst-case draw on all four ports.

## 2026-07-17 (continued x3)
- Added `docs/engineering/requirements/power-distribution-board-requirements.md` (SRD-BELIEVER-PDB-001, Rev 0.2): requirements for a bespoke power distribution board to replace the Holybro PM03D, motivated by its undersized XT-30 motor outputs and 3A-limited servo BEC (see `docs/project/build-checklist.md` PWR-01). Requirements cover: XT90 battery input; four 40A-rated XT60 distribution outputs; a fixed 5V/10A servo-rail buck converter (isolated from the FC supply, matching the current architecture) and a second 5/9/12V-configurable 10A buck for future payload use; battery telemetry replicated on the same 6-pin 2.00mm CLIK-Mate connector/pinout as the PM03D so the FC-side harness needs no changes; input decoupling capacitance; and a four-sided connector layout (battery input and telemetry on opposite sides, the four XT60 ports split across the other two). Fact-checked the XT30 connector current rating per user request - found no single authoritative number (30A hobby-marketed vs 15A per one distributor's technical listing vs ~15-20A common practical derating), recorded as reference data rather than asserted fact. Cross-referenced the T-Motor MN3110 KV700's actual max continuous current (21A, from the manufacturer) against the outgoing U5 v2.0 (30A) as sizing justification for the 40A port rating. Left five items open (spare port purpose, size/weight envelope, capacitor sizing and current-sense range - both dependent on the still-unresolved ESC model, ESC connector type, environmental range).
- `context/open-items.md`: added the new PDB open items.

## 2026-07-17 (continued x2)
- Restructured `docs/` from a flat file list into three purpose-based subfolders, per user request:
  - `docs/engineering/` - `ICD.md`, `flight-modes.md`, `requirements/`, `test-reports/` (how the aircraft is built and works)
  - `docs/operations/` - `manual.md`, plus the top-level `GX12 Backup/` and `params/` folders moved and renamed in: `GX12 Radio Backup/` and `Pixhawk Parameter Backup/` (how the aircraft is flown, and the backups that support that)
  - `docs/project/` - `build-checklist.md`, `project-roadmap.md`, `project-overview.md`, `project-timeline.md`, `purchase-history/`, and `docs/reference/` renamed to `governance/` (project status, history, and admin)
  - `docs/assets/` stays at `docs/` root, shared by all three
- Rewrote every internal cross-reference repo-wide to match (relative links in every moved document, plus path mentions in `context/directives.md`, `style-guide.md`, `project-overview.md`, `open-items.md`, `project-notes.md`, `startup-prompt.md`, `academic-integrity.md`, `README.md`). Historical narrative in this CHANGELOG and in documents' own Revision History tables was left untouched - those describe what was true at the time, not current file locations.
- `context/directives.md`: rewrote the "File organisation" section to describe the new three-way split and the reasoning behind it.

## 2026-07-17 (continued)
- `docs/ICD.md` (Rev 1.5 -> 1.6): cross-checked every value in the INT-02a-f actuator table against the actual exported parameters (`params/believer-parameters.params`) - found the table had never matched them since it was first written (Rev 1.0, 2026-07-03, before the 2026-07-05 radio calibration and 2026-07-06 ruddervator direction fix). Corrected: MAIN 1 Min/Max 1100/1900 -> 800/2000us and Reversed Yes -> No; MAIN 2 Min/Max 1100/1900 -> 800/2000us and Reversed No -> Yes; MAIN 3 Min/Max 1100/1900 -> 1000/2000us; MAIN 4 and MAIN 6 Min/Max 1000/2000 -> 1100/1900us (MAIN 5 already matched). Also replaced the stale "reverse-pitch prop TBD, see open items" note (that open item was resolved 2026-07-16) with a reference to the pending MN3110 upgrade.
- `docs/assets/icd-block-diagram.svg`: corrected the MAIN 1/MAIN 2 "reversed" labels to match the ICD fix above (swapped which V-tail channel is marked reversed); updated the diagram's own revision footer, which had been stuck reading "Rev 1.4" since before the Rev 1.5 redraw.
- `context/project-overview.md`: corrected the actuator mapping table to match the same MAIN 1/MAIN 2 reversed-flag fix; corrected the MS4525DO row (wiring is documented, not TBD); rewrote the "Current open items" summary (RTK antenna is not itself a flight blocker since the aircraft flies on GPS 1 alone; ESC protocol is the only real motor/ESC gap remaining); added `flight-modes.md`, `project-roadmap.md`, and `project-timeline.md` to the repo structure map and key document relationships.
- `context/open-items.md`: narrowed the MS4525DO I2C item to just the pull-up resistor configuration - port and address are confirmed in `docs/ICD.md` INT-07 and were stale in the old item wording.
- `docs/project-overview.md`: added `flight-modes.md` and `project-roadmap.md` to the Related Documents list.
- `docs/project-timeline.md`: added the missing milestones between 2026-07-05 and today (motor purchase/ruddervator fix, TMAC review, propeller purchase, build-checklist restructure, flight-modes.md addition, ICD correction); rewrote "Current Status"/"Remaining before first flight" to match the actual current Critical/Urgent items in `build-checklist.md` (was still describing the pre-TMAC-review state, e.g. "motor replacement decision pending" and "source reverse-pitch propeller" as open, both resolved 2026-07-06/07-14); replaced the stale Phase 2 motor/propeller evaluation bullet with the still-open MotoCalc characterisation task.
- `docs/requirements/underslung-camera-mount-requirements.md`: corrected the camera mount task's cross-reference from `build-checklist.md` (Future Work, removed in the 2026-07-16 restructure) to `project-roadmap.md`.

## 2026-07-17
- Added `docs/flight-modes.md` (FM-BELIEVER-001, Rev 1.0): new document describing the eight PX4 fixed-wing flight modes reachable on the Believer (Manual, Stabilized, Altitude, Position, Hold, Mission, Return, Offboard) - behaviour, stick response, and configuring parameters, cross-referenced against the official PX4 User Guide and the actual as-exported values in `params/believer-parameters.params`. Includes the GR1-to-`COM_FLTMODEx` switch mapping (cross-checked against the existing QGroundControl-screenshot-verified table in `manual.md`), the CH8/CH10/CH11 override switches, and a failsafe-interactions section (`NAV_RCL_ACT`, `NAV_DLL_ACT`). Cross-referenced the open CTL-01 (Stabilized yaw) and AF-01 (CG) items from `docs/build-checklist.md` where they affect mode behaviour, and noted that the airspeed/TECS parameters are still at PX4 generic-airframe defaults pending CTL-02 tuning.
- `docs/manual.md`: expanded the GR1 flight-mode table (Section 3) with a "Behaviour" column; added a short description of the CH10 (Return) and CH11 (Offboard) override switches; linked to the new `docs/flight-modes.md` for full detail.
- `context/directives.md`: added `docs/flight-modes.md` to the file organisation list.

## 2026-07-16 (continued x4)
- `docs/build-checklist.md`: restructured from a status-first table (In Progress/Not Started/Future Work/Complete) into a flight-readiness dashboard plus engineering work packages (Airframe & mechanical retention, Propulsion, Electrical power, Flight controls & PX4, Navigation & air-data sensors, RC/telemetry/RF), each task carrying an ID, status, priority, milestone, explicit "Depends on" field, scope, and (for Critical tasks) acceptance criteria; merged the "Motor and ESC replacement" heading and "Install T-MOTOR MN3110 KV700 motors" action into a single PROP-01 work package, with static thrust testing split out as PROP-02; surfaced the still-pending TMAC trim values (previously buried in a Complete row's notes) as its own task, CTL-03; moved provenance/citation notes into collapsed "Background and engineering notes" `<details>` blocks per task; added a "Recurring Airworthiness Verification" table for retention/torque checks that were previously listed as permanently "Complete" (propeller nuts, hatch/nacelle/bolt torque, antenna security), with dates left TBD pending a dated inspection record; collapsed the historical Complete list into a `<details>` block, regrouped by subsystem.
- Added `docs/project-roadmap.md`: split out of the former "Future Work" table (payload/autonomy items not required for current flight-readiness); linked from `docs/build-checklist.md`.
- `context/directives.md`: added `docs/build-checklist.md` and `docs/project-roadmap.md` to the file organisation list.
- `context/style-guide.md`: added `docs/build-checklist.md` to the exceptions list - collapsed "Background and engineering notes" sections are permitted to carry provenance/citation content that the general docs/ standard otherwise excludes.
- `context/open-items.md`: added an item noting the recurring verification checks have no dated inspection record to backfill "Last verified"/"Evidence" against.

## 2026-07-16 (continued x3)
- `docs/build-checklist.md`: reordered sections (In Progress, Not Started, Future Work, Complete - Complete moved to the end); added "Blocked by" notes identifying task dependencies (GPS 2 antenna/config chain, motor start sync on the new motor install, LiDAR install/source chain, auto takeoff/land blocked by LiDAR install, camera-record-on-arm blocked by companion computer/camera mounts).

## 2026-07-16 (continued x2)
- `docs/manual.md`: removed section 4 (Flaperons); renumbered subsequent sections (Pre-Flight Safety State, Pre-Flight Checklist) accordingly. CH9 channel mapping table entries left unchanged.

## 2026-07-16 (continued)
- `docs/assets/icd-block-diagram.svg` (ICD Rev 1.4 -> 1.5): recreated the block diagram. Fixed a routing bug where the GX12-DBR4 RF link visually terminated on the V-Tail Left servo box instead of DBR4 (the GX12 box was positioned on the far left, over the actuator column, while its target DBR4 was on the far right - the straight-line RF path never reached it). Regrouped GX12 and Ground Station together above their onboard RF counterparts (DBR4, RFD900x); rerouted the Ground Station-RFD900x link around the DBR4 box instead of crossing through it; rerouted PM03D-FC power to enter via the FC's top edge instead of colliding with the PWM bus; re-centred MS4525DO under the FC; updated the stale propeller label and revision footer.

## 2026-07-16
- `docs/ICD.md` (Rev 1.3 -> 1.4): removed a stray UTF-8 BOM causing garbled rendering; added the PM03D's 3A servo rail current limit, confirmed against `Component datasheets/holybro-pm03d-manual.pdf`.
- `docs/purchase-history/purchase-history.md`: added two 9x6" Gemfan propeller invoices (standard + pusher, 2026-07-14, $19.07 AUD combined, Julian personal funds), superseding the 11x7" Hobbyrama props for the new KV700 motors; added Julian (personal) and all-parties total summary rows alongside the existing University total.
- Added `docs/test-reports/2026-07-10-tmac-review-peter-spink.md`: reformatted from a root-directory draft - system review and RC tuning session with Peter Spink (TMAC).
- `docs/build-checklist.md`: added tasks from the TMAC review - servo rail UBEC installation, DBR4 receiver relocation, CG correction ballast, battery retention velcro, RFD900x powered from PM03D, radio timer widget, radio flight-mode audio cues (Future Work: control surface hinges, MotoCalc airframe characterisation); updated motor start synchronisation (root cause confirmed: ESC calibration) and flight mode investigation (no yaw authority in Stabilized, raised to Critical) tasks; removed the now-superseded 11x7" reverse-pitch propeller tasks, folded into the KV700 motor install task; updated primary control expo (throttle expo removed) and control surface deflection/expo (aileron differential, rudder mix, pending trim) Complete entries; removed the stale CG-verified claim from the battery installation entry.
- `context/project-notes.md`: added TMAC review provenance section; updated the PM03D power section with the confirmed 3A rail limit.
- `context/open-items.md`: resolved the PM03D output rail ratings and 11x7" reverse-pitch propeller items; added the pending trim values item.
- `docs/manual.md`: added pre-flight checklist step to update `SENS_BARO_QNH` to the current ambient barometric pressure reading (renumbered subsequent steps).

## 2026-07-06 (continued x15)
- Replaced `params/believer-parameters.params` with the current FC export (was untracked in the repo root). Notable confirmed-intentional changes beyond the earlier telemetry tuning (`MAV_0_RATE` 1200->3000, `MAV_1_RATE` 9600->19200): `MAV_1_MODE` 3 (OSD) -> 0 (Normal); `PWM_MAIN_MIN1`/`MIN2` 1000->800 (more V-tail servo travel); `PWM_MAIN_REV` 5->6 (reversed set changed from MAIN1+MAIN3 to MAIN2+MAIN3, consistent with the ruddervator direction fix). Also refreshed a routine accelerometer/gyro/mag/barometer recalibration.
- `params/parameter-change-log.md`: updated to match - MAV_0/MAV_1 rates and MAV_1_MODE, PWM_MAIN_MIN1/2 and PWM_MAIN_REV with notes, and all calibration values (export date 2026-07-04 -> 2026-07-06).
- `docs/ICD.md` (Rev 1.2 -> 1.3): updated MAV_1_MODE (OSD -> Normal); flagged the BATTERY_STATUS extras.txt override as not yet re-verified against Normal mode's default rate.
- `context/open-items.md`: added the BATTERY_STATUS re-verification item.

## 2026-07-06 (continued x14)
- `docs/requirements/underslung-camera-mount-requirements.md` (Rev 1.1 -> 1.2): resolved three open items per user confirmation - the 3mm recess (REQ-CAM-13) is sufficient; the manufacturer's load compartment is the same bay as REQ-CAM-10; softened REQ-CAM-14 to avoid vignetting "where possible," framing full-FOV avoidance as a limitation of the specific candidate module.
- `context/project-notes.md`: recorded both confirmations.

## 2026-07-06 (continued x13)
- `docs/requirements/underslung-camera-mount-requirements.md` (Rev 1.0 -> 1.1): added Section 3b recording the airframe's manufacturer-published dimensions, MTOW, payload capacity, and load/battery compartment sizes (en.makeflyeasy.com); added a payload-capacity budget to REQ-CAM-12; flagged that the manufacturer page didn't corroborate the landing-pad detail in REQ-CAM-10.
- `context/project-notes.md`: recorded the airframe manufacturer's published dimensions and payload specs.

## 2026-07-06 (continued x12)
- `docs/requirements/underslung-camera-mount-requirements.md` (Rev 0.9 -> 1.0): added REQ-CAM-18 - the male carrier shall be interchangeable without tools (bayonet/spring latch/thumb screw, not plain screws or bolts). Narrowed the mating-mechanism open item to reflect this constraint.

## 2026-07-06 (continued x11)
- `docs/purchase-history/purchase-history.md`: added 2x T-MOTOR MN3110 KV700 motors (Julian personal funds, $169.87 AUD, 2026-07-06), replacing the T-Motor U5 v2.0 KV400 units.
- `docs/purchase-history/invoices/tmotor-mn3110-kv700-motors-2026-07-06.pdf`: added invoice.
- `docs/build-checklist.md`: updated "Motor and ESC replacement" to reflect the KV700 motors purchased (ESC compatibility still TBD); added "Install T-MOTOR MN3110 KV700 motors" task; updated the thrust-to-weight ground test to be repeated once the new motors are fitted.
- `context/open-items.md`, `context/project-notes.md`: updated motor replacement and ESC entries to reflect the purchase.

## 2026-07-06 (continued x10)
- `docs/requirements/underslung-camera-mount-requirements.md` (Rev 0.8 -> 0.9): resolved REQ-CAM-10 - camera mount location is the fuselage centreline, between the two landing pads, per the airframe manufacturer's documentation. Removed the mounting-location open item; added an open item on whether the landing pads sit proud of the surrounding skin (relevant to the REQ-CAM-13 recess depth).
- `context/project-notes.md`: recorded the landing pads and the manufacturer-designated camera mount location.

## 2026-07-06 (continued x9)
- Renamed `docs/requirements/camera-mount-requirements.md` -> `docs/requirements/underslung-camera-mount-requirements.md` (Rev 0.7 -> 0.8), to distinguish from future camera mount requirement documents for other locations. Updated cross-references in `context/open-items.md` and `context/project-notes.md`.

## 2026-07-06 (continued x8)
- `docs/requirements/camera-mount-requirements.md` (Rev 0.6 -> 0.7): renamed document title to "Underslung Camera Mounting Subsystem - System Requirements" (filename unchanged).

## 2026-07-06 (continued x7)
- `docs/requirements/camera-mount-requirements.md` (Rev 0.5 -> 0.6): removed REQ-CAM-31 and narrowed REQ-CAM-30 - the camera/companion-computer interface itself is out of scope for this document; the mount's only obligation is not to obstruct the cable being routed away. Renamed section 4.4 to "Interface"; removed the companion-computer-selection open item.

## 2026-07-06 (continued x6)
- `docs/requirements/camera-mount-requirements.md` (Rev 0.4 -> 0.5): clarified the modular mount philosophy per user direction - the female base and its mating interface (REQ-CAM-15) are fixed and never change; a new male carrier may be custom-designed per camera module (REQ-CAM-16, -17) rather than one universal adjustable carrier. Added connector detail (SH1.0 5-pin to USB cable) to the candidate module reference data; corroborated the -10°C operating-temperature low end via a second independent source (Core Electronics product page). Removed the stale REQ-CAM-01 open item (angle is now fixed, not TBD); added an open item for the still-undecided mating mechanism.

## 2026-07-06 (continued x5)
- `docs/requirements/camera-mount-requirements.md` (Rev 0.3 -> 0.4): reframed REQ-CAM-01 as downward (nadir)-facing; added Section 3a recording the Waveshare IMX335 (B) as a reference candidate module rather than a fixed design input; flagged a geometry conflict between the 3mm recess (REQ-CAM-13) and the candidate's 175° FOV lens, an unreconciled operating-temperature discrepancy between sources (10°C vs -10°C low end), and the candidate lens's 36.94mm length against unconfirmed internal fuselage clearance.
- `context/project-notes.md`: recorded the candidate camera module's specs and source discrepancy.

## 2026-07-06 (continued x4)
- Redistributed `supporting-documents/` into `docs/` by content type: the proposal and signed funding application PDFs moved to new `docs/reference/`; `purchase-history.md` and its `invoices/` subfolder moved together into new `docs/purchase-history/`. Removed the now-empty `supporting-documents/` folder.
- Updated all cross-references: `docs/purchase-history/purchase-history.md` (internal invoice/proposal links), `docs/ICD.md` (Reference Documents), `docs/project-overview.md`, `docs/requirements/camera-mount-requirements.md`, `context/directives.md`, `context/project-overview.md` (repo structure map), `context/style-guide.md`, `context/startup-prompt.md`, `context/academic-integrity.md`, and `README.md`.

## 2026-07-06 (continued x3)
- Moved `docs/camera-mount-requirements.md` -> `docs/requirements/camera-mount-requirements.md`, establishing `docs/requirements/` as the home for system requirements documents (one file per subsystem). Updated cross-references in `context/open-items.md`, and added the new folder to the repo structure maps in `context/project-overview.md`, `README.md`, and the naming convention to `context/style-guide.md`.

## 2026-07-06 (continued x2)
- `docs/camera-mount-requirements.md` (Rev 0.2 -> 0.3): added a modular two-part mount requirement (REQ-CAM-15 to -17) - female base fixed to the airframe, male carrier holding the camera, swappable for future camera changes, up to a 50mm x 50mm footprint with adjustable positioning for varying lens lengths.

## 2026-07-06 (continued)
- `docs/camera-mount-requirements.md` (Rev 0.1 -> 0.2): REQ-CAM-13 specifies internal camera mounting with the lens recessed 3mm through a belly cutout; added REQ-CAM-14 (cutout sizing to avoid vignetting); flagged open question on whether 3mm recess is sufficient given grass/dirt landing surfaces, and that lens FOV spec is unavailable to size the cutout.

## 2026-07-06
- Added `docs/camera-mount-requirements.md` (Draft, Rev 0.1): initial system requirements for the IMX335 camera mounting subsystem (belly-mounted, downward/oblique observation, camera-only scope). Flags the airframe's lack of landing gear as a primary structural design driver (belly-landing ground-strike protection).
- `context/open-items.md`: added camera mounting subsystem dependencies (companion computer selection, mounting location, observation angle, environmental range).

## 2026-07-05 (continued x7)
- Added `docs/test-reports/2026-07-05-initial-system-inspection.md`: new test report covering today's BNEMAC review findings and same-day follow-up configuration work. Establishes `docs/test-reports/` as a new dated, one-file-per-session document type.
- `context/style-guide.md`: added `docs/test-reports/` to the transactional-log exceptions; documented the `YYYY-MM-DD-<slug>.md` naming convention.
- `context/project-overview.md`, `README.md`: added `docs/test-reports/` to the repo structure map.

## 2026-07-05 (continued x6)
- Corrected the BNEMAC review date: the full review (thrust, ruddervator, motor timing, servo travel, stabilize mode) was 2026-07-05 (today), not 2026-07-04 as earlier entries in this changelog, `docs/project-timeline.md`, `context/project-notes.md`, and `context/open-items.md` had recorded. 2026-07-04 remains correct for the propeller purchase and a brief, separate hello with Ross.

## 2026-07-05 (continued x5)
- `docs/project-timeline.md`: added 2026-07-05 BNEMAC visit (Ross Dennington) to Completed Milestones; refreshed "Remaining before first flight" and Phase 2 roadmap to match current build-checklist state (removed stale 11x4.7" propeller references and already-completed items; added thrust-to-weight test, reverse-pitch propeller, and flight mode investigation).
- `docs/build-checklist.md`: merged ruddervator direction fix back into the combined "Control surface PWM mapping and direction" Complete entry (all surfaces now verified correct); reframed "Motor and ESC replacement" as pending a new "Thrust-to-weight ground test" task rather than a settled conclusion; updated "Source reverse-pitch propeller" to note motors are temporarily set to spin the same direction as an interim fix; added "Reverse motor rotation after propeller upgrade" task; moved deflection limits/expo to Complete and split out "Dual/tri-rate switch-selectable deflection" as a separate Non-critical task per user direction.
- `context/project-notes.md`: recorded the ruddervator fix, the now-unsettled thrust conclusion pending a ground test, and the interim same-direction motor reconfiguration (and its likely contribution to the original thrust complaint).
- `context/open-items.md`: updated motor replacement and reverse-pitch propeller entries to reflect the above.

## 2026-07-05 (continued x4)
- `docs/build-checklist.md`: moved "Primary control expo" to Complete - 30% set on aileron/elevator/rudder, 20% on throttle (deviating from the originally planned flat 30% on all four). Updated "Control surface deflection limits, rates, and expo" notes to reflect expo now done; dual/tri-rate switch-selectable deflection still outstanding.

## 2026-07-05 (continued x3)
- `docs/ICD.md` (Rev 1.1 -> 1.2): added INT-08 ELRS packet rate (100Hz Full); added MAV_1 parameters and BATTERY_STATUS override note to INT-03 (TELEM1/DBR4); added device path and BATTERY_STATUS override note to INT-04 (TELEM2/RFD900x).
- `context/project-notes.md`: recorded the 2026-07-05 telemetry rate tuning session - ELRS packet rate, MAV_0/MAV_1 instance identification, MAV_0_RATE discrepancy (documented 3000 B/s vs. live 1200 B/s) and correction, MAV_1_RATE increase, BATTERY_STATUS per-message overrides, and the `/fs/microsd/etc/extras.txt` persistence quirks (root vs. `etc/` path, console write limitations).

## 2026-07-05 (continued x2)
- `docs/build-checklist.md`: moved "Control surface deflection limits, rates, and expo" from Not Started to In Progress - radio calibration completed, matching stick travel to the configured PWM deflection limits; rates/expo configuration still outstanding.

## 2026-07-05 (continued)
- `docs/build-checklist.md`: added tasks from the 2026-07-05 BNEMAC review - motor and ESC replacement (higher KV), reverse-pitch propeller sourcing, V-tail (ruddervator) direction correction, motor start synchronisation investigation, flight mode behaviour investigation; folded servo max-travel calibration into the existing deflection/rates/expo task; narrowed the control surface direction Complete entry to ailerons only pending the ruddervator fix. Also added 30% primary control expo, motor/ESC bay cover bolt replacement, RFD900x antenna installation, and launch dolly tasks.
- `context/project-notes.md`: recorded BNEMAC review findings (2026-07-05, Ross) and provenance for the new build-checklist tasks.

## 2026-07-05
- `supporting-documents/invoices/hobbyrama-propellers-2026-07-04.jpg`: added invoice photo for the propeller purchase.
- `docs/purchase-history.md`: added 11x7" Hobbyrama propellers (2x, Julian personal funds, 2026-07-04), replacing the prior unbranded 11x4.7" props.
- `docs/ICD.md`: updated Propeller row (11x4.7" unknown -> 11x7" Hobbyrama LP11X7E); added Propeller rotation row noting both fitted props are currently the same handedness pending a reverse-pitch unit.
- `context/open-items.md`: resolved propeller manufacturer/thrust-validation items; added motor replacement (inadequate thrust, BNEMAC review) and reverse-pitch propeller sourcing as new open items.
- `context/project-notes.md`: recorded propeller purchase provenance and the contra-rotation mismatch.

## 2026-07-04 (continued x2)
- `params/believer-parameters.params`: replaced with 2026-07-04 FC export (params.params). Changes from previous export: full accelerometer recalibration (offsets and scales, ACC0/1/2); barometer offset updated (26.695 → 24.000); full magnetometer recalibration including soft-iron correction (MAG0 and MAG1, odiag values now non-zero); CAL_MAG0_PRIO set to 0 (internal compass excluded from sensor fusion); board level calibration updated (SENS_BOARD_X_OFF, SENS_BOARD_Y_OFF); airspeed differential pressure offset updated (SENS_DPRES_OFF: 58.784 → 48.835); GF_MAX_VER_DIST set to 120; GPS_2_CONFIG set to 0 (GPS_2_GNSS, GPS_2_PROTOCOL, and SER_GPS2_BAUD parameters removed from file as a result); COM_FLIGHT_UUID incremented to 181.
- `params/parameter-change-log.md`: updated calibration section with all 2026-07-04 values; added accelerometer scale factors; added full MAG0 and MAG1 calibration with odiag; added board level and airspeed offset sections; updated GPS table to remove GPS_2_GNSS row (no longer in params file); updated header date to 2026-07-04.

## 2026-07-04 (continued)
- `params/parameter-change-log.md`: added GPS_2_CONFIG = 0 (Disabled); ZED-F9P port disabled until antenna and mount are installed. Parameter backup pending update.

## 2026-07-04
- `docs/build-checklist.md`: moved propeller retention nuts and GPS mounting bolt torque to Complete.

## 2026-07-03 (continued x23)
- `docs/manual.md`: moved launch area clear check to immediately before launch (step 31); added assisted hand launch section (steps 31-38) covering roles, handler grip, arm/throttle sequence, throw technique, and post-launch recovery.

## 2026-07-03 (continued x22)
- `docs/manual.md`: expanded pre-flight checklist from 21 to 31 steps; added section headers; added weather/NOTAM checks, pitot obstruction check, home position confirmation, geofence active check, RSSI check, airspeed sensor functional check, explicit disarm before propeller installation, people/airspace clear check, and propeller retention nut torque check (with LHS reverse-thread note).

## 2026-07-03 (continued x21)
- `docs/manual.md`: added GX12 front and top switch diagrams to RC Control section; added QGC flight modes config screenshot after GR1 flight mode table.

## 2026-07-03 (continued x20)
- Corrected project history: airframe built prior to 2020 (inherited), project revived December 2025. Updated `docs/project-timeline.md` milestones and `context/project-notes.md`.

## 2026-07-03 (continued x19)
- Created `docs/project-timeline.md`: completed milestones table, current status summary, remaining pre-flight tasks, and five-phase roadmap (first flight, expanded testing, companion computer integration, autonomous capabilities, BVLOS operations). Linked from `docs/project-overview.md`.

## 2026-07-03 (continued x18)
- `docs/build-checklist.md`: added Future Work section; moved paint/finishing and parachute/payload bay servo there from Not Started; added companion computer mount, camera mount, camera record-on-arm, LiDAR sourcing, LiDAR installation, auto takeoff, and auto land tasks.

## 2026-07-03 (continued x17)
- `docs/build-checklist.md`: moved sensor calibration (accelerometer, gyroscope, magnetometer) to Complete.

## 2026-07-03 (continued x16)
- `docs/build-checklist.md`: moved failsafe configuration to Complete.

## 2026-07-03 (continued x15)
- `params/parameter-change-log.md`: added GF_MAX_VER_DIST = 120m to geofence section.

## 2026-07-03 (continued x14)
- `docs/build-checklist.md`: moved geofence configuration to Complete (GF_ACTION = Return, GF_MAX_VER_DIST = 120m AGL).

## 2026-07-03 (continued x13)
- `docs/build-checklist.md`: moved motor and ESC configuration to Complete; split out motor PWM min/max limits as a new Urgent Not Started task.

## 2026-07-03 (continued x12)
- `docs/build-checklist.md`: GPS 2 (ZED-F9P) configuration and validation re-prioritised from Critical to Urgent; reordered In Progress section to maintain Critical-first sort.

## 2026-07-03 (continued x11)
- `docs/build-checklist.md`: split control surface and servo configuration into two tasks - "Control surface PWM mapping and direction" (Complete) and "Control surface deflection limits, rates, and expo" (Not Started, Critical).

## 2026-07-03 (continued x10)
- `docs/build-checklist.md`: moved airspeed sensor calibration, battery/power monitor configuration, and GPS 1 (M8N) configuration and validation to Complete; split GPS configuration task into GPS 1 (Complete) and GPS 2/ZED-F9P (In Progress, blocked by antenna); moved failsafe configuration from Not Started to In Progress.

## 2026-07-03 (continued x9)
- Updated `docs/ICD.md` INT-07 (Rev 1.0 - 1.1): added I2C port detail for MS4525DO - Pixhawk 6X I2C port (JST-GH 4-pin), address 0x28. Updated `context/project-notes.md` to match.

## 2026-07-03 (continued x8)
- Rewrote `params/parameter-change-log.md`: replaced changelog-style sections with a single current-configuration reference (one table per subsystem, current values only, no old-value tracking). Added MAV_1_* (TELEM1/ELRS OSD telemetry back-channel) and PWM_MAIN_FUNC1-6 / PWM_MAIN_REV (actuator assignments). Moved calibration values (ACC, BARO, GYRO, MAG) to a separate section at the bottom. Flag on PWM_MAIN_DIS7 = 2000 removed from the log (not an intentional configuration change).

## 2026-07-03 (continued x7)
- Replaced `params/believer-parameters.params` with user-supplied dump `beleiver.params` (2026-07-03 export from FC).

## 2026-07-03 (continued x6)
- `docs/build-checklist.md`: added Urgent priority tier (between Critical and Non-critical); added priority definitions header; re-prioritised all tasks - pitot permanent mount, pitot clearance, ZED-F9P antenna and mount, geofence, and PID tuning moved to Urgent; GPS 2 antenna note updated to clarify aircraft can fly on M8N only.

## 2026-07-03 (continued x5)
- `docs/build-checklist.md`: sorted rows within each status section - Critical items first, Non-critical below.

## 2026-07-03 (continued x4)
- `docs/build-checklist.md`: upgraded GPS mounting bolt torque priority from Non-critical to Critical.

## 2026-07-03 (continued x3)
- `docs/build-checklist.md`: renamed "Avionics bay mounting bolt torque" to "Torque avionics bay mounting bolts" and moved to Complete.

## 2026-07-03 (continued again)
- Restructured `docs/build-checklist.md`: replaced category-based layout with three status sections (Complete, In Progress, Not Started), each as a single table with a Category column; dropped the Status column (redundant with section heading) and the # column. Parachute/payload bay servo split out as a new Not Started item (previously embedded as future-work notes in the Complete parachute bay task).

## 2026-07-03 (continued)
- `docs/build-checklist.md`: marked Fasteners and Retention Checks items 1 (motor/ESC access hatch) and 2 (nacelle retention) as Complete.

## 2026-07-03
- Rewrote `docs/build-checklist.md`: added Priority column (Critical / Non-critical) to all tables; changed "Done" to "Complete" throughout; updated parachute bay task (servo removed, bay taped shut, future servo/payload work noted); updated pitot installation note (secured with tape); added pitot permanent mount task (Sensors item 2, shifted clearance check to item 3); added wiring tidy task (Avionics Installation item 4); marked Configure and Tune item 7 (RC and flight mode configuration) as Complete.
- Updated `docs/ICD.md` to Rev 1.0: split INT-02 into INT-02a through INT-02f in the interface summary (one row per PWM output, naming the connected device); updated INT-02 section heading to "INT-02a through INT-02f"; added full 16-pin RFD900x connector pinout table under INT-04 after the pinout diagram image.
- Redrawn `docs/assets/icd-block-diagram.svg`: replaced single "Control Surfaces and Motors" block with 6 individual actuator boxes (one per MAIN output), each labelled with device model and PWM assignment; motor boxes use a distinct green style; INT-02 link labels updated to INT-02a through INT-02f; legend updated to include motor/propulsion entry. Canvas expanded to 1500x1100 to accommodate new layout.

## 2026-07-02 (session 2, continued again)
- Added pitot tube clearance verification task to `docs/build-checklist.md` Sensors section (item 2): verify pitot tube protrudes sufficiently ahead of the airframe to sample undisturbed air; reposition if clearance is insufficient.

## 2026-07-02 (session 2, continued)
- Recorded propeller as 11x4.7" (manufacturer unknown) in `docs/ICD.md` motor spec table and `context/project-notes.md`.
- Updated `context/open-items.md`: split propeller entry into two items - manufacturer TBD and thrust validation pending.
- Added thrust validation task to `docs/build-checklist.md` Configure and Tune section (item 5a): verify 11x4.7" props on T-Motor U5 v2.0 KV400 produce adequate thrust for the aircraft's all-up weight.

## 2026-07-02 (session 2, earlier)
- Documented motors, ESCs, and servos in `docs/ICD.md` (INT-02 connected devices): T-Motor U5 v2.0 KV400 (motors, MAIN 4/6), Hitec HS-5125MG (aileron servos, MAIN 3/5), Emax ES3054 (V-tail servos, MAIN 1/2). ESC identified as T-Motor branded; model number not legible from PCB markings (T-MOTOR, 1747, 08) - protocol TBD. Bumped ICD revision to 0.9.
- Added component photos to `docs/assets/`: `tmotor-u5-front.jpg`, `tmotor-u5-side.jpg`, `tmotor-esc-front.jpg`, `tmotor-esc-back.jpg`, `hitec-hs5125mg-wing-servo.jpg`, `emax-es3054-tail-servo.jpg`. Wired into ICD INT-02 under each device spec section.
- Updated `context/project-overview.md`: added T-Motor U5 v2.0, T-Motor ESC, Hitec HS-5125MG, and Emax ES3054 to the installed components table.
- Updated `context/project-notes.md`: added Motors and Servos section with confirmed specs and provenance notes.
- Updated `context/open-items.md`: replaced generic motors/ESCs TBD with two specific items - ESC model (T-Motor, PCB markings noted, protocol TBD) and propeller size (TBD).
- Note: no official PDF datasheets published by any of the three manufacturers; specs sourced from product pages only.

## 2026-07-02
- Rewrote `README.md`: added "AI-enabled workflow" section explaining the context/ approach and how to start a new AI session; converted context file list to a table with role descriptions; tightened the repo contents listing.
- Cleaned up `context/` files to eliminate cross-over and redundancy:
  - Removed `context/MEMORY.md` - fully redundant with `context/startup-prompt.md`'s read-order list; removed references from `README.md` and `context/project-overview.md`
  - Rewrote `context/directives.md` - removed items that belonged in `context/style-guide.md` (Markdown-only rule, assets path, TBD convention, em-dash rule); reorganised remaining working conventions under two headings (File organisation, Session behaviour)
  - Updated `context/style-guide.md` - added em-dash rule (moved from directives.md); now the single owner of all writing and formatting standards
  - Updated `context/startup-prompt.md` - removed "Standing instructions" section (all rules now live in their canonical file only); replaced with a single pointer to directives.md and style-guide.md
- Removed root `CHANGELOG.md` stub (it only contained a redirect to `context/CHANGELOG.md`; redirect is no longer needed as the canonical location is established).
- Updated `context/directives.md`: strengthened the CHANGELOG rule from "log notable changes" to a mandatory requirement - every change to any repo document must be logged in `context/CHANGELOG.md` before committing, no exceptions.
- Added geofence configuration task to `docs/build-checklist.md` Configure and Tune section (item 9, between failsafe and flight controller tuning); shifted tuning to item 10 and Standard Install to item 11.

## 2026-06-30
- Renamed `docs/maiden-flight-checklist.md` to `docs/build-checklist.md` ("Build and Configuration Checklist") to reflect that retention and configuration items are ongoing, not specific to the maiden flight. Split the single build table into category sections (Airframe and Structural, Avionics Installation, Sensors, RC and Telemetry, Power System, GPS, Fasteners and Retention Checks) ahead of the existing Configure and Tune section, each with its own local numbering. Updated all cross-references in `README.md`, `docs/project-overview.md`, `docs/ICD.md`, `docs/manual.md`, `context/project-overview.md`, `context/startup-prompt.md`, and `params/parameter-change-log.md`.
- Added `docs/assets/motor-rotation-direction.png` (moved from the repo working directory, renamed from "ChatGPT Image Jun 30, 2026, 11_38_17 AM.png"): diagram showing motor rotation viewed from behind the aircraft looking forward (LHS counterclockwise, RHS clockwise). Linked from the pre-flight checklist in `docs/manual.md`.
- Renamed `docs/manual.md` section 6 from "Maiden Flight Procedure" to "Pre-Flight Checklist" and replaced its content with a 21-step ordered pre-flight sequence: unboxing/inspection, assembly, antenna installation, GPS installation and connection, RC power-on and safety check, battery installation and CG check, ground station connection sequence, calibration, warnings/battery sufficiency checks, propeller-removed arming test, control surface trim/travel verification, Stabilized-mode response check, motor rotation direction verification, flight mode entry verification (cross-referenced to the existing GX12 switch and QGC flight-modes-config diagrams), propeller installation, and GPS fix quality check. Updated references to this section in `context/project-overview.md` and `context/startup-prompt.md` accordingly.
- Rewrote `docs/maiden-flight-checklist.md`: updated item 11 (paint) status to Not started; expanded Configure and Tune (was a single row) into a dedicated section with 10 sub-items covering battery/power, sensor calibration, airspeed, GPS, motors/ESCs, control surfaces, RC/flight modes, failsafe, PID tuning, and Standard Install; merged Additional Pre-Flight Items into the main table (items 12-18) including new items for ZED-F9P external mount, avionics bay bolt torque, and GPS mounting bolt torque; marked Configure and Tune and Standard Install as In progress.
- Updated `docs/purchase-history.md`: converted USD totals to AUD at the historical rate on date of purchase (1 USD = 1.379 AUD on 2026-05-10; source: RBA/financial market rates) - MATEKSYS PDB $31.17 USD = $42.98 AUD, LiPo straps $10.08 USD = $13.90 AUD. University total updated to $981.08 AUD (from $924.20 AUD + $41.25 USD). Added funding summary header: $1,379.00 AUD allocated, $981.08 AUD spent, $397.92 AUD remaining.
- Added `supporting-documents/QUTAS Fixed Wing Drone Funding Application SIGNED.pdf` - the signed EER club activity funding application (signed 2026-05-20/21, $689.50 EER funding approved). Previously deleted before the policy of retaining signed reference documents was established.

- Updated `docs/purchase-history.md`: added **Paid By** (University / Julian personal) and **Installed** columns; removed Status column (redundant with Installed); confirmed all items in the table as purchased, removing the Shortlisted status category; updated unit prices from current shopping data (GX12: $349.99 → $329.99 AUD; Turnigy LiPo: $93.23 → $145.57 AUD; PM06 V2: $29.50 → $20.99 AUD); added 5% shipping estimate on items without invoiced actuals; corrected GX12 Installed status to Yes (in use as part of the operating system). Verified via RadioMaster product page that "Iron Grey" is the official color name - no change required.
- Restructured `context/`: created `startup-prompt.md` (single AI bootstrapping entry point), `project-overview.md` (project state + repo file map), `style-guide.md` (document writing standards extracted from `directives.md`), and `academic-integrity.md` (QUT conduct and AI use policy, researched from QUT MOPP). Moved CHANGELOG here from repo root.
- Updated `context/directives.md`: extracted document style guidance into `context/style-guide.md`; updated CHANGELOG location reference.
- Updated `context/MEMORY.md` to index new context files.
- Updated `CLAUDE.md` and `README.md` to reference updated context structure.

## 2026-06-22
- Added `GX12 Backup/`: full EdgeTX SD card backup for the Radiomaster GX12 transmitter (model config, radio config, firmware, stock assets), kept in full for restore capability. Added `params/believer-parameters.params`, a full PX4 parameter dump.
- Cross-checked the radio backup's model mixer against the documented RC channel map (`docs/ICD.md`, `docs/manual.md`, `params/parameter-change-log.md`) - confirmed CH5–CH11 assignments and found CH12 carries the SH switch via the radio mixer with no PX4 function currently assigned. Updated `docs/ICD.md` INT-03 accordingly and added `docs/assets/flight-modes-config.png` (QGC Flight Modes Config screenshot). Logged the still-undecided CH12/SH function in `context/open-items.md`.
- Corrected INT-08/`purchase-history.md`/`project-notes.md`: the transmitter in use is the Radiomaster GX12 **Crush** (Iron Grey), reversing the 2026-06-21 note that it was not the Crush variant.
- Added annotated front and top-view diagrams of the GX12 showing each physical switch's function (`docs/assets/gx12-front-switches.png`, `docs/assets/gx12-top-switches.png`), sourced from RadioMaster's official product photography and cross-checked against the radio backup's switch config and an EdgeTX teardown review. Wired into `docs/ICD.md` INT-03.
- Expanded the root `README.md` with a full repo content overview and an explanation of the `context/` memory files for AI-assisted editing.
- Added `context/authorities.md`: a durable log of standing authorities granted to Claude, since `.claude/settings.local.json` (the actual permission file) is gitignored/local-only. Added a session-start check in `CLAUDE.md` so Claude asks whether to sync any authorities not yet reflected in local settings.
- Re-annotated the GX12 diagrams: each GR1 button now gets its own label (SW1–SW6 with PX4 mode) instead of one group label, and the two unmapped sliders are no longer annotated.
- Added `Component datasheets/radiomaster-gx12-manual.pdf` (official RadioMaster GX12 user manual) - overriding the ground-side-equipment exclusion in `context/directives.md` for this one item, given how heavily the GX12's switch layout is referenced elsewhere in the docs.

## 2026-06-21
- Set up repo structure: `README.md`, `.gitignore`, `docs/`, `params/`, `context/`.
- Added `context/` as the in-repo working memory for the project (`MEMORY.md`, `project-notes.md`, `directives.md`, `open-items.md`), wired into `CLAUDE.md` so it loads automatically.
- Extracted `Believer Checklist.docx` into Markdown: `docs/ICD.md` (first draft), `docs/maiden-flight-checklist.md`, `context/project-notes.md`, and diagrams under `docs/assets/`. Removed the source `.docx` once content was captured.
- Added `docs/purchase-history.md` template for tracking component purchases.
- Added `docs/project-overview.md` describing the project and its purpose.
- Resolved most ICD open items against `Believer Project Proposal.docx`, `QUTAS Fixed Wing Drone Funding Application SIGNED.docx`, `Shopping List 27_02_26.xlsx`, and `believer_PX4_Parameter_Change_Log.xlsx`: confirmed PDB (Holybro PM06 V2), GPS protocols, telemetry baud rates, and GX12's role as the RC transmitter. Captured the parameter baseline in `params/parameter-change-log.md`.
- Documented today's RC channel/switch remap (GX12 + DBR4, ELRS Hybrid mode with MAVLink): arm moved Channel 10→5, kill moved Channel 8→7, flight-mode selector (GR1) moved Channel 13→6 (CH13+ not carried in Hybrid mode). Full channel map and GR1→PX4 mode mapping added to `docs/ICD.md` and `params/parameter-change-log.md`.
- Created `docs/manual.md`: flight modes, flaperon guidance, pre-flight safety state, and maiden flight procedure.
- Populated `docs/purchase-history.md` from the shopping list and funding application budget.
- Removed all source documents (`Believer Project Proposal.docx`, `QUTAS Fixed Wing Drone Funding Application SIGNED.docx`, `Shopping List 27_02_26.xlsx`, `believer_PX4_Parameter_Change_Log.xlsx`, `GX12 Logical Switch Setup.pdf`) once their content was captured in the Markdown docs above.
- Confirmed the fitted battery is the Turnigy Graphene Professional 8000mAh 6S 15C LiPo Pack, not the 2200mAh 6S 60C pack from the original funding application budget. Updated `docs/ICD.md`, `docs/purchase-history.md`, and `context/`.
- Added `invoices/` folder; moved in and renamed three invoices (RP-SMA cable, LiPO battery straps, MATEKSYS PDB FCHUB-12S V2), linked from `docs/purchase-history.md`. Confirmed via invoice that the MATEKSYS PDB was purchased but is not the unit in use - the Holybro PM06 V2 is fitted instead.
- Restructured: moved `invoices/` to `supporting-documents/invoices/`. Added the original project proposal PDF to `supporting-documents/` (kept, not deleted - proposals/funding applications are now retained as reference material; only scratch/working source docs get deleted after extraction). Added the proposal's timeline table to `docs/project-overview.md` and noted its original $1,030 budget (pre-PDB/straps) in `docs/purchase-history.md`.
- Corrected: the Radiomaster GX12 in use is **not** the "Crush" variant, despite that name appearing on the shopping list. Fixed in `docs/ICD.md`, `docs/purchase-history.md`, and `context/project-notes.md`.
- Added invoice for the Holybro PM03D power module (purchased 2026-05-11 with personal funds) - confirmed as the unit actually installed, providing battery telemetry and 5V servo rail power. Corrected `docs/ICD.md` INT-01, `docs/purchase-history.md`, and `context/project-notes.md`: neither the Holybro PM06 V2 nor the MATEKSYS PDB (previously assumed/noted) is the fitted unit. The PM06 V2 was specifically rejected because its power telemetry format is not accepted by the Pixhawk.
- Confirmed GPS routing (M8N on GPS1 UART as primary, ZED-F9P on GPS2 UART) and flagged the ZED-F9P's missing RTK antenna as a maiden flight blocker.
- Rewrote `docs/ICD.md` as a clean engineering document; moved provenance/decision narration into `context/project-notes.md`. Added a directive to keep `docs/` documents professional going forward.
- Added `Component datasheets/` with manufacturer datasheets/manuals for the components currently installed in the aircraft: RFD900x, Radiomaster DBR4, u-blox NEO-M8N, u-blox ZED-F9P, MS4525DO, and Holybro PM03D. Confirmed the flight controller is a Pixhawk 6X (no standalone PDF datasheet exists for it, or for the Turnigy battery - both are web-docs/product-page only).
