SpicyTenderloin/believer/docs/assets/livery/out/print/proof-sheet-A3.pdf

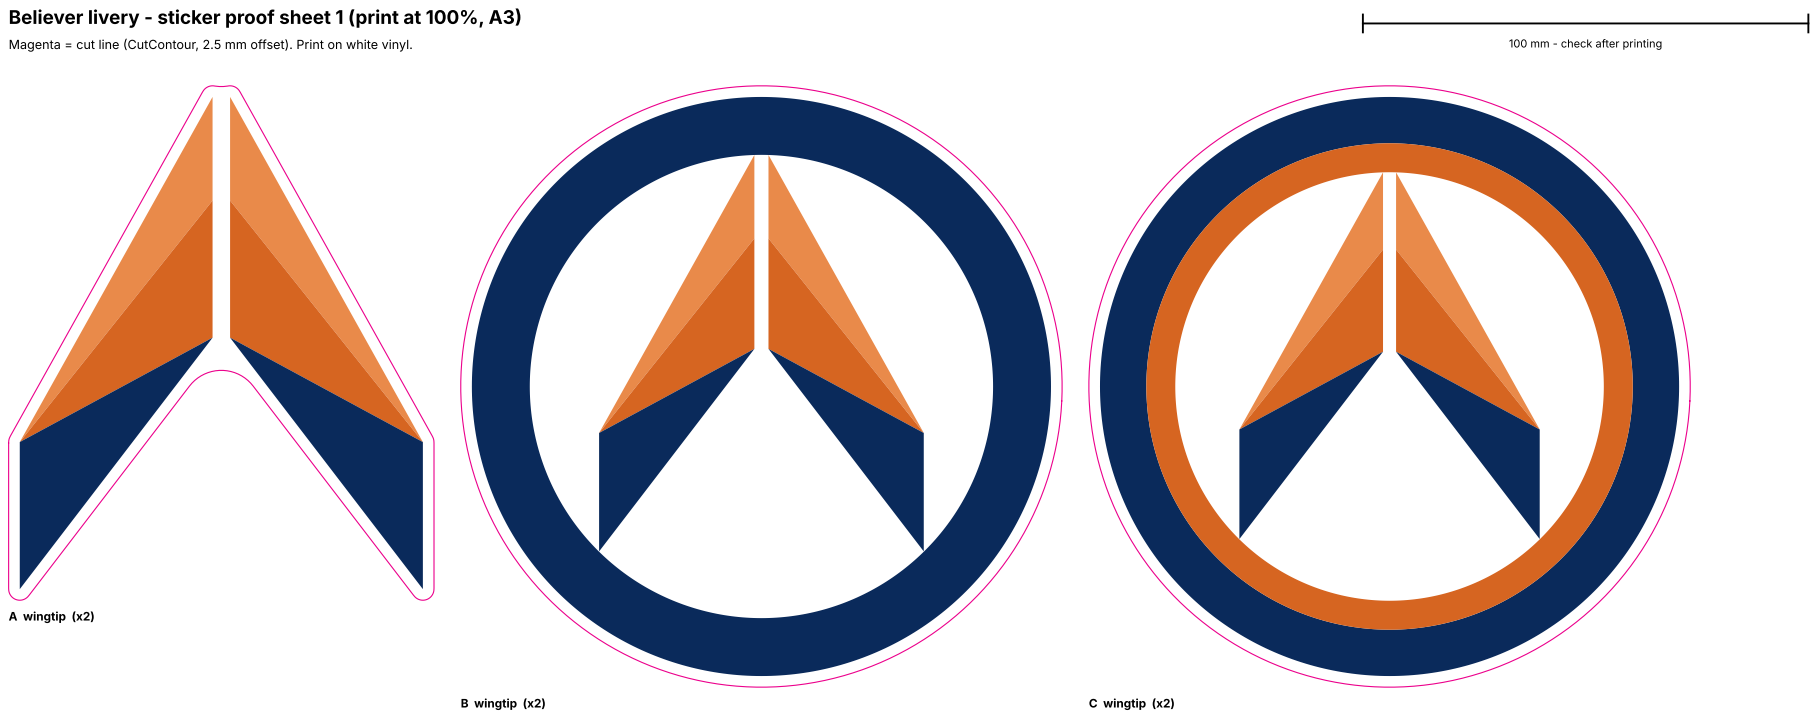
[picture p69: page 1]
Magenta = cut line (CutContour, 2.5 mm offset). Print on white vinyl.; 100 mm - check after printing; A wingtip (x2); B wingtip (x2); C wingtip (x2)

Believer livery - sticker proof sheet 1 (print at 100%, A3)

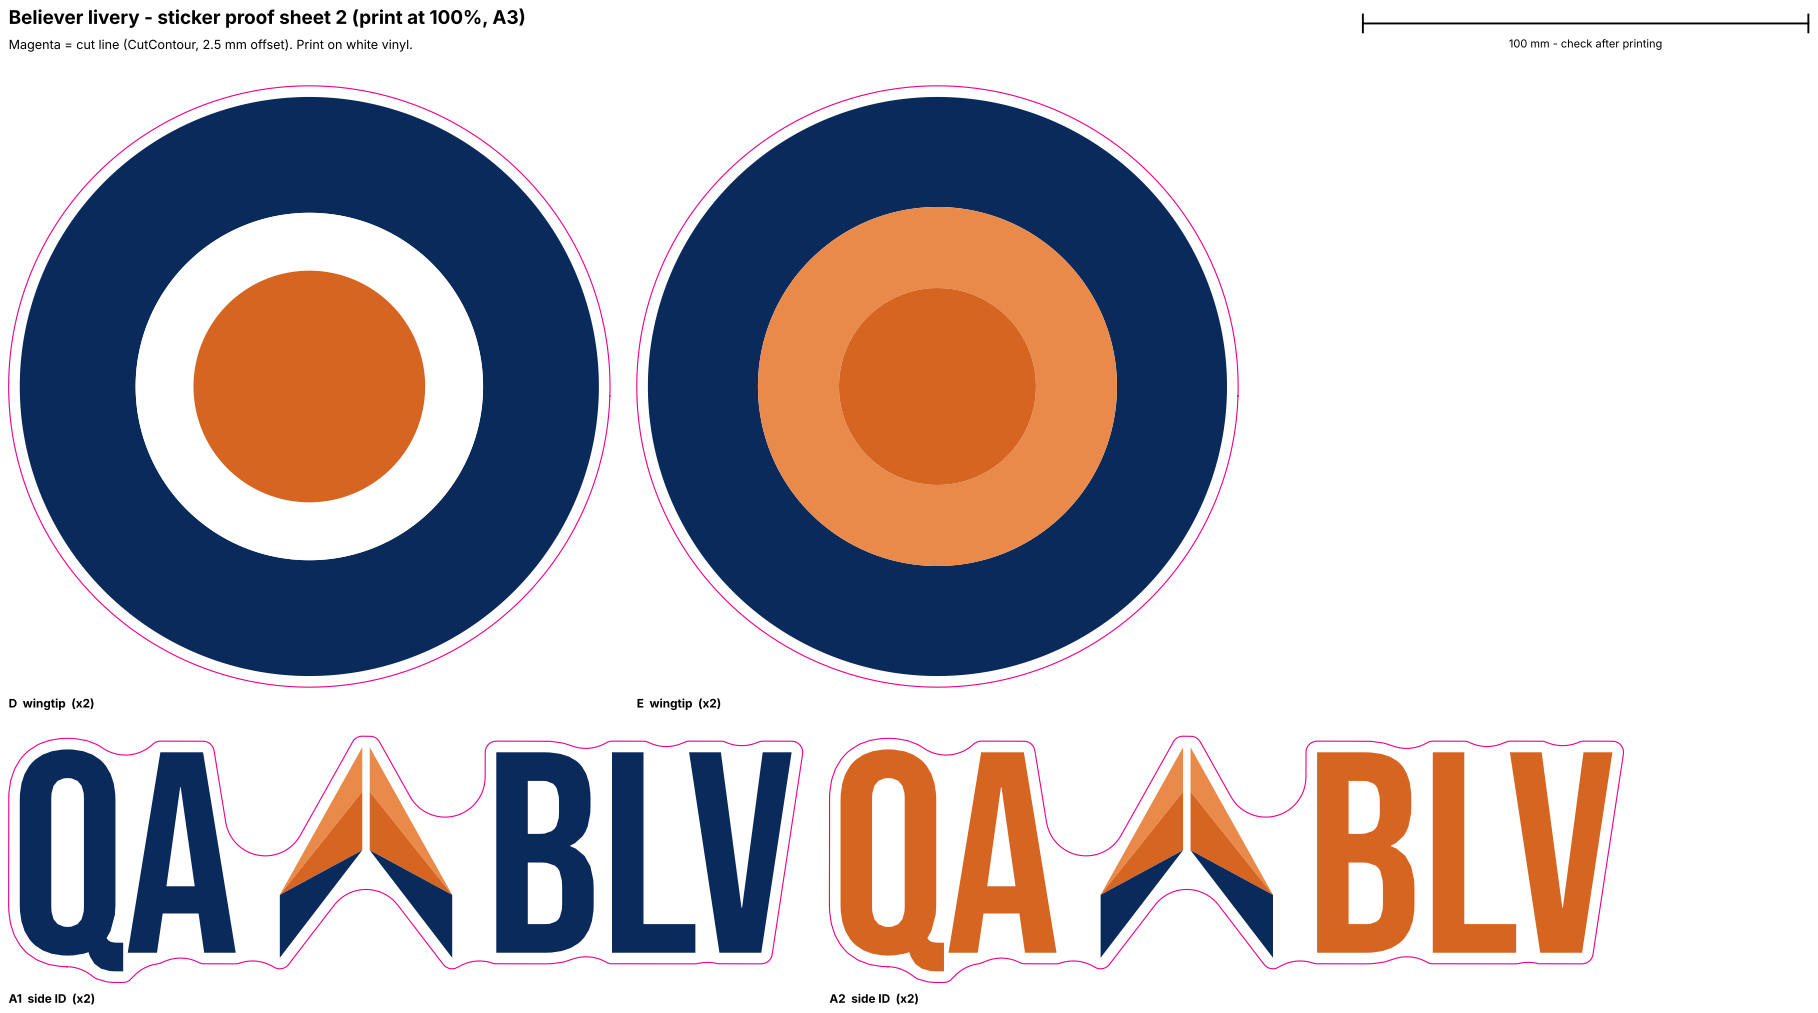
[picture p70: page 2]
D wingtip (x2); E wingtip (x2); A1 side ID (x2); A2 side ID (x2)

Believer livery - sticker proof sheet 2 (print at 100%, A3)

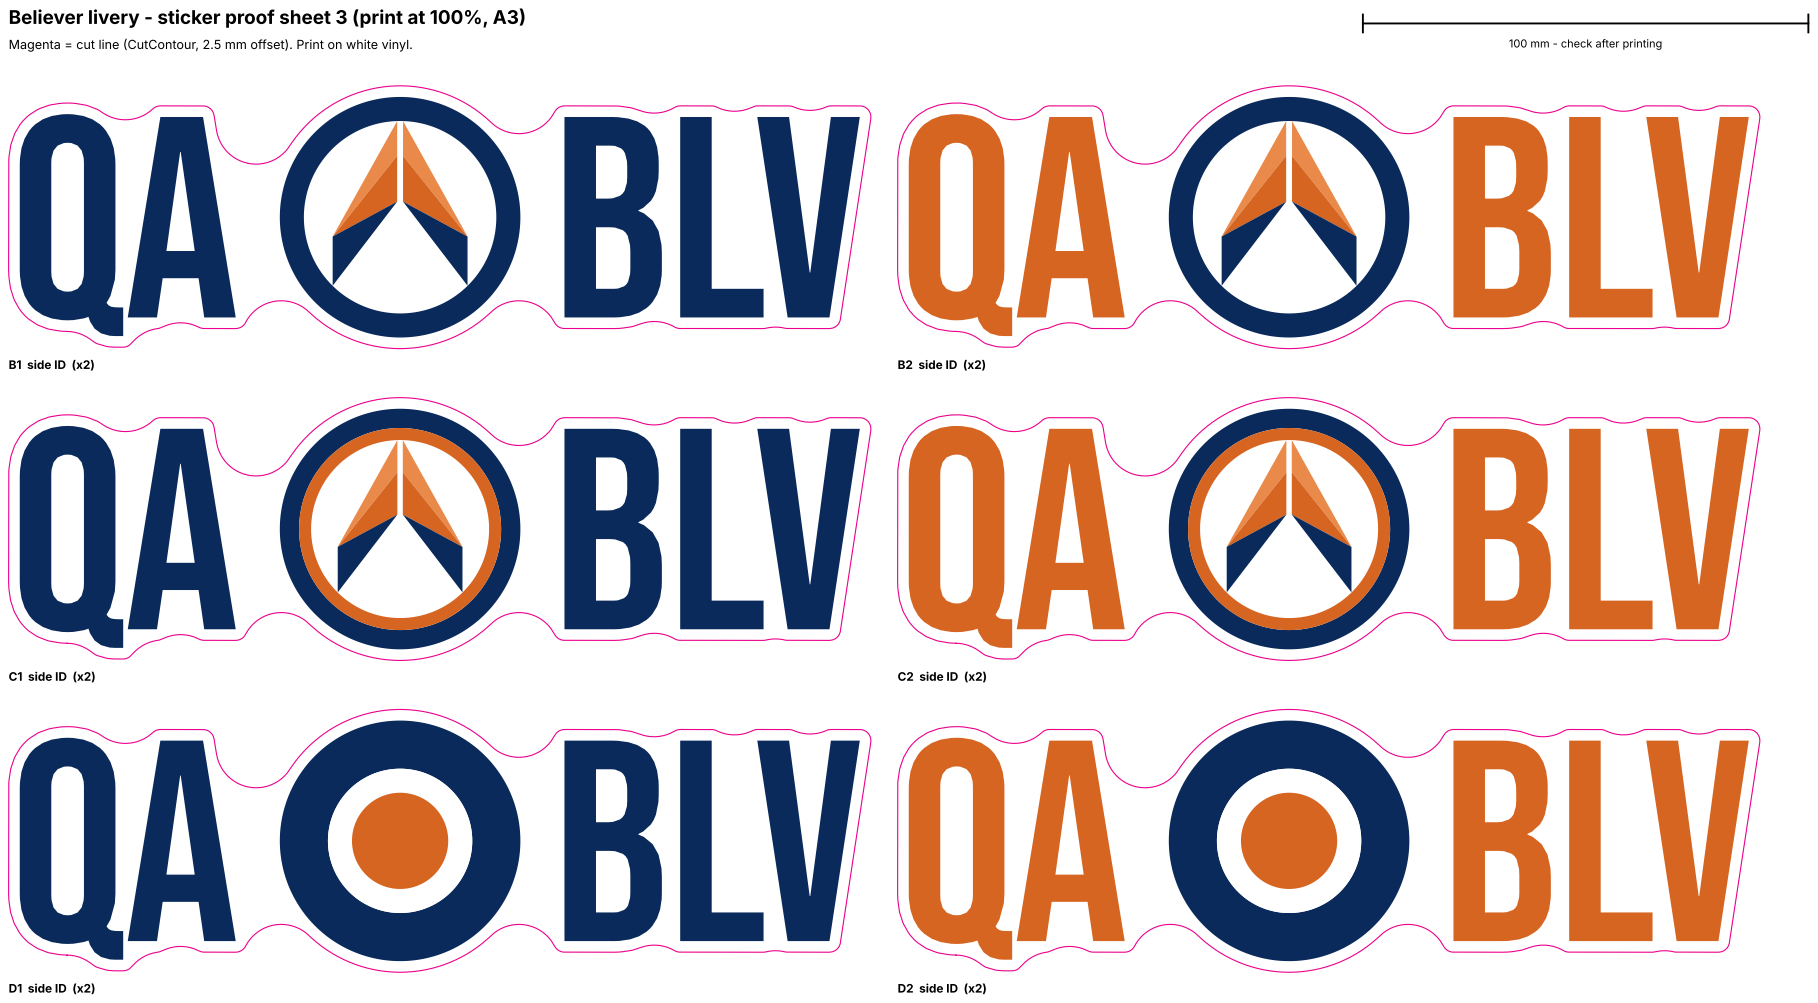
[picture p71: page 3]
B1 side ID (x2); B2 side ID (x2); C1 side ID (x2); C2 side ID (x2); D1 side ID (x2); D2 side ID (x2)

Believer livery - sticker proof sheet 3 (print at 100%, A3)

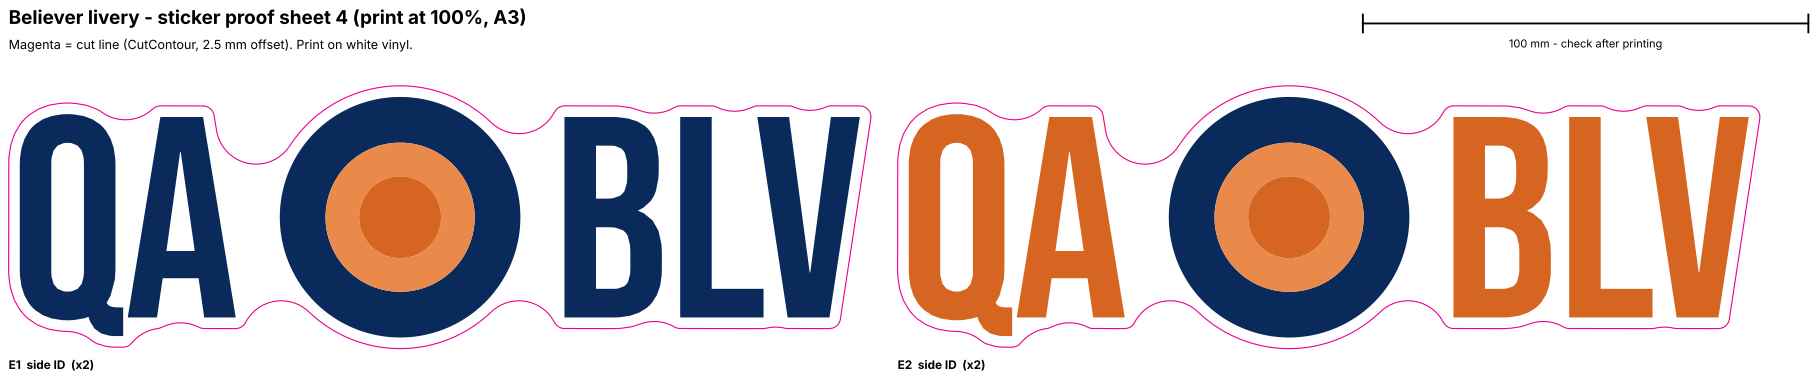
[picture p72: page 4]
E1 side ID (x2); E2 side ID (x2)

Believer livery - sticker proof sheet 4 (print at 100%, A3)
