SpicyTenderloin/believer/docs/assets/livery/out/print/id-B1.pdf

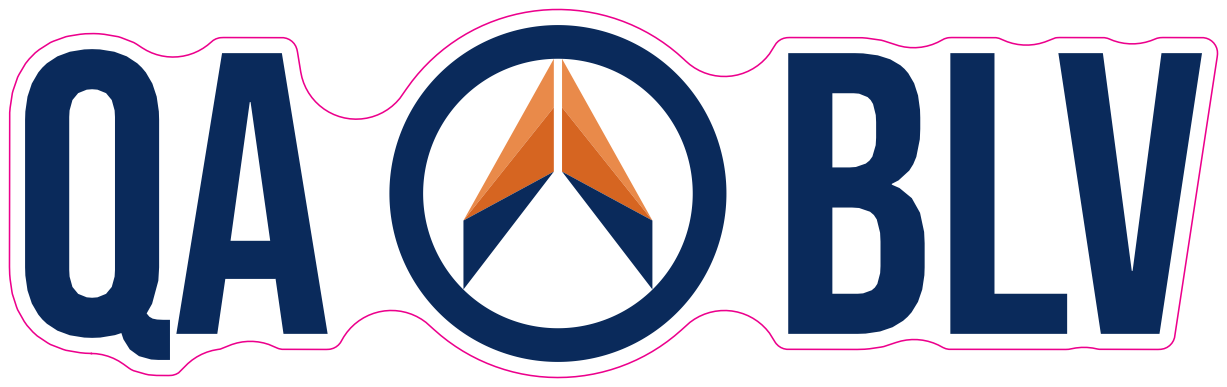
[picture p73: page 1]
