SpicyTenderloin/believer/docs/assets/livery/out/print/id-B2.pdf

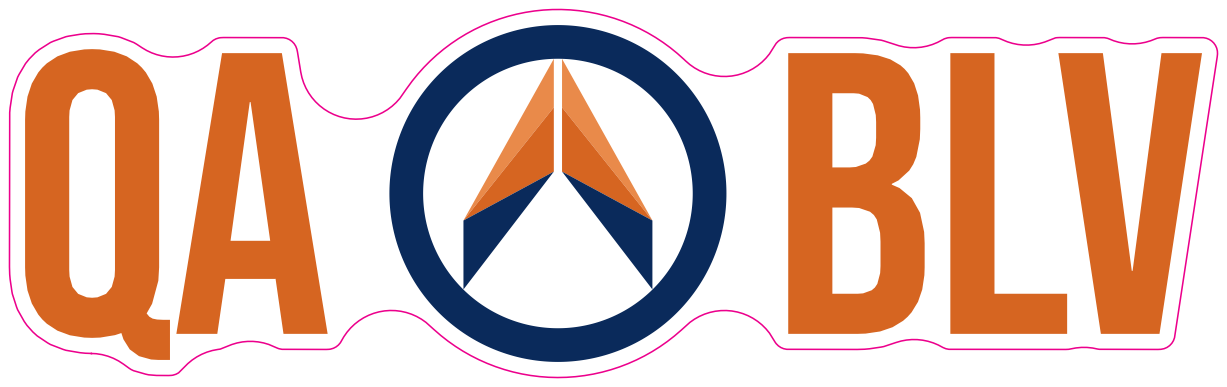
[picture p74: page 1]
