SpicyTenderloin/believer/docs/assets/livery/out/print/id-C1.pdf

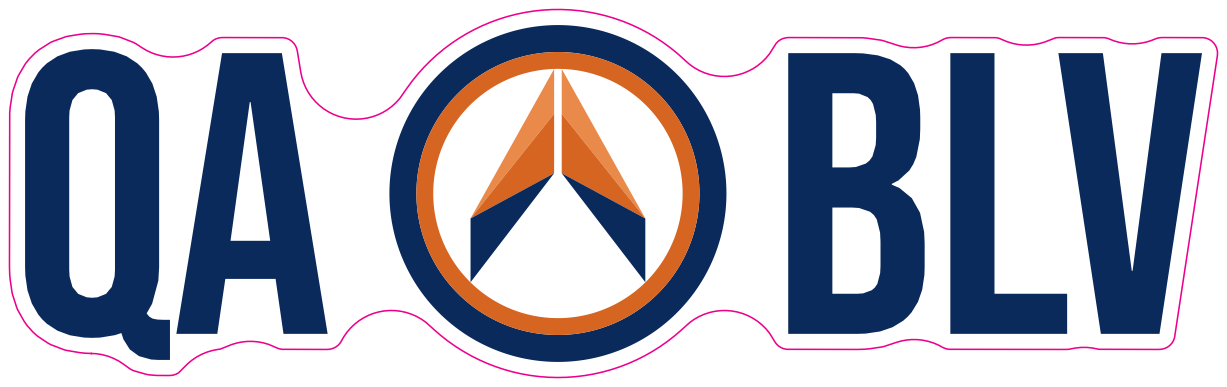
[picture p75: page 1]
