SpicyTenderloin/believer/docs/assets/livery/out/print/id-C2.pdf

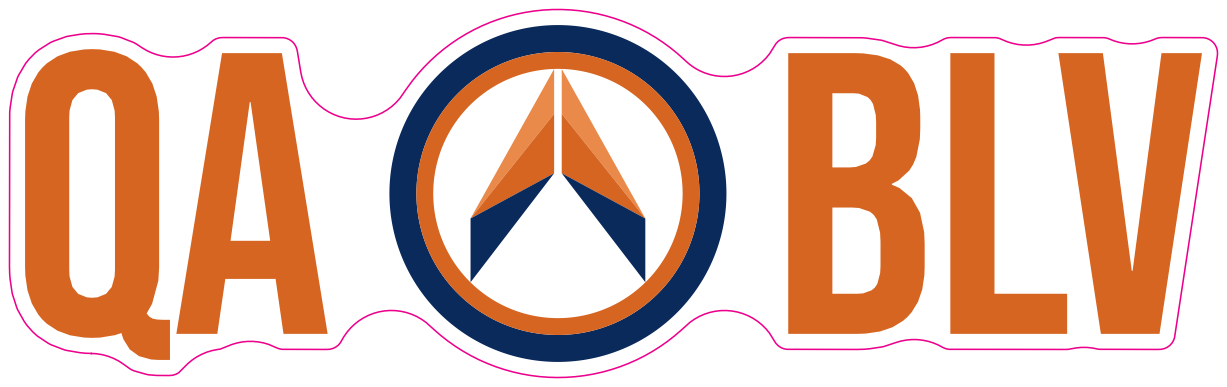
[picture p76: page 1]
