SpicyTenderloin/believer/docs/assets/livery/out/print/id-D1.pdf

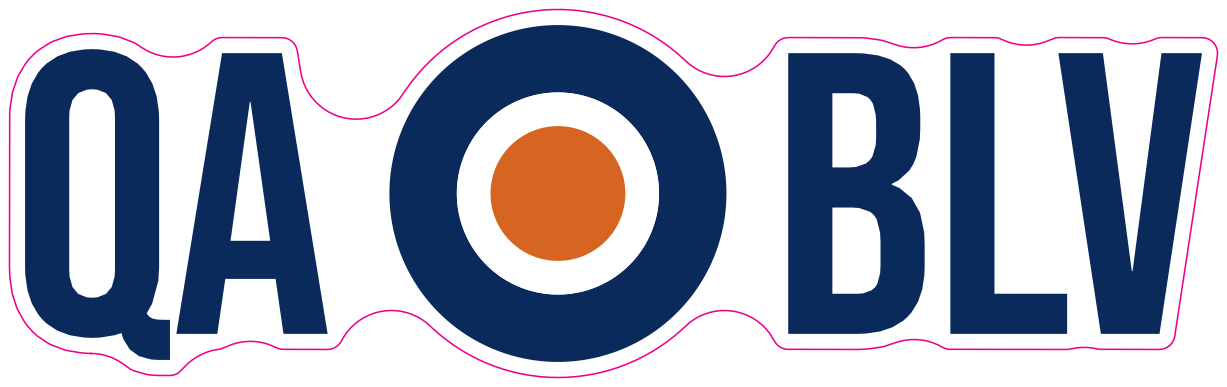
[picture p77: page 1]
