SpicyTenderloin/believer/docs/assets/livery/out/print/id-D2.pdf

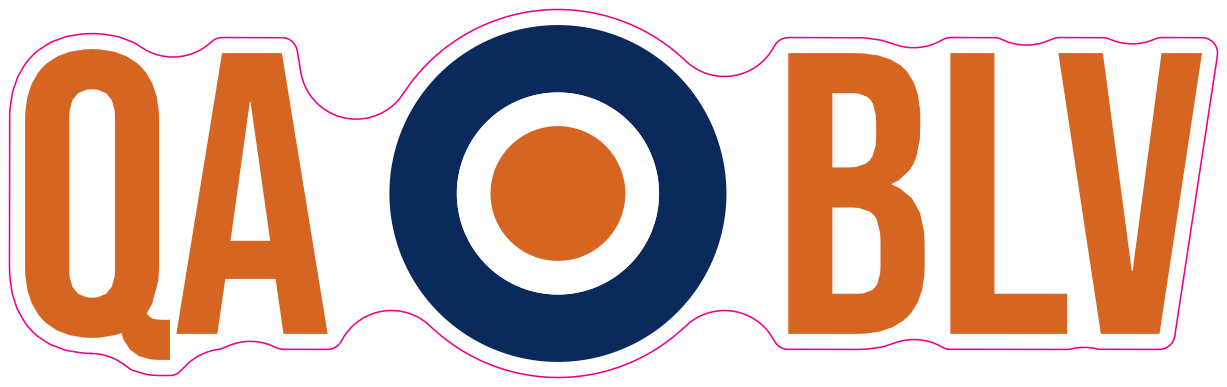
[picture p78: page 1]
