SpicyTenderloin/believer/docs/assets/livery/out/print/id-E1.pdf

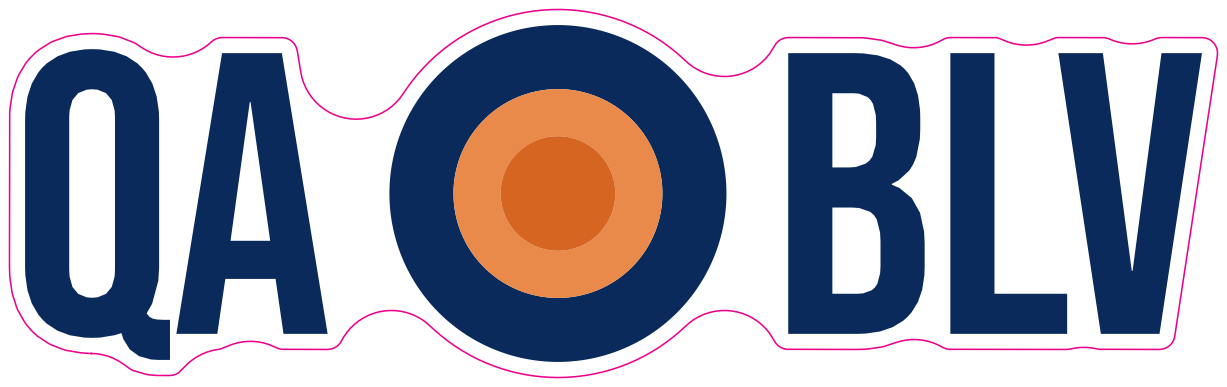
[picture p79: page 1]
