SpicyTenderloin/believer/docs/assets/livery/out/print/id-E2.pdf

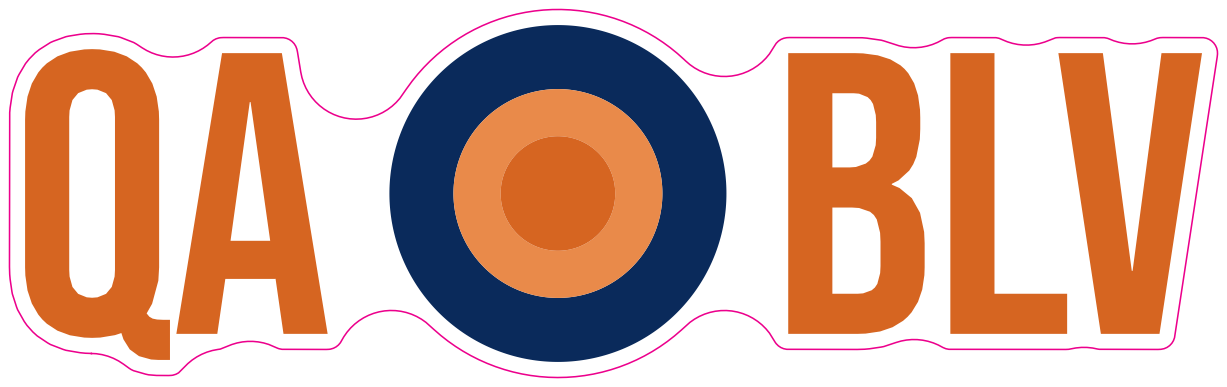
[picture p80: page 1]
