SpicyTenderloin/believer/docs/assets/livery/out/print/wingtip-C.pdf

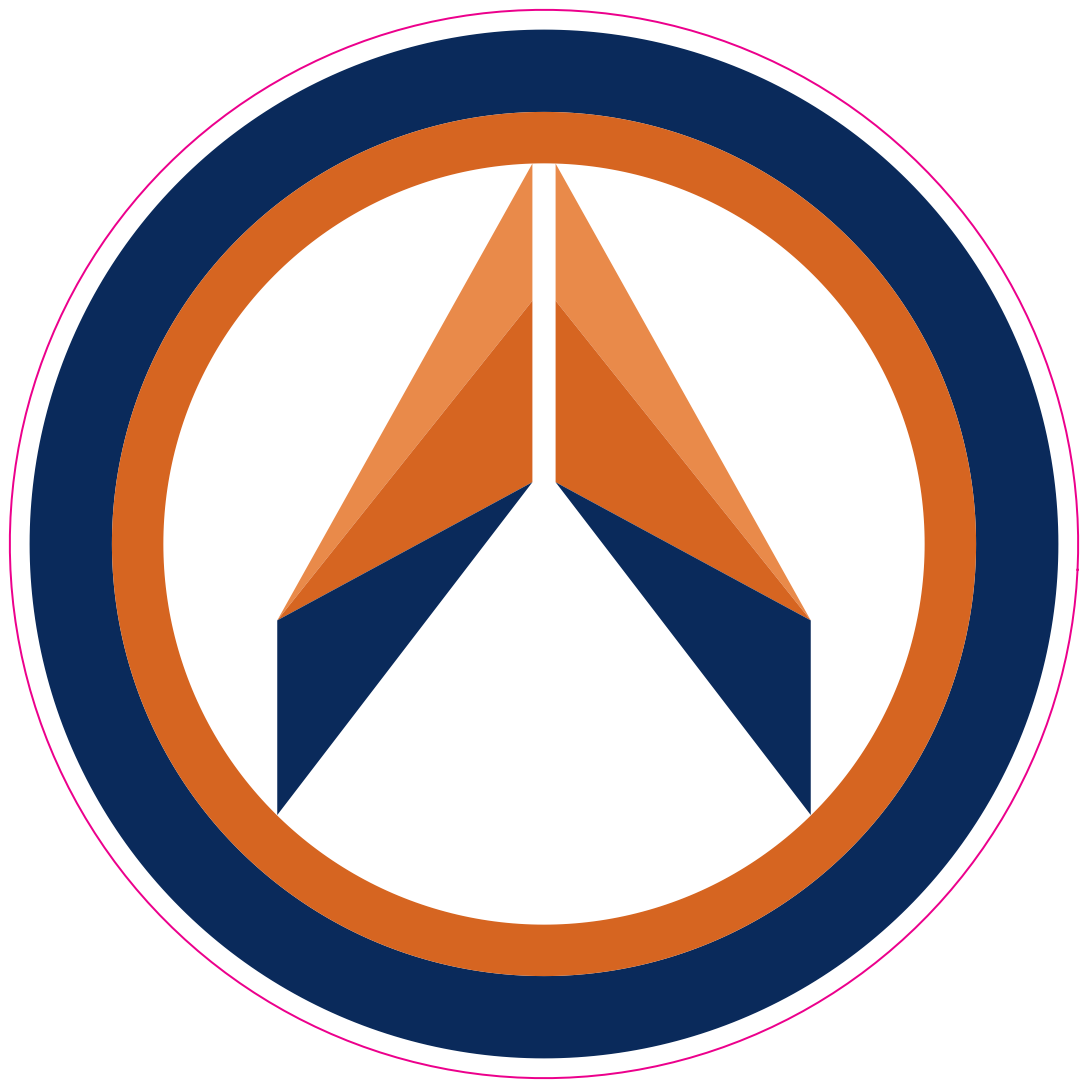
[picture p81: page 1]
