SpicyTenderloin/believer/docs/assets/livery/out/print/wingtip-D.pdf

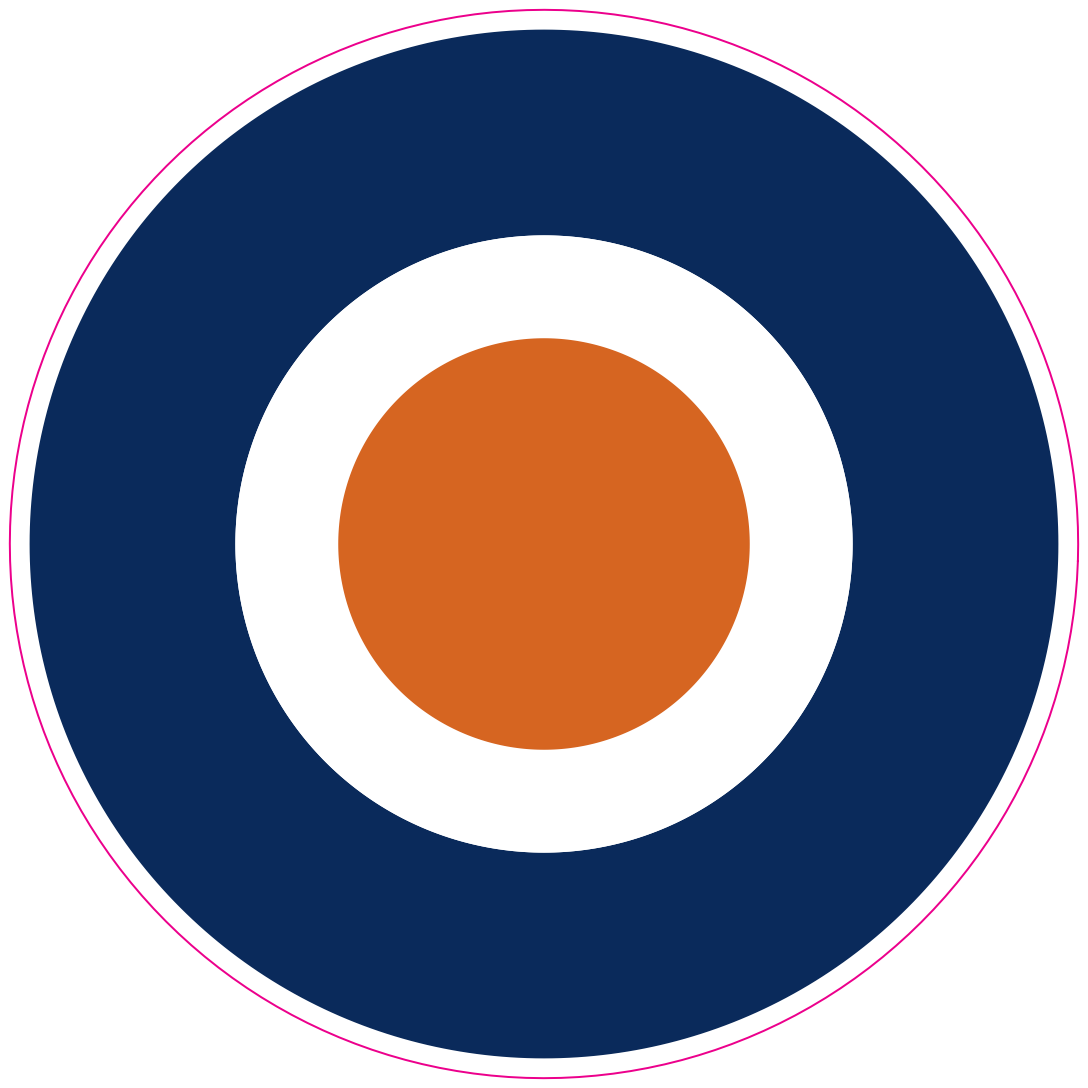
[picture p82: page 1]
