SpicyTenderloin/believer/docs/assets/livery/out/print/wingtip-E.pdf

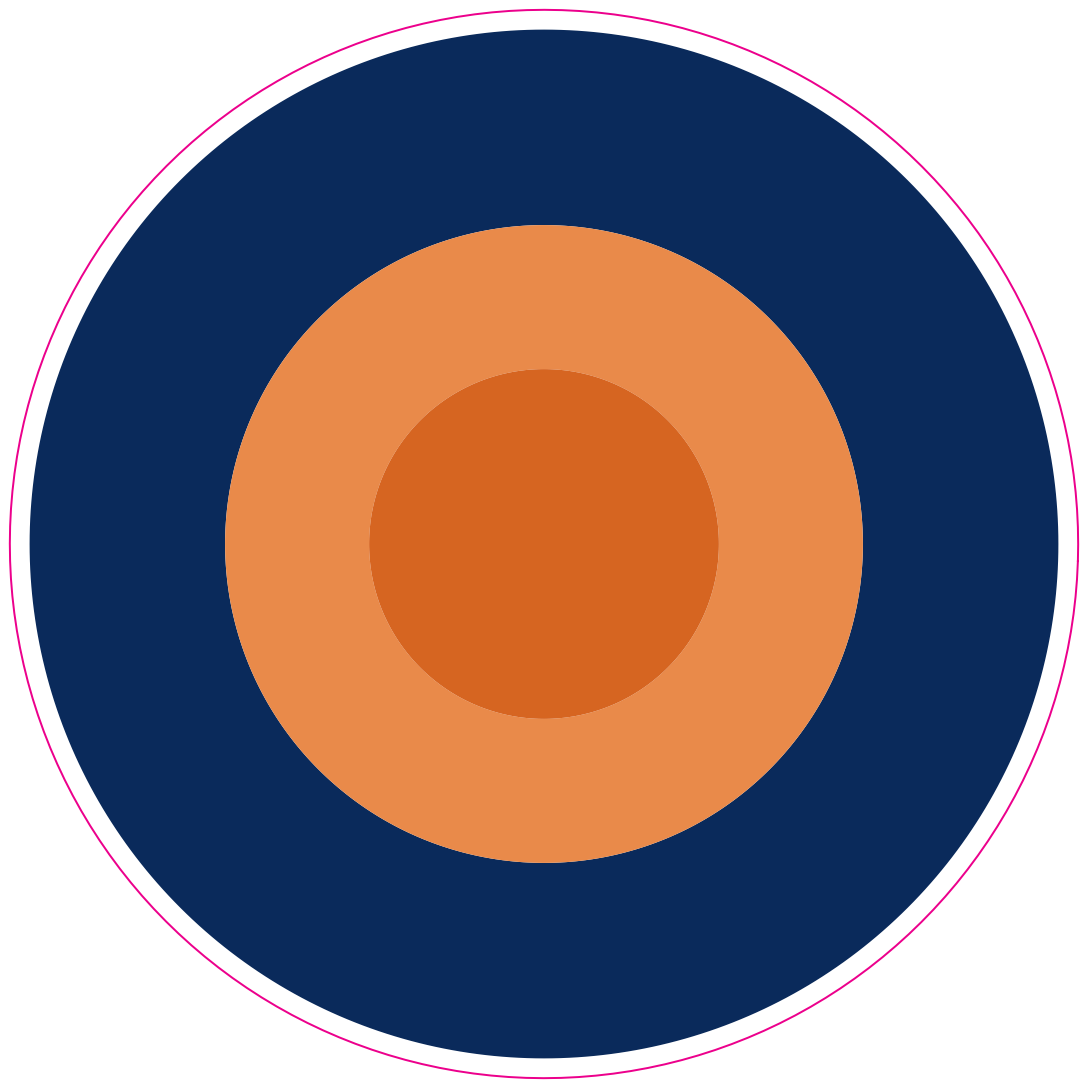
[picture p83: page 1]
