SpicyTenderloin/believer/docs/operations/Pixhawk Parameter Backup/believer-parameters.params

1	1	BAT1_A_PER_V	-1.000000000000000000	9
1	1	BAT1_CAPACITY	-1.000000000000000000	9
1	1	BAT1_I_CHANNEL	-1	6
1	1	BAT1_I_OVERWRITE	0.000000000000000000	9
1	1	BAT1_N_CELLS	6	6
1	1	BAT1_R_INTERNAL	-1.000000000000000000	9
1	1	BAT1_SOURCE	0	6
1	1	BAT1_V_CHANNEL	-1	6
1	1	BAT1_V_CHARGED	4.050000190734863281	9
1	1	BAT1_V_DIV	-1.000000000000000000	9
1	1	BAT1_V_EMPTY	3.200000047683715820	9
1	1	BAT2_A_PER_V	-1.000000000000000000	9
1	1	BAT2_CAPACITY	-1.000000000000000000	9
1	1	BAT2_I_CHANNEL	-1	6
1	1	BAT2_I_OVERWRITE	0.000000000000000000	9
1	1	BAT2_N_CELLS	0	6
1	1	BAT2_R_INTERNAL	-1.000000000000000000	9
1	1	BAT2_SOURCE	-1	6
1	1	BAT2_V_CHANNEL	-1	6
1	1	BAT2_V_CHARGED	4.050000190734863281	9
1	1	BAT2_V_DIV	-1.000000000000000000	9
1	1	BAT2_V_EMPTY	3.599999904632568359	9
1	1	BAT_AVRG_CURRENT	15.000000000000000000	9
1	1	BAT_CRIT_THR	0.100000001490116119	9
1	1	BAT_EMERGEN_THR	0.050000000745058060	9
1	1	BAT_LOW_THR	0.200000002980232239	9
1	1	BAT_V_OFFS_CURR	0.000000000000000000	9
1	1	CA_AIRFRAME	1	6
1	1	CA_ROTOR0_CT	6.500000000000000000	9
1	1	CA_ROTOR0_KM	0.050000000745058060	9
1	1	CA_ROTOR0_PX	0.300000011920928955	9
1	1	CA_ROTOR0_PY	0.000000000000000000	9
1	1	CA_ROTOR0_PZ	0.000000000000000000	9
1	1	CA_ROTOR10_CT	6.500000000000000000	9
1	1	CA_ROTOR10_KM	0.050000000745058060	9
1	1	CA_ROTOR10_PX	0.000000000000000000	9
1	1	CA_ROTOR10_PY	0.000000000000000000	9
1	1	CA_ROTOR10_PZ	0.000000000000000000	9
1	1	CA_ROTOR11_CT	6.500000000000000000	9
1	1	CA_ROTOR11_KM	0.050000000745058060	9
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
1	1	PWM_MAIN_MIN1	1000	6
1	1	PWM_MAIN_MIN2	1000	6
1	1	PWM_MAIN_MIN3	1100	6
1	1	PWM_MAIN_MIN4	1000	6
1	1	PWM_MAIN_MIN5	1100	6
1	1	PWM_MAIN_MIN6	1000	6
1	1	PWM_MAIN_MIN7	1000	6
1	1	PWM_MAIN_MIN8	1000	6
1	1	PWM_MAIN_TIM0	50	6
1	1	PWM_MAIN_TIM1	50	6
1	1	PWM_MAIN_TIM2	50	6
1	1	SYS_AUTOSTART	2100	6
