SpicyTenderloin/believer/docs/operations/GX12 Radio Backup/MODELS/model00.yml

semver: 2.11.0
header: 
   name: "Believer"
timers: 
   0:
      start: 0
      swtch: "SD2"
      value: 0
      mode: ON
      countdownBeep: 0
      minuteBeep: 0
      persistent: 0
      countdownStart: 0
      showElapsed: 0
      extraHaptic: 0
      name: "Arm"
telemetryProtocol: 0
thrTrim: 0
noGlobalFunctions: 0
displayTrims: 2
ignoreSensorIds: 0
trimInc: 0
disableThrottleWarning: 0
displayChecklist: 0
extendedLimits: 1
extendedTrims: 0
throttleReversed: 0
enableCustomThrottleWarning: 0
disableTelemetryWarning: 0
showInstanceIds: 0
checklistInteractive: 0
customThrottleWarningPosition: 0
beepANACenter: 0
mixData: 
 -
   destCh: 0
   srcRaw: "I0"
   carryTrim: 0
   mixWarn: 0
   mltpx: ADD
   delayPrec: 0
   speedPrec: 0
   flightModes: 000000000
   weight: 100
   offset: 0
   swtch: "NONE"
   curve: 
      type: 1
      value: 30
   delayUp: 0
   delayDown: 0
   speedUp: 0
   speedDown: 0
   name: ""
 -
   destCh: 1
   srcRaw: "I1"
   carryTrim: 0
   mixWarn: 0
   mltpx: ADD
   delayPrec: 0
   speedPrec: 0
   flightModes: 000000000
   weight: 100
   offset: 0
   swtch: "NONE"
   curve: 
      type: 1
      value: 30
   delayUp: 0
   delayDown: 0
   speedUp: 0
   speedDown: 0
   name: ""
 -
   destCh: 2
   srcRaw: "I2"
   carryTrim: 0
   mixWarn: 0
   mltpx: ADD
   delayPrec: 0
   speedPrec: 0
   flightModes: 000000000
   weight: 100
   offset: 0
   swtch: "NONE"
   curve: 
      type: 1
      value: 0
   delayUp: 0
   delayDown: 0
   speedUp: 0
   speedDown: 0
   name: ""
 -
   destCh: 3
   srcRaw: "I3"
   carryTrim: 0
   mixWarn: 0
   mltpx: ADD
   delayPrec: 0
   speedPrec: 0
   flightModes: 000000000
   weight: 100
   offset: 0
   swtch: "NONE"
   curve: 
      type: 1
      value: 30
   delayUp: 0
   delayDown: 0
   speedUp: 0
   speedDown: 0
   name: ""
 -
   destCh: 4
   srcRaw: "SD"
   carryTrim: 0
   mixWarn: 0
   mltpx: ADD
   delayPrec: 0
   speedPrec: 0
   flightModes: 000000000
   weight: 100
   offset: 0
   swtch: "NONE"
   delayUp: 0
   delayDown: 0
   speedUp: 0
   speedDown: 0
   name: ""
 -
   destCh: 5
   srcRaw: "GR1"
   carryTrim: 0
   mixWarn: 0
   mltpx: ADD
   delayPrec: 0
   speedPrec: 0
   flightModes: 000000000
   weight: 100
   offset: 0
   swtch: "NONE"
   delayUp: 0
   delayDown: 0
   speedUp: 0
   speedDown: 0
   name: ""
 -
   destCh: 6
   srcRaw: "SF"
   carryTrim: 0
   mixWarn: 0
   mltpx: ADD
   delayPrec: 0
   speedPrec: 0
   flightModes: 000000000
   weight: -100
   offset: 0
   swtch: "NONE"
   delayUp: 0
   delayDown: 0
   speedUp: 0
   speedDown: 0
   name: ""
 -
   destCh: 7
   srcRaw: "SA"
   carryTrim: 0
   mixWarn: 0
   mltpx: ADD
   delayPrec: 0
   speedPrec: 0
   flightModes: 000000000
   weight: 100
   offset: 0
   swtch: "NONE"
   delayUp: 0
   delayDown: 0
   speedUp: 0
   speedDown: 0
   name: ""
 -
   destCh: 8
   srcRaw: "SB"
   carryTrim: 0
   mixWarn: 0
   mltpx: ADD
   delayPrec: 0
   speedPrec: 0
   flightModes: 000000000
   weight: -100
   offset: 0
   swtch: "NONE"
   delayUp: 0
   delayDown: 0
   speedUp: 0
   speedDown: 0
   name: ""
 -
   destCh: 9
   srcRaw: "SC"
   carryTrim: 0
   mixWarn: 0
   mltpx: ADD
   delayPrec: 0
   speedPrec: 0
   flightModes: 000000000
   weight: -100
   offset: 0
   swtch: "NONE"
   delayUp: 0
   delayDown: 0
   speedUp: 0
   speedDown: 0
   name: ""
 -
   destCh: 10
   srcRaw: "SE"
   carryTrim: 0
   mixWarn: 0
   mltpx: ADD
   delayPrec: 0
   speedPrec: 0
   flightModes: 000000000
   weight: -100
   offset: 0
   swtch: "NONE"
   delayUp: 0
   delayDown: 0
   speedUp: 0
   speedDown: 0
   name: ""
 -
   destCh: 11
   srcRaw: "SH"
   carryTrim: 0
   mixWarn: 0
   mltpx: ADD
   delayPrec: 0
   speedPrec: 0
   flightModes: 000000000
   weight: 100
   offset: 0
   swtch: "NONE"
   delayUp: 0
   delayDown: 0
   speedUp: 0
   speedDown: 0
   name: ""
 -
   destCh: 13
   srcRaw: "SL1"
   carryTrim: 0
   mixWarn: 0
   mltpx: ADD
   delayPrec: 0
   speedPrec: 0
   flightModes: 000000000
   weight: 100
   offset: 0
   swtch: "NONE"
   delayUp: 0
   delayDown: 0
   speedUp: 0
   speedDown: 0
   name: ""
 -
   destCh: 14
   srcRaw: "SL2"
   carryTrim: 0
   mixWarn: 0
   mltpx: ADD
   delayPrec: 0
   speedPrec: 0
   flightModes: 000000000
   weight: 100
   offset: 0
   swtch: "NONE"
   delayUp: 0
   delayDown: 0
   speedUp: 0
   speedDown: 0
   name: ""
expoData: 
 -
   mode: 3
   scale: 0
   trimSource: 0
   srcRaw: "Ail"
   weight: 100
   offset: 0
   swtch: "SB2"
   curve: 
      type: 1
      value: 30
   chn: 0
   flightModes: 000000000
   name: ""
 -
   mode: 3
   scale: 0
   trimSource: 0
   srcRaw: "Ail"
   weight: 70
   offset: 0
   swtch: "SB1"
   curve: 
      type: 1
      value: 30
   chn: 0
   flightModes: 000000000
   name: ""
 -
   mode: 3
   scale: 0
   trimSource: 0
   srcRaw: "Ail"
   weight: 50
   offset: 0
   swtch: "SB0"
   curve: 
      type: 1
      value: 30
   chn: 0
   flightModes: 000000000
   name: ""
 -
   mode: 3
   scale: 0
   trimSource: 0
   srcRaw: "Ele"
   weight: 100
   offset: 0
   swtch: "SE2"
   curve: 
      type: 1
      value: 30
   chn: 1
   flightModes: 000000000
   name: ""
 -
   mode: 3
   scale: 0
   trimSource: 0
   srcRaw: "Ele"
   weight: 70
   offset: 0
   swtch: "SE1"
   curve: 
      type: 1
      value: 30
   chn: 1
   flightModes: 000000000
   name: ""
 -
   mode: 3
   scale: 0
   trimSource: 0
   srcRaw: "Ele"
   weight: 50
   offset: 0
   swtch: "SE0"
   curve: 
      type: 1
      value: 30
   chn: 1
   flightModes: 000000000
   name: ""
 -
   mode: 3
   scale: 0
   trimSource: 0
   srcRaw: "Thr"
   weight: 100
   offset: 0
   swtch: "NONE"
   curve: 
      type: 1
      value: 0
   chn: 2
   flightModes: 000000000
   name: ""
 -
   mode: 3
   scale: 0
   trimSource: 0
   srcRaw: "Rud"
   weight: 100
   offset: 0
   swtch: "NONE"
   curve: 
      type: 1
      value: 30
   chn: 3
   flightModes: 000000000
   name: ""
customFn: 
   0:
      swtch: "SD2"
      func: PLAY_TRACK
      def: "armed,1,1x"
   1:
      swtch: "SW12"
      func: PLAY_TRACK
      def: "manmod,1,1x"
   2:
      swtch: "SW22"
      func: PLAY_TRACK
      def: "acrmod,1,1x"
   3:
      swtch: "SW32"
      func: PLAY_TRACK
      def: "stabmo,1,1x"
   4:
      swtch: "SW42"
      func: PLAY_TRACK
      def: "althld,1,1x"
   5:
      swtch: "SW52"
      func: PLAY_TRACK
      def: "poshld,1,1x"
   6:
      swtch: "SW62"
      func: PLAY_TRACK
      def: "auto,1,1x"
   7:
      swtch: "SA2"
      func: PLAY_TRACK
      def: "loiter,1,1x"
   8:
      swtch: "SD0"
      func: RESET
      def: "Tmr1,1"
thrTraceSrc: Thr
switchWarning: 
   SD:
      pos: up
   SF:
      pos: down
rssiSource: none
rfAlarms: 
   warning: 65
   critical: 35
thrTrimSw: 0
potsWarnMode: WARN_OFF
jitterFilter: GLOBAL
moduleData: 
   0:
      type: TYPE_CROSSFIRE
      subType: 0
      channelsStart: 0
      channelsCount: 16
      failsafeMode: NOT_SET
      mod: 
         crsf: 
            telemetryBaudrate: 0
            crsfArmingMode: 0
            crsfArmingTrigger: "NONE"
            spare3: 0
trainerData: 
   mode: SLAVE
   channelsStart: 0
   channelsCount: 0
   frameLength: 0
   delay: 0
   pulsePol: 0
inputNames: 
   0:
      val: "Ail"
   1:
      val: "Ele"
   2:
      val: "Thr"
   3:
      val: "Rud"
potsWarnEnabled: 0
telemetrySensors: 
   0:
      id1: 
         id: 30
      id2: 
         instance: 0
      label: "Ptch"
      subId: 0
      type: TYPE_CUSTOM
      unit: 21
      prec: 2
      autoOffset: 0
      filter: 0
      logs: 1
      persistent: 0
      onlyPositive: 0
      cfg: 
         custom: 
            ratio: 0
            offset: 0
   1:
      id1: 
         id: 30
      id2: 
         instance: 1
      label: "Roll"
      subId: 0
      type: TYPE_CUSTOM
      unit: 21
      prec: 2
      autoOffset: 0
      filter: 0
      logs: 1
      persistent: 0
      onlyPositive: 0
      cfg: 
         custom: 
            ratio: 0
            offset: 0
   2:
      id1: 
         id: 30
      id2: 
         instance: 2
      label: "Yaw"
      subId: 0
      type: TYPE_CUSTOM
      unit: 21
      prec: 2
      autoOffset: 0
      filter: 0
      logs: 1
      persistent: 0
      onlyPositive: 0
      cfg: 
         custom: 
            ratio: 0
            offset: 0
   3:
      id1: 
         id: 20
      id2: 
         instance: 0
      label: "1RSS"
      subId: 0
      type: TYPE_CUSTOM
      unit: 17
      prec: 0
      autoOffset: 0
      filter: 0
      logs: 1
      persistent: 0
      onlyPositive: 0
      cfg: 
         custom: 
            ratio: 0
            offset: 0
   4:
      id1: 
         id: 20
      id2: 
         instance: 1
      label: "2RSS"
      subId: 0
      type: TYPE_CUSTOM
      unit: 17
      prec: 0
      autoOffset: 0
      filter: 0
      logs: 1
      persistent: 0
      onlyPositive: 0
      cfg: 
         custom: 
            ratio: 0
            offset: 0
   5:
      id1: 
         id: 20
      id2: 
         instance: 2
      label: "RQly"
      subId: 0
      type: TYPE_CUSTOM
      unit: 13
      prec: 0
      autoOffset: 0
      filter: 0
      logs: 1
      persistent: 0
      onlyPositive: 0
      cfg: 
         custom: 
            ratio: 0
            offset: 0
   6:
      id1: 
         id: 20
      id2: 
         instance: 3
      label: "RSNR"
      subId: 0
      type: TYPE_CUSTOM
      unit: 17
      prec: 0
      autoOffset: 0
      filter: 0
      logs: 1
      persistent: 0
      onlyPositive: 0
      cfg: 
         custom: 
            ratio: 0
            offset: 0
   7:
      id1: 
         id: 20
      id2: 
         instance: 4
      label: "ANT"
      subId: 0
      type: TYPE_CUSTOM
      unit: 0
      prec: 0
      autoOffset: 0
      filter: 0
      logs: 1
      persistent: 0
      onlyPositive: 0
      cfg: 
         custom: 
            ratio: 0
            offset: 0
   8:
      id1: 
         id: 20
      id2: 
         instance: 5
      label: "RFMD"
      subId: 0
      type: TYPE_CUSTOM
      unit: 0
      prec: 0
      autoOffset: 0
      filter: 0
      logs: 1
      persistent: 0
      onlyPositive: 0
      cfg: 
         custom: 
            ratio: 0
            offset: 0
   9:
      id1: 
         id: 20
      id2: 
         instance: 6
      label: "TPWR"
      subId: 0
      type: TYPE_CUSTOM
      unit: 16
      prec: 0
      autoOffset: 0
      filter: 0
      logs: 1
      persistent: 0
      onlyPositive: 0
      cfg: 
         custom: 
            ratio: 0
            offset: 0
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
usbJoystickCircularCut: 0
radioGFDisabled: GLOBAL
radioTrainerDisabled: GLOBAL
modelHeliDisabled: GLOBAL
modelFMDisabled: GLOBAL
modelCurvesDisabled: GLOBAL
modelGVDisabled: GLOBAL
modelLSDisabled: GLOBAL
modelSFDisabled: GLOBAL
modelCustomScriptsDisabled: GLOBAL
modelTelemetryDisabled: GLOBAL
