SpicyTenderloin/believer/docs/operations/GX12 Radio Backup/RADIO/radio.yml

checksum: 41921
manuallyEdited: 0
timezoneMinutes: 0
ppmunit: 0
semver: 2.11.0
board: gx12
calib: 
   LH:
      mid: 2048
      spanNeg: 1723
      spanPos: 1723
   LV:
      mid: 2048
      spanNeg: 1723
      spanPos: 1723
   RV:
      mid: 2048
      spanNeg: 1723
      spanPos: 1723
   RH:
      mid: 2048
      spanNeg: 1723
      spanPos: 1723
   P1:
      mid: 1006
      spanNeg: 991
      spanPos: 1025
   P2:
      mid: 1035
      spanNeg: 1019
      spanPos: 997
   SL1:
      mid: 1008
      spanNeg: 398
      spanPos: 433
   SL2:
      mid: 1036
      spanNeg: 449
      spanPos: 434
currModel: 0
contrast: 100
vBatWarn: 68
txVoltageCalibration: -13
backlightMode: backlight_mode_all
antennaMode: MODE_PER_MODEL
disableRtcWarning: 1
keysBacklight: 0
dontPlayHello: 0
internalModule: TYPE_CROSSFIRE
trainer: 
   mix: 
      0:
         srcChn: 0
         mode: REPL
         studWeight: 100
      1:
         srcChn: 1
         mode: REPL
         studWeight: 100
      2:
         srcChn: 2
         mode: REPL
         studWeight: 100
      3:
         srcChn: 3
         mode: REPL
         studWeight: 100
view: 0
fai: 0
beepMode: mode_all
alarmsFlash: 0
disableMemoryWarning: 0
disableAlarmWarning: 0
stickMode: 1
timezone: 0
adjustRTC: 0
inactivityTimer: 10
internalModuleBaudrate: 2
splashMode: 2
hapticMode: mode_nokeys
switchesDelay: 0
lightAutoOff: 12
templateSetup: 21
PPM_Multiplier: 0
hapticLength: 2
beepLength: 1
hapticStrength: 2
gpsFormat: 0
audioMuteEnable: 1
speakerPitch: 0
speakerVolume: 0
vBatMin: 64
vBatMax: 84
backlightBright: 0
globalTimer: 120724
bluetoothBaudrate: 0
bluetoothMode: OFF
countryCode: 0
pwrOnSpeed: 1
pwrOffSpeed: 1
noJitterFilter: 0
imperial: 0
disableRssiPoweroffAlarm: 0
USBMode: 0
jackMode: 0
ttsLanguage: "en"
beepVolume: 0
wavVolume: 4
varioVolume: 4
backgroundVolume: 3
varioPitch: 0
varioRange: 0
varioRepeat: 0
serialPort: 
   VCP:
      mode: CLI
      power: 0
potsConfig: 
   P1:
      type: with_detent
      inv: 0
      name: ""
   P2:
      type: with_detent
      inv: 0
      name: ""
   SL1:
      type: slider
      inv: 0
      name: ""
   SL2:
      type: slider
      inv: 0
      name: ""
switchConfig: 
   SA:
      type: 2pos
      name: ""
   SB:
      type: 3pos
      name: ""
   SC:
      type: 3pos
      name: ""
   SD:
      type: 2pos
      name: ""
   SE:
      type: 3pos
      name: ""
   SF:
      type: 3pos
      name: ""
   SG:
      type: toggle
      name: ""
   SH:
      type: toggle
      name: ""
backlightColor: 0
bluetoothName: ""
ownerRegistrationID: " 24P42P-"
rotEncMode: 0
uartSampleMode: 0
radioGFDisabled: 0
radioTrainerDisabled: 0
modelHeliDisabled: 0
modelFMDisabled: 0
modelCurvesDisabled: 0
modelGVDisabled: 0
modelLSDisabled: 0
modelSFDisabled: 0
modelCustomScriptsDisabled: 1
modelTelemetryDisabled: 0
disableTrainerPoweroffAlarm: 0
disablePwrOnOffHaptic: 0
invertLCD: 0
pwrOffIfInactive: 0
