SpicyTenderloin/believer/(commit log)

2026-06-21 Initial project setup: ICD, manual, purchase history, and parameter log
    Extracted from the maiden flight checklist, project proposal, funding
    application, shopping list, parameter change log, and GX12 switch setup
    notes. Source documents removed once their content was captured in
    Markdown under docs/, params/, and context/.
2026-06-21 Add supporting documents/invoices, confirm power module and battery, fix GX12 variant
    - Confirmed fitted battery (Turnigy 8000mAh 6S 15C, not the 2200mAh 60C
    originally budgeted) and fitted power module (Holybro PM03D, not the
    PM06 V2 or MatekSys PDB also purchased for this project).
    - Added supporting-documents/ for reference material kept in original
    format (project proposal, purchase invoices), distinct from the
    Markdown project documentation under docs/ and params/.
    - Corrected the Radiomaster GX12 description (not the "Crush" variant).
    - Added the proposal's timeline to docs/project-overview.md.
2026-06-21 Confirm GPS wiring and flag missing RTK antenna
    M8N (GPS 1) is the primary GPS on the GPS 1 UART port; ZED-F9P (GPS 2)
    is on the GPS 2 UART port but has no antenna installed yet - added as
    a maiden flight blocker. Also noted RFD900 Telem_2 wiring follows the
    RFD900 datasheet, and recorded the commit-as-we-go workflow directive.
2026-06-21 Add component datasheets, confirm Pixhawk 6X flight controller
    Datasheets for components currently installed in the aircraft: RFD900x,
    DBR4, NEO-M8N, ZED-F9P, MS4525DO, Holybro PM03D. Ground-side equipment
    (GX12 transmitter) and not-yet-installed components (IMX335 camera)
    are excluded by design. No standalone PDF exists for the Pixhawk 6X
    or the Turnigy battery (web docs / product pages only).
2026-06-21 Add ICD system block diagram
    SVG block diagram showing the Pixhawk 6X and all eight interfaces
    (power, actuators, RC, telemetry, dual GPS, airspeed, RC transmitter
    link), with a clear aircraft/ground boundary separating onboard
    components from the GX12 transmitter and ground station.
2026-06-21 Redraw ICD block diagram with orthogonal routing and uniform sizing
    All connectors now use right-angle (horizontal/vertical only) routing
    instead of diagonals. All peripheral boxes share a uniform 240x90 size
    (FC stays larger at 280x110 as the focal component); ground equipment
    keeps its distinct dashed/grey styling at the same size. Added an
    explicit white background so it renders consistently in dark-mode
    viewers.
2026-06-22 Add GX12 EdgeTX radio backup and PX4 parameter dump, confirm CH12 routing
    Cross-checked the radio model mixer against the documented RC channel
    map and found CH12 carries the SH switch with no PX4 function yet
    assigned, consistent with the existing "future buzzer or payload"
    placeholder. Updated docs/ICD.md and added the confirming QGC
    screenshot.
    [believer-parameters.params]
2026-06-22 Add annotated GX12 switch diagrams, correct Crush variant confirmation
    The transmitter is the GX12 Crush (Iron Grey), reversing the
    2026-06-21 note that it wasn't. Added front/top diagrams annotating
    each physical switch with its PX4 channel function, built from
    RadioMaster's official product photos and cross-checked against the
    radio backup's switch config and an EdgeTX teardown review.
2026-06-23 Annotate each GR1 position individually, drop unmapped slider labels
    GR1 front-view diagram now labels each of the six physical buttons
    with its PX4 flight mode (SW1=Manual ... SW6=Hold) instead of one
    generic group label. Top-view diagram no longer annotates the two
    sliders since they aren't mixed to any RC channel.
2026-06-23 Add GX12 user manual to Component datasheets, override ground-equipment rule
    The GX12's switch/channel mapping is referenced throughout the ICD and
    manual, so it now gets a manual alongside the installed components -
    overriding the ground-side-equipment exclusion for this one item.
2026-06-30 Restructure context/, update purchase history
    - docs/purchase-history.md: add Paid By and Installed columns, remove
    Shortlisted status, update prices from current data (GX12 $329.99,
    Turnigy $145.57, PM06 V2 $20.99), add 5% shipping est. on uninvoiced
    items, correct GX12 Installed to Yes
    - context/: add startup-prompt.md, project-overview.md, style-guide.md,
    academic-integrity.md (QUT MOPP, researched June 2026); move CHANGELOG
    from repo root to context/CHANGELOG.md
    - context/directives.md: extract style guidance to style-guide.md,
    update CHANGELOG location ref
    - context/MEMORY.md: index new context files
    - CLAUDE.md: point to startup-prompt.md as session entry point
    - README.md: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
2026-06-30 Add signed EER funding application to supporting-documents
    Re-adds QUTAS Fixed Wing Drone Funding Application SIGNED.pdf, which
    was deleted before the policy of retaining signed reference documents
    was established.
2026-06-30 Convert USD purchase totals to AUD; add budget summary header
    Converts MATEKSYS PDB ($31.17 USD -> $42.98 AUD) and LiPo straps
    ($10.08 USD -> $13.90 AUD) using 1 USD = 1.379 AUD (RBA rate,
    2026-05-10). University total updated to $981.08 AUD. Adds
    funding summary at top of file: $1,379 allocated, $981.08 spent,
    $397.92 remaining.
2026-06-30 Add motor hatch, nacelle, and propeller retention items to checklist
    Items 15-17: motor/ESC hatch retention, nacelle retention, and
    propeller nut torque check. Notes CW rotation of LHS motor and
    its tendency to self-loosen a right-hand-thread nut.
2026-06-30 Expand and restructure maiden flight checklist
    - Expand Configure & Tune into 10 sub-items (battery, sensors,
    airspeed, GPS, motors/ESCs, servos, RC/modes, failsafe, tuning,
    standard install); mark in-progress items accordingly
    - Merge Additional Pre-Flight Items into main table (items 12-18)
    - Add items: ZED-F9P external mount, avionics bay bolt torque,
    GPS mounting bolt torque
    - Update item 11 (paint) status to Not started
2026-06-30 Rename maiden flight procedure to Pre-Flight Checklist with detailed sequence
    Replaces the brief flight-mode-progression list in manual.md section 6
    with a full 21-step pre-flight procedure covering unboxing through to
    arming, control checks, and propeller installation.
2026-06-30 Add motor rotation direction diagram and link it from the pre-flight checklist
2026-06-30 Rename maiden flight checklist to build-checklist.md and organize into categories
    Reflects that retention and configuration items are ongoing concerns,
    not specific to the maiden flight. Groups the build table into
    Airframe and Structural, Avionics Installation, Sensors, RC and
    Telemetry, Power System, GPS, and Fasteners and Retention Checks
    sections ahead of the existing Configure and Tune section.
2026-07-02 Document motors, ESCs, and servos; add component photos
    T-Motor U5 v2.0 KV400 (motors), Hitec HS-5125MG (aileron servos),
    Emax ES3054 (V-tail servos) added to ICD INT-02 with spec tables and
    photos. ESC identified as T-Motor branded; model TBD (PCB markings
    noted in project-notes). Updated project-overview, project-notes, and
    open-items accordingly.
2026-07-02 Record propeller specs and add thrust validation task
    11x4.7" propellers fitted (manufacturer unknown). Added thrust
    validation as a build checklist item (5a) since adequacy for the
    aircraft's all-up weight is unconfirmed. Updated ICD motor table,
    project-notes, and open-items accordingly.
2026-07-02 Add pitot tube clearance verification to build checklist
    New Sensors item 2: verify pitot tube clears the airframe sufficiently
    to sample undisturbed freestream air before flight.
2026-07-03 Split INT-02 into 6 interfaces; add RFD900 pinout; rebuild block diagram; overhaul build checklist
    ICD Rev 1.0: INT-02 split into INT-02a-f (one per MAIN output);
    full 16-pin RFD900x connector pinout table added under INT-04.
    Block diagram redrawn: 6 individual actuator boxes replace the
    single combined block, each labelled with device and MAIN output.
    Build checklist: added Priority column (Critical/Non-critical);
    Done -> Complete; parachute bay updated (servo removed, taped shut);
    pitot note (taped) + permanent mount task added; wiring tidy task
    added; Configure & Tune item 7 marked Complete.
2026-07-03 Mark fastener retention checks 1 and 2 as Complete
    Motor/ESC access hatch and nacelle retention both verified.
2026-07-03 Restructure build checklist by status (Complete / In Progress / Not Started)
    Single table per section with Category column replaces the previous
    category-per-section layout. Parachute/payload bay servo split out
    as a new Not Started task from the old inline future-work note.
2026-07-03 Move avionics bay bolts to Complete; mark GPS bolt torque Critical
    Renamed to "Torque avionics bay mounting bolts" and moved to the
    Complete section. GPS mounting bolt torque priority raised to Critical.
2026-07-03 Add Urgent priority tier to build checklist; re-prioritise all tasks
    Pitot permanent mount, pitot clearance, ZED-F9P antenna/mount,
    geofence, and PID tuning are Urgent (should be done, not blockers).
    Propeller retention, failsafe, servo mapping, thrust validation
    stay Critical. Priority definitions added to document header.
2026-07-03 Update parameter backup and document changes since 2026-06-22
    Replace params/believer-parameters.params with 2026-07-03 FC export.
    Add 2026-07-03 section to parameter change log: sensor recalibrations
    (ACC0/1/2, BARO0, GYRO2, MAG1), battery threshold increases
    (BAT_CRIT_THR 7pct to 10pct, BAT_LOW_THR 15pct to 20pct), geofence
    breach action (GF_ACTION Hold to Return), and flag on PWM_MAIN_DIS7=2000
    on unused output.
    [believer-parameters.params]
2026-07-03 Rewrite parameter change log as current-config reference
    Replace changelog-style format with a single current-configuration
    document (one table per subsystem, current values only). Add missing
    MAV_1 config (TELEM1/ELRS OSD back-channel) and PWM_MAIN_FUNC/REV
    actuator assignments. Move calibration values to a separate section
    at the bottom.
2026-07-03 Document MS4525DO I2C port connection (INT-07, ICD rev 1.1)
    Add I2C port and address detail to INT-07: Pixhawk 6X I2C port
    (JST-GH 4-pin, address 0x28). Update project-notes.md to match.
2026-07-03 Update build checklist: airspeed cal and power monitor complete, failsafe in progress
    Mark airspeed sensor calibration and battery/power monitor configuration
    as Complete; move failsafe configuration from Not Started to In Progress.
2026-07-03 Update build checklist: GPS tasks split, M8N complete
    Split GPS configuration into GPS 1 (M8N, Complete) and GPS 2 ZED-F9P
    (In Progress, blocked by antenna). Also fix duplicate failsafe entry
    introduced in previous edit.
2026-07-03 Split control surface task: mapping complete, deflection/rates not started
    PWM channel mapping and direction verification is complete. Configure
    deflection limits, rates, and expo is a new Critical Not Started task.
2026-07-03 Re-prioritise GPS 2 config to Urgent in build checklist
    Aircraft can fly on M8N only; ZED-F9P config is blocked by antenna
    install anyway. Reorder In Progress section to keep Critical-first sort.
2026-07-03 Motor/ESC config complete; split out PWM min/max as Urgent task
    Motor output mapping and spin directions verified. PWM min/max duty
    cycle limits are a new separate Urgent Not Started task.
2026-07-03 Mark sensor calibration complete (accel, gyro, mag)
2026-07-03 Add Future Work section to build checklist
    Move paint/finishing and parachute bay servo from Not Started to Future
    Work. Add new future tasks: companion computer mount, camera mount,
    camera record-on-arm, LiDAR sourcing and installation, auto takeoff,
    and auto land.
2026-07-03 Add project timeline document with milestones and five-phase roadmap
    Covers completed milestones from proposal through current config phase,
    remaining pre-flight items, and phases through to BVLOS operations.
2026-07-03 Correct project history: airframe pre-2020, revived December 2025
    Airframe (motors, servos, ESCs) was built prior to 2020 by unknown
    original builder. Julian inherited and revived the project in December
    2025. Updated project-timeline.md milestones and project-notes.md.
2026-07-03 Add GX12 switch diagrams and QGC flight modes screenshot to manual
    Embed front/top switch location diagrams after the RC channel map
    and QGC flight modes config screenshot after the GR1 mode table.
2026-07-03 Expand pre-flight checklist from 21 to 31 steps with section headers
    Add: weather/NOTAM checks, pitot obstruction check, home position and
    geofence confirmation, RSSI check, airspeed sensor functional test,
    explicit disarm before prop install, people/airspace clear check, and
    propeller retention nut torque check (with LHS reverse-thread warning).
2026-07-03 Reorder launch area check and add assisted hand launch procedure
    Move people/airspace clear check to just before launch (step 31).
    Add assisted hand launch section: two-person roles, handler grip and
    throw technique, arm/throttle sequence, post-launch recovery guidance.
2026-07-04 Mark propeller retention nuts and GPS bolt torque as complete
2026-07-04 Document GPS_2_CONFIG = 0 (ZED-F9P disabled pending antenna install)
    Parameter backup is stale - update pending new dump from FC.
2026-07-04 Update parameter backup to 2026-07-04 FC export; document calibration changes
    Full accelerometer recal (offsets + scales, ACC0/1/2), barometer offset
    update, full magnetometer recal with soft-iron correction (MAG0/1 odiag
    non-zero), CAL_MAG0_PRIO = 0 (internal compass excluded from fusion),
    board level cal update, airspeed offset update (SENS_DPRES_OFF),
    GF_MAX_VER_DIST = 120, GPS_2_CONFIG = 0, GPS_2_GNSS/GPS_2_PROTOCOL/
    SER_GPS2_BAUD removed. Parameter log calibration section fully rewritten
    with new values; GPS table updated.
    [believer-parameters.params]
2026-07-05 Log propeller replacement (Hobbyrama 11x7 LP11X7E)
    Both propellers currently fitted are the same handedness; a reverse-
    pitch prop is still needed on one side for true contra-rotation.
2026-07-05 Add build-checklist tasks from BNEMAC review (2026-07-04)
    Motor/ESC replacement, reverse-pitch propeller, ruddervator direction
    fix, motor start sync, flight mode investigation, expo, cover bolts,
    RFD900x antenna install, and launch dolly.
2026-07-05 Move stick/deflection matching to In Progress after radio calibration
    Radio calibration matched stick travel to the configured PWM
    deflection limits; rates and expo config in EdgeTX still outstanding.
2026-07-05 Document telemetry rate tuning (ELRS packet rate, MAV_0/MAV_1 config)
    Confirmed MAV_0 (RFD900x, TELEM2) was bandwidth-starved at a live
    MAV_0_RATE of 1200 B/s despite docs already specifying 3000 B/s;
    corrected to match. MAV_1 (DBR4, TELEM1) had headroom but BATTERY_STATUS
    was capped low by OSD mode defaults; raised MAV_1_RATE and added
    per-message rate overrides via /fs/microsd/etc/extras.txt on both links.
2026-07-05 Mark primary control expo complete (30% surfaces, 20% throttle)
    Deviates from the originally planned flat 30% on all four channels.
    Dual/tri-rate switch-selectable deflection still outstanding on the
    broader deflection limits/rates/expo task.
2026-07-05 Log BNEMAC follow-up: ruddervator fixed, thrust pending test, reverse-prop plan
    Ruddervator direction corrected and re-verified. Reframed motor/ESC
    replacement as pending a new thrust-to-weight ground test rather than
    a settled conclusion, since radio recalibration may have already
    improved effective RPM. Noted the interim same-direction motor
    reconfiguration (matching the currently same-handed propellers) and
    its likely contribution to the original thrust complaint. Split
    control surface rates out as non-critical per user direction.
2026-07-05 Correct BNEMAC review date to 2026-07-05
    The full review (thrust, ruddervator, motor timing, servo travel,
    stabilize mode) happened today, not 2026-07-04. That date remains
    correct for the propeller purchase and a brief separate hello with Ross.
2026-07-06 Draft system requirements for the camera mounting subsystem
    Initial draft (Rev 0.1): belly-mounted, downward/oblique observation,
    camera-only scope. Surfaces the lack of landing gear as a primary
    structural driver - the mount must protect the camera from ground
    strike during belly landings.
2026-07-06 Specify recessed internal camera mount (3mm through belly cutout)
    Added REQ-CAM-14 for cutout sizing against the lens FOV cone. Flagged
    open question on whether a 3mm recess is adequate given grass/dirt
    landing surfaces rather than a smooth runway.
2026-07-06 Add modular two-part camera mount requirement
    Female base fixed to the airframe, male carrier holding the camera,
    so the camera can be swapped in future without touching the
    airframe-side mount. Sized for up to a 50x50mm camera footprint with
    adjustable positioning for varying lens lengths, to stay compatible
    with the fixed 3mm recess depth (REQ-CAM-13) regardless of which
    camera/lens combination is fitted.
2026-07-06 Move camera requirements into new docs/requirements/ folder
    Establishes docs/requirements/ as the home for system requirements
    documents, one file per subsystem, alongside the existing
    docs/test-reports/ convention.
2026-07-06 Reframe camera requirements as downward-facing; add candidate module data
    Waveshare IMX335 (B) recorded as reference-only candidate module,
    explicitly subject to change - not baked into the requirements
    themselves. Surfaces a real geometry conflict between the 3mm ground-
    strike recess and the candidate's 175 degree FOV lens, plus an
    unreconciled operating-temperature discrepancy between sources.
2026-07-06 Clarify modular mount: fixed female interface, per-camera male carrier
    The female base and its mating interface never change; a new male
    carrier may be custom-designed for each camera module instead of one
    carrier flexing to fit all cameras. Also corroborates the -10C
    operating-temperature low end via a second independent source, and
    adds the SH1.0-to-USB connector detail.
2026-07-06 Narrow camera/companion-computer interface scope; rename doc title
    REQ-CAM-31 removed and REQ-CAM-30 narrowed - that interface is out of
    scope here, the mount's only obligation is not to obstruct the cable.
    Document retitled "Underslung Camera Mounting Subsystem - System
    Requirements" (filename unchanged).
2026-07-06 Rename camera-mount-requirements.md to underslung-camera-mount-requirements.md
    Distinguishes this belly-mounted camera's requirements from future
    camera mount requirement documents that will cover other locations.
2026-07-06 Resolve camera mount location: centreline, between the landing pads
    Per the airframe manufacturer's documentation. Removes the mounting-
    location open item; adds a new one on whether the landing pads sit
    proud of the surrounding skin, relevant to the ground-strike recess
    depth.
2026-07-06 Log T-MOTOR MN3110 KV700 motor purchase and add install task
    Replacement motors for the T-Motor U5 v2.0 KV400 units, purchased
    2026-07-06 with personal funds ($169.87 AUD). Added a build-checklist
    task to fit them, and noted ESC compatibility with the new motors is
    still unconfirmed.
2026-07-06 Add tool-less interchange requirement for the camera male carrier
    REQ-CAM-18: bayonet/spring-latch/thumb-screw style quick release,
    not plain screws or bolts requiring a driver. Narrows the still-open
    mating-mechanism decision accordingly.
2026-07-06 Add airframe envelope reference data from manufacturer page
    Wingspan, fuselage dimensions, MTOW, payload capacity, and load/
    battery compartment sizes from en.makeflyeasy.com. Adds a concrete
    payload-capacity budget to REQ-CAM-12. Flags that the manufacturer
    page didn't independently corroborate the landing-pad detail used in
    REQ-CAM-10.
2026-07-06 Resolve recess-sufficiency and load-compartment open items
    3mm recess confirmed sufficient; manufacturer's load compartment
    confirmed as the same bay referenced in REQ-CAM-10. Softened REQ-CAM-14
    to avoid vignetting where possible, framing full-FOV avoidance as a
    limitation of the specific candidate module rather than an unsolved
    geometry problem.
2026-07-06 Update parameter backup to 2026-07-06 export; document changes
    MAV_1_MODE changed OSD->Normal, PWM_MAIN_MIN1/2 lowered for more
    V-tail travel, PWM_MAIN_REV changed consistent with the ruddervator
    fix - all confirmed intentional. Flags the BATTERY_STATUS extras.txt
    override as unverified against the new Normal-mode default rate.
    [believer-parameters.params]
2026-07-16 Log TMAC review (Peter Spink), propeller purchase, and ICD garbling fix
    - docs/ICD.md: removed a stray UTF-8 BOM causing garbled rendering;
    added the PM03D's 3A servo rail limit, confirmed against its
    datasheet and independently corroborated by Peter Spink.
    - purchase-history.md: logged the 9x6" Gemfan standard+pusher
    propeller pair for the new KV700 motors; added personal and
    all-parties total summary rows.
    - Added docs/test-reports/2026-07-10-tmac-review-peter-spink.md,
    reformatted from a root-directory draft.
    - build-checklist.md: added new tasks from the review (UBEC, DBR4
    relocation, CG ballast, battery velcro, and others); updated motor
    start sync and flight mode investig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
2026-07-16 Recreate ICD block diagram, fixing GX12-DBR4 routing bug
    The GX12 transmitter box was positioned on the far left of the
    diagram (over the actuator column) while its RF counterpart, the
    DBR4 receiver, was on the far right - so the straight-line RF link
    between them visually terminated over the V-Tail Left servo box
    instead. Regrouped GX12 with Ground Station above their onboard RF
    counterparts, rerouted the Ground Station-RFD900x link around DBR4
    instead of through it, and cleaned up the PM03D-FC power routing and
    a few stale labels along the way.
2026-07-16 Reorder build-checklist sections and annotate task dependencies
    Complete moved to the end (In Progress, Not Started, Future Work,
    Complete). Added "Blocked by" notes for identified dependency chains,
    e.g. auto takeoff/land blocked by LiDAR installation.
2026-07-16 Restructure build-checklist.md into work packages with a flight-readiness dashboard
    Reorganises the checklist by subsystem (Airframe, Propulsion, Power,
    Flight controls, Navigation, RC/RF) instead of by status, adds a
    Critical-blockers dashboard, explicit task dependencies and acceptance
    criteria, collapses provenance notes and completed work into <details>
    blocks, and moves recurring retention/torque checks out of "Complete"
    into a dedicated verification table. Future capability work split out
    into docs/project-roadmap.md.
2026-07-17 Add docs/flight-modes.md and link it from the manual
    Documents the eight PX4 fixed-wing flight modes reachable on the
    Believer - behaviour, stick response, and the parameters that
    configure each mode - cross-referenced against the official PX4 User
    Guide and the as-exported values in params/believer-parameters.params.
    Adds a short behavioural summary and a link to the new document in
    manual.md's flight modes section.
2026-07-17 Correct ICD actuator table against params backup; refresh stale docs
    Cross-checked every value in the ICD's INT-02a-f actuator table
    against params/believer-parameters.params and found it had never
    matched the real exported values (PWM min/max and two Reversed flags
    wrong) since before the 2026-07-05/07-06 calibration and ruddervator
    fix. Corrected the ICD, the block diagram SVG labels, and the
    project-overview actuator table to match.
    Also refreshed project-timeline.md (missing every milestone since
    2026-07-05, remaining-work list predated the TMAC review), and fixed
    several stale cross-references (MS4525DO wiring, RTK antenna framing,
    build-checklist.md Future Work moved to project-roadma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
2026-07-17 Reorganise docs/ into engineering/operations/project subfolders
    Splits docs/ by purpose per user request:
    - docs/engineering/ - ICD.md, flight-modes.md, requirements/, test-reports/
    - docs/operations/ - manual.md, plus the top-level GX12 Backup/ and
    params/ folders moved in and renamed to GX12 Radio Backup/ and
    Pixhawk Parameter Backup/
    - docs/project/ - build-checklist.md, project-roadmap.md,
    project-overview.md, project-timeline.md, purchase-history/, and
    docs/reference/ renamed to governance/
    - docs/assets/ stays at docs/ root, shared by all three
    Rewrote every internal cross-reference repo-wide to match (relative
    links in all moved documents, plus path mentions throughou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
    [believer-parameters.params]
2026-07-21 Add power distribution board system requirements document
    Defines requirements for a bespoke PDB to replace the Holybro PM03D,
    motivated by its undersized XT-30 motor outputs and 3A-limited servo
    BEC. Fact-checked the XT30 current rating per request (no single
    authoritative number found - recorded as reference data) and sized
    the port rating against the T-Motor MN3110 KV700's actual max current.
2026-07-21 Record T-Motor AIR 40A ESC acquisition; resolve PDB spare-port purpose
    Two T-Motor AIR 40A ESCs acquired to pair with the MN3110 KV700 motor
    upgrade - added to the ICD, folded into PROP-01's install scope
    (PWR-01 left unchanged, per instruction, since the PDB is separate
    future-development work), and cross-referenced in the PDB requirements
    doc. Also resolves that doc's spare-XT60-port-purpose open item per
    user confirmation and reworks input/current-sense sizing accordingly.
2026-07-21 Source component datasheets; correct PM03D XT30 fact-check
    Downloaded and content-verified datasheets for INA228, T-Motor AIR
    40A ESC, T-Motor MN3110 KV700, and a T-Motor U5 KV400 load-test
    report (moved the user-supplied INA228 PDF from the repo root into
    Component datasheets/). Broadened the datasheets-folder policy to
    cover acquired-but-not-yet-installed components with an active
    install task. Also corrected the PDB requirements doc's XT30
    fact-check per clarification - the question was the PM03D's own
    per-port rating, which Holybro simply doesn't publish anywhere.
2026-07-21 Add launch dolly requirements; close RF-02; expand future roadmap
    New launch dolly SRD (SRD-BELIEVER-DOLLY-001) expanding the former
    AF-05 task, which moves out of active build tracking now that it has
    its own requirements document. Marked RF-02 (RFD900x antennas)
    complete per confirmation. Added the PDB and launch dolly to
    project-roadmap.md.
2026-08-19 Install MN3110/AIR 40A propulsion, servo UBEC, and restructure flight modes
    Records the 2026-08-19 build session: MN3110 KV700/AIR 40A motor and ESC
    install with confirmed simultaneous start and PWM 1000-2000us range, a
    dedicated ZTW UBEC 10A servo rail supply replacing the PM03D for that role,
    DBR4 relocation to the rear of the aircraft, and finalised TMAC control
    surface trim/mixing values. Adds Acro mode to the GR1 group in place of the
    redundant Hold position, resolving the Stabilized-mode yaw open item by
    reclassifying the expected direct-response behaviour as Acro's rather than
    Stabilized's, and sets COM_PREARM_MODE to Always for bench actuation.
    Closes CTL-01, CTL-03, CTL-05, PROP-01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
    [believer-parameters.params]
2026-08-19 Add RTV securing to DBR4 antenna mounting task (RF-05)
    Julian confirmed silicone RTV as the intended method for securing the
    DBR4's antenna connectors, standard practice for vibration damping on RC
    airframes - folded into RF-05 alongside the orthogonal mounting work
    already tracked there.
2026-08-19 Close RF-03 and RF-04 (GX12 flight-mode audio cues, timer widget)
    Julian confirmed both configured on the GX12 - flight-mode-aware sound
    cues and a timer widget added to the telemetry screen.
2026-08-24 Add custom airframe requirements document
    Initial requirements (Rev 0.1) for a new custom-designed airframe to
    replace the commercial MakeFlyEasy Believer airframe, based on Julian's
    requirements plus additional suggested items. Flags a significant
    cross-document implication: the existing launch dolly was motivated by the
    current airframe's lack of landing gear, which this design's own landing
    gear may supersede.
2026-08-25 Resolve review feedback on custom airframe requirements (Rev 0.2)
    Researched RF/EMI separation against official PX4/ArduPilot documentation
    per Julian's request - neither specifies a fixed numeric minimum, only
    qualitative "maximum practical separation" guidance, so the requirement is
    written to match rather than asserting an invented distance. Added a
    quantified antenna-to-antenna spacing requirement (general RF practice,
    ~12cm at 2.4GHz) since that is separately well-established.
    Also folds in: softened connector-standard requirement (avionics-subsystem
    concern, not yet decided), signal loom organisation/traceability, a firm
    30-minute mission-time target, standard-car transport and <5-min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
2026-08-25 Correct launch dolly obsolescence relationship
    Julian confirmed the custom airframe's landing gear will make the launch
    dolly obsolete once built, correcting the previous "separate future
    decision, no conflict" framing. Cross-referenced in both requirements
    documents and the roadmap - the dolly remains an active interim solution
    for the current Believer airframe until then.
2026-08-25 Add FC vibration isolation requirement (REQ-AF-27)
    Julian confirmed this is wanted - the flight controller shall be mounted
    on vibration-damping isolation to attenuate motor/propulsion vibration
    and protect IMU sensor data quality.
2026-08-25 Add gimbal camera pod impact protection requirement (REQ-AF-62)
    Julian confirmed this is wanted - the underslung gimbal camera pod mount
    shall incorporate impact protection (breakaway mount, shock-absorbing
    standoffs, or recessed/shielded position) against hard-landing/belly-
    strike damage, given it's expected to be the airframe's highest-value
    single component.
2026-08-25 Add CG target and battery adjustment range requirements (REQ-AF-43/44)
    Julian wanted a number on CG rather than just "adjustable." REQ-AF-43
    targets 25-30% MAC, a provisional figure carried over from the current
    Believer's known-stable operating point pending a real stability/
    tail-volume analysis on the new wing/tail. REQ-AF-44 requires the battery
    slide to provide at least +-5% MAC of adjustment travel, so build
    tolerance and payload variance can be trimmed out without ballast -
    avoiding a repeat of the current airframe's ~350g ballast fix.
2026-08-25 Make CG target/adjustment requirements configuration-aware (REQ-AF-43/44)
    Julian pointed out the 25-30% MAC / +-5% MAC figures assumed a
    conventional tailed layout and don't apply to a flying wing, which has no
    tail moment arm and typically needs a much narrower CG band plus finer
    adjustment resolution. Both requirements now derive their target from a
    stability analysis matched to whichever tail configuration the team
    chooses, keeping the conventional-tail numbers only as a provisional
    reference point pending that decision.
2026-08-26 Add operating altitude and cruise airspeed requirements (REQ-AF-72/73)
    REQ-AF-72 sets a 120m AGL max operating altitude, referenced against the
    project's existing geofence ceiling. REQ-AF-73 sets a 15-20 m/s cruise
    airspeed target, referenced against the current Believer's trim airspeed
    and the original manufacturer's recommended cruise speed. Both are
    provisional design references pending the new wing's aerodynamic design;
    mission-specific operating altitude (distinct from the regulatory
    ceiling) and the full airspeed envelope are flagged as open items.
2026-08-26 Research and add typical operating altitude requirement (REQ-AF-74)
    Researched CASA's actual regulatory basis for the 120m AGL ceiling
    (CASR Part 101, casa.gov.au) rather than relying on the prior internal
    reference alone, and researched mission-informed typical altitude:
    shark-spotting precedent (Westpac Little Ripper/SharkSpotter, ~60m AGL),
    UAV vegetation/soil spectral discrimination studies (best at 60m AGL,
    degrading by 80-100m), and precision-agriculture survey practice
    (80-120m AGL for row crops). Added REQ-AF-74 (60-100m AGL typical
    mission altitude) and strengthened REQ-AF-72's citation. Bumped to
    Rev 1.0 to avoid decimal-ambiguous "0.10" versioning.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
2026-08-26 Split airspeed into design cruise and top speed targets (REQ-AF-73/75)
    Julian wanted a distinct top speed and typical cruise speed to optimise
    efficiency around, rather than a single range. REQ-AF-73 is now a
    single-point 15 m/s design cruise speed (the current Believer's actual
    as-flown trim) for the wing/propulsion system to be optimised around.
    New REQ-AF-75 sets a 20 m/s top-speed target, referenced against the
    current airframe's FW_AIRSPD_MAX and the manufacturer's recommended
    cruise speed - both landing independently on the same figure. Added
    Section 3d documenting the reference data and rationale.
2026-08-26 Correct methodology: requirements shall derive from mission, not Believer
    Julian correctly flagged that REQ-AF-73/75 (cruise/top speed) were built
    directly from the current Believer's tuned parameters, which is backwards
    for a document meant to define a mission-driven replacement for that
    airframe. Both requirements now call for a mission-based trade study
    (endurance, area-coverage rate, sensor motion-blur tolerance, regional
    wind conditions) that hasn't been run yet, rather than asserting numbers
    borrowed from an unrelated commercial airframe. The Believer's airspeed
    figures are demoted to non-authoritative context in Section 3d.
    Added a design-philosophy statement to Section 2 establishin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
2026-08-26 Add four invoices and correct purchase history with confirmed figures
    Located and filed invoices for the SparkFun ZED-F9P, HobbyKing Turnigy
    Graphene battery, Core Electronics IMX335 camera, and Holybro PM06 V2,
    dropped in the repo root. Replaced the previous shopping-list estimates
    for all four with confirmed invoice figures - the SparkFun and PM06
    invoices were in USD and needed AUD conversion (approximate, exact daily
    rate not confirmable via research, flagged in open-items).
    Net effect: University total revised from ~$981 to ~$1,223 AUD, cutting
    the remaining approved-budget margin from ~$398 to ~$156 AUD.
2026-08-26 Run design cruise speed trade study (REQ-AF-73/75 resolved)
    Added Section 3e: benchmarks design cruise speed against comparable
    mission-class survey/mapping UAS (Quantum Trinity F90+, WingtraOne,
    senseFly eBee X) rather than the unrelated Believer airframe, per the
    Rev 1.2 methodology correction. Trinity F90+ is the closest match to
    this project's mass/wingspan targets and converges with WingtraOne on
    ~16-17 m/s cruise. Cross-checked against a motion-blur/GSD physics
    calculation using the IMX335 as an illustrative sensor stand-in,
    confirming 16 m/s is not blur-limited at the target altitude band.
    REQ-AF-73 resolved to a provisional 16 m/s design cruise speed.
    REQ-AF-75 resolved to a provisi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
2026-08-31 Close NAV-03/04 (ZED-F9P mount and antenna); catch up CTL-05 in Completed Work
    NAV-03 (external mount) and NAV-04 (antenna installation) complete per
    Julian, 2026-08-28 - moved to Completed Work. RTK capability still
    depends on NAV-05 (protocol/GNSS config, GPS lock), unaffected by this.
    Also found CTL-05 (clean-install procedure) had been marked Complete
    since 2026-08-19 but was never added to the Completed Work summary -
    added it now while doing this sweep, per the request to catch any other
    completed items.
    Updated the stale "no antenna installed" notes in project-notes.md and
    project-overview.md to match.
2026-08-31 Restructure completed tasks out of active sections; add new build tasks
    Completed tasks (PROP-01/03/04, PWR-01, CTL-01/03/05, NAV-03/04,
    RF-01/03/04) removed from their work-package sections now that they're
    migrated into Completed Work - they no longer exist in both places.
    Dependency references annotated for traceability. Detailed provenance
    remains in project-notes.md and this changelog.
    Added per Julian: AF-08 (secure motor mounting plates with polyurethane
    tack glue - critical, must be done before maiden flight), CTL-06
    (configure aileron differential across the full travel range, not just
    PWM endpoints - corrects an earlier overstated completion claim),
    CTL-07 (10% aileron-to-rudder m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
2026-08-31 Decide GPS blending over single-primary designation for M8N/ZED-F9P
    PX4 (1.16.1rc) has no simple primary-GPS toggle - dual-GPS handling is
    either blended (weighted by reported accuracy via SENS_GPS_MASK) or
    locked to one receiver exclusively. Julian chose blending: the ZED-F9P
    should dominate once enabled, especially with RTK corrections, while
    the M8N stays as an automatic fallback rather than being dropped.
    Updated ICD INT-06 (also cleared a stale "antenna not fitted" note -
    the antenna was installed 2026-08-28 and this was never actually a hard
    flight blocker), added the SENS_GPS_MASK confirmation to NAV-05's scope,
    and logged the decision in project-notes.md/open-items.md pending
    verifi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
2026-08-31 Add PROP-07: measure real wing airfoil for MotoCalc
    Non-critical task per Julian to physically measure the wing's actual
    airfoil (LE/TE height, chord, upper/lower surface height and chord-line
    height at the thickest point), superseding the generic Eppler 374
    stand-in currently used for PROP-05 once done. Reference screenshot
    pending - image pasted in chat can't be extracted directly; needs to be
    dropped into the repo like other attachments.
2026-08-31 Log full-throttle overcurrent finding, add sustained-run criterion to PROP-02
    Julian's brief (<20s) full-throttle bench test had the PDB reporting
    60-65A total current draw - ~30-32.5A per motor, roughly 45-55% above
    the MN3110 KV700's rated 21A continuous current (a 180s rating), though
    comfortably within the AIR 40A ESC and battery's capability. Not a
    concern for a brief burst, but doesn't confirm sustained-duration
    thermal safety. Added an explicit sustained full-throttle current/
    temperature monitoring criterion to PROP-02 rather than treating the
    brief test as conclusive either way.
2026-08-31 Add Weishaupl et al. 2024 airframe drag paper; add CTL-10 stall speed fix
    Filed a wind-tunnel drag characterisation paper (Weishaupl, McLay &
    Sobester, The Aeronautical Journal 2024) whose test platform is built on
    the same manufacturer's airframe as the Believer, with matching
    wingspan/length/MTOW/cruise speed. Extracted its measured drag polar and
    performance data into project-notes.md.
    Added CTL-10 (Critical): set FW_AIRSPD_STALL to the paper's measured
    11 m/s, and raise FW_AIRSPD_MIN (currently 10 m/s, below that stall
    speed - a genuine safety gap in automatic flight modes, not just a
    documentation issue) to a value with real margin above it. Cross-
    referenced the paper's drag polar int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
2026-08-31 Rebaseline control-surface config per flight-control review (CTL-06/07/08)
    Repository updated from a flight-control configuration review Julian
    conducted separately. Core finding: the PX4 Actuators page's Roll/Pitch/
    Yaw Torque fields are actuator-effectiveness coefficients for the
    control allocator, not transmitter mixer percentages - this reframes
    several 2026-08-19 decisions made under the earlier assumption that they
    worked like a conventional mixer.
    - CTL-06 rewritten: restore V-tail yaw effectiveness from +-0.85 to the
    PX4 default +-0.50; retain established aileron trims; independently
    remeasure safe PWM endpoints per servo rather than using them to
    approximate aileron different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
2026-09-02 Close AF-03 (motor/ESC inspection-bay cover bolts)
    Rounded bolts replaced with appropriately sized fasteners, per Julian.
2026-09-02 Log CTL-08 finding: early saturation is Acro-specific, not Manual
    Julian's bench observation - stick and surface deflection agree better
    in Manual mode than Acro - matches the flight-control review's
    hypothesis that Acro's rate controller saturates on a stationary bench
    with nothing to null against, while Manual's direct stick-to-actuator
    path doesn't have that artefact. Strong signal FW_MAN_R_SC doesn't need
    reducing, but this is an informal observation, not the formal recorded
    Manual-mode test CTL-08 requires to close out, so status is unchanged.
2026-09-02 Close CTL-08: FW_MAN_*_SC confirmed and retained at 1.0
    Julian's Acro-vs-Manual bench comparison satisfies CTL-08's own
    documented closing condition: early control-surface saturation is
    confined to Acro mode (rate-controller integral windup against a
    stationary airframe that can never satisfy the commanded rate) and does
    not reproduce in Manual mode's direct, open-loop stick-to-actuator path.
    FW_MAN_R_SC, FW_MAN_P_SC, and FW_MAN_Y_SC all confirmed and left at the
    PX4 default 1.0, unchanged.
    Moved CTL-08 into Completed Work; updated CTL-02/CTL-04/CTL-07's
    dependency annotations. Updated manual.md's pre-flight checklist per the
    review's planned follow-up - the surface-proportionality check is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
2026-09-02 Close CTL-06/CTL-10; document deliberate GPS instance/port swap
    New FC parameter export replaces the archived backup. Cross-checked by
    diff; two changes were flagged and confirmed with Julian before being
    documented as intentional.
    CTL-06 closed: V-tail yaw effectiveness restored +-0.85 -> +-0.50 (PX4
    default); PWM endpoints for MAIN 1/2/3/5 confirmed independently
    remeasured as actual safe mechanical limits, superseding the previous
    endpoint-based approximation of aileron differential; aileron trims
    rechecked and updated post-recalibration. No software differential in
    the baseline.
    CTL-10 closed: airspeed envelope updated per Weishaupl et al. 2024 -
    FW_AIRSPD_STALL/MIN/TRIM/MAX to 11/15/2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
    [believer-parameters.params]
2026-09-02 Close NAV-05 (GPS lock confirmed); reopen CTL-08 at Julian's request
    NAV-05: both GPS receivers confirmed achieving a lock under the new
    instance configuration. Recorded the actual rationale for the GPS
    instance swap - QGroundControl's primary GPS status display reads
    driver instance 1 via GPS_RAW_INT, so putting the RTK-capable ZED-F9P
    there ensures the GUI reflects the better receiver instead of
    under-reporting the M8N's lesser fix.
    CTL-08: the 2026-09-01 closure relied on a qualitative bench comparison,
    not the formal logged test (props off, roll/pitch/yaw tested
    separately, stick%/PWM/deflection recorded per axis) its acceptance
    criteria call for. Julian wants that test actually run rat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
2026-09-02 CTL-04 tri-rate: verify radio backup, correct CH9/CH11 dual-purpose framing
    Diffing the new radio backup against the archive showed CH9/CH11's
    mixData routing is unchanged - SB/SE are dual-purpose (still drive
    Flaperon/Offboard as before, now also select rate curves locally),
    not reassigned as an initial verbal description had suggested.
    Corrected across manual.md, ICD.md, flight-modes.md, build-checklist.md,
    project-notes.md, and open-items.md before anything was pushed, and
    flagged the resulting RC_MAP_OFFB_SW overlap as an unresolved risk.
    Moved the verified backup into docs/operations/GX12 Radio Backup/ and
    added a CTL-04 acceptance criterion to review rates/expo with Ross
    Dennington.
    C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
    [model00.yml, radio.yml]
2026-09-02 Elevate AF-06 to critical, add PROP-08 motor overcurrent fix, track RC_MAP cleanup
    AF-06 (control surface hinges) is now a flight-clearance blocker per
    Julian. Added PROP-08: the 2026-08-31 overcurrent finding (~30-32.5A/
    motor vs the MN3110 KV700's 21A continuous rating) needs an actual
    configuration fix, not just further measurement. Also logged that
    Julian has started clearing RC_MAP_OFFB_SW/RC_MAP_FLAPS from CH9/CH11
    to resolve the SB/SE dual-purpose overlap - pending a fresh parameter
    export to verify before documenting as done.
2026-09-02 Elevate CTL-04 to critical flight-clearance blocker
    Julian: CTL-04 (tri-rate switch-selectable deflection) now blocks the
    maiden flight. Flagged that it still formally depends on CTL-08,
    which remains Priority: URGENT, not Critical - left for Julian to
    reconcile rather than silently bumping CTL-08 as well.
2026-09-02 Investigate thrust-test motor cutouts: false landing-detect, not brownout
    Two full-throttle motor cutouts during the 2026-09-02 bench thrust
    test with Ross Dennington were traced directly in the flight
    controller's .ulg logs. Both are explained by PX4's fixed-wing landing
    detector falsely declaring "landed" on the stationary bench and
    auto-disarming via COM_DISARM_LAND - confirmed by nominal battery/5V
    rail voltage and a continuous boot clock through both events, ruling
    out a brownout. Added PROP-09 to resolve the interference before
    further sustained full-throttle bench testing. A separate, unrelated
    reboot found in the same investigation is logged as unexplained.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
2026-09-02 Remove PROP-09; flag COM_DISARM_LAND fix for future bench tests instead
    Per Julian - the landing-detector auto-disarm interference doesn't
    need a dedicated checklist task, just a lighter open-item flag: raise
    or disable COM_DISARM_LAND for bench testing, then confirm it's
    restored before flight clearance.
2026-09-02 Log PWM-vs-current data point for PROP-08 (~1800us at ~42A total)
    Correlated actuator_outputs against battery current in the 2026-09-02
    thrust-test logs: ~42A total draw (~21A/motor, the MN3110 KV700's
    rated continuous current) occurs at ~1800-1809us PWM. Candidate
    throttle-ceiling starting point for PROP-08, not yet confirmed via a
    dedicated sustained-run test.
2026-09-02 Verify RC_MAP cleared and PROP-08 PWM ceiling via fresh param export
    Diffed Julian's fresh parameter export against the archive: confirms
    RC_MAP_FLAPS and RC_MAP_OFFB_SW are both cleared to 0, resolving the
    SB/SE dual-purpose overlap (CTL-04); and PWM_MAIN_MAX4/MAX6 lowered
    to 1800, applying PROP-08's throttle-ceiling finding. PROP-08 moved
    to For review pending a sustained-run confirmation test.
    [believer-parameters.params]
2026-09-02 Close PROP-02/PROP-06 on Ross Dennington's review; split PROP-10
    Ross reviewed throttle mapping (found appropriate) and static thrust
    (qualitative "felt the thrust" assessment) during today's bench
    session. PROP-06 closed on that basis. PROP-02 closed per Julian's
    explicit instruction to reduce its acceptance criteria - the original
    measured thrust-to-weight ratio and sustained-run check were not
    done; recorded precisely which evidence it was actually closed on,
    consistent with the CTL-08 evidence-bar lesson. The deferred
    quantitative motor-rig measurement is tracked separately as PROP-10
    rather than lost.
    CTL-04 is not closed in this commit - flagged instead, since two of
    its acceptance cr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
2026-09-02 Log further Ross Dennington review notes: CG/weight, mounts, Acro rates
    Ross flagged that adding ballast for CG (AF-01) works against an
    already-marginal thrust margin relative to the 5.5kg MTOW - recorded
    as a consideration, not a decision. He also gave a reassuring second
    opinion on the motor-mount wobble (AF-08, no pull-out risk). Closed
    CTL-04's Ross-review acceptance criterion, but surfaced a new finding
    in its place: tri-rate doesn't appear to work correctly in Acro mode,
    possibly related to the same closed-loop saturation CTL-08 found.
    Launch mechanism (hill/catapult vs. hand launch) discussed; hand
    launch remains the maiden-flight plan, no document changes needed.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
2026-09-02 Rename and expand Ross Dennington review test report
    Renamed 2026-09-02-ross-dennington-throttle-thrust-review.md to
    2026-09-02-ross-dennington-review.md and expanded it to cover the
    full review session (CG/weight, motor mounts, tri-rates/Acro finding,
    launch mechanism) rather than just throttle/thrust. Updated the two
    stale filename references.
2026-09-02 Consolidate the two 2026-09-02 test reports into one
    Merged 2026-09-02-thrust-test-motor-cutout-investigation.md and
    2026-09-02-ross-dennington-review.md into
    2026-09-02-bench-thrust-test-review.md, since both covered the same
    session. Updated the live references in project-notes.md and
    open-items.md.
2026-09-26 Close 2026-09-02 reboot open item; note COM_DISARM_LAND set to -1
    Julian judged the unexplained reboot a non-recurring one-off. Recorded
    as closed on that judgment (cause undetermined; the boot clock shows it
    was distinct from the landing disarms) rather than as explained. Also
    logged that COM_DISARM_LAND was reportedly set to -1 for bench testing,
    pending a parameter export to verify, with the restore-before-flight
    requirement kept.
2026-09-26 Close AF-01/02/06/08; log custom Li-ion battery and MN3110 thrust stand data
    Closed AF-01 (CG fixed by the custom 6S4P Li-ion pack, no ballast),
    AF-02 (strap plus velcro), AF-06 (hinges reinforced with cloth tape, not
    replaced as scoped) and AF-08 (adjusted printed motor boards plus blue
    Loctite, no glue needed), each recorded with the method actually used.
    Added a thrust-stand test report for the MN3110 KV700 with APC 11x7 and
    12x6 propellers, recomputed from Julian's raw CSVs; graphs moved to
    docs/assets. Recommended ~1700us ceiling for the 12x6 (~19A/motor,
    ~1.7 kgf). PROP-10 moved to For review; PROP-08 updated.
    Opened items for the battery (capacity test, PX4 LiPo-style battery
    params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
2026-09-26 Correct thrust stand report supply voltages; add per-run table
    The report quoted a resting voltage as a loaded one. Replaced it with a
    per-run table of resting and loaded voltages and quantified the 11x7 vs
    12x6 voltage difference (about 0.3-0.7V, roughly half of the current gap
    by a first-order estimate). Marked the supply source as TBD.
2026-09-26 Record custom Li-ion battery: no BMS, cell resistances, cell datasheet
    Julian confirmed the pack has no BMS and supplied per-group internal
    resistances (charger photo, matching his figures): 21.0 mOhm total, with
    group 2 at 4.6 mOhm about 40% above the rest. The charger also shows a
    4.10 V per cell charge target. Added a battery test report, the Panasonic
    NCR20700A cell datasheet, and the charger photo.
    Open items now cover the group 2 outlier, the undecided in-flight
    voltage limit for a pack with no BMS, and the PX4 battery parameters
    (BAT1_R_INTERNAL is per cell). ICD bumped to Rev 2.7.
2026-09-26 Record 3.8 kg all-up weight and proposed parameter changes
    Julian weighed the aircraft (3.8 kg, about 69% of MTOW; static thrust to
    weight about 0.89) and noted his charger caps Li-ion at 4.15 V per cell.
    Parameter recommendations are recorded as proposals only, none applied.
    Found and corrected a documentation inaccuracy: COM_LOW_BAT_ACT is 0
    (Warning), so the battery thresholds only warn, although the checklist
    and parameter log described a configured battery failsafe. Added the row
    to flight-modes (Rev 1.9) and the parameter log. Confirmed the
    WEIGHT_BASE/WEIGHT_GROSS behaviour against PX4 docs (CTL-09) and
    reframed COM_DISARM_LAND as an open decision given the hand launch.
    Co-Authored-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
2026-09-26 Keep COM_DISARM_LAND at -1 for maiden; add landing steps to checklist
    Per Julian, auto-disarm on landing stays disabled for the maiden flight.
    Pre-flight step 16 now checks the value and a new Landing and shutdown
    section requires a manual disarm after landing. Steps were appended
    without renumbering existing ones.
    Withdrew the BAT1_V_CHARGED 4.05 -> 4.10 proposal (4.05 is the PX4
    default and its recommended Li-ion value) and recorded that
    BAT1_R_INTERNAL should stay at -1, with the condition for revisiting it.
    Corrected a parameter-log note that wrongly listed V_CHARGED as a
    LiPo-style default.
2026-09-26 Record left motor failure during bench simulated flight; add PROP-11
    Stitched the 2026-09-26 flight controller logs (one continuous boot)
    and analysed the bench simulated flight in which the left motor burned
    out. Total current stayed within the two-motor equivalent of the 21 A
    rating for all but about 6 s (rolling 180 s RMS about 14 A per motor if
    shared equally), so a sustained overcurrent is not supported. The end of
    the run shows a fault signature: current rising at a fixed 1800 us
    command, a single 102.9 A sample, then 2 to 6 times the expected current
    when driven.
    Added a test report with two figures, PROP-11 (replace the motor and
    verify the drive, including the ESC; replacement choi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
2026-09-26 Add flight mode, stick and vibration evidence to motor failure report
    Checked further signals from the 2026-09-26 main log: Acro mode
    throughout (throttle is the stick directly), stick held at 100% for
    about 5 s and pulled back at 516.6 s with the 102.9 A sample logged
    after the chop began, no vibration growth, steady 5 V rail, no
    failsafes. Added a section separating what the evidence supports,
    what it is consistent with, and what is unknown. Corrected an
    assumption in the report (aircraft restrained; propeller model).
2026-09-26 State the rating margin plainly in the motor failure report
    Full stick at the 1800 us ceiling put each motor at its rated maximum
    and briefly above it (up to about 113%) for about 6 s; the 1800 us
    ceiling itself left no margin and would allow roughly 26 A per motor on
    a full pack with the 12x6. Overload alone does not explain the failure,
    but the report now says the margin plainly.
2026-09-26 Add ESC over-load protection and thermal checks to motor failure report
    The AIR 40A manual documents an over-load protection that cuts output
    on a sudden very high load, consistent with the current collapsing
    right after the 102.9 A sample. Noted the unrecorded ESC timing
    setting and added an outstanding item to record the motor housing and
    printed-mount material and to measure motor and ESC temperature.
2026-09-26 Record melted PETG mount, motor and ESC airflow, and mount-material criteria
    Julian reported the failed left motor melted its 3D-printed PETG mount,
    that the motors get airflow in flight but the ESCs largely do not.
    Recorded in the failure report (the melt points at the motor, noting the
    failed drive was powered again in the next log), PROP-11 (mount material
    and ESC temperature acceptance criteria), open items, and notes.
2026-09-26 Record ESC enclosure, re-test and right-hand side; revise failure read
    Julian confirmed 06_16_46 was him checking the motors after the left
    smoked, the right side seems fine, the ESCs are enclosed in the wing
    with no airflow, and the ESC timing is unknown. The enclosed, uncooled
    ESC is now treated as a live candidate alongside a motor winding fault,
    weakening the earlier lean towards the motor. PROP-11 now includes ESC
    choice and cooling. ICD Rev 2.8 records the PETG mounts, cooling and the
    left motor failure, and fixes a stale ESC paragraph.
2026-09-26 Record replacement motor research for the 12x6 on 6S
    Compared the installed MN3110 KV700 against the T-Motor MN3510 KV700/
    KV630, MN3508 KV580 and KDE3510XF-475, with the 3520-class motors ruled
    out on mass. At a fixed propeller the current is set by the propeller,
    so a different motor buys margin, not lower current. Specifications are
    from listings and unverified; no choice adopted.
2026-09-26 Withdraw PETG mount as a cause; record MN3510 KV700 6S as unconfirmed
    Julian stated the PETG mount was not the fault. Withdrew that
    suggestion and turned the mount requirement into a temperature
    measurement. Recorded what T-Motor publishes about 6S: the MN3510 KV700
    is listed 3-4S only with low-pitch propellers and no stated maximum
    voltage, so its suitability must be confirmed with T-Motor before it is
    chosen (open item and conditional PROP-11 criterion).
2026-09-27 Correct motor install date; record lifetime overcurrent tally and winding-current correction
    Julian put the MN3110 install at roughly 2026-07-24. The SD card logs
    bracket it between 2026-07-10 and 2026-07-26 (motor PWM range changed on
    2026-07-26), so the 2026-08-19 date first recorded was the report date.
    Corrected it in the notes, build checklist and purchase history.
    Added the time above 21 A per motor since installation to the failure
    report: about 64.8 s in the aircraft plus 31.7 s on the thrust stand,
    about 96.5 s in total. Recorded that the earlier replacement-motor
    comparison used battery current against the rating and understates
    winding current at part throttle; on an estimated wi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
2026-09-27 Correct thrust-stand dates in the lifetime overcurrent tally
    The 11x7 stand runs were 2026-09-06 and 2026-09-10 (per the stand test
    report), not 2026-09-15; only the 12x6 runs were on 2026-09-15. All 13
    CSV files in the stand folder were already included, so the 31.7 s total
    is unchanged.
2026-09-27 Add motor current histogram since installation
    Time in each 1 A bin of per-motor current from the aircraft logs
    (equal split) and the thrust stand, with the 21 A rating marked and the
    time above 21, 25 and 30 A annotated. Linked from the failure report.
2026-09-27 Regenerate motor current histogram with linear axis and no idle samples
    At Julian's request: linear Y axis, samples below 1 A excluded. The log
    scale had made the tail above 21 A look larger than it is. Tallies are
    unchanged (96.5 s above 21 A per motor, about 4.5% of the roughly
    2,130 s spent at or above 1 A).
2026-09-27 Record thrust stand returned and candidate-motor thrust data search
    Julian has returned the RCbenchmark stand, so further thrust, current
    and temperature characterisation needs a restrained in-aircraft test or
    another stand. Recorded the search for U5 KV400 and KDE3510XF-475 data
    with the 12x6 on 6S (none found), APC's static 12x6E data and its
    mismatch with the stand, and an unverified U5 estimate. No choice
    adopted.
2026-09-27 Record BNEMAC visit conditions and 0.8 thrust-to-weight working target
    Julian stated the ESCs were not configured properly and one propeller
    was mounted backwards at the 2026-07-05 BNEMAC visit, so the U5
    inadequate-thrust finding is unreliable; annotated it and withdrew the
    argument that the U5 is speed-limited on 6S. Recorded his view that
    about 0.8 static thrust-to-weight would be acceptable as a working
    target against PROP-10 (not adopted as the pass/fail number; status
    unchanged) with unverified per-option estimates against it.
2026-09-27 Record planned payload, design mass and cruise speed correction
    Julian's planned payload (Pi 4 with heatsink and fan, IMX335 USB
    camera, DJI O3 Air Unit, added after the maiden flight, with about
    200 g headroom on top) gives a rough design mass of about 4.2 kg against
    3.8 kg for the maiden. Recorded static thrust-to-weight of the MN3110
    with the 12x6 at both masses, that 20 m/s is the manufacturer's
    recommended cruise speed rather than a computed optimum in the
    Weishaeupl paper (best range about 12.7 m/s at 4 kg), and a correction
    to an earlier statement about the 12x6 zero-thrust speed. Added an open
    item to weigh the payload. No motor choice adopted.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
2026-09-27 Record that the 200 g headroom is a comfort margin; add U5 evaluation item
    Julian said the headroom is a comfort margin, not a hard requirement,
    which keeps the U5 KV400 motors (about +150 g for the pair) in play.
    Added an open item to weigh them, check mounts and condition, and run a
    restrained in-aircraft test before adopting. No motor choice adopted.
2026-09-27 Record inconclusive multimeter winding resistance test
    Julian measured 24-25 ohms phase-to-phase on both motors with a
    multimeter, about 260x the 92 mOhm datasheet figure. An ordinary
    two-wire ohmmeter cannot resolve milliohm-level winding resistance, so
    this is a measurement of contact resistance, not the windings. It rules
    out a dead short or open winding on either motor but not winding health
    or a partial short. A four-wire milliohm meter and an insulation
    resistance tester are needed for that.
2026-09-28 Correct U5 cruise-thrust statement; record no milliohm/insulation tester
    Interpolating APC's static and zero-thrust 12x6E points, the U5 KV400
    (speed-limited to about 7,500 to 8,300 rpm under load) has about 2.3 to
    6 times the drag in thrust at 13 to 15 m/s but only about 0.8 to 2.5
    times at 20 m/s, so cruise is comfortable at 15 m/s or below and
    marginal at 20 m/s. This corrects the earlier statement that cruise is
    easy on the motors, which holds for the MN3110. Unverified; the full
    APC table could not be retrieved.
    Also recorded that Julian has no milliohm meter or insulation tester
    and the near-term alternatives.
2026-09-28 Add powertrain performance model calibrated on the stand data
    A steady-state model of battery, ESC, motor, propeller and airframe
    built from APC's PER3 tables, the wind-tunnel drag polar of the
    reference airframe, motor datasheets and listings, and the measured
    pack resistance, calibrated on the RCbenchmark stand data. Scripts, CSV
    results and a figure are added with a write-up.
    Findings (estimates, unverified in flight): the stand propeller behaves
    like the sport or slow-flyer 12x6, not the 12x6E; the MN3110 reaches its
    21 A rated winding current at about 1.33 kgf (static thrust-to-weight
    0.70 at 3.8 kg); the U5 gives about 1.9 kgf at 67% of its rating and 3.1
    times the drag at 20 m/s (1.8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
    [best-speeds.csv, cruise.csv, fullthrottle-curve.csv, sensitivity-summary.csv, static.csv]
2026-09-28 Record that the U5 motor mounts are fixed
    Julian has fixed the mounts for the U5 KV400 motors, so the mount
    check is removed from the U5 evaluation item. Remaining checks are
    weighing a U5, its condition, and the restrained in-aircraft test.
2026-09-28 Record the planned U5 stand test and the data wanted from it
    Julian is borrowing the thrust stand again to bench test the U5 KV400
    with the 12x6. Recorded the data needed to recalibrate the powertrain
    model and extrapolate to flight speeds, and the warning that the U5 at
    full throttle is near the roughly 500 W level where the earlier runs
    cut out.
2026-09-28 Correct the stand RPM finding: the electrical-speed channel is usable
    The stand's Motor Electrical Speed column is usable rotor speed above
    about 1520 us (within about 2% of the speed implied by thrust for the
    11x7, 6 to 9% for the 12x6) and reads spurious values below about
    1500 us; the earlier statement that it did not fit a 14-pole motor was
    wrong (it came from the spurious low-throttle values). The optical
    column is zero. Added a rotor-speed cross-check to the model write-up
    and script, updated the data wanted from the U5 stand test, and
    annotated the earlier wrong statement.
2026-09-28 Recalibrate the powertrain model for the confirmed APC 12x6E propeller
    Julian confirmed from a photo that the stand propeller is the 12x6E.
    The model was recalibrated on the 12x6E tables using the stand's
    rotor-speed channel: thrust factor 0.99, power factor 1.22, bus current
    within 1.4% rms. This supersedes the earlier sport-propeller results.
    Corrected results (estimates, unverified): MN3110 reaches its 21 A
    rating at 1.35 kgf (about 1545 us, thrust-to-weight 0.71); U5 gives 1.80
    kgf static (0.91), 2.5 times the drag at 20 m/s (1.4 times in the worst
    case) and, at 10 m/s, thrust-to-weight 0.73 (0.53 worst case,
    superseding the earlier 0.62); cruise 159 to 165 W at 15 m/s and 266 to
    286 W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
    [best-speeds.csv, cruise.csv, fullthrottle-curve.csv, sensitivity-summary.csv, static.csv]
2026-09-28 File the 12x6 propeller invoice and record that the propeller may not be genuine APC
    Filed the Alibaba invoice for the 12x6 propellers (notice
    B1020260906048362, 2026-09-06, 51.96 CNY, $10.56 AUD as charged, Julian
    personal funds) in the purchase history and updated Julian's personal
    and the all-parties totals. The invoice lists a Gemfan nylon "APC"
    propeller, so the stand propeller may be a copy of the APC 12x6E
    pattern rather than a genuine APC part; recorded in the model
    limitations, the stand report and a new open item to confirm the brand.
2026-09-30 Add U5 KV400 thrust stand characterisation and per-motor model calibration
    Julian bench tested the U5 KV400 with the 12x6E on the re-borrowed
    thrust stand: full-throttle static thrust 1.84 to 1.94 kgf at 14.0 to
    14.7 A (47 to 49% of the 30 A rating), no cutout. Added the test
    report, three figures, and a calibration script (thrust factor 0.98,
    power factor 1.01, bus current within 2.8% rms, rotor speed within 1 to
    4% of the thrust-implied value).
    Extended the powertrain model with a per-motor propeller-scale
    override so the U5's real calibration is used instead of the generic
    one, and regenerated the main figure and results. At 24.0 V: static
    thrust-to-weight 0.95 at 3.95 kg, total in-fligh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
2026-09-30 Record the extended U5 run, ESC identity, and Julian's test plan
    Added a fourth, extended U5 stand run (641 s slow ramp) to the test
    report: confirms the earlier calibration with about 490 full-throttle
    samples and no anomalies. Recorded that all U5 testing so far used the
    right-hand MN3110's ESC, not the suspect left one, and Julian's
    informal report that the units are in good condition and were
    indistinguishable from room temperature to the touch after full
    throttle. Recorded his plan to test the suspect ESC directly next and
    run a temperature-logged sustained test once a thermal camera is
    available.
2026-09-30 Record the suspect ESC sustained-run test and the U5/AIR 40A decision
    Julian ran the U5 KV400 at full throttle for 483 s on the ESC removed
    from the failed left drive, with the throttle briefly cut four times
    for hand-touch temperature checks: 393 s cumulative at full throttle,
    current flat at 15.8 to 16.9 A, no fault, motor only slightly warm each
    time. He has decided to install the U5 KV400 motors with the AIR 40A
    ESCs in the aircraft, resolving PROP-11's motor and ESC choice.
    Added the sustained-run section and figure to the test report, moved
    PROP-11 to In progress with the decision and per-criterion progress
    recorded, and updated project notes and open items. Still open:
    instrumented t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
2026-09-30 Close PROP-11 on Julian's judgement
    Julian: "I think that is about as formal as I want to make it to be
    honest, I dont think there is any reason to suspect the u5 are damaged
    or are at risk of overheating. I am happy to close this one."
    Closed on the thrust-stand characterisation and the 483 s sustained
    full-throttle run on the suspect ESC (both 2026-09-30), rather than the
    task's originally-scoped instrumented temperature log and formal
    electrical condition checks, which he has decided not to pursue.
    Removed the PROP-11 dashboard row and section from the build checklist
    and added a closed summary under Completed Work. Updated open items
    (remaining work is installing the U5 motors and AIR 4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
2026-10-02 Record PROP-08 plan after the U5 swap; not yet closed
    Julian confirmed the U5 KV400 physical swap is done and proposed
    raising PWM_MAIN_MAX4/MAX6 back to 2000 to close PROP-08. Flagged that
    this only holds once the U5s are installed, not the MN3110s, since the
    MN3110 overruns its rating on this propeller at high throttle - the
    same mechanism as the 2026-09-26 failure. Confirmed the parameter has
    not yet been set (pending a parameter export) and that only a quick
    bench spin-up check is planned, not a full sustained in-aircraft run.
    Updated PROP-08 to In progress, recorded the ceiling change as planned
    but not applied, and revised its acceptance criteria to name the
    evidence a closure would r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
2026-10-02 Calculate the mass change for the MN3110-to-U5 motor swap
    From both motors' official T-Motor specifications: +152g for the pair
    excluding cables (80g to 156g each), +192g including the supplied
    600mm leads (99g to 195g each). Recorded a recommended +190g (0.19kg)
    estimate for WEIGHT_BASE/WEIGHT_GROSS pending Julian weighing the
    actual installed pair for an exact figure.
2026-10-02 Confirm PWM ceiling and weight via the first U5 ground test
    Pulled the latest SD card log, the first ground test with the U5 KV400
    motors installed: PWM_MAIN_MAX4/MAX6 = 2000 and WEIGHT_BASE/GROSS = 4.0
    confirmed from the log's embedded parameters. Full-throttle current
    29.4 to 30.9A total (about 15.5A/motor equal split), well under the
    U5's 30A rating and consistent with the thrust-stand data, both motor
    commands identical throughout, no fault or failsafe flag.
    This is the quick spin-up check Julian had planned, so PROP-08's
    agreed acceptance criteria are now met on the basis already settled
    (the 2026-09-30 stand's sustained run plus this quick in-aircraft
    check). Added the test report and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
2026-10-02 Refresh the parameter backup and reopen NAV-05 over the M8N GPS
    Regenerated believer-parameters.params from the 2026-10-02 ground-test
    log's embedded parameter set (same 1214 parameters as the 2026-09-02
    export, no additions or removals). Updated parameter-change-log.md to
    match: added rows for WEIGHT_BASE/WEIGHT_GROSS and COM_DISARM_LAND that
    had never been captured there, corrected a stale BAT1_N_CELLS note,
    rewrote the PWM_MAIN_MAX4/MAX6 history, refreshed the calibration
    tables, and flagged that the magnetometer soft-iron terms suggest an
    unconfirmed recalibration since 2026-09-02. Julian accepted the
    calculated +190g mass estimate without an independent weighing.
    Checked Julian's repor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
    [believer-parameters.params]
2026-10-02 Confirm compass recalibration and M8N; review NAV-06 parameters
    Julian confirmed he recalibrated the compass and other sensors
    (explaining the magnetometer shift) and confirmed the affected GPS is
    the M8N, not a different module. Reviewed every M8N-relevant parameter
    against PX4's documentation: port/protocol assignment, baud, and GNSS
    mask all look consistent with the documented intentional setup and
    unchanged since 2026-09-02. Ruled out GPS_UBX_BAUD2 as a cause - it
    only configures the ZED-F9P's second UART, not the M8N.
    Nothing found suggests a parameter-level misconfiguration; combined
    with the symptom being total silence rather than a degraded fix, this
    points toward a physical, wiring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
2026-10-02 Correct the GPS timeline: the M8N worked before the instance swap
    Julian pushed back on the earlier NAV-06 finding, recalling dual-GPS
    MAVLink messages in the past. A full scan of all 326 logs on the SD
    card (the earlier pass only checked from 2026-08-19 onward) confirmed
    he was right:
    - 2026-06-02 to 2026-07-03: both GPS instances logging. The M8N
    (instance 1) gets real fixes up to 13 satellites.
    - 2026-07-04: GPS_2_CONFIG deliberately disabled pending the ZED-F9P's
    antenna/mount - not a fault, already documented in the changelog
    from that date.
    - 2026-08-19: M8N still alive as instance 1.
    - 2026-08-31 (the swap, recorded as 2026-09-02 but actually a day or
    two earlier per the logs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
2026-10-02 Find a likely cause for the M8N: GPS_2_GNSS inherited the F9P's value
    Julian reported the M8N's LED and buzzer are active, pointing toward
    the UART link rather than a dead module, and asked for its parameters
    from when it worked as GPS1 so he could try reverting them on the GPS2
    slot.
    Comparing 2026-07-03 (confirmed working, as GPS_1_*) against now (as
    GPS_2_*): GPS_CONFIG and GPS_PROTOCOL are identical, but GPS_GNSS was 0
    then against 29 now. 29 turns out to be the ZED-F9P's own old GPS_2_GNSS
    value from before the 2026-08-31 instance swap - it appears to have
    carried over by slot position rather than being chosen for the M8N,
    which ran with GNSS requests effectively off for its entire con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
2026-10-02 Confirm GPS_x_GNSS bitmask meaning against PX4's documentation
    Verified the bit definitions (GPS+QZSS, SBAS, Galileo, BeiDou,
    GLONASS) and that a mask of 0 means PX4 sends no GNSS configuration
    and leaves the receiver on its own default. 29 (the M8N's current,
    suspect value) requests four constellations concurrently - more than
    a basic NEO-M8N typically supports. Replaced the earlier hedged
    "best understanding, not verified" note in NAV-06 and the
    parameter-change-log with this confirmed explanation.
2026-10-02 Confirm NAV-06 fixed and refresh the parameter backup
    Julian set GPS_2_GNSS to 0 and confirmed it fixed the M8N. Verified
    directly against the next SD card logs: the M8N (instance 2) now logs
    a 3D fix with up to 15 satellites, its best ever recorded. Closed
    NAV-06 in the build checklist (moved to Completed Work with the full
    diagnosis) and removed the matching open item. Also fixed an orphaned
    </details> tag left over from an earlier edit in the same section.
    Regenerated believer-parameters.params from the confirmed-fixed log
    and updated parameter-change-log.md's GPS_2_GNSS row and calibration
    tables (routine accelerometer/gyroscope/barometer/magnetometer drift,
    nothing else of note).
    Co-A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
    [believer-parameters.params]
2026-10-02 Add pre-maiden parameter safety review findings (PWR-04, NAV-07)
    Reviewed all 1214 current parameters by safety-relevant category per
    Julian's request. Tracks two recommended changes (low-battery failsafe
    action, horizontal geofence boundary) as new checklist tasks, flags the
    disabled data-link-loss failsafe for Julian's explicit confirmation
    given the dual-link RC architecture, and confirms several suspicious-
    looking circuit-breaker values are PX4 stock defaults rather than
    misconfigurations.
2026-10-02 Decide RC and data-link loss failsafes both return home and hold
    Julian confirmed RC loss and data-link loss should both return the
    aircraft to home and hold position there. Verified against PX4's
    Return Mode documentation that NAV_RCL_ACT=2 with RTL_LAND_DELAY=-1
    already does this for RC loss, and RTL_TYPE=1 resolves to home since
    no rally points or mission landing pattern are defined. Adds RF-06 to
    set NAV_DLL_ACT to match (0 to 2); not yet applied to the physical FC.
2026-10-02 Simplify pre-flight checklist to match the non-contra-rotating setup
    The motor-rotation and propeller-retention-nut checklist steps still
    described the originally-planned contra-rotating configuration. The
    motors and propellers actually spin the same direction - already
    correctly documented in ICD.md and project-notes.md - so simplified
    both steps and the matching Recurring Airworthiness Verification row
    to drop the stale per-side rotation/thread claims and the now-outdated
    rotation-direction diagram link. Also simplified the Manual-mode
    control-surface check per Julian, dropping an overlong justification
    sentence unrelated to the rotation correction.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
2026-10-02 Delete stale contra-rotation motor diagram
    docs/assets/motor-rotation-direction.png depicted the old contra-rotating
    assumption (LHS counterclockwise, RHS clockwise) and was already
    unreferenced after the pre-flight checklist cleanup. Deleted per Julian.
2026-10-02 Expand pre-flight checklist: airworthiness checks and failsafe targets
    Added three physical checks the Recurring Airworthiness Verification
    table already required "before every flight" but the checklist never
    asked: motor/ESC inspection-bay cover retention, nacelle fairing
    retention, and DBR4 antenna orientation/security.
    Added two parameter-confirmation steps stating target values directly,
    matching the existing COM_DISARM_LAND check: COM_LOW_BAT_ACT = 3
    (PWR-04) and NAV_RCL_ACT/NAV_DLL_ACT/RTL_TYPE/RTL_LAND_DELAY =
    2/2/1/-1 (RF-06). Both targets are not yet applied to the physical FC.
    Checklist grows from 42 to 47 steps; updated the renumbered
    cross-references in flight-modes.md and open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
2026-10-02 Tighten pre-flight geofence check to specific parameter values
    Step 24 previously only confirmed the geofence was active with a
    Return breach action. Now confirms GF_ACTION=3, GF_MAX_VER_DIST=120m,
    and that GF_MAX_HOR_DIST is set to a site-appropriate radius rather
    than its current 0 (disabled) - ties the check to NAV-07.
2026-10-02 Add pilot briefing, callout, and radio/GCS volume checklist steps
    Adds three pre-flight items per Julian: the pilot must be briefed on
    every switch and gimbal function relevant to the modes planned for
    the flight (referencing the upcoming maiden flight test plan); the
    pilot and handler agree flight-mode and arm/disarm status will be
    called out from both the radio side and QGroundControl; and both the
    GX12's and QGroundControl's audio volumes are confirmed up beforehand.
    Also wires the callout agreement into the actual mode-select, arm, and
    disarm action steps so it's exercised, not just agreed to.
    Checklist grows from 47 to 50 steps. Updated the renumbered
    cross-references in flight-modes.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
2026-10-02 Add initial maiden flight test plan draft
    Adds docs/operations/maiden-flight-test-plan.md (FTP-BELIEVER-001,
    Rev 0.1), sequencing the flight test campaign Julian described: every
    flight is a hand launch; Flight 1 is airworthiness-only (Acro
    launch/land, brief Manual-mode check at altitude); later flights cover
    stall speed/behaviour, climb/thrust sufficiency, glide, Acro,
    Stabilized, Position Hold, and Return to Home.
    Answers the position-hold-radius question: NAV_LOITER_RAD=80m governs
    Position Hold's loiter circle, RTL_LOITER_RAD=80m is the separate
    parameter for Return mode's loiter at home, NAV_MIN_LTR_ALT=-1 is
    PX4's own default.
    Reworded manual.md's launch-mode steps (41, 46) to defer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
2026-10-02 Tighten loiter radii, set minimum loiter altitude, confirm test site
    Julian confirmed the maiden flight test site (BNEMAC field, Fitzgibbon,
    approximately 300 m radius) and proposed tightening NAV_LOITER_RAD/
    RTL_LOITER_RAD from 80 m to 50 m, and setting NAV_MIN_LTR_ALT from -1
    (disabled) to 40 m provisional.
    Checked 50 m against bank-angle/stall-margin limits before agreeing:
    at FW_AIRSPD_TRIM (20 m/s) it needs about 39 degrees of bank, within
    FW_R_LIM (50 degrees), with in-turn stall speed (~12.5 m/s) still well
    under FW_AIRSPD_MIN (15 m/s). Confirmed NAV_MIN_LTR_ALT is measured
    above the home position, not AMSL or AGL, against PX4's own source
    parameter description (navigator_params.yaml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
2026-10-02 Confirm RF-06/PWR-04/NAV-08 applied; add maiden mission and autotune
    Julian confirmed option 1 for NAV-07 (polygon geofence over a numeric
    GF_MAX_HOR_DIST radius), provided a fresh QGroundControl parameter
    export, and uploaded a maiden-flight test mission with that polygon
    fence. Moved both into the repo (believer-parameters.params refreshed;
    new docs/operations/Pixhawk Mission Backup/maiden-mission.plan).
    Diffed the full export (not just expected changes): confirmed RF-06,
    PWR-04, and NAV-08 applied as planned. Found one unplanned change,
    RTL_TYPE (1 to 0), and traced it to the mission having no landing
    pattern - RTL_TYPE=1 would likely cause PX4 to reject it ("landing
    pattern required");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
    [believer-parameters.params]
2026-10-02 Add attitude-limit, adverse-yaw, and post-flight checks to test plan
    Per Julian, three gaps identified while discussing FW_R_LIM:
    - Attitude-limit observation in Phases A/B/G/I - FW_MAN_R_MAX/
    FW_MAN_P_MAX (Stabilized) and FW_R_LIM/FW_P_LIM_MAX/FW_P_LIM_MIN
    (Altitude/Position/Mission/Return/Hold) are all still PX4's untuned
    generic defaults; feeds CTL-02. Also flagged that Acro has no
    attitude ceiling at all, only rate limits.
    - Explicit adverse-yaw observation applying across every phase,
    feeding CTL-07 - previously stated only in build-checklist.md, not
    echoed in the test plan itself.
    - New Section 4 (Post-Flight): disarm confirmation, a battery voltage/
    cell check given the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
2026-10-03 Add cruise sweep phase, screenshot, flight date; reorder auto-tune
    Per Julian:
    - Added a Cruise Efficiency Sweep phase between Climb and Glide: fly
    level at fixed airspeeds, recording airspeed/throttle/current/
    voltage, to measure actual power-vs-airspeed against the powertrain
    model's predicted best-range speed (13.0-13.5 m/s). Points below
    FW_AIRSPD_MIN must be flown in Manual mode since Altitude/Stabilized
    won't command that low.
    - Added a QGroundControl Plan-view screenshot reference in the Mission
    Mode Detail section - the image itself doesn't exist yet, flagged as
    an open item since Claude can't produce it.
    - Confirmed flight date (Sunday 4 October 2026, 7:30am) in Sectio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
2026-10-03 Copy MATLAB analysis files into the repo
    Per Julian: copied believer_performance_model.m and the full Motor
    Testing folder (plotting scripts, raw RCbenchmark CSV logs, result
    PNGs for the MN3110 11x7" and 12x6" runs) from his OneDrive
    MATLAB/QUTAS/Believer folder into docs/engineering/analysis/ - 23
    files, verified byte-for-byte against the source.
    Resolves the "raw data lives outside the repo" caveat that
    open-items.md and the 2026-09-15 thrust-stand test report had both
    carried; updated both to point at the new location. Four of the copied
    PNGs duplicate images already in docs/assets/ from an earlier session
    - left both in place, since they serve different purposes.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
    [1000_1708.csv, 1000_1740.csv, 1000_1787.csv, 1000_combined_continuous.csv, Log_2026-09-15_175037.csv, Log_2026-09-15_175051.csv, Log_2026-09-15_175445.csv, Log_2026-09-15_175557.csv]
2026-10-03 Document RC switch PWM behaviour and tri-rate channel assignment
    Investigated and answered Julian's questions on RC channel PWM
    on/off behaviour and rate-switch assignment, sourced from the
    parameter export, ICD.md, the actual EdgeTX radio backup, and PX4's
    source (getRCSwitchOnOffPosition). Flagged a second, previously
    untracked staleness in gx12-front-switches.png (GR1 mode labels still
    show the pre-2026-08-19 mapping) found while checking the switch
    diagrams - added to the existing open item alongside the already-known
    SB/SE Flaperon/Offboard mislabeling.
2026-10-03 Document confirmed switch physical direction for Arm/Kill
    Found SD (Arm) and SF (Kill) physical up/down direction in the EdgeTX
    radio backup's own switchWarning safe-position check and sound/timer
    triggers: SD up=Disarmed (safe), down=Armed; SF down=Kill inactive
    (safe), up=Kill engaged. Extrapolated the same pattern to SA/SC/SB/SE,
    flagged as probable not confirmed. Added to ICD.md Rev 2.9 alongside
    PX4's actual RC_*_TH=0.75 threshold logic from rc_update.cpp source.
2026-10-10 Confirm SB/SE tri-rate switch directions on the physical radio
    Julian checked SB and SE directly on the GX12: down=100%, middle=70%,
    up=50% for both aileron and elevator rate - exactly matching the
    2026-10-03 extrapolation. Updated ICD.md to show these as confirmed;
    SA (Loiter) and SC (Return) remain unconfirmed.
2026-10-10 Fix the annotated GX12 switch diagrams and confirm SA/SD logic
    Discovered Python/Pillow is actually available via the Bash tool in
    this environment, contrary to every earlier note in this repo saying
    image edits needed to be done manually. Used it to fix both diagrams
    directly rather than flag them again:
    - gx12-front-switches.png: GR1 mode labels (SW2-SW6) corrected to
    Acro/Stabilized/Altitude/Position/Mission, matching ICD.md's table
    (was showing the pre-2026-08-19 mapping).
    - gx12-top-switches.png: SB/SE relabelled from Flaperon/Offboard to
    Aileron rate/Elevator rate, their actual PX4-relevant function since
    RC_MAP_FLAPS/RC_MAP_OFFB_SW were cleared 2026-09-02.
    Measured exact lab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
2026-10-10 Remove auto-tune-abort open item from the test plan
    Per Julian: flight-mode change aborting auto-tune is already the
    documented procedure (Phase D), so there's no actual RC AUX switch
    gap here - it was a non-issue flagged as an open item unnecessarily.
2026-10-11 Add pilot debrief findings and auto-tune validation to maiden flight report; reorganise docs/assets
    Validated the maiden flight's auto-tune result against PX4's own
    system-identification fit quality and a before/after rate-tracking
    comparison in the real flight - both confirm it's a genuine
    improvement, not just a change from the defaults.
    Added pilot debrief findings (Ross Dennington flew, corrected the
    report's attendee list) checked directly against the log rather than
    taken on faith: a roll-right authority deficit matching the pilot's
    account and consistent with the non-contra-rotating propellers
    (confirmed no mode on this airframe uses differential thrust); a
    Stabilized-mode throttle p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
2026-10-11 Add ground-view launch, go-around, and landing video to maiden flight report
    Confirmed a real go-around in the altitude log (descended to 5.6m AGL
    around t=1443-1445s, climbed back to ~38m AGL, then a second approach
    to landing) - flown entirely in Stabilized mode with no mode change,
    a second data point for the pilot's Stabilized-mode recommendation.
    Also fixes a relative-path bug from the previous commit: the first
    video embed used one "../" instead of the two needed from
    docs/engineering/test-reports/, so it never actually resolved.
2026-10-11 Recover the real replanned mission from dataman, add Nearmap basemap to the mission plot
    The Mission-mode planned-vs-flown plot showed a ~25m average offset
    and a 10m altitude mismatch against the backed-up maiden-mission.plan.
    Julian confirmed the mission was replanned at the field that day, so
    rather than keep plotting known-wrong waypoints, recovered the actual
    uploaded mission from the Pixhawk's own dataman file on the SD card -
    fetched PX4's source for the binary format, computed the exact layout,
    and validated it two ways (computed file size matches the real file
    exactly; every parsed waypoint matches the flight's own live telemetry
    to sub-metre precision) before trusting it. The real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
2026-10-11 Add launch-profile plot, embed videos natively, trim AI-process narration from test report
    Renamed the launch video from .m4v to .mp4 (same standard MP4
    container, just an Apple-style extension) and switched all four video
    embeds from raw <video> tags to GitHub's native markdown image syntax,
    which renders them as proper inline video players instead of being
    stripped by the renderer.
    Added a launch-profile plot (altitude vs. time, coloured by ground
    speed) showing the actual hand-launch sag: the aircraft dropped 3.3m
    below release height 1.6s after release, recovered, sagged a second
    shallower time, then settled into a sustained climb - a concrete,
    measurable confirmation of the "very touch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
2026-10-11 Rule out a cut airspeed line, fix the real cause, add capacity test as a blocker
    Investigated Julian's hypothesis that a cut differential-pressure line
    explained the maiden flight's near-total airspeed-invalid readings.
    The raw sensor data rules it out: recomputed airspeed directly from
    the raw pressure readings is physically sane for the entire flight,
    with none of the near-zero/negative/stuck signature a cut or blocked
    line would produce.
    Traced the real cause against PX4's own source: the validator tripped
    once at t=49.0s (16.4s after takeoff, likely its load-factor check
    during the high-G pull-up recovering from the launch sag) and never
    recovered because ASPD_FS_T_START was at PX4's ow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
2026-10-11 Add stall-speed and glide-slope findings to the maiden flight report
    Measured stall speed (8-10 m/s IAS, three repeated clean breaks in the
    flight's one Manual-mode window) and the final landing's glide slope
    (6.6:1 ground-track / 8.6 deg as flown, ~8:1 estimated still-air) from
    raw sensor data, since the EKF airspeed was invalid for both windows.
    Corrected the stall-break roll-angle characterisation after a mistake
    caught in review: the first pass reported window-wide min/max roll
    (up to 45-54 degrees) rather than roll at the actual break moment,
    which overstated how banked the aircraft was during the stalls
    themselves. Two of three breaks were in fact close to wings-level at
    the break; th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
2026-10-11 Fold in pilot confirmation of no wing drop during the maiden flight stalls
    Julian confirmed directly that no wing drop was observed at any of the
    three stall breaks, including the one that happened in a deepening
    bank - resolves the open caveat about whether that one event's roll
    was a deliberate turning entry or a genuine wing-drop contribution.
2026-10-11 Correct a misattributed pilot confirmation in the stall-break wing-drop finding
    The previous commit stated the pilot had confirmed no wing drop at
    any stall break - that was a misreading on my part of a question as
    a statement. Reworded to state only what the attitude data itself
    shows (no roll-rate signature coincident with any of the three
    breaks), without attributing an opinion to the pilot that wasn't
    actually given.
2026-10-12 Move the GCS RFD900 modem parameter backup out of the repo root
    Julian dropped GCS_RFD900_params.ini (the ground-side RFD900x modem's
    AT-command settings) in the repo root. Moved it into a new
    docs/operations/GCS RFD900 Modem Backup/ folder, matching the existing
    Pixhawk Parameter/Mission Backup and GX12 Radio Backup folders, and
    cross-referenced it from the ICD's INT-04 section.
2026-10-12 Fix powertrain model image path for the docs/assets/ reorg
    Missed from the earlier asset-reorg commit (deliberately excluded
    there since it already had a pre-existing local change at the time);
    updates the figure reference to assets/test-plots/.
2026-10-12 Flesh out README.md's opening section with the airframe summary and project contact, mirroring startup-prompt.md
    Per Julian - now that the README is the human-facing equivalent of
    context/startup-prompt.md's "What this project is" section, it should
    carry the same level of grounding: the V-tail/twin-motor/PX4/Pixhawk 6X
    airframe summary, telemetry/RC link, the planned object-detection
    phase, and the project lead/contact line, instead of one dense
    sentence pointing out to project-overview.md.
2026-10-12 Match README.md's repo-description wording to CONTRIBUTING.md
    Per Julian - both files describe the repo's contents, and should say
    it the same way. README.md now ends its opening section with the same
    "systems engineering documentation, configuration files, user manuals,
    and governance documentation for developing and maintaining a
    fixed-wing UAV system" line already used in CONTRIBUTING.md.
2026-10-12 Trim unnecessary attribution-to-Julian narration out of build-checklist.md, the maiden flight test plan, and ICD.md
    Per Julian's review - most "Julian" mentions across the repo are
    legitimate (contact info, test-session participant records, purchase
    funder, the narrative parameter-change log, revision-history tables)
    and were left alone. But build-checklist.md, the maiden flight test
    plan, and ICD.md's main body had accumulated "per Julian"/"Julian
    decided/confirmed/advised" provenance narration that these clean
    current-state docs don't need per the style guide, and which also
    feeds the misattribution risk CONTRIBUTING.md now warns contributors
    about. Removed 38 such mentions (32 + 4 + 2) wh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
2026-10-12 Create docs/operations/Pixhawk Flight Log Backup/, ready for the maiden flight's raw log
    Per Julian - no flight or bench-test .ulg log has ever been backed up
    in the repo, unlike the parameter and radio backups. Every finding in
    the test reports traces back to a log that only ever existed on the
    physical SD card, a single point of failure. Added a README noting
    the naming convention and the pending maiden-flight log (23_02_07.ulg),
    and the new folder to context/directives.md's file-organisation map.
2026-10-12 Update launch-dolly-requirements.md with the maiden flight's measured stall speed, narrowing the target release speed
    Julian asked what rotate/separation speed to design the launch dolly
    for. Section 3b was still carrying pre-flight, stale PX4 parameter
    estimates from before CTL-10's update. Replaced them with the current
    parameters and the maiden flight's own measured stall speed (8-10 m/s
    IAS across three deliberate stall breaks at the aircraft's actual
    4.0kg flying weight) - a real measured floor rather than an estimate.
    Narrowed the Section 6 release-speed open item to a target range
    (roughly 11-13 m/s) pending the dolly's release angle of attack,
    which still isn't designed and is what p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
2026-10-12 Decide the launch dolly's retention mechanism: a tail-rising trolley with the cradle 30mm forward of CG
    Per the design discussion with Julian - settled on a sailplane/
    motorglider-style trolley (single forward cradle the fuselage pitches
    freely about, plus a separate tail support) rather than a rigid
    fixed-angle cradle, resolving part of Section 5's open mechanism
    choice. Positioned the cradle 30mm forward of the CG. Derived a ~5-6
    degree target separation AoA from the Weishaupl et al. 2024 lift-curve
    data, and distinguished it from the dolly's static resting angle
    (doesn't need precision, since the tail-rise reaches the real flying
    AoA dynamically - only the separation AoA governs liftoff s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
2026-10-12 Fix ICD.md: it still described the failed MN3110 KV700 as fitted, including an actively wrong contra-rotation claim
    The motor swap after the MN3110's 2026-09-26 failure (PROP-11,
    reinstalling the original U5 KV400) was never propagated into
    ICD.md - INT-02d/f, the Connected Devices table, and the full motor
    spec block all still named the MN3110. Updated to the U5's actual
    specs (KV400, 30A rating, 12x6E propeller) and the PWM Max endpoints
    (1800 was the MN3110-era ceiling; live value is 2000, confirmed from
    the maiden flight's own embedded parameters).
    Also corrected a claim that was actively wrong, not just stale: the
    propeller-rotation row stated contra-rotation was "confirmed not
    require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
2026-10-12 Record the FW_AIRSPD_STALL decision and its reasoning in open-items.md
    Per Julian - leaving FW_AIRSPD_STALL at 11 m/s for now rather than
    updating it to the maiden flight's measured 8.15-9.95 m/s, since three
    trials at 1Hz sampling is thin data to retune a parameter other logic
    (loiter radius, bank-angle margins) is built around. Noted the
    decision isn't simply "more margin is safer" either way: the parameter
    also feeds the airspeed validator's check_load_factor() check, the
    same one implicated in the maiden flight's validator trip, so an
    inflated stall figure could make nuisance trips more likely, not less.
2026-10-12 Remove the PDB mount/connector issue as a maiden-flight finding; record its real root cause in PWR-05
    Per Julian - the PDB mount/connector problem was already known before
    the maiden flight, not something post-flight inspection revealed (the
    right motor bearing genuinely was, and stays). Removed it from the
    test report's summary, Post-Flight Inspection Findings, Shown/Not
    Shown, and Outstanding sections.
    Updated build-checklist.md PWR-05 with the actual root cause in place
    of "not yet investigated": an XT90 connector (PDB, battery side, or
    both) was soldered without the opposite-gendered mating connector
    plugged in, letting soldering heat soften and deform the housing
    plastic. Fix is to res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
2026-10-12 Reword build-checklist.md's flight-readiness banner now that the maiden flight is complete
    Per Julian - the page was still framed as if the maiden flight hadn't
    happened, most visibly the "NOT CLEARED FOR FLIGHT" banner. Updated
    to "NOT CLEARED FOR THE NEXT FLIGHT" with a note that the aircraft has
    already flown once (2026-10-11, no crash or structural incident).
    Also reworded PWR-03 and RF-05's background notes, which both said
    "does not block the maiden flight" as a forward-looking prediction -
    now that it's happened, reframed as non-critical with the maiden
    flight itself as supporting evidence.
2026-10-12 Repo restructure (phase 1): merge project-overview into README, merge roadmap+timeline, merge flight-modes into manual
    First phase of a repo-wide restructure. Three content merges:
    - docs/project/project-overview.md -> README.md (QUTAS educational
    purpose, Charlotte Kelly's role added; file deleted)
    - docs/project/project-roadmap.md + docs/project/project-timeline.md
    -> docs/governance/timeline-and-roadmap.md, refreshing the latter's
    stale pre-maiden-flight "Current Status"/Phase 1 content along the
    way
    - docs/engineering/flight-modes.md -> docs/operations/manual.md
    (new Sections 4-6, 9), since the two covered overlapping ground -
    pilot quick-reference vs. PX4 configuration deta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
2026-10-12 Close PROP-08: moot after return to U5 KV400 motors
2026-10-15 Add GPS speed vs raw-sensor airspeed cross-check to the maiden flight test report
    Per Julian - cross-validated the raw differential-pressure-derived
    airspeed against GPS speed (3D groundspeed magnitude) for the full
    maiden flight. GPS speed runs systematically above airspeed, mean
    +4.53 m/s - confirmed as wind rather than a sensor fault by checking
    against PX4's own independent wind estimate (airspeed_wind, actively
    updating throughout, mean 3.88 m/s, same ballpark). Heading showed
    sustained circular flight for most of the flight, favourable for the
    EKF's wind observability. Confirmed from the log's own commander
    messages that the near-zero stretch at the start is the handler
    holding the air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
2026-10-15 Add the EKF's in-flight-averaged wind vector to the mission-mode plot
    Per Julian - annotated the mission-mode planned-vs-actual plot with
    PX4's wind estimate (2.96 m/s from 066 deg T), vector-averaged over
    the in-flight period only.
    Checked the hypothesis that the estimate gets more accurate as the
    flight progresses against the EKF's own variance fields rather than
    assuming it: doesn't hold up cleanly, variance doesn't converge much
    over the flight and the per-sample direction swings over 100 degrees
    across different portions of it. Used a proper vector average
    (component-wise) instead of averaging the end of the flight alone.
    Also corrected the averaging window per Julian's catch: ground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
2026-10-16 Redesign the mission-mode plot's wind arrow, waypoint contrast, and flown-track colouring
    Replaced the wind-vector glyph with a chevron arrowhead sized to fit fully
    inside the photo and pointing downwind; gave the planned-mission line and
    waypoint markers a white halo plus an orange colour so they read clearly
    against the green field and don't compete with the flown track's new
    altitude-AGL colour encoding, which now has a colorbar legend on the right.
    Rebuilt the on-image legend as a measured grid so nothing renders outside
    its bordered box or hides behind it.
2026-10-16 Shrink the mission-mode plot's legend and add an altitude-vs-time plot
    Reduced the legend box's row spacing/padding, which was looser than it
    needed to be, and tightened the bottom crop margin that had been sized
    around the larger version. Added a new standalone altitude-AGL-vs-time
    plot for the same Mission-mode window, with the planned 50m AGL altitude
    and the same engaged/exited markers as the map plot for cross-reference.
2026-10-16 Link the altitude-vs-time plot into the maiden flight test report
    Added it to the Mission mode section with a short paragraph describing
    the transit-then-settle shape it shows. Also fixed the existing map
    plot's description there, which still said "flown track (green)" and
    "real mission (blue)" - stale since the colour rework landed those as
    altitude-AGL-coloured and orange respectively.
2026-10-16 Add waypoint-acceptance markers to the altitude plot; fix two stale claims in the test report
    Added dashed vertical lines/labels to the Mission-mode altitude-vs-time
    plot marking when each mission item was accepted, per Julian.
    Also fixed, both per Julian's catch: the NAV_DLL_ACT paragraph read as
    an unexpected revert when it was actually a deliberate pre-flight change
    to prevent an RTL if the GCS laptop died; and several "GPS used instead
    of airspeed" sentences blurred the invalid validated topic with the raw
    differential-pressure sensor, which was confirmed healthy and used
    directly elsewhere in the report.
2026-10-16 Fix waypoint-acceptance timing on the altitude plot
    navigator_mission_item's timestamp for sequence_current becoming N marks
    when N becomes the active target, not when it was reached - using that
    timestamp directly placed waypoint labels before the aircraft had
    actually flown there (caught against the shape of the altitude trace:
    WP2's line was mid-descent instead of where the descent flattens out).
    Fixed by labelling each waypoint with the next row's timestamp instead,
    and corrected the test report's leg-timing description to match (the
    long leg is WP9->WP10, not WP10->WP11 as first written).
2026-10-16 File the recovered GCS tlog and use it to extend the dropout investigation
    Added docs/operations/backups/GCS Telemetry Log Backup/ for QGroundControl's
    own .tlog session logs, filing in the maiden flight's recovered log (found
    already saved in the repo root).
    Parsed it with pymavlink to answer the one question the aircraft's own SD
    card log couldn't: whether the aircraft-to-ground direction survived the
    three long GCS dropouts. It didn't fail the same way each time - the 39.8s
    and 27.9s outages were uplink-only (downlink continuous throughout, checked
    across four independent message types), while the 17.0s outage was
    symmetric (both directions down together, for longer than the aircraft's
    o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
2026-10-18 Replace the maiden flight report's Battery section with a fuller power-consumption writeup
    Added a current-draw-vs-time plot (shaded by flight mode) and used it to
    replace the old single-paragraph Battery section with Ah/Wh totals
    (cross-validated two ways), mean/peak power and current, and a per-mode
    breakdown table showing Auto Mission and Position Hold drawing roughly
    half the current of the pilot-flown modes. Points to the existing PWR-06
    build-checklist item for the still-open battery-capacity question rather
    than duplicating it.
2026-10-18 Expand the maiden flight report's Speed section with per-mode and 3D analysis
    Added a per-flight-mode ground-speed table with a grouped bar chart, and
    a new 3D speed discussion with its own 2D-vs-3D time series shaded by
    flight mode. Aggregate 2D/3D differences are small everywhere, but the
    largest single gap (11.0 m/s at t=59.2s) is a near-vertical climb inside
    the post-launch Acro window already covered in Climb and Altitude
    Performance - 2D groundspeed alone understates total speed there.
2026-10-18 Drop the 3D speed section and switch the per-mode speed plot to histograms
    The 3D speed discussion only had one moment with a meaningful gap from
    2D, not enough to justify its own section - removed. Replaced the
    grouped bar chart with small-multiples histograms (one panel per flight
    mode, density-normalised, mean marked), which show each mode's actual
    speed distribution rather than three summary statistics.
2026-10-18 Revise speed performance details and formatting
    Updated speed performance section with new data and analysis on ground speed variations across flight modes. Improved clarity and formatting of tables and images.
2026-10-18 Comprehensive editorial revision of the maiden flight test report
    Implemented an external editorial review: tightened prose throughout,
    shortened the Summary, merged three sets of overlapping sections
    (Airspeed System Assessment; Telemetry Link Reliability; Lateral
    Control and Propulsion Effects), replaced "What This Does and Does Not
    Show" with a shorter "Conclusions and Limitations", reorganised
    Outstanding into a prioritised action register, added hedging to
    distinguish observation from interpretation in the airspeed/roll/
    telemetry-failsafe findings, and converted video embeds to links.
    Also fixed several internal inconsistencies the review caught, each
    checked against the log first: an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
2026-10-19 Add a per-mode current-draw histogram to the maiden flight report
    Small-multiples histograms of battery current draw by flight mode,
    matching the Speed section's existing per-mode histogram format
    (density-normalised, mean marked per panel, same per-mode colour
    coding as the existing current-vs-time plot). Regenerated from the
    maiden flight's own log, since no generation script had been kept
    for either prior plot.
2026-10-19 Add a throwaway test clip to probe GitHub's video preview threshold
    Temporary - will be removed once the threshold is confirmed either
    way. Not part of the flight footage set.
2026-11-05 Add dolly concept model and CONOPS update, Believer livery options and stickers
    - docs/engineering/analysis/launch-dolly-concept: parametric dolly model (CadQuery),
    clearance and launch checks, BLV-DOL-001 concept sheet, STEP/STL parts
    - docs/assets/diagrams: MakeFlyEasy Believer three-view, dolly sheet images
    - docs/assets/livery: roundel and identification-number options (A-E, A1-E2),
    mockups on the three-view, and 1:1 print-and-cut sticker files for every option
    - docs/engineering/analysis/launch-dolly-concept/rear-support-fit: aircraft side view
    fitted 1:1 on the Fusion dolly to estimate the tail-support height
    - docs/engineering/requirements/launch-dolly-requirements.md (rev 0.6):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
2026-11-09 Add launch dolly tail-support cradle concept (BLV-DOL-007)
    - tail_cradle.py: TPU-lined V-cradle on an adjustable 32 mm post on the
    rear cross member; rear-view section, cradle section and side views
    - concept STEP/STL of the cradle and TPU liner
    - SRD Section 3c tail-support row, CHANGELOG entry
2026-11-09 Redraw the launch dolly CONOPS image to match the Fusion model
    V-cradle tail support on its centreline post, five-spoke wheels, and no
    outrigger reference in the caption. Font falls back to Segoe UI when
    Inter is not installed.
2026-11-09 Rescale the dolly CONOPS to the Fusion wheelbase and add sideways stability to REQ-DOL-01
    - conops_image.py: 580 mm axle-to-axle and 218 mm wheels from the latest
    Fusion side view; tail post on the rear axle, cradle station unchanged
    - SRD rev 0.7: REQ-DOL-01 covers tipping sideways; rear-wheel row and
    tail-support heights above ground updated; front wheels left as is
